robotter/robotter/docs/measurements/galipeur2k9/readme.txt

# Mesures de Galipeur 2k9 pour le simulateur

# Ligne droite
- goto_xya(500.0,0,0)
- xy_speed(2500,80)
- a_speed(70,10)
- 190 points, environ 2.5s de mesure

données brutes : line_xy.data
vitesse temps réel tracée : line_xy.gif
