robotter/robotter/docs/robotter2k9/garde.tex

\vfill

\hspace{-1.5em}\hrulefill
\begin{center}
	\Large{Rob'Otter 2k9}\\
	\vspace{1cm}
	\textbf{\huge{Galipeur}}\\
\end{center}
\hrulefill

\begin{center}
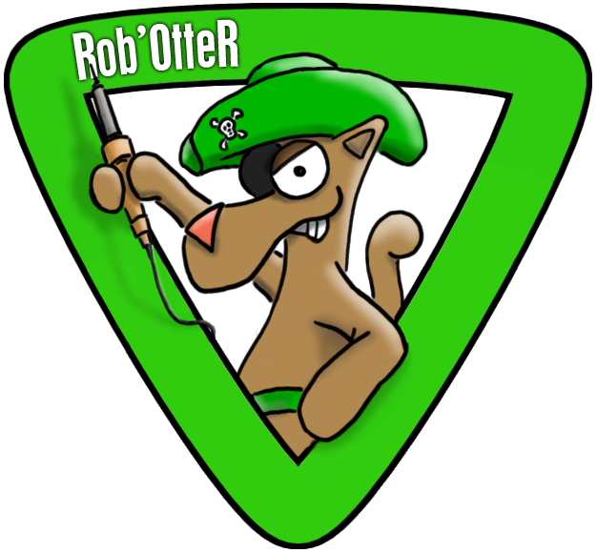
[picture p1: docs/robotter2k9/imgs/beta.png]

\end{center}

\vfill

\thispagestyle{empty}
