robotter/robotter/docs/dossier_projet/dp_2015/content.tex

\mychapter{Questionnaire}

\textbf{Nom équipe :} Rob'Otter \\

\textbf{1} : Autorisez-vous la diffusion de ce projet, avant la compétition, à des
partenaires du concours? \\
\begin{center} OUI \end{center}

\section{L'équipe}

\textbf{2} : Y'a-t-il eu des changements dans la constitution de l'équipe depuis votre
pré-inscription ? (départs, arrivées...)\\
\begin{center} NON \end{center}

\newpage
\section{Planning}

\subsection{Robot principal}

\begin{tabular}{|l|c|c|c|c|c|c|c|c|}

 \hline
 \multicolumn{9}{|c|}{Robot principal}\\
 \hline
 & 10\% & 25\% & 50\% & 75\% & 90\% &  100\% & Fin & Commentaires \\\hline
 \textbf{Méca} / Conception 			& & & & $\surd$ & & & Février & \\\hline
 \textbf{Méca} / Réalisation 		& & & $\surd$ & & & & Mars & \\\hline
 \textbf{Méca} / Test unitaires 	& & & $\surd$ & & & &Avril & \\\hline
 \textbf{Élec} / Conception 			& & & & & & $\surd$ & Février & \\\hline
 \textbf{Élec} / Réalisation 		& & & & &$\surd$ & & Mars & \\\hline
 \textbf{Élec} / Test unitaires 	& & & &$\surd$ & & & Mars & \\\hline
 \textbf{Info} / Conception 			& & & & & $\surd$ & & Mars & \\\hline
 \textbf{Info} / Réalisation 		& & & & & $\surd$& & Avril & \\\hline
 \textbf{Info} / Test unitaires 	& & & & $\surd$ & & & Mai & \\\hline
 Intégration 						& & $\surd$ & & & & & Avril & \\\hline
 Tests finaux						& $\surd$ & & & & & & Mai & \\\hline
 \hline
 \multicolumn{9}{|c|}{Robot secondaire}\\
 \hline
 & 10\% & 25\% & 50\% & 75\% & 90\% &  100\% & Fin & Commentaires \\\hline
 \textbf{Méca} / Conception 			& & & & $\surd$ & & & Février& \\\hline
 \textbf{Méca} / Réalisation 		& & & & $\surd$ & & & Mars& \\\hline
 \textbf{Méca} / Test unitaires 	& & & $\surd$ & & & & Avril & \\\hline
 \textbf{Élec} / Conception 			& & & & & & $\surd$ & Février & \\\hline
 \textbf{Élec} / Réalisation 		& & & & & & $\surd$ & Mars & \\\hline
 \textbf{Élec} / Test unitaires 	& & & & $\surd$ & & & Avril & \\\hline
 \textbf{Info} / Conception 			& & & & $\surd$& & & Mars & \\\hline
 \textbf{Info} / Réalisation 		& & & & & $\surd$ & & Mars & \\\hline
 \textbf{Info} / Test unitaires 	& & & & $\surd$ & & & Mai & \\\hline
 Intégration 						& & $\surd$ & & & & & Avril & \\\hline
 Tests finaux						& $\surd$ & & & & & & Mai & \\\hline

\end{tabular}

\vskip 1cm

\textbf{5} : Date à laquelle le robot se déplacera :\\
\begin{center}
Les deux robots se déplacent déjà de manière autonome.
Les 2 robots possèdent des propulsions holonomes, les asservissements des deux
robots ont été conservés par rapport à l'année dernière.

\end{center}

\textbf{6} : Date à laquelle votre robot sera homologable :\\
\begin{center} Le robot principal a déjà joué un match d'homologation avec
succès \end{center}

\textbf{7} : Matchs d'entraînements :\\
\begin{center} NON \end{center}

\textbf{8} : Suivi de l'équipe par un bénévole :\\
\begin{center} NON \end{center}

\section{Le budget}

\textbf{1} : Budget prévisionnel (hors déplacement)

\begin{center}
Robot principal :
\begin{tabular} {|l|r|}
\hline
mécanique & 200\euro \\\hline
électronique & 150\euro \\\hline
\hline
total & 350\euro \\\hline
\end{tabular}

Robot secondaire :
\begin{tabular} {|l|r|}
\hline
mécanique & 200\euro \\\hline
électronique & 150\euro \\\hline
\hline
total & 350\euro \\\hline
\end{tabular}
\end{center}

\vskip 1cm

\textbf{2} : Buget prévisionnel du voyage :\\
\begin{center} 1000\euro \end{center}

\textbf{3} : Partenaires :\\
\begin{itemize}
	\item Fly-n-Sense
  \item Eirbot
	\item L@Bx
\end{itemize}

\vskip 1cm

\textbf{4} : Matériel à disposition : \\
\begin{itemize}
  \item outillage mécanique basique (personnel + sponsors + partenariat
	Fly-n-Sense + partenariat équipe Eirbot);
  \item outillage électronique : moyen de réalisation PCB, oscilloscope,
  moyens soudage, etc (personnel + sponsors + partenariat Fly-n-Sense + partenariat équipe Eirbot);
  \item table de jeu (partenariat L@Bx et Eirbot).
\end{itemize}

\mychapter{Descriptif du projet}

\section{Description générale}

L'objectif est de réaliser 2 robots, un robot principal et un robot
secondaire.\\

\hspace{1cm}

L'objectif du robot principal est :
\begin{itemize}
	\item abaisser les claps;
	\item empiler les spots et les placer dans les cinémas;
	\item (optionnel) soulever le robot secondaire et le placer sur la zone bonus.
\end{itemize}

Le robot dispose d'un bras escamotable lui permettant d'abaisser facilement les
claps placés sur le bord de la table.

\begin{center}
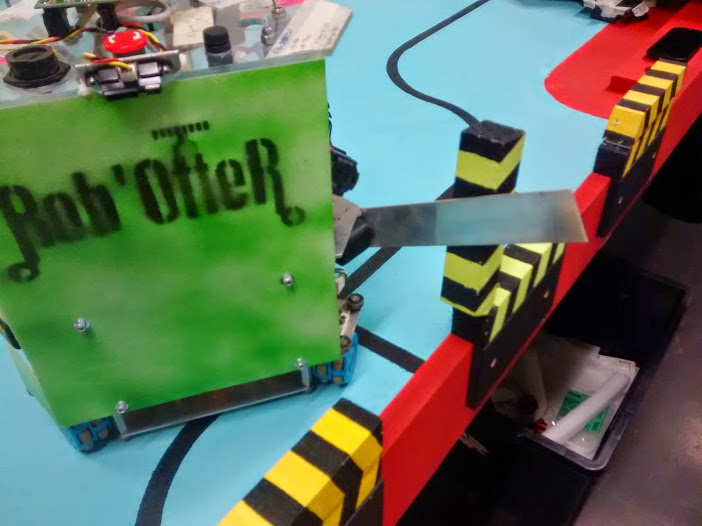
[picture p2: docs/dossier_projet/dp_2015/img/robot_clap.jpg]

\end{center}

Il dispose de pinces situés sur l'une des faces et capables de translater de
haut en bas afin d'empiler les spots.

\begin{center}
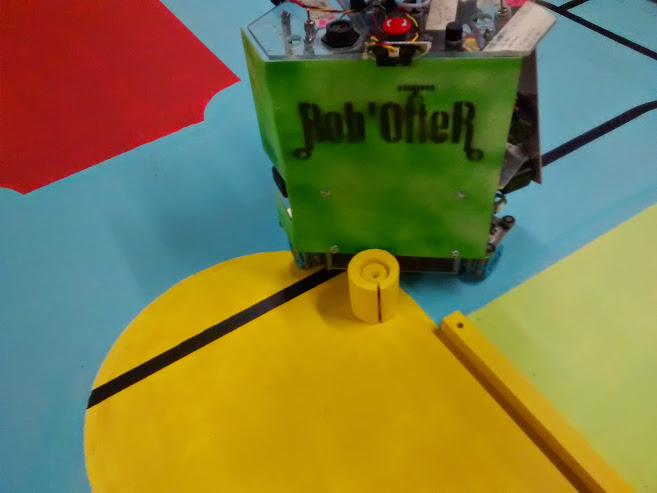
[picture p3: docs/dossier_projet/dp_2015/img/robot_spot.jpg]


(Le système de pinces n'est pas présent sur cette photo)
\end{center}

\begin{center}
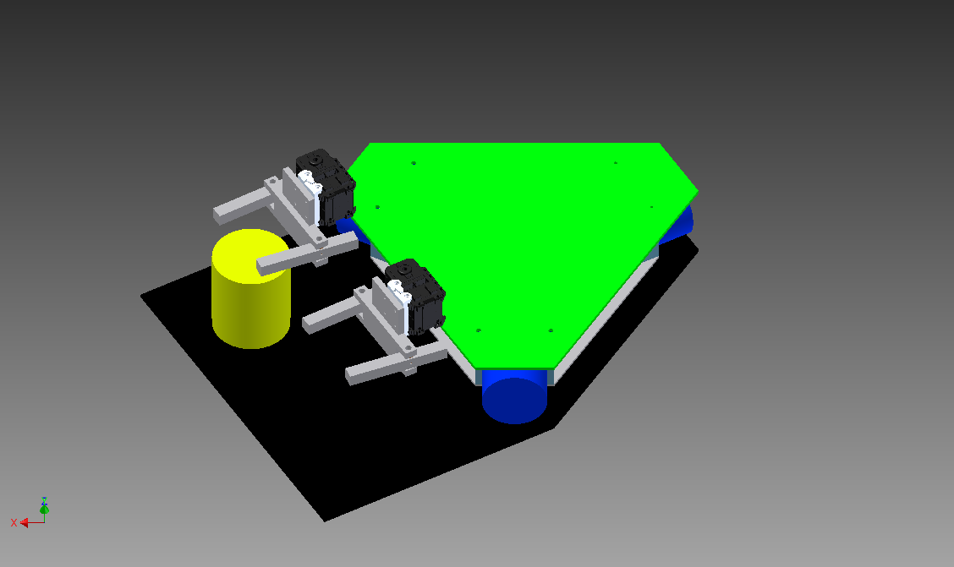
[picture p4: docs/dossier_projet/dp_2015/img/robot_2015_preview.png]


(CAO du système de pinces)
\end{center}

\hspace{1cm}

L'objectif du robot secondaire est :
\begin{itemize}
	\item placer les tapis rouges;
\end{itemize}	

Le robot sera principalement une base roulante portant le système de 
placement des tapis rouges.

\begin{center}
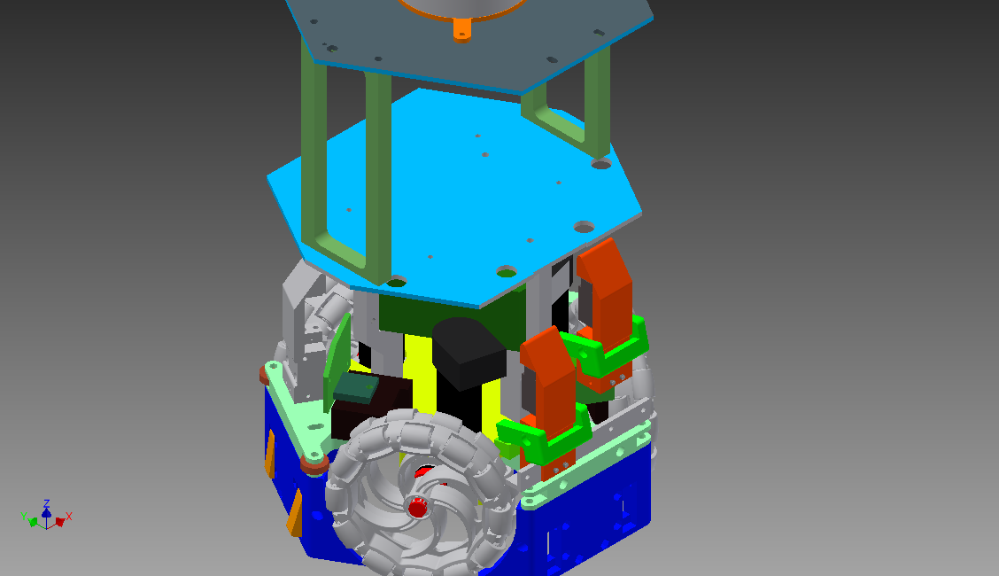
[picture p5: docs/dossier_projet/dp_2015/img/pmi_2015.png]


CAO du robot secondaire
\end{center}

\clearpage
\begin{itemize}
\item Hauteur du robot principal : \textbf{30cm}
\item Périmètre du robot principal en position de départ : \textbf{110cm}
\item Périmètre du robot principal déployé : \textbf{150cm}
\item Couleur du robot principal : structure aluminium (gris/blanc), roues en plastique
bleu clair, plaques de plexiglass transparent pour coque.
\end{itemize}
\vskip 1cm

\begin{itemize}
\item Hauteur du robot secondaire : \textbf{30cm}
\item Périmètre du robot secondaire en position de départ : \textbf{70cm}
\item Périmètre du robot secondaire déployé : \textbf{90cm}
\item Couleur du robot secondaire : structure aluminium (gris/blanc), roues en plastique
bleu clair.
\end{itemize}
\vskip 2cm

Le lien Youtube suivant présente la première homologation du robot lors d'une
phase de prototypage : \\
\url{http://youtu.be/oXdKylXpX2Y}

\section{Description technique}

\subsection{Motorisation}

Le robot principal sera propulsé de manière holonome par 3 motoréducteurs RE25/PLG32. Le
contact sera sol est effectué par 3 omniwheels FXA315 positionnées à 120°.\\

La motorisation fixe la vitesse maximale du robot à 1 m/s environ même si les
contraintes d'asservissement donnent une vitesse de 0.5 m/s plus probable.\\

Le robot principal sera propulsé par 2 motoréducteurs PD3237. Le contact au sol
sera effectué par 2 roues de conception interne à l'aide d'une bande roulement
souple.

\subsection{Positionnement}

Le positionnement est réalisé par les codeurs incrémentaux situés sur chaque
moteur du robot ainsi que d'un gyroscope placé sur l'axe Z (vertical) du robot.\\
Une chaîne de traitement constituée d'un microcontrôleur AVR Xmega 128A1 assure
le traitement des capteurs et le calcul de la position.

\subsection{Asservissement}

Les moteurs sont asservis en vitesse grâce aux codeurs incrémentaux présents sur
le motoréducteur. Le robot est asservi en position par le retour des capteurs
optiques mixé à la mesure du gyroscope.

Les asservissements sont réalisés par des filtres de type PIDf, implémentés dans
le microcontrôleur.

\subsection{Énergie}

Le robot principal est alimenté par une batteries Lithium Polymère 4 éléments 
alimentant sous 15V les moteurs, l'étage puissance du robot et l'étage logique du robot. 
Les 3 batteries assurent une autonomie de fonctionnement d'une bonne 1/2 heure
pour la puissance et presque 4 heures pour la logique (\emph{surdimensionné} est le mot que vous cherchez). \\

Le robot secondaire est alimenté par une batterie LiPo 3S de 1000mAh
l'alimentant sous 13V. La logique et la puissance sont toutes deux alimentées
par cette batterie. Aucune estimation n'a été réalisé de manière précise sur 
l'autonomie de ce robot.\\

Deux jeux complets de batteries sont disponibles pour chaque robot.\\

Un interrupteur arrêt d'urgence coupant le circuit de puissance du robot est
présent sur le haut de ce dernier.

\subsection{Éléments de jeu}

Le robot principal pourra stocker un spot dès le départ du match.

Le robot secondaire ne stockent pas d'éléments de jeux.\\

\subsection{Stratégie}

La stratégie en cours de match pour le robot principal consistera à empiler les
spots et abaisser les claps le plus rapidement possible tout en tenant compte de la
position de l'adversaire.

Le robot secondaire se dirigera vers les marches pour y placer les tapis.

La stratégie actuelle ne prévoit pas de jouer les pop-corns.

\subsection{Système d'évitement}

Chaque robot emporte une balise constituée d'un capteur SICK de type barrière
laser IR et d'un mirroir rotatif permettant de détecter le réflecteur placé sur
les robots adverses et ainsi connaître leur positions (calculés à partir de
l'angle "vu" du réflecteur).

\subsection{Capteurs}

Outre le positionnement, nous disposerons de télémètres IR SHARP GP2* et divers
capteurs de position.\\
Les servomoteurs AX12 utilisés sont "intelligents" et permettent de connaître
diverses informations telles que leurs positions, vitesses, couple instantannés,
etc.\\

\subsection{Arrêt d'urgence et limite de temps}

Un bouton d'arrêt d'urgence placé sur le dessus de la coque du robot permet de couper
l'alimentation puissance du robot, stoppant ses actionneurs.\\

Un système logiciel intégré à l'asservissement du robot le stoppe dès que la limite de jeu
de 90s est atteinte.\\

\subsection{Laser}

Les balises de détection emploient des lasers infrarouge autorisés par le
réglement.

\subsection{Intelligence}

L'intelligence du robot principal est réalisée par :
\begin{itemize}
\item une carte consituéee d'un AVR Xmega chargée de la stratégie et des
communications du robot.
\item une carte constituée d'un AVR Xmega chargée de l'asservissement en position du robot;
\item une carte constituée d'un AVR Xmega chargée du contrôle des servomoteurs AX-12 et autres capteurs du robot.
\end{itemize}

L'intelligence du robot secondaire est réalisée par :
\begin{itemize}
\item une carte consituéee d'un AVR Xmega chargée de la stratégie et des
communications du robot.
\item une carte constituée d'un AVR Xmega chargée de l'asservissement en
position du robot.
\end{itemize}
