robotter/robotter/docs/dossier_projet/dp_2015/garde.tex

\vfill

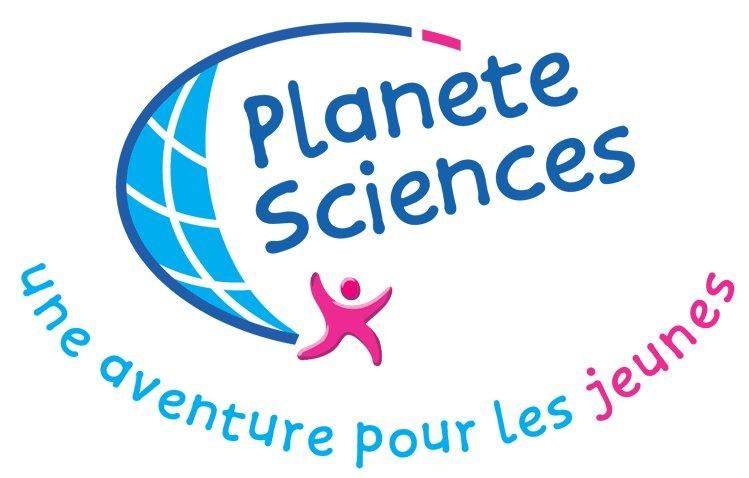
[picture p6: docs/dossier_projet/dp_2015/img/PS.jpg]
 \hfill
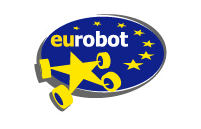
[picture p7: docs/dossier_projet/dp_2015/img/eurobot.png]
 \\

\vfill

\hspace{-1.2em}\hrulefill
\begin{center}
	\Large{Coupe de France de Robotique 2015}\\
	\vspace{1cm}
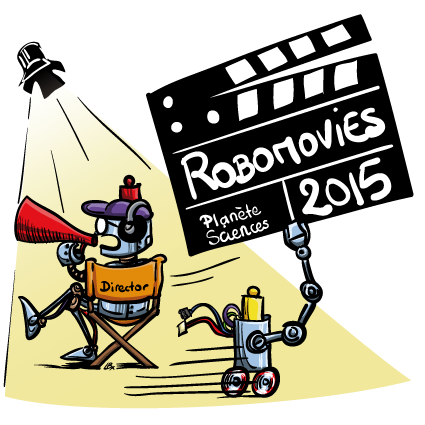
[picture p8: docs/dossier_projet/dp_2015/img/LogoEurobot.png]
	
\end{center}
\hrulefill

\hspace{1cm}
\begin{center}
\huge{Équipe Rob'Otter} \\
\vspace{.5cm}

\end{center}

\vfill

\thispagestyle{empty}
