robotter/robotter/docs/robotter2k9/robotter2k9.pdf

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

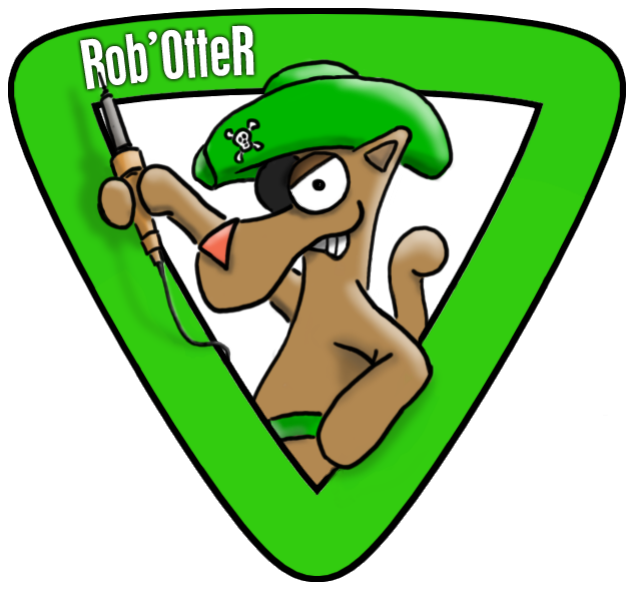
[picture p9: figure]

# Table des matières

1 Asservissement | 3
2 Identication du capteur ADNS | 15

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

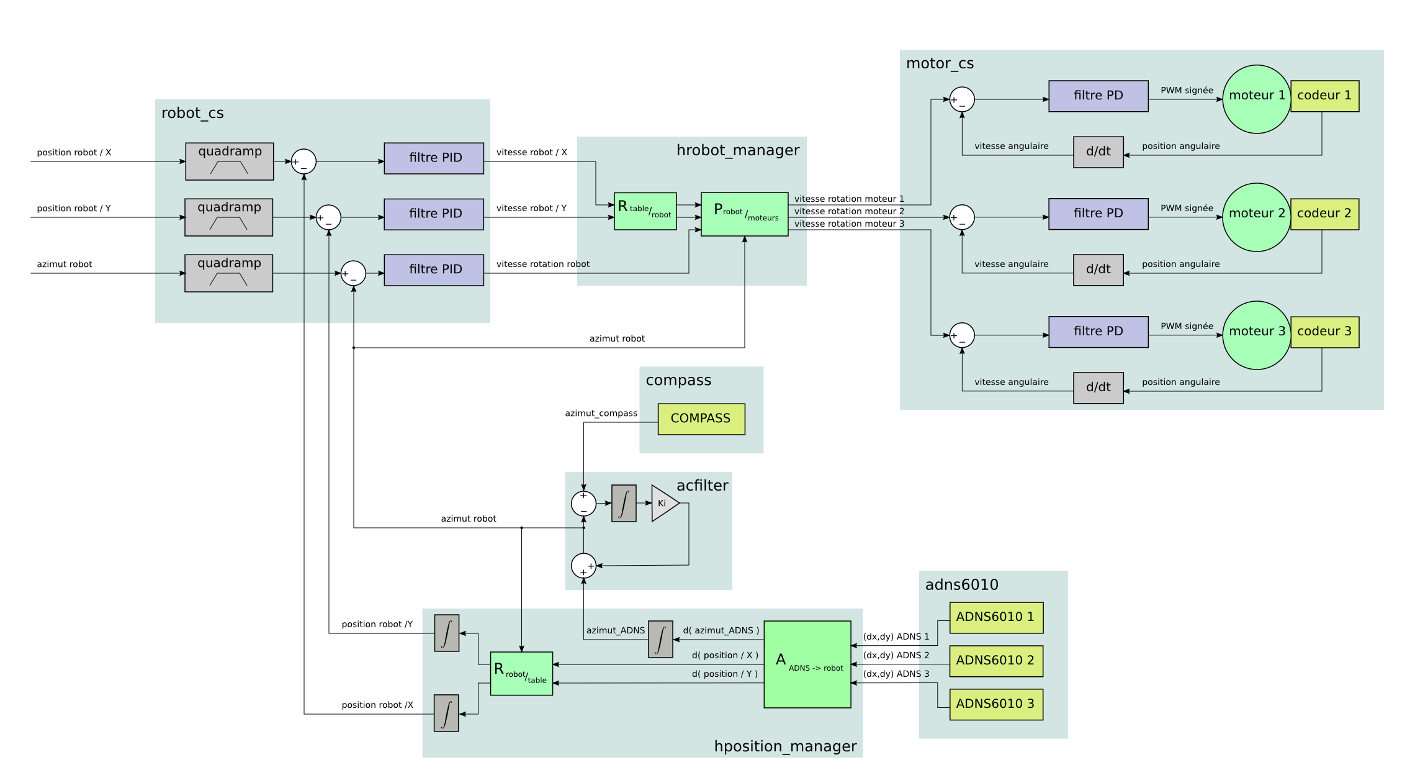
[picture p10: figure]

I Asservissement

1.1 Asservissement en vitesse des moteurs

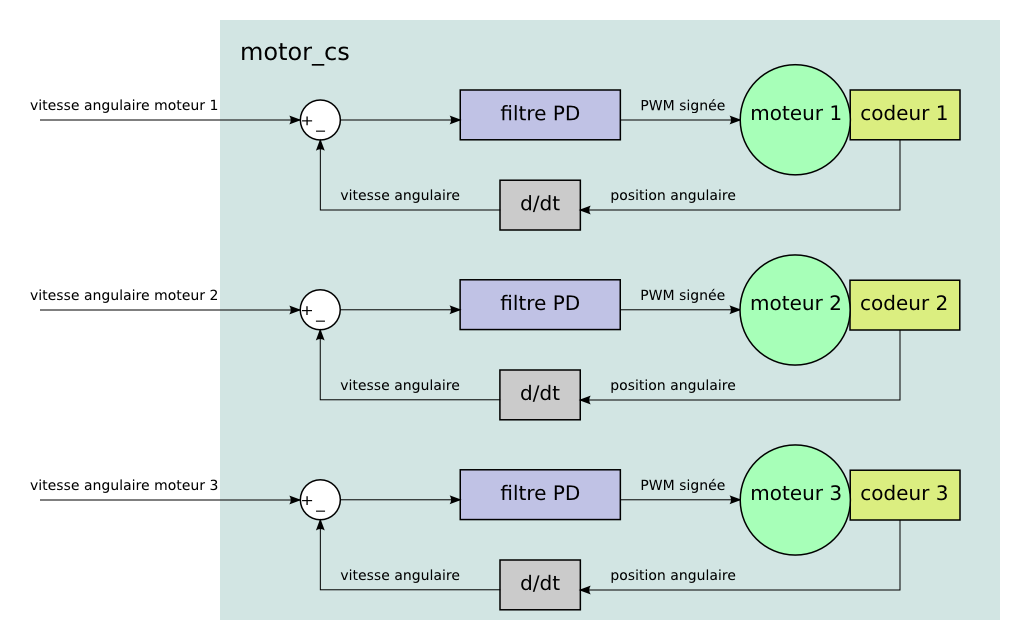
[picture p11: figure]

Chaque moteur est individuellement asservi en vitesse par un régulateur PD (Proportionnel,Dérivée) et un codeur incrémental HEDS5540 xé à l'axe moteur.

1.1.1 Consigne

La consigne est ici une vitesse moteur exprimée en pas codeur/tick asservissement.

1.1.2 Correction

La correction de l'asservissement est appliquée sous la forme d'une PWM + signe envoyée aux drivers moteurs, permettant de contrôler le moteur en tension.

1.1.3 Feedback

L'information de vitesse est récupérée depuis les codeurs incrémentaux HEDS5540, branchée sur le FPGA de l'UNIOC-NG, traités pour obtenir une position absolue de l'axe moteur puis transmis à l'ATmega128 de l'UNIOC-NG.

Un ltre dérivateur est appliquée sur la boucle de retour an d'obtenir la vitesse de rotation de l'axe moteur.

1.1.4 Code

L'asservissement en vitesse des moteurs est réalisé dans les chiers unioc_asserv/motor_cs.c, unioc_asserv/motor_cs.h et unioc_asserv/motor_cs_config.h.

Initialisation

unioc_asserv/cs.c ligne 80 :

// Initialize control systems for motors NOTICE(0,"Initializing motors control systems");
motor_cs_init();

La fonction motor_cs_init assure l'initialisation des control_system_managers, ltres PID et PWM moteurs.

Mise à jour

La mise à jour de l'asservissement est eectuée par la fonction motor_cs_update() appellée par la fonction hrobot_set_motors() du module hrobot_manager lors de l'envoi des consignes aux moteurs. unioc_asserv/hrobot_manager.c ligne 66 :

// set motors speeds
if(hrs->motors_accessor)
(hrs->motors_accessor)(hrs->motors_accessor_params, v0, v1, v2);

Le pointeur hrs->motors_accessor est assigné à motor_cs_update() dans unioc_asserv/cs.c ligne 73 :

hrobot_set_motors_accessor(&system, motor_cs_update, NULL);

1.2 | Propulsion vectorielle

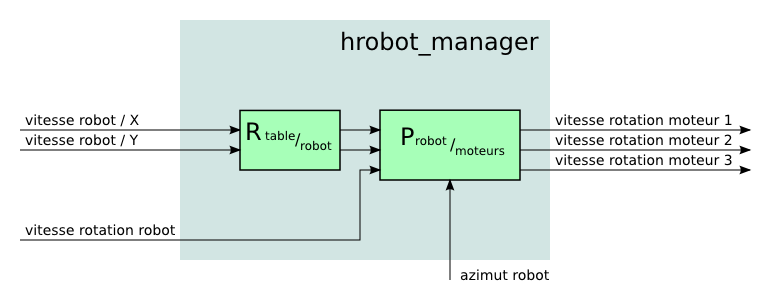
[picture p12: figure]

1.2.1 | Changement de repère

Théorie

La correction calculée par l'asservissement en position est exprimée dans le repère lié à la table de jeu Rtable. Avant de l'envoyer aux asservissements moteurs il faut eecteur un changement de repère de Rtable vers Rrobot.

On a :

vx
vy
ω

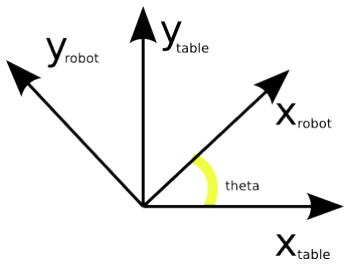
[picture p13: figure]

Rtable

=

cos(θ) − sin(θ) 0
sin(θ) | cos(θ) | 0
0 | 0 | 1

vx
vy
ω

Rrobot

(1.1)

vx
vy
ω

Rrobot

=

cos(θ) sin(θ) 0
− sin(θ) cos(θ) 0
0 | 0 | 1

vx
vy
ω

Rtable

(1.2)

Code

Le changement de repère est eectué dans la fonction robot_cs_update() :

vx_t | = cs_get_out(&csm_x);
vy_t | = cs_get_out(&csm_y);
omegaz_t = cs_get_out(&csm_angle);

hposition_get(rcs->hpm, &hvec);

alpha = -hvec.alpha;

vx_r = vx_t*cos(alpha) - vy_t*sin(alpha); vy_r = vx_t*sin(alpha) + vy_t*cos(alpha);

1.2.2 Théorie

La propulsion vectorielle permet de transformer une consigne en vitesse exprimée dans le repère lié au robot

Rrobot :

vx
vy
ω

Rrobot

(1.3)

En une consigne en vitesse sur chaque moteur :

vM1
vM2
vM3

Rmoteurs

(1.4)

Soit −−→uM1

, −−→uM2

, −−→uM3

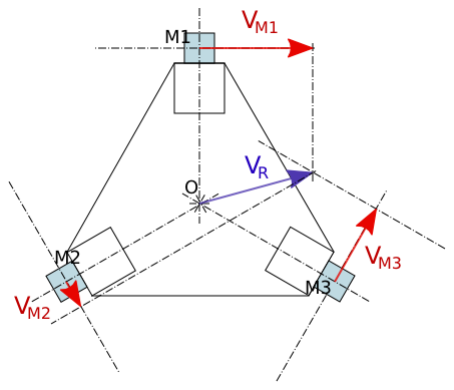
[picture p14: figure]

respectivement les vecteurs unitaires colinéaires au diamètre de chaque roue et appartenant au plan (~x, ~y), chaque vecteur positif dans le sens de poussée positive de chaque moteur. Soit R la distance entre le point d'appui d'une omniwheel et le centre du robot.

On pose −−−−−−−→ Vrobot/tableO
=

vx
vy
0

O

vecteur vitesse du robot en O dans le repère lié à la table.

On eectue le déplacement du torseur cinématique du robot en O aux points de contacts de chaque roue M1, M2 et M3.

Au point O le torseur cinématique du robot est :
n

νrobot/tableo
=

(

ω.−→z
−−−−−−−→ Vrobot/tableO

)

O

=

vx | 0
vy | 0
0 | ω
O

(1.5)

Déplacement du torseur en M1 :
n

νrobot/tableo
=

(

ω.−→z
−−−−−−−→ Vrobot/tableO

)

O

(1.6)

=

(

ω.−→z
−−−−−−−→ Vrobot/tableO
+

−−−→ OM1 ∧ ω.−→z

)

M1

(1.7)

=

(

ω.−→z
−−−−−−−→ Vrobot/tableO
+ R.ω.−−→uM1

)

M1

(1.8)

On obtient de même en M2 et M3 :
n

νrobot/tableo
=

(

ω.−→z
−−−−−−−→ Vrobot/tableO
+ R.ω.−−→uM2

)

M2

(1.9)

n

νrobot/tableo
=

(

ω.−→z
−−−−−−−→ Vrobot/tableO
+ R.ω.−−→uM3

)

M3

(1.10)

Chaque omniwheel n ne peut xer la vitesse que suivant l'axe −−→uMn , on obtient donc, en notant θMn

l'orientation
respective de chaque vecteur uMn :

vMn =

−−−−−−−→ Vrobot/tableMn
.−−→uMn
(1.11)

= (−−−−−−−→ Vrobot/tableO
+ R.ω.−−→uMn

).−−→uMn
(1.12)

=

vx
vy
0

cos θMn
sin θMn
0
+ R.ω | (1.13)
= vx. cos θMn + vy.sin θMn + R.ω | (1.14)

Ce qui donne le système d'équations suivant :

vM1 = vx. cos θM1 + vy.sin θM1 + R.ω | (1.15)
vM2 = vx. cos θM2 + vy.sin θM2 + R.ω | (1.16)
vM3 = vx. cos θM3 + vy.sin θM3 + R.ω | (1.17)

Soit, sous forme matricielle, la matrice P :

P =

cos θM1

sin θM1 R
cos θM2

sin θM2 R
cos θM3

sin θM3 R

| (1.18)
1.2.3 | Code

Initialisation

Le module hrobot_manager est initialisé dans le chier cs.c ligne 70 :

// Initialize robot manager
NOTICE(0,"Initializing robot manager"); hrobot_init(&system);
hrobot_set_motors_accessor(&system, motor_cs_update, NULL);

Mise à jour

Ces transformations sont implémentées dans la fonction hrobot_set_motors du module hrobot_manager aux lignes 62 à 70 :

// project speed vector on each motor
v0 = vx*HROBOT_MOTOR0_COS_COURSE + vy*HROBOT_MOTOR0_SIN_COURSE; v1 = vx*HROBOT_MOTOR1_COS_COURSE + vy*HROBOT_MOTOR1_SIN_COURSE; v2 = vx*HROBOT_MOTOR2_COS_COURSE + vy*HROBOT_MOTOR2_SIN_COURSE;

//
v0 += omega;
v1 += omega;
v2 += omega;

Notons que dans la version présentée du code aucun eort de mise en conformité des unités n'a été eectuée R étant ici unitaire.

1.3 Compass

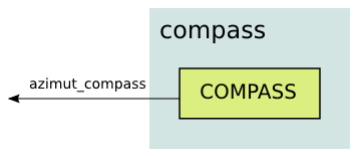
[picture p15: figure]

La boussole électronique a été ajoutée an de palier à la dérive du capteur ADNS en angle.

Un simple ltre a été ajouté an que l'angle renvoyé par le capteur, appartenant initialement à [0; 2π[, devienne continu.

1.4 | ACFilter
1.4.1 | Théorie

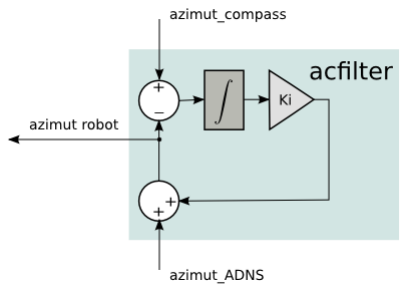
[picture p16: figure]

Ce ltre permet de gérer 2 capteurs diérents : boussole et capteur ADNS sur une seul et même grandeur : l'azimut du robot.

Or les mesures ont montrés que la mesure de cet azimut par intégration de la vitesse de rotation mesurée par le capteur ADNS montre un temps de réponse rapide mais une importante dérive.

À l'inverse, la boussole, ne présente aucune dérive mais un temps de réponse élevé et une résolution faible.

Le ltre est réglable par la valeur de Ki gain intégral du ltre où pour Ki = 0 seul le capteur ADNS est pris en compte et pour Ki → 1 l'inuence de la boussole est maximum.

Une valeur de gain de Ki = 0.02 est actuellement utilisé sur l'asservissement du robot.

1.4.2 Code

Le ltre est implémenté dans les chiers acfilter.c et acfilter.h.

Le ltre est initialisé à la ligne 66 du chier cs.c :

// Initializing ADNS/Compass filter NOTICE(0,"Initializing ADNS / Compass filter"); acfilter_init(&acfilter, 0.02);

1.5 | Positionnement

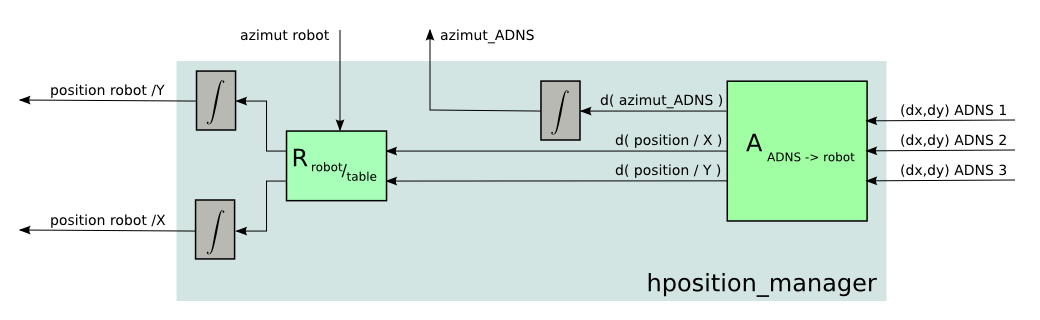
[picture p17: figure]

1.5.1 | Transformation vitesses ADNS vers vitesses robot

Théorie

La carte ADNS6010 donne les vitesses de déplacement de chaque capteur dans son repère.

Soit le vecteur

vx1

vy1

vx2

vy2

vx3

vy3

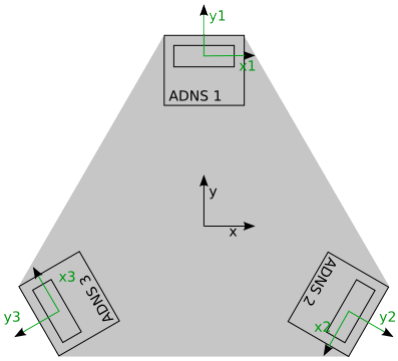
[picture p18: figure]

représentant les informations de vitesses renvoyées par le capteur ADNS.

Sachant que chaque repère ADNS est une transformation linéaire du repère du robot on peut dire, en notant

vx
vy
ω

Rrobot

la vitesse du robot, qu'il existe une matrice A telle que :

vx
vy
ω

Rrobot

= A

vx1

vy1

vx2

vy2

vx3

vy3

(1.19)

La matrice A est donc une matrice 3x6 obtenue par identication du capteur ADNS.

A =

a00 | a01 | a02 | a03 | a04 | a05
a10 | a11 | a12 | a13 | a14 | a15
a20 | a21 | a22 | a23 | a24 | a25
| (1.20)

Code

Initialisation

Le module hposition_manager est initialisé dans le chier main.c lignes 216 à 221 :

NOTICE(0,"Initializing position manager");
hposition_init( &position );
hposition_set( &position, 0.0, 0.0, 0.0 );

Mise à jour

La transformation, réduite à un produit matriciel, est implémenté dans la fonction hposition_update du module hposition_manager ligne 125.

//----------------------------------------------------------
// Transform speed in ADNS coordinates to robot coordinates

for(k=0;k<3;k++)
dp[k] = 0.0;

// for each ADNS coordinate (vx1,vy1,vx2,vy2,vx3,vy3) for(i=0;i<6;i++)
{
// compute speed in ADNS coordinates
v = hpos->pAdnsVectors[i] - adns6010.vectors[i]; // update previous ADNS vectors
hpos->pAdnsVectors[i] = adns6010.vectors[i];

// for each robot coordinate (x,y,a) compute a dx of mouvement for(k=0;k<3;k++)
dp[k] += hrobot_adnsMatrix[k][i]*v;
}

// convert d(movement) from (2^14mm) to (mm)
for(k=0;k<3;k++)
dp[k] = dp[k]/(double)(1<<HPOSITION_MANAGER_ADNSMATRIX_UNITPOW);

1.5.2 Intégration des vitesses ADNS

Théorie

L'élément

vx
vy
| ωADNS

Rrobot

est donc obtenu à partir du capteur ADNS.

L'idée générale est d'intégrer cet élement an d'obtenir le vecteur position du robot

x
y
θ

Rtable

dans le repère

lié à la table. La première étape est de calculer θ, or les tests ont montrés qu'eectuer une simple intégration de ωADNS pour obtenir θADNS ne donne pas une information able sur l'angle car soumise à une importante dérive. Pour palier à ce phénomène une boussole électronique et un ltre on été mis en place (voir sections dédiés).

Le vecteur

vx
vy

!

Rrobot

est alors transformé d'une rotation de −θ an de l'exprimer dans le repère Rtable lié à

la table.

Code

L'intégration de l'élément de position calculé est eectué à la suite dans la fonction hposition_update ligne 153.

_ca = cos(vec.alpha);

_sa = sin(vec.alpha);

[...]

vec.x = hpos->position.x + dp[HROBOT_DX]*_ca - dp[HROBOT_DY]*_sa; vec.y = hpos->position.y + dp[HROBOT_DX]*_sa + dp[HROBOT_DY]*_ca;

1.6 Asservisement en position

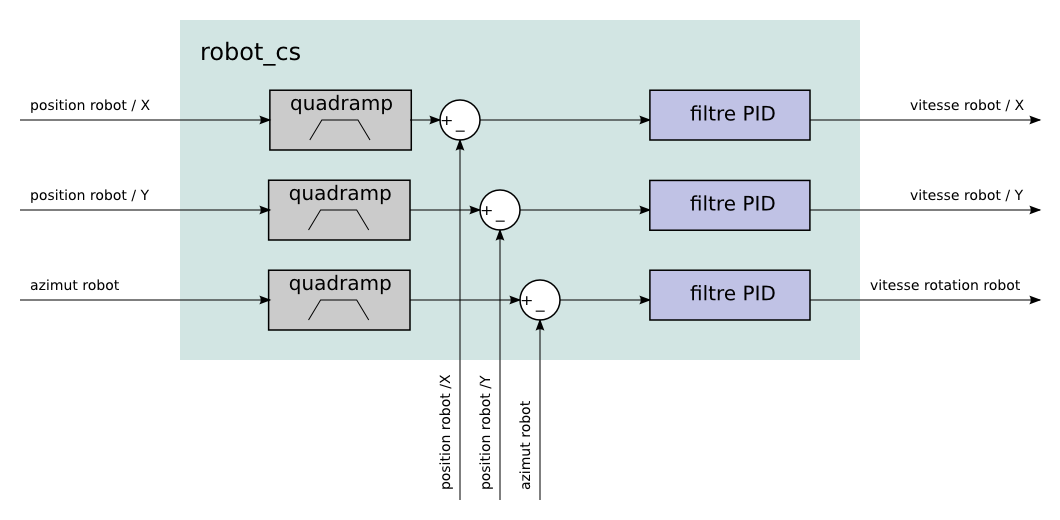
[picture p19: figure]

Le robot est asservi en position par un régulateur PID sur chaque dimension : translation suivant ~x, translation suivant ~y, rotation suivant ~z. La dernière étape consiste en une rotation du vecteur an de le passer du repère

Rtable au repère Rrobot.

1.6.1 Boucles d'asservissement

Consigne

La consigne est une position exprimée en mm et en radians.

Un ltre quadramp est appliqué à la consigne permettant de limiter ses dérivées premières et secondes, limitant ainsi l'accélération et la vitesse du robot.

Correction

La correction de l'asservissement est un vecteur vitesse passé en consigne à l'asservissement des moteurs.

Feedback

L'information de position est récupérée depuis le module hposition_manager, calculée depuis le retour de la carte ADNS6010.

Code

L'asservissement en position du robot est réalisé dans les chiers unioc_asserv/robot_cs.c et unioc_asserv/robot_cs.h.

Initialisation

unioc_asserv/cs.c ligne 85 :

// Initialize control systems for robot NOTICE(0,"Initializing robot control systems"); robot_cs_init(&robot_cs);
robot_cs_set_hrobot_manager(&robot_cs,&system); robot_cs_set_hposition_manager(&robot_cs,&position);

La fonction robot_cs_init assure l'initialisation des control_system_managers, ltres PID et quadramps.

Mise à jour

La mise à jour de l'asservissement est eectuée par la fonction robot_cs_update() appellée par cs_update(), fonction appellée sur interruption par le module scheduler :
unioc_asserv/main.c ligne 192 :

// Unleash control systems
event_cs =
scheduler_add_periodical_event_priority(&cs_update, NULL, 25,100);
1.7 | Fonctionnement nominal
1.7.1 | Initialisation

La fonction hposition_update assurant la mise à jour de la position du robot à partir des informations retournées par les ADNS est appellée sur interruption depuis la fonction cs_update().

1.7.2 Mise à jour de l'asservissement

La mise à jour de l'asservissement se déroule de la manière suivante :
mise à jour de la boussole par appel à compass_update().
mise à jour de la position par appel à hposition_update().
appel de robot_cs_update, mise à jour des asservissements en translation suivant ~x, translation suivant ~y et angle selon ~z ;
appel de hrobot_set_motors avec les valeurs calculées par les 3 asservissements en position, an de transformer une consigne en vitesse dans le repère du robot vers une consigne en vitesse sur chaque moteur ;
appel de motor_cs_update avec les consignes en vitesse de chaque moteur, mise à jour des asservissement en vitesses des 3 moteurs ;
mise à jour des PWMs avec les valeurs calculées par les asservissements en vitesse.

II | Identification du capteur ADNS
2.1 | Théorie

Le capteur de position constitué de 3 capteurs optiques ADNS6010 n'est pas parfaitement ajusté dans les axes de la base roulante et il est, par conséquent, dicile de calculer la matrice A vue précédement a partir des mesures du capteur.

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
(2.1)

La méthode est donc d'eectuer une série de mesure de couples (U, V ) où U =

vx
vy
ωz

et V =

vx1

vy1

vx2

vy2

vx3

vy3

Par exemple eectuer depuis le point

0
0
0

une translation de 400mm suivant l'axe ~x donne le couple (U0, V0)

suivant :

400
0
0

,

30110
−17327
−30676
−17198
972
35188

(2.2)

Il reste à eectuer un grand nombre de mesure sur des coordonnées variées et d'ensuite identier la matrice A au moyen d'un algorithme d'identication.

2.2 Code

L'identication est eectuée au moyen de la méthode ARMA sous SciLab grâce au script unioc_asserv/scilab/adns_calibration.sci.
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
