robotter/robotter/docs/dossier_projet/dp_2012/DossierTech2012Robotter.pdf

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


# I Questionnaire

Nom équipe : Rob'Otter

1 : Autorisez-vous la diusion de ce projet, avant la compétition, à des partenaires du concours ?

OUI

1.1 L'équipe

2 : Y'a-t-il eu des changements dans la constitution de l'équipe depuis votre pré-inscription ? (départs, arrivées...)

NON

1.2 Planning

I Questionnaire

1.2.1 Robot principal

Robot principal
| 10% | 25% | 50% | 75% | 90% | 100% | Fin | Commentaires
Méca / Conception | | | | | | √ | Décembre
Méca / Réalisation | | | | √ | | | Mars
Méca / Test unitaires | | | | √ | | | Avril
Élec / Conception Élec / Réalisation | | | | | √ | √ | Décembre
Élec / Test unitaires | | | | √ | | | Mars
Info / Conception | | | | √ | | | Avril
Info / Réalisation | | | | √ | | | Mars
Info / Test unitaires | | | √ | | | | Avril
Intégration | | √ | | | | | Mai
Tests naux | √ | | | | | | Avril
| | | | | | | Mai
Robot secondaire
Méca / Conception | 10% | 25% | 50% √ | 75% | 90% | 100% | Fin | Commentaires
Méca / Réalisation | | √ | | | | | Février
Méca / Test unitaires | √ | | | | | | Mars
Élec / Conception | | | | | | √ | Avril
Élec / Réalisation | | | | | √ | | Janvier
Élec / Test unitaires | | | | √ | | | Mars
Info / Conception | | | | √ | | | Avril
Info / Réalisation | | | | √ | | | Mars
Info / Test unitaires | | | √ | | | | Avril
Intégration | | √ | | | | | Mai
Tests naux | √ | | | | | | Avril
| | | | | | | Mai

5 : Date à laquelle le robot se déplacera :

En ce qui concerne le robot principal l'asservissement et le système de propulsion ont été conservés par rapport à l'année dernière. Une amélioration de ce dernier est prévue mais il est actuellement fonctionnel. L'asservissement et la propulsion du robot secondaire sera une version simpliée mais semblable au robot principal.

6 : Date à laquelle votre robot sera homologable :

Un prototype a déjà réalisé un match homologable.

7 : Matchs d'entraînements :

NON

8 : Suivi de l'équipe par un bénévole :

NON

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

II | Descriptif du projet
2.1 | Description générale

L'objectif est de réaliser 2 robots, un robot principal et un robot secondaire.

L'objectif du robot principal est de pousser les pièces et de porter les lingots jusqu'à la calle du navire.

Il pousse les pièces à l'aide d'une brosse montée sur l'une de ses faces. Cette brosse lui permet de pousser les pièces sans que ces dernières ne se coincent sous le robot.

Deux bras motorisés sont installés sur les deux dernieres faces du robot et permettent de prendre les lingots sur les totems.

L'objectif du robot secondaire est de suivre la ligne noire tracée au sol, activer de une à deux bouteilles et revenir devant la calle de sa couleur en protection.

Hauteur du robot principal : 30cm
Périmètre du robot principal en position de départ : 110cm
Périmètre du robot principal déployé : 130cm
Couleur du robot principal : structure aluminium (gris/blanc), roues en plastique bleu clair, plaques de plexiglass transparent pour coque.

Hauteur du robot secondaire : 30cm
Périmètre du robot secondaire en position de départ : 80cm
Périmètre du robot secondaire déployé : 100cm
Couleur du robot secondaire : structure aluminium (gris/blanc), roues en plastique bleu clair.

Design mécanique du robot principal : base roulante seule. Ce plan et le périmètre indiqués ne reétent pas les dimensions nales, les préhenseurs n'étant pas représentés.

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

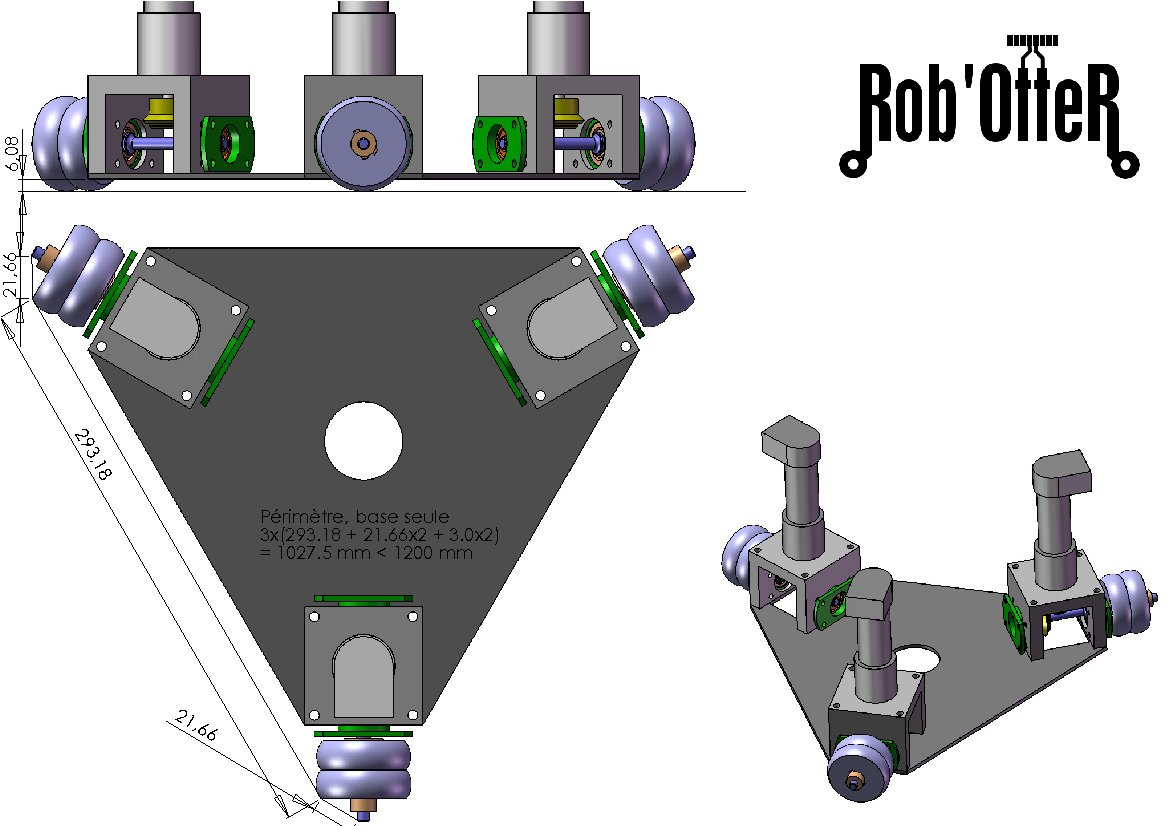
[picture p27: figure]

II Descriptif du projet

2.2 | Description technique
2.2.1 | Motorisation

Le robot sera propulsé de manière holonome par 3 motoréducteurs RE25/PLG32. Le contact au sol est eectué par 3 omniwheels FXA315 positionnées à 120°.

La motorisation xe la vitesse maximale du robot à 1 m/s environ même si les contraintes d'asservissement donnent une vitesse de 0.5 m/s plus probable.

2.2.2 Positionnement

Le positionnement est réalisé par les codeurs incrémentaux situés sur chaque moteur du robot.
Une chaîne de traitement constituée d'un FPGA Altera Cyclone 2 et d'un microcontrôleur AVR ATmega 128 assure le traitement des capteurs et le calcul de la position.

2.2.3 Asservissement

Les moteurs sont asservis en vitesse grâce aux codeurs incrémentaux présents sur le motoréducteur. Le robot est asservi en position par le retour des capteurs optiques.
Les asservissements sont réalisés par des ltres de type PIDf, implémentés dans le microcontrôleur.

2.2.4 Énergie

Deux batteries au plomb alimenteront sous 24V les moteurs et l'étage puissance du robot. Une batterie au plomb supplémentaire est dédiée à l'étage logique du robot.
Les 3 batteries assurent une autonomie de fonctionnement d'une bonne 1/2 heure pour la puissance et presque 4 heures pour la logique (surdimensionné est le mot que vous cherchez).

Deux jeux complets de batteries sont disponibles.

Un interrupteur arrêt d'urgence coupant le circuit de puissance du robot est présent sur le haut de ce dernier.

2.2.5 Éléments de jeu

Les deux bras du robot principal pourront stocker jusqu'à deux lingots simultanément. Aucune pièce ne sera stockée.

2.2.6 Stratégie

La stratégie en cours de match pour le robot principal consistera à ramasser en priorité les lingots du totem le plus proche tout en poussant les pièces éventuellement placées sur le chemin.

Le robot secondaire sera chargé de pousser les actionneur des bouteilles et garder l'entrée de la calle.

La stratégie actuelle ne prévoit pas de jouer la carte au trésor.

2.2.7 Système d'évitement

Le système d'évitement est constitué de deux balises, l'une placée sur le robot adverse constituée d'un réecteur et l'autre placée sur le robot en dessous de l'espace réservé à la balise adverse. Cette dernière est constituée d'un capteur SICK de type barrière laser et d'un miroir rotatif permettant de détecter le réecteur placé sur le robot

II Descriptif du projet

adverse et ainsi connaître la position du robot (l'angle est connu par la position du miroir de la balise, la distance par un calcul basé sur le temps durant lequel le réecteur est détecté).

2.2.8 Capteurs

Outre le positionnement, nous disposerons de télémètres IR SHARP GP2* et divers capteurs de position. Les servomoteurs AX12 utilisés sont "intelligents" et permettent de connaître diverses informations telles que leurs positions, vitesses, couple instantannés, etc.

De plus, une caméra nous permettra d'eectuer des détections de zones de couleurs.

2.2.9 Arrêt d'urgence et limite de temps

Un bouton d'arrêt d'urgence placé sur le dessus de la coque du robot permet de couper l'alimentation puissance du robot, stoppant ses actionneurs.

Un système logiciel intégré à l'asservissement du robot le stoppe dès que la limite de jeu de 90s est atteinte.

2.2.10 Laser

Le capteur SICK utilisé par la balise de détection dispose d'un laser visible de classe 1.

2.2.11 Intelligence

L'intelligence du robot est réalisée par :
Une carte "OS embarquée" constituée d'un ARM et tournant sous linux assurant la stratégie ;
un carte constituée d'un AVR ATmega 128 et d'un FPGA Altera Cyclone 2, assurant l'asservissement en position du robot ;
une carte constituée d'un microcontrôleur AVR ATmega assurant le contrôle des servomoteurs AX-12 et autres capteurs du robot.
En parallèle du développement embarqué sur le robot, un simulateur est développé par l'équipe.
http ://code.google.com/p/simulotter/

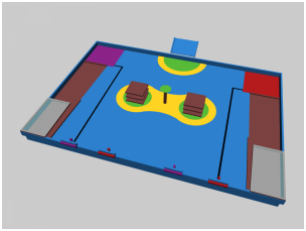
[picture p28: figure]

Ce dernier permet de tester des stratégies de manière simple (utilisation du langage Python pour l'intelligence).

II Descriptif du projet

Un des objectifs de l'équipe est d'utiliser la même architecture logicielle pour le simulateur et l'intelligence du robot permettant ainsi de passer de manière transparente un code de stratégie testé sur le simulateur vers le robot.

Les langages utilisés seront C, VHDL et quelques langages haut-niveau (Python).
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
