robotter/robotter/docs/robotter2k9/asserv.tex

\mychapter{Asservissement}

\begin{center}

\end{center}

%%-------------------------------------------------------------------------------
\clearpage
\section{Asservissement en vitesse des moteurs}

\begin{center}

\end{center}

Chaque moteur est individuellement asservi en vitesse par un régulateur PD
(Proportionnel,Dérivée) et un codeur incrémental HEDS5540 fixé à l'axe moteur.

\subsection{Consigne}
La consigne est ici une vitesse moteur exprimée en \emph{pas
codeur}/\emph{tick asservissement}.

\subsection{Correction}
La correction de l'asservissement est appliquée sous la forme d'une PWM + signe
envoyée aux drivers moteurs, permettant de contrôler le moteur en tension.

\subsection{Feedback}
L'information de vitesse est récupérée depuis les codeurs incrémentaux HEDS5540,
branchée sur le FPGA de l'UNIOC-NG, traités pour obtenir une position
absolue de l'axe moteur puis transmis à l'ATmega128 de l'UNIOC-NG.\\

Un filtre dérivateur est appliquée sur la boucle de retour afin d'obtenir la
vitesse de rotation de l'axe moteur.

\clearpage
\subsection{Code}

L'asservissement en vitesse des moteurs est réalisé  dans les fichiers
\verb$unioc_asserv/motor_cs.c$, \verb$unioc_asserv/motor_cs.h$ et 
\verb$unioc_asserv/motor_cs_config.h$.

\subsubsection{Initialisation}

\verb$unioc_asserv/cs.c$ ligne 80 :\\
\begin{verbatim}
  // Initialize control systems for motors
  NOTICE(0,"Initializing motors control systems");
  motor_cs_init();
\end{verbatim}

La fonction \verb$motor_cs_init$ assure l'initialisation des
\verb$control_system_managers$, filtres PID et PWM moteurs.

\subsubsection{Mise à jour}

La mise à jour de l'asservissement est effectuée par la fonction
\verb$motor_cs_update()$ appellée par la fonction \verb$hrobot_set_motors()$ 
du module \verb$hrobot_manager$ lors de l'envoi des consignes aux moteurs.

\verb$unioc_asserv/hrobot_manager.c$ ligne 66 :\\
\begin{verbatim}
  // set motors speeds
	if(hrs->motors_accessor)
		(hrs->motors_accessor)(hrs->motors_accessor_params, v0, v1, v2);
\end{verbatim}

Le pointeur \verb$hrs->motors_accessor$ est assigné à \verb$motor_cs_update()$ 
dans \verb$unioc_asserv/cs.c$ ligne 73 :\\

\begin{verbatim}
  hrobot_set_motors_accessor(&system, motor_cs_update, NULL);
\end{verbatim}

%%-------------------------------------------------------------------------------

\clearpage

\section{Propulsion vectorielle}

\begin{center}

\end{center}

\subsection{Changement de repère}

\subsubsection{Théorie}

La correction calculée par l'asservissement en position est exprimée dans le
repère lié à la table de jeu $R_{table}$.\\
Avant de l'envoyer aux asservissements moteurs il faut effecteur un changement
de repère de $R_{table}$ vers $R_{robot}$.\\

\begin{center}
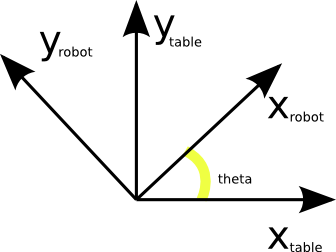
[picture p35: docs/robotter2k9/imgs/rep.png]

\end{center}

On a :

\begin{equation}
\left(\begin{array}{c}
v_x\\v_y\\\omega
\end{array}
\right)_{R_{table}}
=
\left(\begin{array}{ccc}
\cos(\theta)&-\sin(\theta)&0\\
\sin(\theta)&\cos(\theta)&0\\
0&0&1\\
\end{array}
\right)
\left(\begin{array}{c}
v_x\\v_y\\\omega
\end{array}
\right)_{R_{robot}}
\end{equation}

\begin{equation}
\left(\begin{array}{c}
v_x\\v_y\\\omega
\end{array}
\right)_{R_{robot}}
=
\left(\begin{array}{ccc}
\cos(\theta)&\sin(\theta)&0\\
-\sin(\theta)&\cos(\theta)&0\\
0&0&1\\
\end{array}
\right)
\left(\begin{array}{c}
v_x\\v_y\\\omega
\end{array}
\right)_{R_{table}}
\end{equation}

\subsubsection{Code}

Le changement de repère est effectué dans la fonction \verb$robot_cs_update()$
:\\
\begin{verbatim}
  vx_t     = cs_get_out(&csm_x);
  vy_t     = cs_get_out(&csm_y);
  omegaz_t = cs_get_out(&csm_angle);

  hposition_get(rcs->hpm, &hvec);

  alpha = -hvec.alpha;
 
  vx_r = vx_t*cos(alpha) - vy_t*sin(alpha);
  vy_r = vx_t*sin(alpha) + vy_t*cos(alpha);
\end{verbatim}

\subsection{Théorie}

La propulsion vectorielle permet de transformer une consigne en vitesse exprimée
dans le repère lié au robot $R_{robot}$ :
\begin{equation}
\left(\begin{array}{c} v_x\\v_y\\\omega\end{array}\right)_{R_{robot}}
\end{equation}

En une consigne en vitesse sur chaque moteur :
\begin{equation}
\left(\begin{array}{c}v_{M_1}\\v_{M_2}\\v_{M_3}\end{array}\right)_{R_{moteurs}}
\end{equation}

\begin{center}
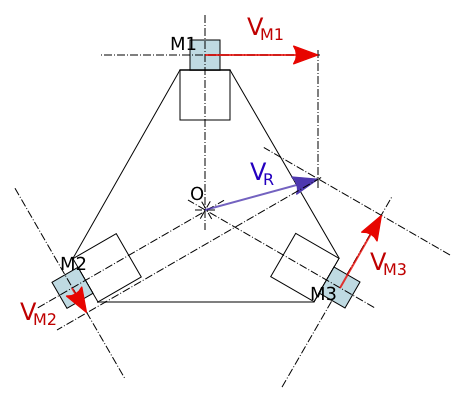
[picture p36: docs/robotter2k9/imgs/prop_vect.png]

\end{center}

Soit $\overrightarrow{u_{M_1}}$, $\overrightarrow{u_{M_2}}$,
$\overrightarrow{u_{M_3}}$ respectivement les vecteurs unitaires
colinéaires au diamètre de chaque roue et appartenant au plan
$(\vec{x},\vec{y})$, chaque vecteur positif dans le sens de poussée positive
de chaque moteur.\\
Soit $R$ la distance entre le point d'appui d'une omniwheel et le centre du
robot.\\
On  pose $\overrightarrow{V_{robot/table}}_O =
\left(\begin{array}{c}v_x\\v_y\\0\end{array}\right)_O$
vecteur vitesse du robot en $O$ dans le repère lié à la table.\\

\vskip 1cm

On effectue le déplacement du torseur cinématique du robot en $O$
aux points de contacts de chaque roue $M_1$, $M_2$ et $M_3$.\\

Au point $O$ le torseur cinématique du robot est :
\begin{equation}
\left\{ \nu_{robot/table} \right\}
%%
= \left\{ \begin{array}{c}
\omega.\overrightarrow{z} % w.z
\\
\overrightarrow{V_{robot/table}}_O
\end{array} \right\}_{O}
%%
= \left\{ \begin{array}{cc}
v_x & 0\\
v_y & 0\\
0 & \omega\\
\end{array} \right\}_{O}
%%
\end{equation}

Déplacement du torseur en $M_1$ :
\begin{eqnarray}
\left\{ \nu_{robot/table} \right\} &
%%
= & \left\{ \begin{array}{c}
\omega.\overrightarrow{z} % w.z
\\
\overrightarrow{V_{robot/table}}_O
\end{array} \right\}_{O} \\
%%
& = & \left\{ \begin{array}{c}
\omega.\overrightarrow{z} % w.z
\\
\overrightarrow{V_{robot/table}}_O + \overrightarrow{OM_1} \wedge
\omega.\overrightarrow{z}
\end{array} \right\}_{M_1}\\
%%
& = & \left\{ \begin{array}{c}
\omega.\overrightarrow{z} % w.z
\\
\overrightarrow{V_{robot/table}}_O + R.\omega.\overrightarrow{u_{M_1}}
\end{array}\right\}_{M_1}
\end{eqnarray}

On obtient de même en $M_2$ et $M_3$ :
\begin{equation}
\left\{ \nu_{robot/table} \right\} 
=
\left\{ \begin{array}{c}
\omega.\overrightarrow{z} % w.z
\\
\overrightarrow{V_{robot/table}}_O + R.\omega.\overrightarrow{u_{M_2}}
\end{array}\right\}_{M_2}
\end{equation}

\begin{equation}
\left\{ \nu_{robot/table} \right\} 
=
\left\{ \begin{array}{c}
\omega.\overrightarrow{z} % w.z
\\
\overrightarrow{V_{robot/table}}_O + R.\omega.\overrightarrow{u_{M_3}}
\end{array}\right\}_{M_3}
\end{equation}

Chaque omniwheel $n$ ne peut fixer la vitesse que suivant l'axe
$\overrightarrow{u_{M_n}}$, on obtient donc, en notant $\theta_{M_n}$ 
l'orientation respective de chaque vecteur $u_{Mn}$ :
\begin{eqnarray}
v_{M_n} & = & \overrightarrow{V_{robot/table}}_{M_n} .
\overrightarrow{u_{M_n}}\\
%%
        & = & ( \overrightarrow{V_{robot/table}}_O +
R.\omega.\overrightarrow{u_{M_n}} ).\overrightarrow{u_{M_n}}\\
%%
        & = & \left(\begin{array}{c}v_x\\v_y\\0\end{array}\right).
\left(\begin{array}{c}\cos \theta_{M_n}\\\sin \theta_{M_n}\\0\end{array}\right)
+ R.\omega\\
%%
        & = & v_x.\cos \theta_{M_n} + v_y.\sin \theta_{M_n} + R.\omega
\end{eqnarray}

Ce qui donne le système d'équations suivant :
\begin{eqnarray}
v_{M_1} = v_x.\cos \theta_{M_1} + v_y.\sin \theta_{M_1} + R.\omega\\
v_{M_2} = v_x.\cos \theta_{M_2} + v_y.\sin \theta_{M_2} + R.\omega\\
v_{M_3} = v_x.\cos \theta_{M_3} + v_y.\sin \theta_{M_3} + R.\omega
\end{eqnarray}

Soit, sous forme matricielle, la matrice $P$ :
\begin{equation}
P = \left(\begin{array}{ccc}
\cos \theta_{M_1}&\sin \theta_{M_1}&R\\
\cos \theta_{M_2}&\sin \theta_{M_2}&R\\
\cos \theta_{M_3}&\sin \theta_{M_3}&R
\end{array}\right)
\end{equation}

\subsection{Code}

\subsubsection{Initialisation}

Le module \verb$hrobot_manager$ est initialisé dans le fichier \verb$cs.c$
ligne 70 :
\begin{verbatim}
  // Initialize robot manager
  NOTICE(0,"Initializing robot manager");
  hrobot_init(&system);
  hrobot_set_motors_accessor(&system, motor_cs_update, NULL);
\end{verbatim}

\subsubsection{Mise à jour}

Ces transformations sont implémentées dans la fonction \verb$hrobot_set_motors$ 
du module \verb$hrobot_manager$ aux lignes 62 à 70 :
\begin{verbatim}
  // project speed vector on each motor
  v0 = vx*HROBOT_MOTOR0_COS_COURSE + vy*HROBOT_MOTOR0_SIN_COURSE;
  v1 = vx*HROBOT_MOTOR1_COS_COURSE + vy*HROBOT_MOTOR1_SIN_COURSE;
  v2 = vx*HROBOT_MOTOR2_COS_COURSE + vy*HROBOT_MOTOR2_SIN_COURSE;
  
  // 
  v0 += omega;
  v1 += omega;
  v2 += omega;
\end{verbatim}

Notons que dans la version présentée du code aucun effort de mise en conformité
des unités n'a été effectuée $R$ étant ici unitaire.

%%-------------------------------------------------------------------------------

\section{Compass}

\begin{center}

\end{center}

La boussole électronique a été ajoutée afin de palier à la dérive du capteur
ADNS en angle.\\

Un simple filtre a été ajouté afin que l'angle renvoyé par le capteur,
appartenant initialement à $[0;2\pi[$, devienne continu.

\section{ACFilter}

\begin{center}

\end{center}

\subsection{Théorie}

Ce filtre permet de gérer 2 capteurs différents : boussole et capteur ADNS
sur une seul et même grandeur :
l'azimut du robot.\\

Or les mesures ont montrés que la mesure de cet azimut par intégration de la
vitesse de rotation mesurée par le capteur ADNS montre un temps de réponse 
rapide mais une importante dérive.\\

À l'inverse, la boussole, ne présente aucune dérive mais un temps de réponse
élevé et une résolution faible.\\

Le filtre est réglable par la valeur de $K_i$ gain intégral du filtre où pour
$K_i=0$ seul le capteur ADNS est pris en compte et pour $K_i\rightarrow1$ l'influence
de la boussole est maximum.\\

Une valeur de gain de $K_i=0.02$ est actuellement utilisé sur l'asservissement
du robot.

\subsection{Code}

Le filtre est implémenté dans les fichiers \verb$acfilter.c$ et
\verb$acfilter.h$.\\

Le filtre est initialisé à la ligne 66 du fichier \verb$cs.c$ :
\begin{verbatim}
   // Initializing ADNS/Compass filter
  NOTICE(0,"Initializing ADNS / Compass filter");
  acfilter_init(&acfilter, 0.02);
\end{verbatim}

\section{Positionnement}

\begin{center}

\end{center}

\subsection{Transformation vitesses ADNS vers vitesses robot}

\subsubsection{Théorie}

La carte ADNS6010 donne les vitesses de déplacement de chaque capteur dans son
repère.

\begin{center}
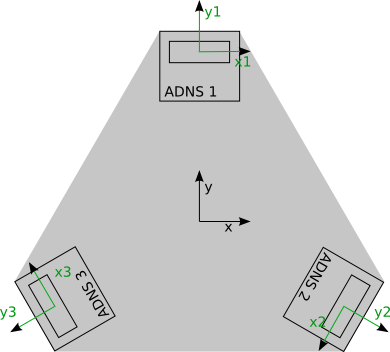
[picture p37: docs/robotter2k9/imgs/adns6010.png]

\end{center}

Soit le vecteur $\left(\begin{array}{c}
v_{x1}\\v_{y1}\\v_{x2}\\v_{y2}\\v_{x3}\\v_{y3}\end{array}\right)$
représentant les informations de vitesses renvoyées par le capteur ADNS.\\

Sachant que chaque repère ADNS est une transformation linéaire du repère du robot on
peut dire, en notant $\left(\begin{array}{c} 
v_x\\v_y\\\omega\end{array}\right)_{R_{robot}}$ la vitesse du robot, qu'il existe une matrice $A$
telle que :\\

\begin{equation}
\left(\begin{array}{c} 
v_x\\v_y\\\omega\end{array}\right)_{R_{robot}}
=A
\left(\begin{array}{c}
v_{x1}\\v_{y1}\\v_{x2}\\v_{y2}\\v_{x3}\\v_{y3}\end{array}\right)
\end{equation}

La matrice $A$ est donc une matrice 3x6 obtenue par identification du capteur
ADNS.
\begin{equation}
A = \left(\begin{array}{cccccc}
a_{00}& a_{01}& a_{02}& a_{03}& a_{04}& a_{05}\\
a_{10}& a_{11}& a_{12}& a_{13}& a_{14}& a_{15}\\
a_{20}& a_{21}& a_{22}& a_{23}& a_{24}& a_{25}\\
\end{array}
\right)
\end{equation}

\subsubsection{Code}

\paragraph{Initialisation}

Le module \verb$hposition_manager$ est initialisé dans le fichier \verb$main.c$
lignes 216 à 221 :
\begin{verbatim}
  NOTICE(0,"Initializing position manager");
  hposition_init( &position );
  hposition_set( &position, 0.0, 0.0, 0.0 );
\end{verbatim}

\paragraph{Mise à jour}

La transformation, réduite à un produit matriciel, est implémenté dans la 
fonction \verb$hposition_update$ du module \verb$hposition_manager$ ligne 125.

\begin{verbatim}
  //----------------------------------------------------------
  // Transform speed in ADNS coordinates to robot coordinates

  for(k=0;k<3;k++)
    dp[k] = 0.0;

  // for each ADNS coordinate (vx1,vy1,vx2,vy2,vx3,vy3) 
  for(i=0;i<6;i++)
  {
    // compute speed in ADNS coordinates
    v = hpos->pAdnsVectors[i] - adns6010.vectors[i];
    // update previous ADNS vectors
    hpos->pAdnsVectors[i] = adns6010.vectors[i];

    // for each robot coordinate (x,y,a) compute a dx of mouvement
    for(k=0;k<3;k++)
      dp[k] += hrobot_adnsMatrix[k][i]*v;
  }

  // convert d(movement) from (2^14mm) to (mm)
  for(k=0;k<3;k++)
    dp[k] = dp[k]/(double)(1<<HPOSITION_MANAGER_ADNSMATRIX_UNITPOW);
\end{verbatim}

\subsection{Intégration des vitesses ADNS}

\subsubsection{Théorie}

L'élément
$\left(\begin{array}{c}v_x\\v_y\\\omega_{ADNS}\end{array}\right)_{R_{robot}}$ est
donc obtenu à partir du capteur ADNS.\\

L'idée générale est d'intégrer cet élement afin d'obtenir le vecteur position
du robot $\left(\begin{array}{c}x\\y\\\theta\end{array}\right)_{R_{table}}$ dans
le repère lié à la table.
La première étape est de calculer $\theta$, or les tests ont montrés
qu'effectuer une simple intégration de $\omega_{ADNS}$ pour obtenir
$\theta_{ADNS}$ ne donne pas une
information fiable sur l'angle car soumise à une importante dérive.
Pour palier à ce phénomène une boussole électronique et un filtre on été mis en
place (voir sections dédiés).\\

Le vecteur $\left(\begin{array}{c}v_x\\v_y\end{array}\right)_{R_{robot}}$ est
alors transformé d'une rotation de $-\theta$ afin de l'exprimer dans le repère 
$R_{table}$ lié à la table.

\subsubsection{Code}

L'intégration de l'élément de position calculé est effectué à la suite dans la
fonction \verb$hposition_update$ ligne 153.

\begin{verbatim}
  _ca = cos(vec.alpha);
  _sa = sin(vec.alpha);
 
  [...]

  vec.x = hpos->position.x + dp[HROBOT_DX]*_ca - dp[HROBOT_DY]*_sa;
  vec.y = hpos->position.y + dp[HROBOT_DX]*_sa + dp[HROBOT_DY]*_ca;
\end{verbatim}

\section{Asservisement en position}

\begin{center}

\end{center}

Le robot est asservi en position par un régulateur PID sur chaque dimension : 
translation suivant $\vec{x}$, translation suivant $\vec{y}$, rotation suivant
$\vec{z}$.
La dernière étape consiste en une rotation du vecteur afin de le passer du
repère $R_{table}$ au repère $R_{robot}$.

\subsection{Boucles d'asservissement}

\subsubsection{Consigne}
La consigne est une position exprimée en mm et en radians.\\

Un filtre \emph{quadramp} est appliqué à la consigne permettant de limiter ses
dérivées premières et secondes, limitant ainsi l'accélération et la vitesse du
robot.

\subsubsection{Correction}
La correction de l'asservissement est un vecteur vitesse passé en consigne
à l'asservissement des moteurs.

\subsubsection{Feedback}
L'information de position est récupérée depuis le module
\verb$hposition_manager$, calculée depuis le retour de la carte ADNS6010.

\subsubsection{Code}

L'asservissement en position du robot est réalisé dans les fichiers
\verb$unioc_asserv/robot_cs.c$ et \verb$unioc_asserv/robot_cs.h$.

\subsubsection{Initialisation}

\verb$unioc_asserv/cs.c$ ligne 85 :\\
\begin{verbatim}
  // Initialize control systems for robot
  NOTICE(0,"Initializing robot control systems");
  robot_cs_init(&robot_cs);
  robot_cs_set_hrobot_manager(&robot_cs,&system);
  robot_cs_set_hposition_manager(&robot_cs,&position);
\end{verbatim}

La fonction \verb$robot_cs_init$ assure l'initialisation des
\verb$control_system_managers$, filtres PID et quadramps.

\subsubsection{Mise à jour}

La mise à jour de l'asservissement est effectuée par la fonction
\verb$robot_cs_update()$ appellée par \verb$cs_update()$, fonction appellée 
sur interruption par le module \verb$scheduler$ :

\verb$unioc_asserv/main.c$ ligne 192 :\\
\begin{verbatim}
  // Unleash control systems
  event_cs = 
    scheduler_add_periodical_event_priority(&cs_update, NULL, 25,100);
\end{verbatim}

\section{Fonctionnement nominal}

\subsection{Initialisation}

La fonction \verb$hposition_update$ assurant la mise à jour de la position du
robot à partir des informations retournées par les ADNS est appellée sur
interruption depuis la fonction \verb$cs_update()$.

\subsection{Mise à jour de l'asservissement}

La mise à jour de l'asservissement se déroule de la manière suivante :
\begin{itemize}

\item mise à jour de la boussole par appel à \verb$compass_update()$.
\item mise à jour de la position par appel à \verb$hposition_update()$.
\item appel de \verb$robot_cs_update$, mise à jour des asservissements en
translation suivant $\vec{x}$, translation suivant $\vec{y}$ et angle selon
$\vec{z}$;
\item appel de \verb$hrobot_set_motors$ avec les valeurs calculées par les 3
asservissements en position, afin de transformer une consigne en vitesse dans le
repère du robot vers une consigne en vitesse sur chaque moteur;
\item appel de \verb$motor_cs_update$  avec les consignes en vitesse de chaque
moteur, mise à jour des asservissement en vitesses des 3 moteurs;
\item mise à jour des PWMs avec les valeurs calculées par les asservissements en
vitesse.
\end{itemize}
