robotter/robotter/docs/robotter2k9/elec.tex

%%-----------------------------------------------------------------------------

\mychapter{Architecture électronique}

\begin{center}
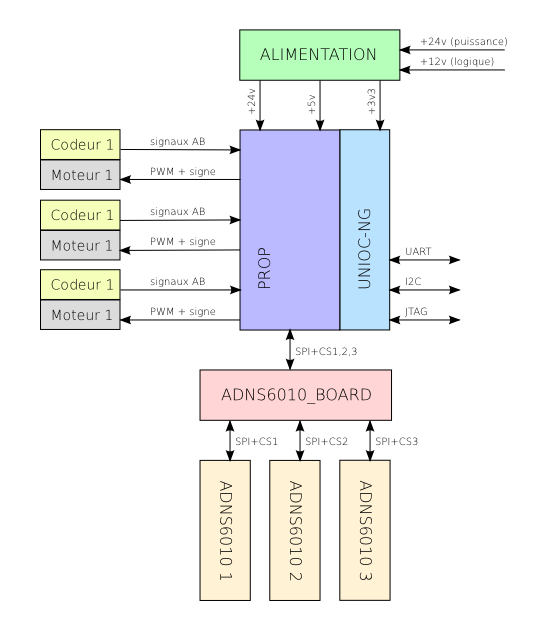
[picture p38: docs/robotter2k9/imgs/archielec.png]

\end{center}
