robotter/robotter/docs/dossier_projet/dp_2010/img/farnell.png

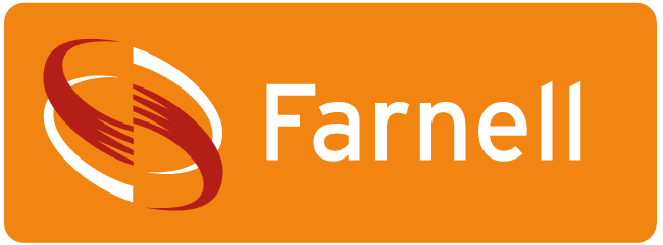
docs/dossier_projet/dp_2010/img/farnell.png
