robotter/robotter/docs/dossier_projet/dp_2011/img/altran.png

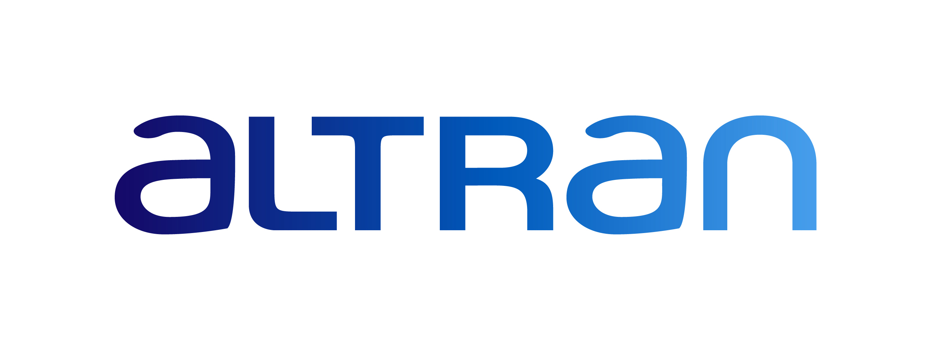
docs/dossier_projet/dp_2011/img/altran.png
