robotter/robotter/docs/dossier_projet/dp_2011/img/cdfr.png

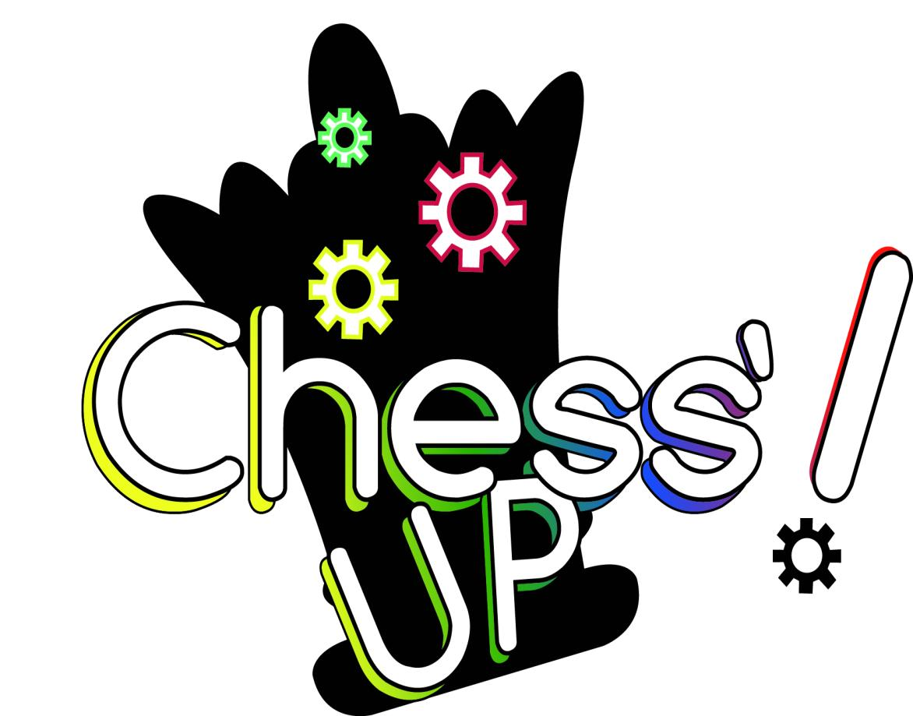
docs/dossier_projet/dp_2011/img/cdfr.png
