robotter/robotter/docs/dossier_projet/dp_2011/img/robot2.png

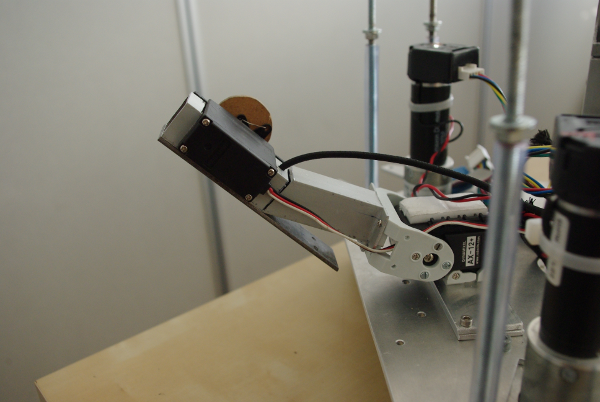
docs/dossier_projet/dp_2011/img/robot2.png
