robotter/robotter/docs/dossier_projet/dp_2011/img/robot3.png

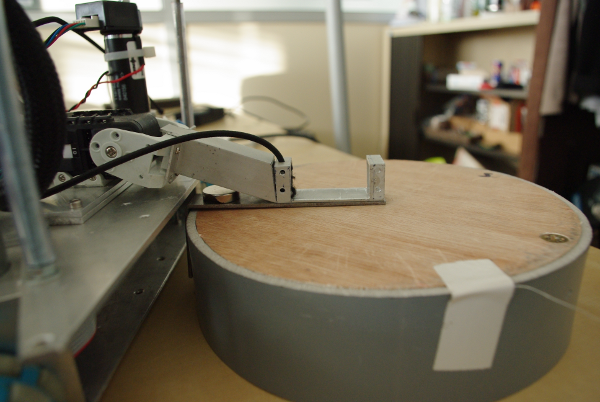
docs/dossier_projet/dp_2011/img/robot3.png
