robotter/robotter/docs/dossier_projet/dp_2011/img/robot4.png

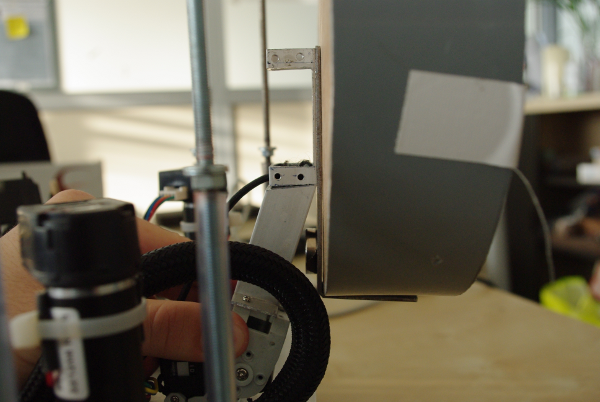
docs/dossier_projet/dp_2011/img/robot4.png
