robotter/robotter/docs/dossier_projet/dp_2011/img/rs.png

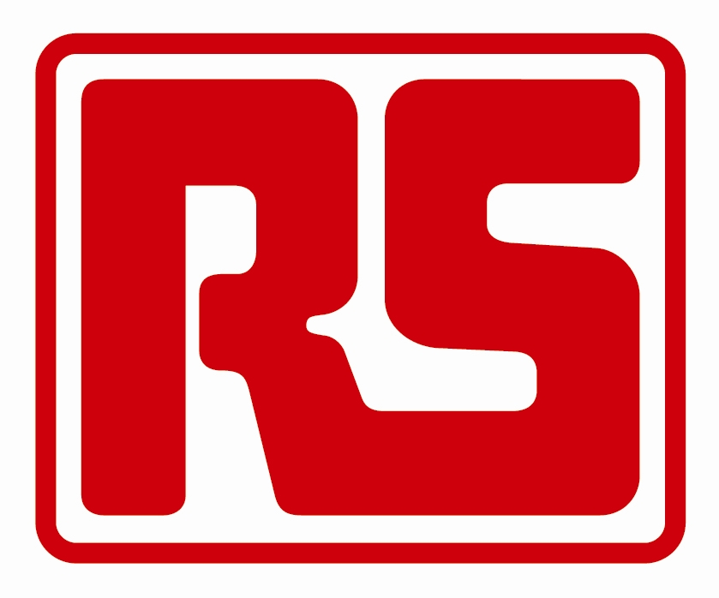
docs/dossier_projet/dp_2011/img/rs.png
