robotter/robotter/docs/dossier_projet/dp_2014/img/pmi.jpg

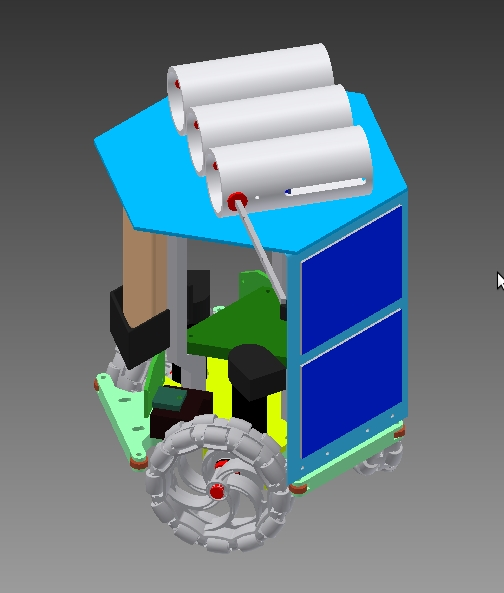
docs/dossier_projet/dp_2014/img/pmi.jpg
