robotter/robotter/docs/dossier_projet/dp_2014/img/pmi_support_fresques.jpg

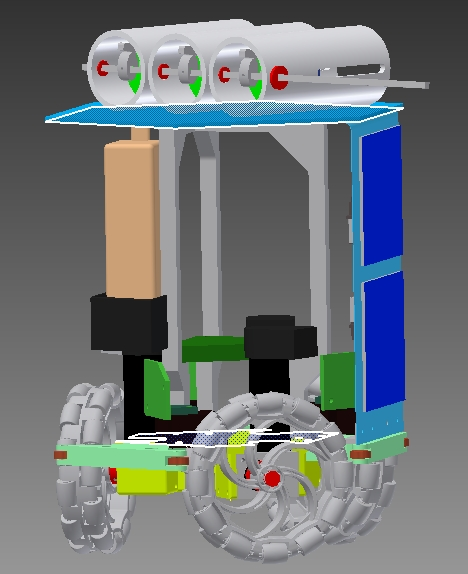
docs/dossier_projet/dp_2014/img/pmi_support_fresques.jpg
