robotter/robotter/docs/dossier_projet/dp_2014/img/prehistobot_table.jpg

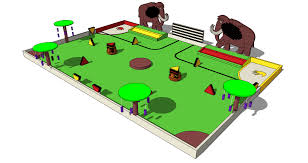
docs/dossier_projet/dp_2014/img/prehistobot_table.jpg
