robotter/robotter/docs/dossier_projet/dp_2015/img/eolite.png

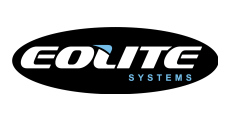
docs/dossier_projet/dp_2015/img/eolite.png
