robotter/robotter/docs/robotter2k9/imgs/adns.png

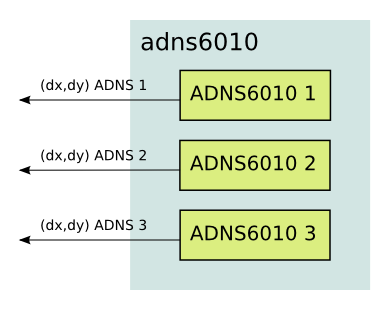
docs/robotter2k9/imgs/adns.png
