robotter/robotter/hardware/apf_girl_balise/cam_embarque.jpeg

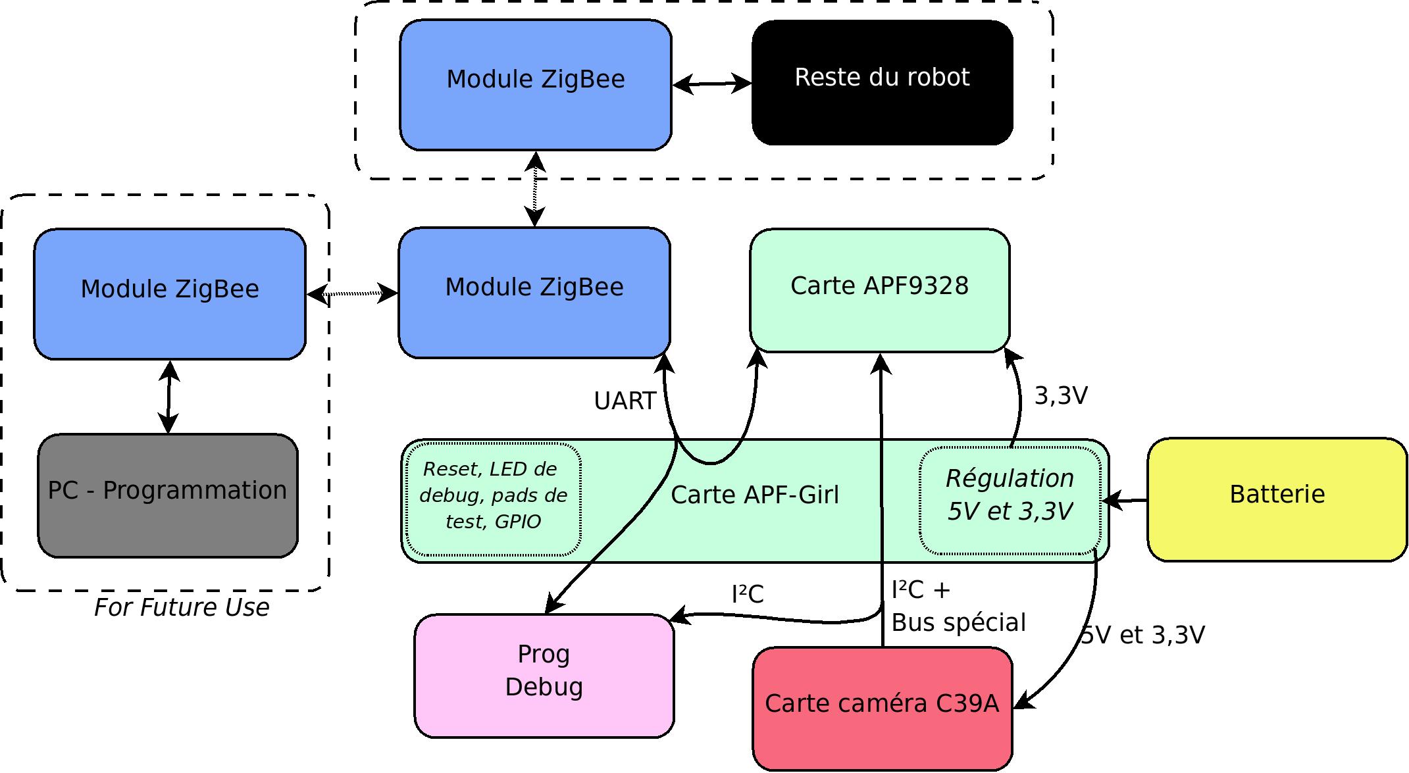
hardware/apf_girl_balise/cam_embarque.jpeg
