robotter/robotter/hardware/sabotter/SABOtter_schema_fonctionnel.png

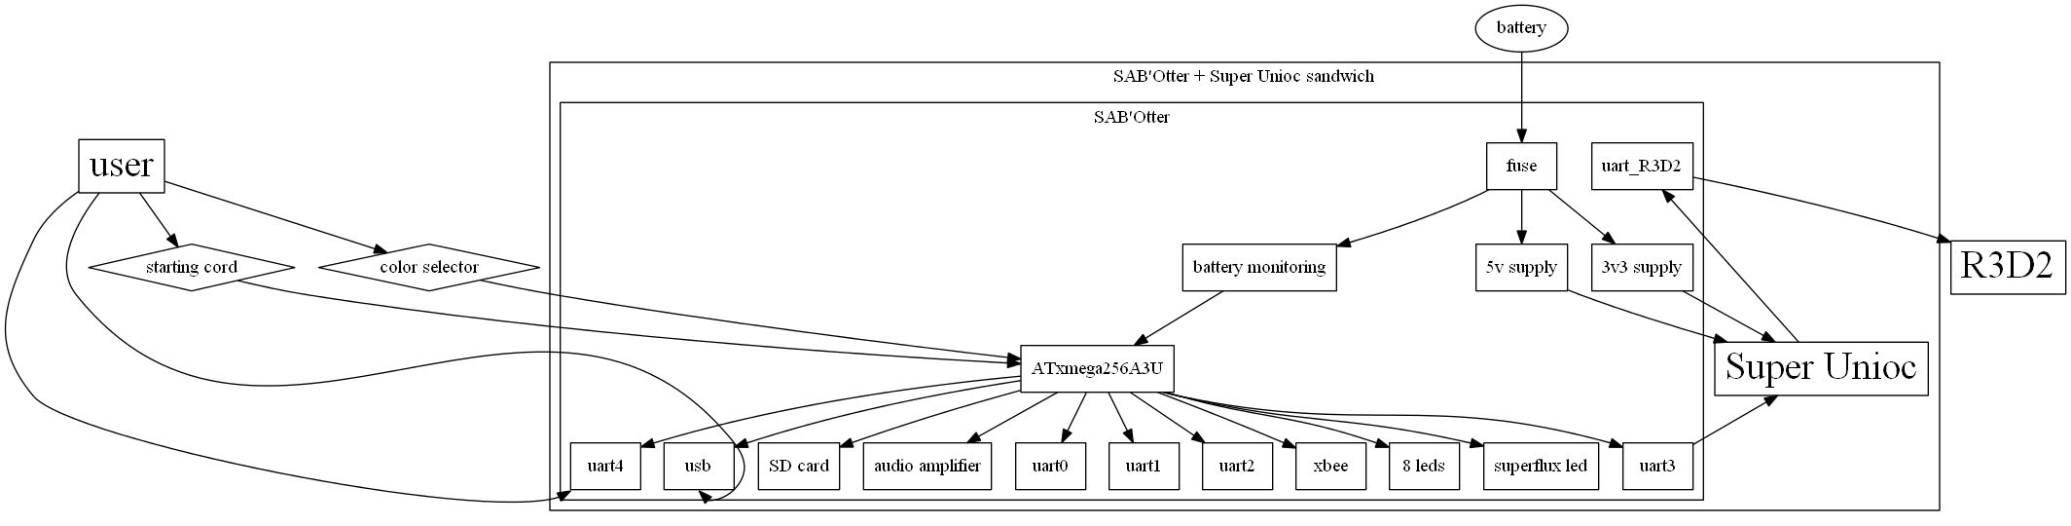
hardware/sabotter/SABOtter_schema_fonctionnel.png
