robotter/robotter/hardware/alim/alim_2009_bom.ods

 |  | ter/eurobot/hardwar | e/alim/alim_2009.sch at 14/02/2010 23:16:23
Qty | Value | Device | Parts | Reference RS | udv | prix/udv | qté en UDV | sous total RS | Reference Farnell | udv | prix/udv | qté en udv | sous total Farnell | fournisseur le moins cher | sous total mini
1 |  | 520250-3 | I2C
1 | 1N5822 | DIODE-DO201-15 | D4 | 687-0877 | 25 | 3,05 | 1 | 3,05 | 9801243 | 5 | 1,3 | 1 | 1,3 | farnell | 1,3
1 | 1k | R-EU_M0805 | R4 |  |  |  | 0 | 0 | 9333711 | 50 | 0,9 | 1 | 0,9 | farnell | 0,9 |  | vérifier dispo au club
3 | 1k4 | R-EU_R0805 | R5, R11, R17 |  |  |  | 0 | 0 | 1170801 | 50 | 1,05 | 1 | 1,05 | farnell | 1,05
2 | 1k8 | R-EU_0204/7 | R7, R13 |  |  |  | 0 | 0 | 1170812 | 50 | 0,5 | 1 | 0,5 | farnell | 0,5
5 | 2k | R-EU_R0805 | R8, R9, R14, R15, R18 |  |  |  | 0 | 0 | 9330763 | 50 | 1,6 | 1 | 1,6 | farnell | 1,6 |  | vérifier dispo au club
1 | RGEF600 | R-EU_0207/7 | POLYSWITCH | 517-6944 | 5 | 2,2 | 1 | 2,2 | 1345950 | 5 | 3,35 | 1 | 3,35 | radiospares | 2,2
1 | 10k | R-EU_R0805 | R16 |  |  |  | 0 | 0 | 1171016 | 50 | 0,5 | 1 | 0,5 | farnell | 0,5 |  | vérifier dispo au club
1 | 22µH EPCOS B82477P4223M000 | WE-PD_L/XL/XXL | L1 | 496-1943 | 1 | 4,21 | 1 | 4,21 | 1644649 | 1 | 1,82 | 1 | 1,82 | farnell | 1,82
1 | 22-05-7088-08 | 22-05-7088-08 molex mini kk 8 voies coudé | J5 | 173-2988 | 5 | 7,22 | 1 | 7,45 | 9731652 | 5 | 7,45 | 1 | 7,45 | farnell | 7,45 |  | vérifier dispo au club
3 | 30k | R-EU_R0805 | R3, R10,R19 |  |  |  | 0 | 0 | 771510 | 50 | 0,15 | 1 | 0,15 | farnell | 0,15
1 | 33µH EPCOS B82477P4333M000 | WE-PD_L/XL/XXL | L2 | 496-1959 | 1 | 4,24 | 1 | 4,24 | 1644652 | 1 | 1,82 | 1 | 1,82 | farnell | 1,82 | delai appro fn incertain
1 | 100nF | C-EUC0805 | C1 |  | 1 |  | 1 | 0 |  |  |  | 0 | 0 | farnell | 0
1 | 220k | R-EU_R0805 | R6 |  |  |  | 0 | 0 | 1469783 | 50 | 1,5 | 1 | 1,5 | farnell | 1,5
1 | 270 | R-EU_M0805 | R1 |  | 1 |  | 1 | 0 |  |  |  | 0 | 0 | farnell | 0
1 | 470 | R-EU_M0805 | R2 |  | 1 |  | 1 | 0 |  |  |  | 0 | 0 | farnell | 0
1 | 470k | R-EU_R0805 | R12 |  |  |  | 0 | 0 | 1099821 | 50 | 1,75 | 1 | 1,75 | farnell | 1,75
2 | 560µF | CPOL-EUE5-10.5 | C5, C11 |  |  |  | 0 | 0 |  |  |  | 0 | 0 | farnell | 0 |  | vérifier dispo au club
2 | 680uF | CPOL-EUE5-10.5 | C4, C10 | 571-111 | 5 | 3,63 | 1 | 3,63 | 9692304 | 5 | 5,05 | 1 | 5,05 | radiospares | 3,63 |  | vérifier dispo au club
3 | 1445055-2 | 1445055-2 | BLOG, BPROP0, BPROP1 |  | 1 |  | 3 | 0 |  |  |  | 0 | 0 | farnell | 0
1 | 1445055-3 | 1445055-3 | PROP |  | 1 |  | 1 | 0 |  |  |  | 0 | 0 | farnell | 0
2 | ICL7665CSA | ICL7665CSA | IC1, IC2 | 540-4514 | 1 | 5,08 | 2 | 10,16 | 9663738 | 1 | 3,49 | 2 |  | farnell | 0 | dispo en sample
1 | LM2596-TV-3.3 | LM2596TV | LM2596-TV-3.3 | 533-3737 | 1 | 4,49 | 1 | 4,49 | 1215205 | 1 | 6,57 | 1 | 6,57 | radiospares | 4,49
1 | LM2596-TV-5 | LM2596TV | LM2596-TV-5 | 533-3743 | 1 | 4,38 | 1 | 4,38 | 1206529 | 1 | 4,91 | 1 | 4,91 | radiospares | 4,38
1 | MAX11607 | MAX11606EUA+ | IC3 |  |  |  | 0 |  |  |  |  | 0 |  | farnell | 0 | dispo en sample
1 | MBR1060 | DIODE-TO220H | D3 | 545-2844 | 5 | 3,1 | 1 | 3,1 | 1625119 | 5 | 3 | 1 | 3 | farnell | 3
4 | MOUNT-PAD-ROUND3.6 | MOUNT-PAD-ROUND3.6 | H5, H6, H7, H8 |  |  |  | 0 |  |  |  |  | 0 |  | farnell | 0
2 | MUR420 | DIODE-DO201-15 | D1, D2 | 654-7151 | 5 | 1,2 | 1 | 1,2 | 1625175 | 5 | 2,4 | 1 | 2,4 | radiospares | 1,2
4 | Tantale 10uF | C-EU050-035X075 | C3, C6, C8, C9 |  |  |  | 0 | 0 | 9708448 | 5 | 2,7 | 1 | 2,7 | farnell | 2,7
2 | jaune | LEDCHIPLED_1206 | LOG_MED, P_MED |  |  |  | 0 | 0 | 8554781 | 5 | 0,46 | 1 | 0,46 | farnell | 0,46 |  | vérifier dispo au club
3 | rouge | LEDCHIPLED_1206 | KO, LOG_LOW, P_LOW |  |  |  | 0 | 0 | 8554641 | 5 | 0,47 | 1 | 0,47 | farnell | 0,47 |  | vérifier dispo au club
4 | vert | LEDCHIPLED_1206 | 3V3, 5V, LOG_HI, P_HI |  |  |  | 0 | 0 | 8554609 | 5 | 0,47 | 1 | 0,47 | farnell | 0,47 |  | vérifier dispo au club
 |  |  |  |  |  |  |  |  |  |  |  |  |  | total | 43,34
