robotter/robotter/hardware/commandes/RS_Dec2015.ods

Part | Value | Device | Package | Description | AEAT-601X | FARNELL | MANUFACTURER | MOUSER | RS | VALUE | Nombre | total
MOT | 1445055-2 | 1445055-2 | 1445055-2 | Micro MATE-N-LOK Connectors grid 1.5 mm |  |  |  | 571-2-1445055-2 | 495-9580 | 1445055-2 | 2 | 6
IC1 | LM18200T | LM18200T | TO-220-11 | 3A, 55V H-Bridge Motor Control |  | 1468979 |  | 926-LMD18200T/NOPB | 534-4276 |  | 1 | 3
R1 | 8K2-E | 8K2-E | R0805 |  |  |  |  | 71-CRCW08058K20FKEB | 679-1727 |  | 3 | 9
PW | LED_G | LED_G | CHIP-LED0805 |  |  |  |  | 859-LTST-C171GKT | 692-0935 | GREEN | 1 | 3
C3 | 100NF-F | 100NF-F | C0603 |  |  |  |  | 81-GRM188F51H104ZA01 | 723-5534 | 100nF 50V | 7 | 21
AEAT |  | AEAT-601X | 53047-05 |  |  |  |  |  | 447-6596 |  | 1 | 3
R7 | 8K2-F | 8K2-F | R0603 |  |  |  |  | 71-CRCW0603-8.2K-E3 | 679-0759 |  | 1 | 3
ENCODER | HEDS554X | HEDS554X | 22-05-1052 |  |  | 9732594 |  | 538-22-05-1052 | 687-7275 | 22-05-1052 | 1 | 3
THRM | LED_Y | LED_Y | CHIP-LED0805 |  |  |  |  | 859-LTST-C170YKT | 692-0925 | YELLOW | 1 | 3
C4 | 330UF | 330UF | PANASONIC_G |  |  |  | EEEFK1V331P | 667-EEE-FK1V331P | 708-3475 | 330µF 35V | 1 | 3
C1 | 10NF-F | 10NF-F | C0603 |  |  |  |  | 81-GCM188R71H103KA7D | 723-4982 | 10nF 50V | 2 | 6
MOT1 | MICROMATCH-16_SMD | MICROMATCH-16_SMD | MICROMATCH-16_SMD | MicroMaTch 16 FN : 1565592 / 8-215464-6 / 1-215464-6 |  |  |  | 571-8-188275-6 | 739-1237 |  | 1 | 3
R4 | 10K-F | 10K-F | R0603 |  |  |  |  | 652-CR0603-JW-103ELF | 740-8892 |  | 3 | 9
R8 | 15k 1% | 15K-F | R0603 |  |  |  |  | 652-CR0603-JW-153GLF | 740-8912 | 15k 1% | 1 | 3 | ?
C7 | 1NF-F | 1NF-F | C0603 |  |  |  |  |  | 264-4551 |  | 1 | 3 | ?
IC2 | 74LVC2T45DCT | 74LVC2T45DCT | SSOP8 |  |  |  |  |  | 825-3467 |  | 2 | 6 | ?
Part | Value | Device | Package | Description |  | FARNELL | FN | MOUSER | RS | VALUE
C9 | 15pF_0603_100V | 15PF-F | C0603 |  |  |  |  | 581-06031A150K4T2A | 147-421 | 15pF_0603_100V | 2 | 4
UART | COM_2013_SLAVE | COM_2013_SLAVE | MICROMATCH-4_SMD |  |  |  |  | 571-7-188275-4 | 366-1721 |  | 1 | 2
D1 | CGRM4004-G | CGRM4004-G | SOD-123_MINI-SMA | Molded plasitc,JEDEC SOD-123/Mini SMA |  |  |  | 863-MRA4004T3G | 545-2456 | MRA4004T3G | 1 | 2 | ?
COM | LED_G | LED_G | CHIP-LED0805 |  |  |  |  | 859-LTST-C171GKT | 692-0935 | GREEN | 3 | 6
C1 | 100nF 50V | 100NF-F | C0603 |  |  |  |  | 81-GRM188F51H104ZA01 | 723-5534 | 100nF 50V | 13 | 26
R3 | 1k | 1K-F | R0603 |  |  |  |  | 71-CRCW0603-1.0K-E3 | 213-2266 | 1k | 1 | 2
R26 | 150K-F | 150K-F | R0603 |  |  | 1527709 |  |  | 213-2553 |  | 1 | 2 | ?
C11 | 100nF 50V | 100NF-E | C0805 |  |  |  |  | 81-GRM40Y104Z50D | 220-7966 | 100nF 50V | 2 | 4
R1 | 100-E | 100-E | R0805 |  |  |  |  | 603-AF0805FR-07100RL | 223-0297 | 100-E | 1 | 2
IC3 | MAX3232CSE | MAX3232CSE | SO16 | True RS-232 Transceivers 3.0V to 5.5V, Low-Power |  |  |  | 511-ST3232CDR | 415-2105 |  | 1 | 2
BAT | 22-27-2021-02 | 22-27-2021-02 | 6410-02 | CONNECTOR |  |  |  | 538-22-27-2021 | 483-8461 |  | 2 | 4
T1 | MMBT2222LT1G | MMBT2222ALT1-NPN-SOT23-BEC | SOT23-BEC | NPN Transistror |  |  |  | 863-MMBT2222ALT1G | 781-5222 | mmbt2222 | 1 | 2
D4 | MBRA340T3 | MBRA340T3 | SMA | Surface Mount Schottky Power Rectifier |  |  |  | 863-MBRA340T3G | 688-0502 | MBRA340T3 | 1 | 2
PDI_ATMEL |  | PDI_ATMELL | ML6L | Ref Harting : 09 18 506 7323 |  |  |  | 617-09-18-506-7323 | 693-5242 |  | 1 | 2
R19 | 3K09-F | 3K09-F | R0603 |  |  |  |  | 667-ERA-3AEB3091V | 708-7574 |  | 2 | 4
L1 | 220 ohms | FERRITE_220OHMS | R0603 |  |  |  |  | 81-BLM18BB221SN1D | 724-1302 | 220 ohms | 1 | 2
R2 | 10k | 10K-F | R0603 |  |  |  |  | 652-CR0603-JW-103ELF | 740-8805 |  | 8 | 16 | ?
R13 | 15k 1% | 15K-F | R0603 |  |  |  |  | 652-CR0603-JW-153GLF | 678-9793 | 15k 1% | 2 | 4 | ?
R6 | 270-E | 270-E | R0805 |  |  |  |  | 660-RK73H2ATTD2700F | 740-9019 |  | 8 | 16
D2 | bzv55-c3v3 | BZV55-C3V3SOD80C | SOD80C | Z-Diode |  |  |  | 771-BZV55-C3V3T/R | 748-5029 | bzv55-c3v3 | 2 | 4
C12 | 10µF 25V | 10UF-C_25V | C1210 |  |  |  |  | 963-TMK316BJ106KL-T | 766-1185 | 10µF 25V | 1 | 2
IC1 | ATXMEGA64D4-AU | ATXMEGA64D4-AU | TQFP44 |  |  |  |  | 556-ATXMEGA64D4-AU | 761-7765 | ATXMEGA64DA-AU | 1 | 2
IC2 | NCV8774DT33RKG | NCV8774DT33RKG | DPACK_3 |  |  |  |  |  | 796-1303 |  | 1 | 2
IR-SENSOR | 87831-0641 | 87831-0641 | 87831-0641 |  |  | 1393817 |  |  | 670-0933 |  | 1 | 2
PH1 | EESX1106 | EESX1106 | EESX1106 |  |  | 1348951 |  |  |  |  | 1 | 2
Q1 |  | CRYSTAL_16MHZ_5032 | CRYSTAL_5032 | CRYSTAL |  | 2467791 |  |  | 813-6116 |  | 1 | 2
R8 | 0-E | 0-E | R0805 |  |  |  |  |  | NC |  | 0 | 0
T2 | ZXMP6A17E6TA | ZXMP6A17E6TA | SOT26 |  |  |  | 1843775 |  | 669-7489 |  | 1 | 2
T3 | DMN6068SE | DMN6068SE | SOT223 |  |  | 2061415 |  |  | 751-4219 |  | 1 | 2
http://www.robotshop.com/eu/fr/capteur-distance-laser-lidar-lite-2-pulsedlight.html
http://fr.rs-online.com/web/p/translateurs-de-tension/8253467/
