robotter/robotter/hardware/prism/consommation.ods

Sheet: consommation carte
consommation carte esclave balises
composant | référence | conso sur 3v3 (mA) | conso sur 5v (mA) | conso sur tension batterie (vbat) (mA) | qté | total conso sur 3v3 (mA) | total conso sur 5v (mA) | total conso sur batterie (mA)
µc | ATxmega128A1 | 80 |  |  | 1 | 80 | 0 | 0
capteur reflectif | S15-PA-2-A00-PK |  |  | 30 | 2 | 0 | 0 | 60
ventilateur | OD4010-12HSS |  |  | 100 | 2 | 0 | 0 | 200
glue logic |  | 20 | 20 |  | 1 | 20 | 20 | 0
 |  |  |  |  | total | 100 | 20 | 260
 |  |  |  |  | total sur batterie | 83,3333333333
 |  |  |  |  | coefficient sécurité | 1,5
consommation carte maitre balises |  |  |  |  | régulateur doit fournir (mA) : | 125 | 30 | 390
composant | référence | conso sur 3v3 (mA) | conso sur 5v (mA) | conso sur tension batterie (vbat) (mA) | qté | total conso sur 3v3 (mA) | total conso sur 5v (mA) | total conso sur batterie (mA)
xbee | Xbee-pro | 250 |  |  | 1 | 250 | 0 | 0
µc | ATxmega128A1 | 80 | 0 | 0 | 1 | 80 | 0 | 0
capteur reflectif | S15-PA-2-A00-PK | 0 | 0 | 30 | 2 | 0 | 0 | 60
ventilateur | OD4010-12HSS | 0 | 0 | 100 | 2 | 0 | 0 | 200
glue logic | 0 | 20 | 20 | 0 | 1 | 20 | 20 | 0
 |  |  |  |  | total | 350 | 20 | 260
 |  |  |  |  | total sur batterie | 291,6666666667
 |  |  |  |  | coefficient sécurité | 1,5
 |  |  |  |  | régulateur doit fournir (mA) : | 437,5 | 30 | 390
 |  |  |  |  | autonomie (h) | 1 | heures
 |  |  |  |  | capacité batterie (mAh) : | 1947,5 | mAh
 |  |  |  |  | batterie possible | http://hobbyking.com/hobbyking/store/__11914__Turnigy_nano_tech_2650mah_2S_25_50C_Lipo_Pack.html

Sheet: alimentation 3v3
Vin (V) | 40
Vout (V) | 24
iout (A) | 0,4
Vref | 1,23
scitwhing frequency (kHz) | 52
R1 (k ohms) | 1
R2 (k ohms) | 18,512195122
ET | 184,6153846154
L1 (µH) | 1000
Cout min ripple current | 0,288
cout min value (µF) | 22,1666666667 | Cout superieur a 100 µF
D1
