robotter/robotter/hardware/color_sensor/ground_detector_BOM.ods

Composant | Value | Part | Référence FN | Qté brute | UDV | prix/UDV | Qté en UDV | Sous total FN
L-EUL1812 |  | L1, L2 |  |  |  |  | 2 | 0
ML6 |  | SV1 | 1096984 | 1 | 1 | 0,850 € | 1 | 0,850 €
1N4148DO35-7 | 1N4148DO35-7 | D1, D2 | 1612346 | 2 | 1 | 0,071 € | 2 | 0,142 €
 |  |  |  |  |  |  |  | 0
R-EU_R0805 | 270 | R1, R4 | 9334254 | 2 | 1 | 0,018 € | 50 | 0,900 €
R-EU_R0805 | 1k | R7 | 9333711 | 1 | 1 | 0,018 € | 50 | 0,900 €
R-EU_R0805 | 10k | R3, R6 | 9333720 | 2 | 1 | 0,038 € | 50 | 1,900 €
R-EU_R0805 | 100k | R2, R5 | 9333738 | 2 | 1 | 0,038 € | 50 | 1,900 €
 |  |  |  |  |  |  |  | 0
CPOL-EUD/7343-31W | 33µF 6V3 | C3, C6, C7 | 1163356 | 3 | 1 | 0,500 € | 3 | 1,500 €
C-EUC0805 | 3.3nF | C1, C4 | 1759239 | 2 | 1 | 0,011 € | 100 | 1,100 €
C-EUC0805 | 100nF | C2, C5 | 9406387 | 2 | 1 | 0,070 € | 10 | 0,700 €
 |  |  |  |  |  |  |  | 0
APDS-9700 | APDS-9700 | IC1, IC3 | 1634725 | 2 | 1 | 1,630 € | 2 | 3,260 €
HSDL-9100 | HSDL-9100 | IC2, IC4 | 9613846 | 2 | 1 | 1,470 € | 2 | 2,940 €
 |  |  |  |  |  |  | Total FN | 16,09 €
