robotter/robotter/docs/measurements/galipeur2k9/line_a.png

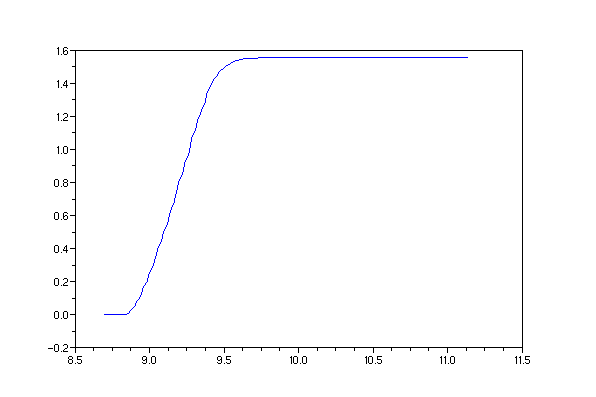
docs/measurements/galipeur2k9/line_a.png
