robotter/robotter/docs/measurements/galipeur2k9/line_a_speed.png

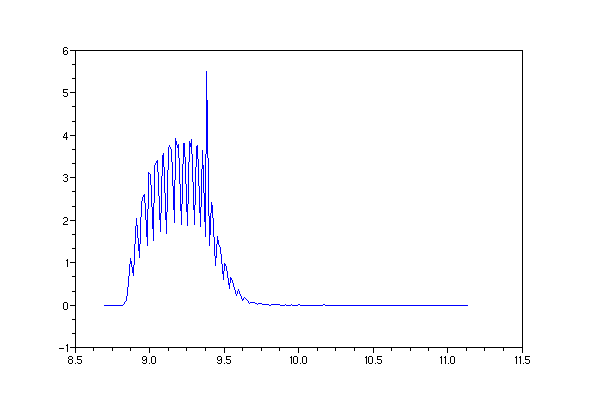
docs/measurements/galipeur2k9/line_a_speed.png
