robotter/robotter/docs/measurements/galipeur2k9/line_xy.png

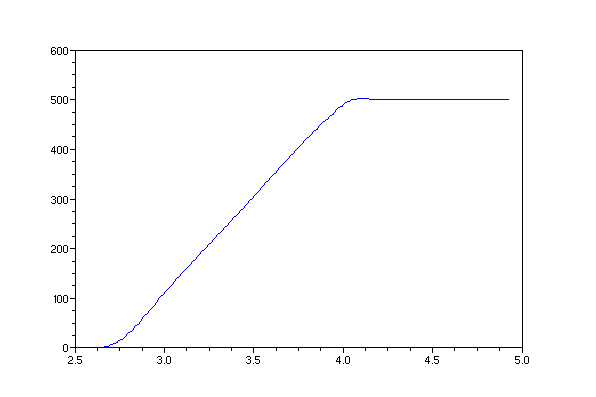
docs/measurements/galipeur2k9/line_xy.png
