robotter/robotter/docs/measurements/galipeur2k9/line_xy_speed.png

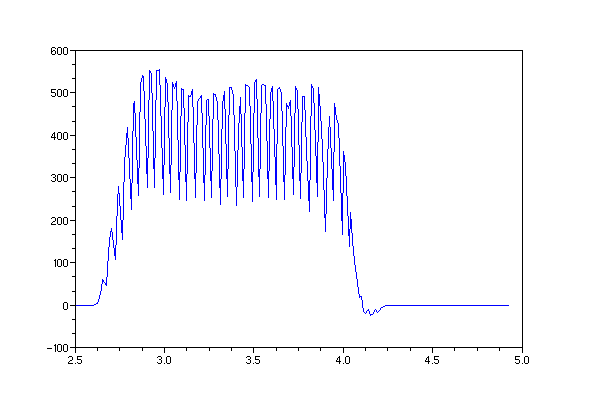
docs/measurements/galipeur2k9/line_xy_speed.png
