robotter/robotter/hardware/alim/alim_2009_sch.pdf

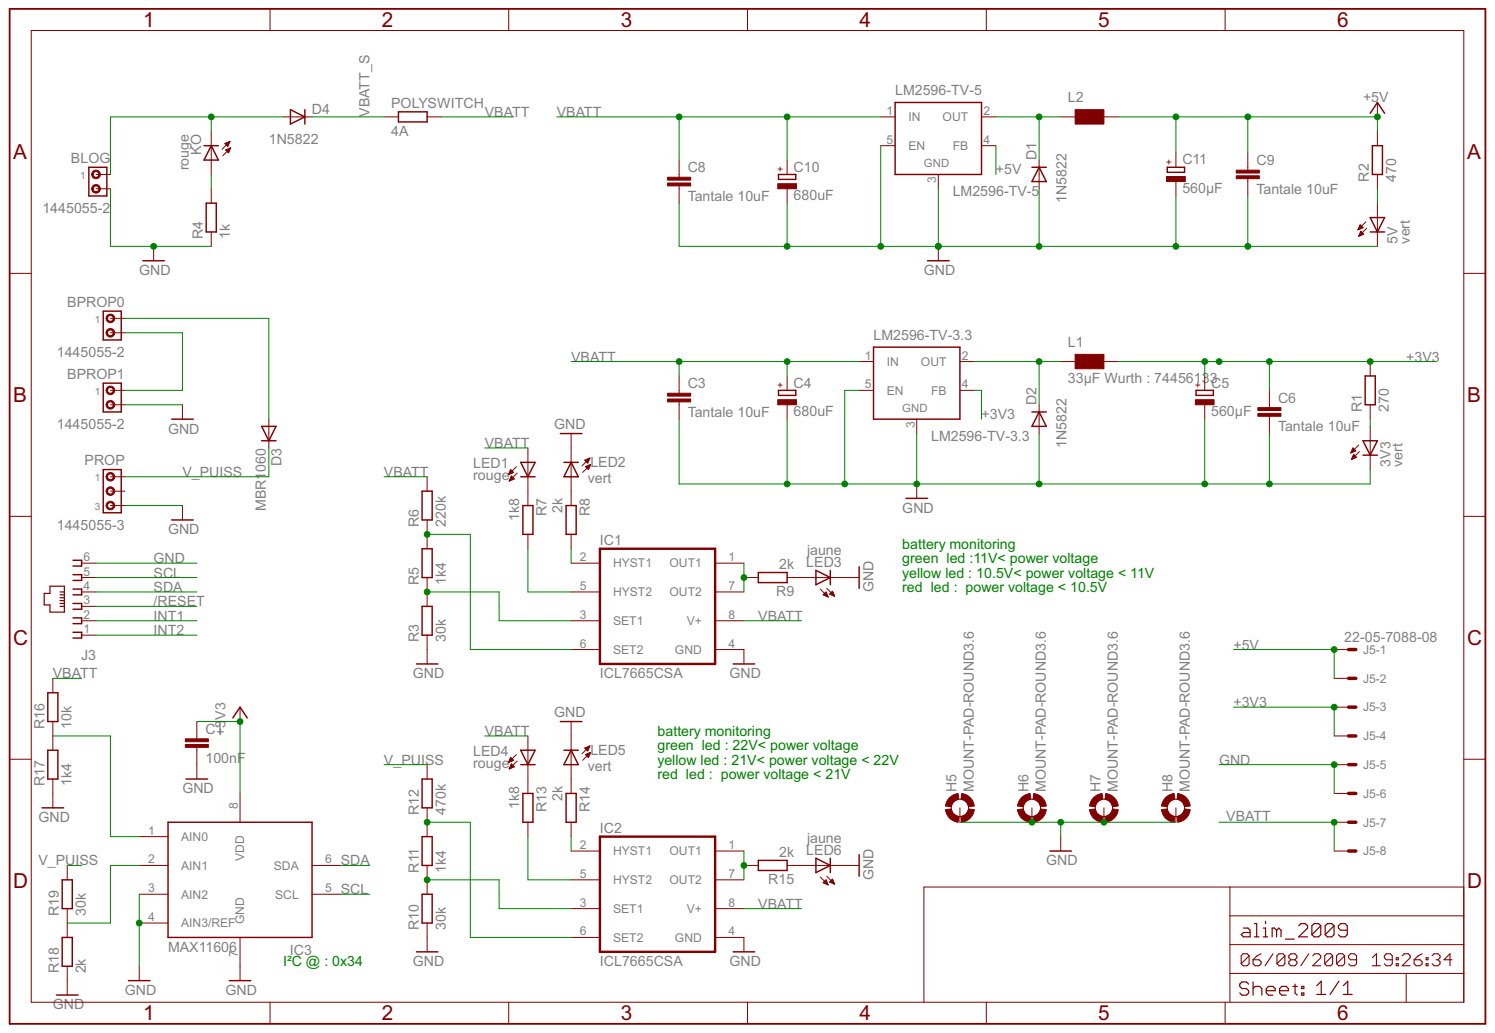
[picture p58: page 1]

battery monitoring
green led :11V< power voltage
yellow led : 10.5V< power voltage < 11V
red led : power voltage < 10.5V

green led : 22V< power voltage
yellow led : 21V< power voltage < 22V
red led : power voltage < 21V
