robotter/robotter/hardware/ax12_board/ax12board_sch.pdf

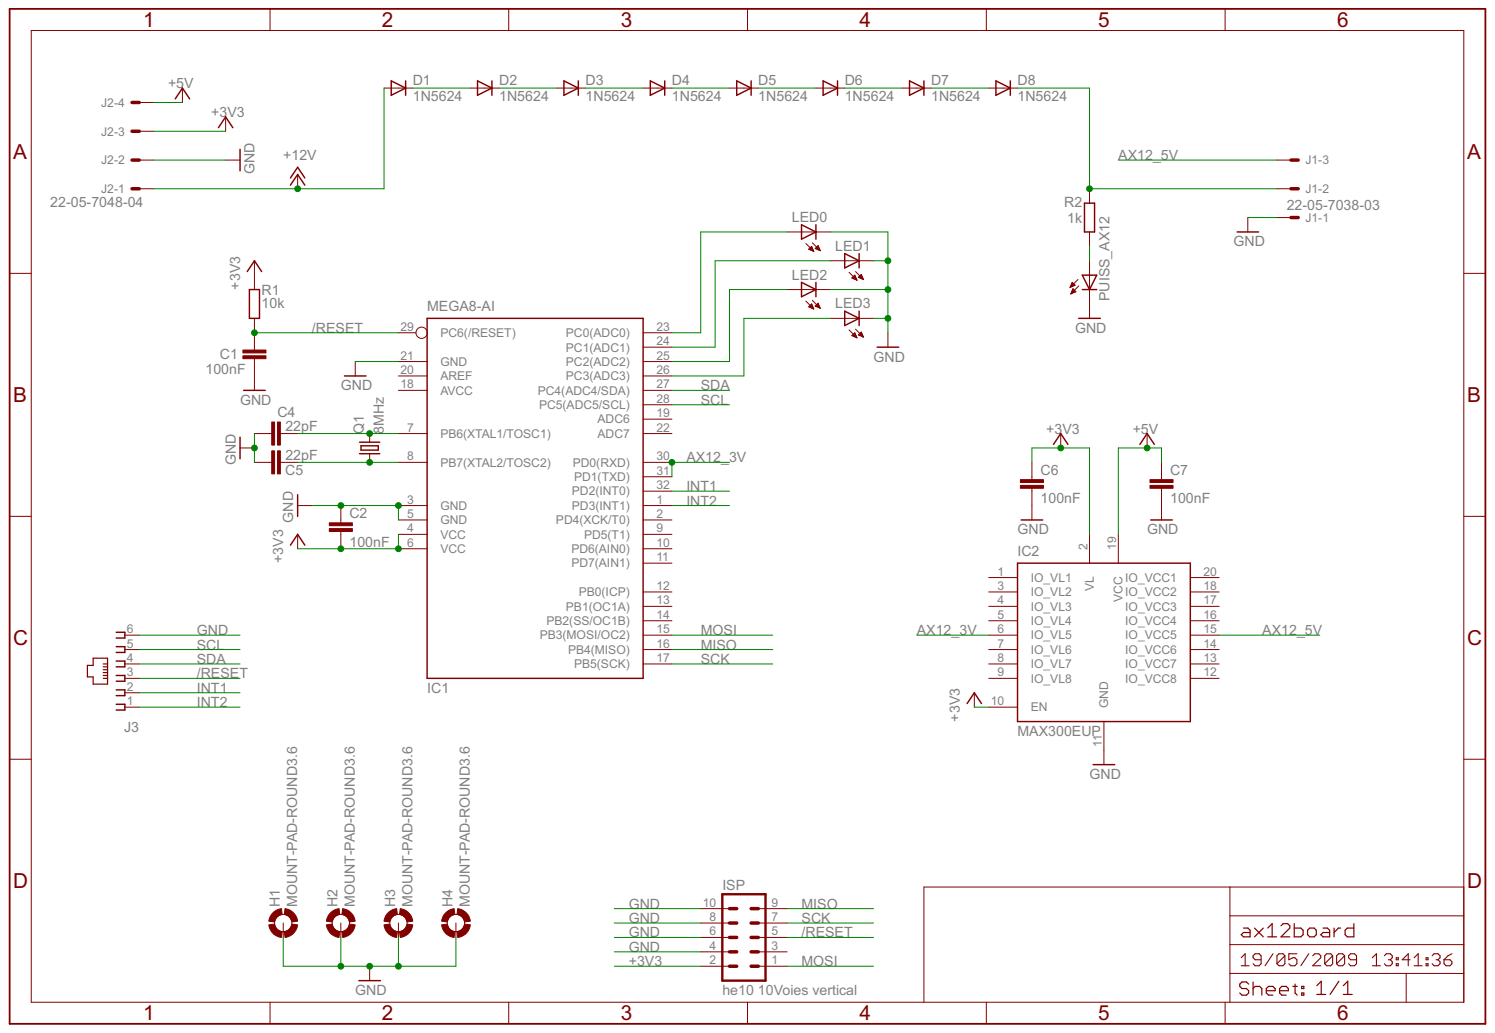
[picture p59: page 1]
