robotter/robotter/hardware/adapt_uart_serie/adapt_uart_serie_sch.pdf

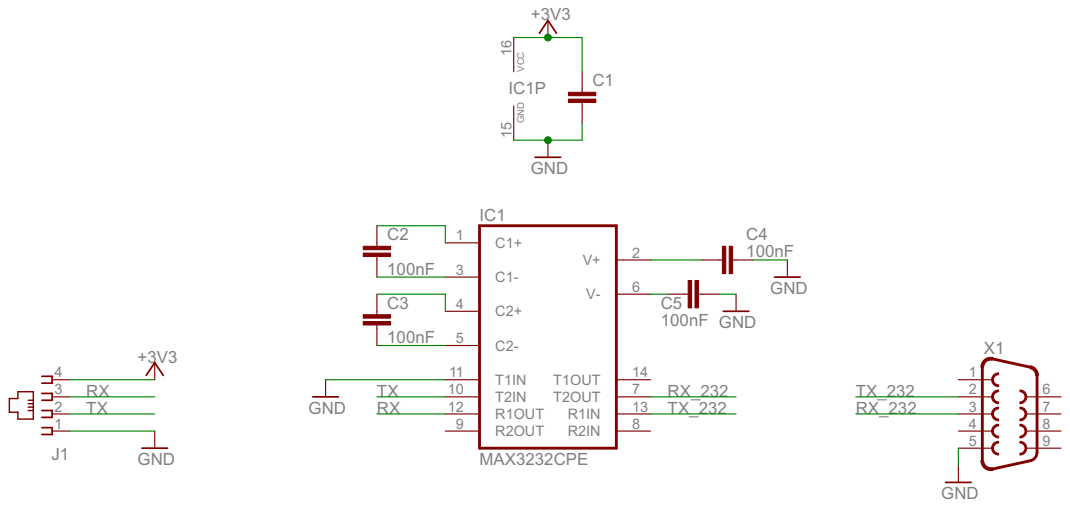
[picture p60: page 1]
