robotter/robotter/(list of files, drawings)

Other design files:
hardware/pmi_2k13/pmi_2k13.pcb
