robotter/robotter/hardware/meca_2018/meca_2018.brd

## EAGLE design hardware/meca_2018/meca_2018.brd (2019-01-26)

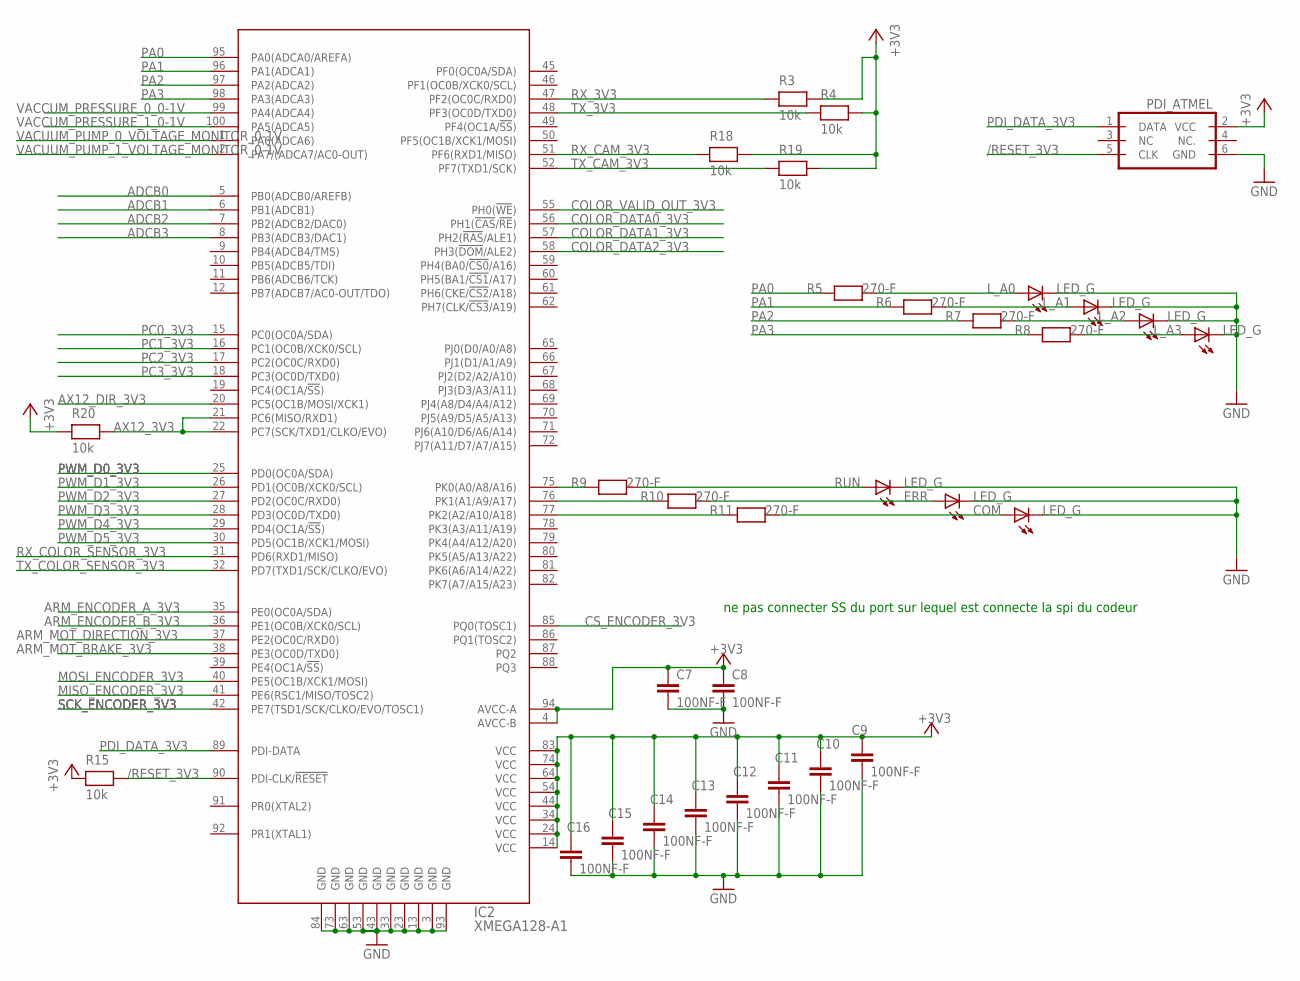
[picture p61: schematic meca_2018.sch, sheet 1]

Parts:
C7, C8, C9, C10, C11, C12, C13, C14, C15, C16: 100NF-F; C0603
COM: LED_G; CHIP-LED0805
ERR: LED_G; CHIP-LED0805
IC2: XMEGA128-A1; TQFP100
L_A0, L_A1, L_A2, L_A3: LED_G; CHIP-LED0805
PDI_ATMEL: PDI_ATMEL; ML6
R3, R4, R15, R18, R19, R20: 10k; R0603
R5, R6, R7, R8, R9, R10, R11: 270-F; R0603
RUN: LED_G; CHIP-LED0805

Connections:
+3V3: C7.1, C8.1, C9.1, C10.1, C11.1, C12.1, C13.1, C14.1, C15.1, C16.1, IC2.4 (AVCC-B), IC2.14 (VCC), IC2.24 (VCC), IC2.34 (VCC), IC2.44 (VCC), IC2.54 (VCC), IC2.64 (VCC), IC2.74 (VCC), IC2.83 (VCC), IC2.94 (AVCC-A), PDI_ATMEL.2 (VCC), R3.2, R4.2, R15.1, R18.2, R19.2, R20.1; also elsewhere on the board
/RESET_3V3: IC2.90 (PDI-CLK/!RESET), PDI_ATMEL.5 (CLK), R15.2
ADCB0: IC2.5 (PB0(ADCB0/AREFB))
ADCB1: IC2.6 (PB1(ADCB1))
ADCB2: IC2.7 (PB2(ADCB2/DAC0))
ADCB3: IC2.8 (PB3(ADCB3/DAC1))
ARM_ENCODER_A_3V3: IC2.35 (PE0(OC0A/SDA))
ARM_ENCODER_B_3V3: IC2.36 (PE1(OC0B/XCK0/SCL))
ARM_MOT_BRAKE_3V3: IC2.38 (PE3(OC0D/TXD0))
ARM_MOT_DIRECTION_3V3: IC2.37 (PE2(OC0C/RXD0))
AX12_3V3: IC2.21 (PC6(MISO/RXD1)), IC2.22 (PC7(SCK/TXD1/CLKO/EVO)), R20.2; also elsewhere on the board
AX12_DIR_3V3: IC2.20 (PC5(OC1B/MOSI/XCK1)); also elsewhere on the board
COLOR_DATA0_3V3: IC2.56 (PH1(!CAS!/!RE!))
COLOR_DATA1_3V3: IC2.57 (PH2(!RAS!/ALE1))
COLOR_DATA2_3V3: IC2.58 (PH3(!DOM!/ALE2))
COLOR_VALID_OUT_3V3: IC2.55 (PH0(!WE!))
CS_ENCODER_3V3: IC2.85 (PQ0(TOSC1))
GND: C7.2, C8.2, C9.2, C10.2, C11.2, C12.2, C13.2, C14.2, C15.2, C16.2, COM.C, ERR.C, IC2.3 (GND), IC2.13 (GND), IC2.23 (GND), IC2.33 (GND), IC2.43 (GND), IC2.53 (GND), IC2.63 (GND), IC2.73 (GND), IC2.84 (GND), IC2.93 (GND), L_A0.C, L_A1.C, L_A2.C, L_A3.C, PDI_ATMEL.6 (GND), RUN.C; also elsewhere on the board
MISO_ENCODER_3V3: IC2.41 (PE6(RSC1/MISO/TOSC2)); also elsewhere on the board
MOSI_ENCODER_3V3: IC2.40 (PE5(OC1B/XCK1/MOSI))
unnamed: R9.2, RUN.A
unnamed: ERR.A, R10.2
unnamed: COM.A, R11.2
unnamed: IC2.75 (PK0(A0/A8/A16)), R9.1
unnamed: IC2.76 (PK1(A1/A9/A17)), R10.1
unnamed: IC2.77 (PK2(A2/A10/A18)), R11.1
unnamed: L_A0.A, R5.2
unnamed: L_A1.A, R6.2
unnamed: L_A2.A, R7.2
unnamed: L_A3.A, R8.2
PA0: IC2.95 (PA0(ADCA0/AREFA)), R5.1
PA1: IC2.96 (PA1(ADCA1)), R6.1
PA2: IC2.97 (PA2(ADCA2)), R7.1
PA3: IC2.98 (PA3(ADCA3)), R8.1
PC0_3V3: IC2.15 (PC0(OC0A/SDA))
PC1_3V3: IC2.16 (PC1(OC0B/XCK0/SCL))
PC2_3V3: IC2.17 (PC2(OC0C/RXD0))
PC3_3V3: IC2.18 (PC3(OC0D/TXD0))
PDI_DATA_3V3: IC2.89 (PDI-DATA), PDI_ATMEL.1 (DATA)
PWM_D0_3V3: IC2.25 (PD0(OC0A/SDA)); also elsewhere on the board
PWM_D1_3V3: IC2.26 (PD1(OC0B/XCK0/SCL)); also elsewhere on the board
PWM_D2_3V3: IC2.27 (PD2(OC0C/RXD0)); also elsewhere on the board
PWM_D3_3V3: IC2.28 (PD3(OC0D/TXD0)); also elsewhere on the board
PWM_D4_3V3: IC2.29 (PD4(OC1A/!SS!)); also elsewhere on the board
PWM_D5_3V3: IC2.30 (PD5(OC1B/XCK1/MOSI)); also elsewhere on the board
RX_3V3: IC2.47 (PF2(OC0C/RXD0)), R3.1; also elsewhere on the board
RX_CAM_3V3: IC2.51 (PF6(RXD1/MISO)), R18.1; also elsewhere on the board
RX_COLOR_SENSOR_3V3: IC2.31 (PD6(RXD1/MISO))
SCK_ENCODER_3V3: IC2.42 (PE7(TSD1/SCK/CLKO/EVO/TOSC1))
TX_3V3: IC2.48 (PF3(OC0D/TXD0)), R4.1; also elsewhere on the board
TX_CAM_3V3: IC2.52 (PF7(TXD1/SCK)), R19.1; also elsewhere on the board
TX_COLOR_SENSOR_3V3: IC2.32 (PD7(TXD1/SCK/CLKO/EVO))
VACCUM_PRESSURE_0_0-1V: IC2.99 (PA4(ADCA4))
VACCUM_PRESSURE_1_0-1V: IC2.100 (PA5(ADCA5))
VACUUM_PUMP_0_VOLTAGE_MONITOR_0-1V: IC2.1 (PA6(ADCA6))
VACUUM_PUMP_1_VOLTAGE_MONITOR_0-1V: IC2.2 (PA7/(ADCA7/AC0-OUT))

Notes on the sheet:
ne pas connecter SS du port sur lequel est connecte la spi du codeur

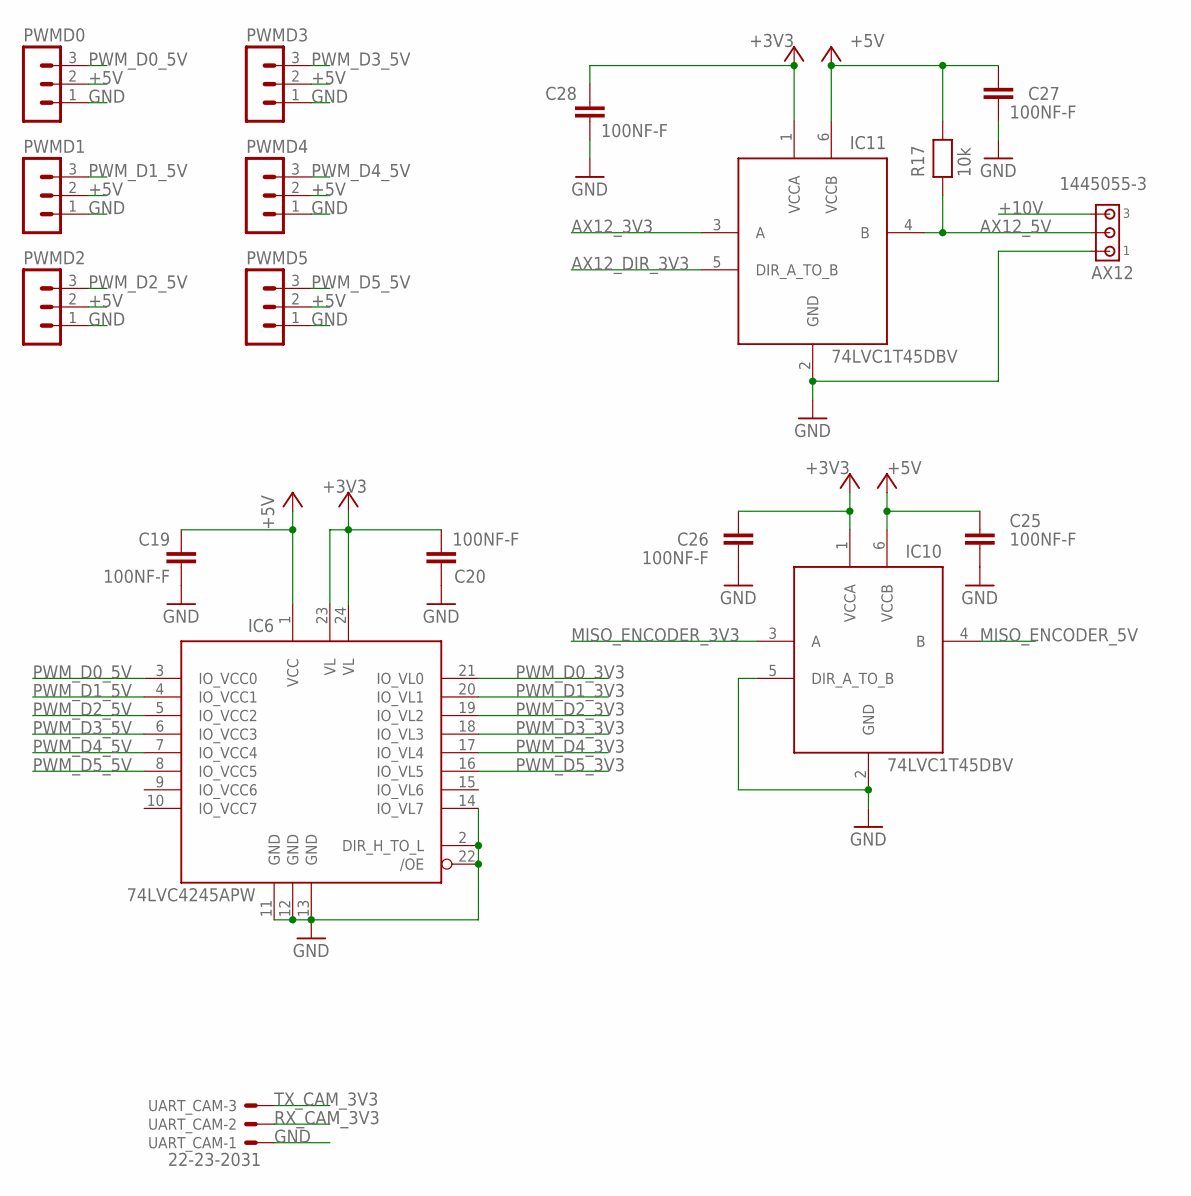
[picture p62: schematic meca_2018.sch, sheet 2]

Parts:
AX12: 1445055-3
C19, C20, C25, C26, C27, C28: 100NF-F; C0603
IC6: 74LVC4245APW; TSSOP24
IC10, IC11: 74LVC1T45DBV; SOT23-6
PWMD0, PWMD1, PWMD2, PWMD3, PWMD4, PWMD5: MA03-1
R17: 10k; R0603
UART_CAM: 22-23-2031

Connections:
+3V3: C20.1, C26.1, C28.1, IC6.23 (VL), IC6.24 (VL), IC10.1 (VCCA), IC11.1 (VCCA); also elsewhere on the board
+5V: C19.1, C25.1, C27.1, IC6.1 (VCC), IC10.6 (VCCB), IC11.6 (VCCB), PWMD0.2, PWMD1.2, PWMD2.2, PWMD3.2, PWMD4.2, PWMD5.2, R17.2; also elsewhere on the board
+10V: AX12.3; also elsewhere on the board
AX12_3V3: IC11.3 (A); also elsewhere on the board
AX12_5V: AX12.2, IC11.4 (B), R17.1
AX12_DIR_3V3: IC11.5 (DIR_A_TO_B); also elsewhere on the board
GND: AX12.1, C19.2, C20.2, C25.2, C26.2, C27.2, C28.2, IC6.2 (DIR_H_TO_L), IC6.11 (GND), IC6.12 (GND), IC6.13 (GND), IC6.14 (IO_VL7), IC6.22 (/OE), IC10.2 (GND), IC10.5 (DIR_A_TO_B), IC11.2 (GND), PWMD0.1, PWMD1.1, PWMD2.1, PWMD3.1, PWMD4.1, PWMD5.1, UART_CAM.1; also elsewhere on the board
MISO_ENCODER_3V3: IC10.3 (A); also elsewhere on the board
MISO_ENCODER_5V: IC10.4 (B)
PWM_D0_3V3: IC6.21 (IO_VL0); also elsewhere on the board
PWM_D0_5V: IC6.3 (IO_VCC0), PWMD0.3
PWM_D1_3V3: IC6.20 (IO_VL1); also elsewhere on the board
PWM_D1_5V: IC6.4 (IO_VCC1), PWMD1.3
PWM_D2_3V3: IC6.19 (IO_VL2); also elsewhere on the board
PWM_D2_5V: IC6.5 (IO_VCC2), PWMD2.3
PWM_D3_3V3: IC6.18 (IO_VL3); also elsewhere on the board
PWM_D3_5V: IC6.6 (IO_VCC3), PWMD3.3
PWM_D4_3V3: IC6.17 (IO_VL4); also elsewhere on the board
PWM_D4_5V: IC6.7 (IO_VCC4), PWMD4.3
PWM_D5_3V3: IC6.16 (IO_VL5); also elsewhere on the board
PWM_D5_5V: IC6.8 (IO_VCC5), PWMD5.3
RX_CAM_3V3: UART_CAM.2; also elsewhere on the board
TX_CAM_3V3: UART_CAM.3; also elsewhere on the board

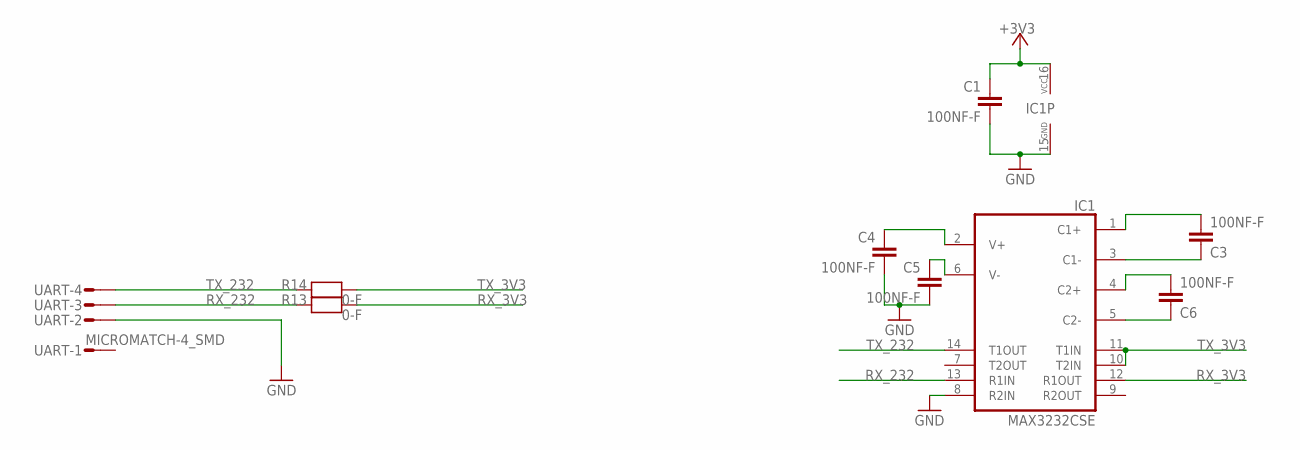
[picture p63: schematic meca_2018.sch, sheet 3]

Parts:
C1, C3, C4, C5, C6: 100NF-F; C0603
IC1: MAX3232CSE; SO16
R13, R14: 0-F; R0603
UART: MICROMATCH-4_SMD

Connections:
+3V3: C1.1, IC1.16 (VCC); also elsewhere on the board
GND: C1.2, C4.2, C5.2, IC1.8 (R2IN), IC1.15 (GND), UART.2; also elsewhere on the board
unnamed: C3.1, IC1.1 (C1+)
unnamed: C3.2, IC1.3 (C1-)
unnamed: C6.1, IC1.4 (C2+)
unnamed: C4.1, IC1.2 (V+)
unnamed: C5.1, IC1.6 (V-)
unnamed: C6.2, IC1.5 (C2-)
RX_3V3: IC1.12 (R1OUT), R13.2; also elsewhere on the board
RX_232: IC1.13 (R1IN), R13.1, UART.3
TX_3V3: IC1.10 (T2IN), IC1.11 (T1IN), R14.2; also elsewhere on the board
TX_232: IC1.14 (T1OUT), R14.1, UART.4

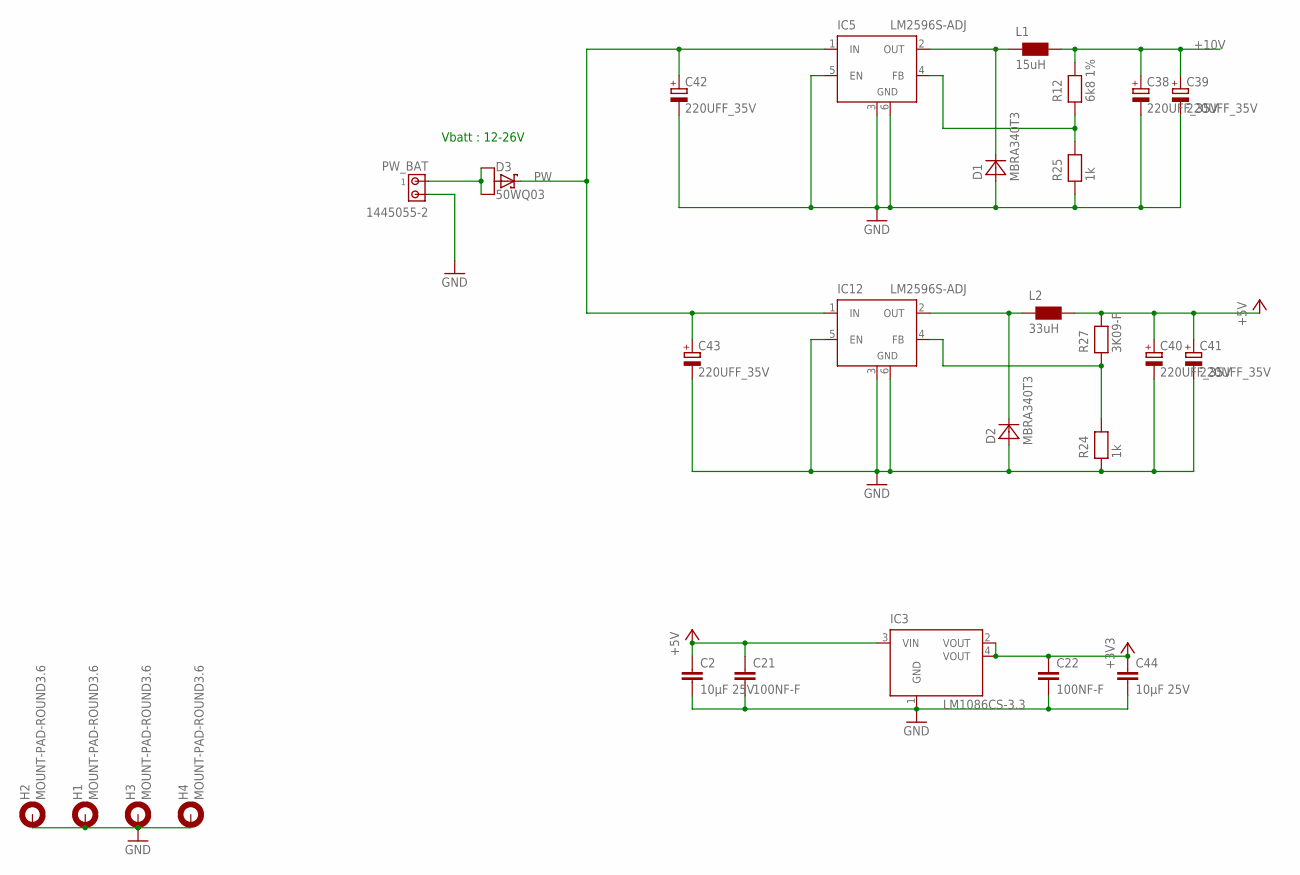
[picture p64: schematic meca_2018.sch, sheet 4]

Parts:
C2, C44: 10µF 25V; C1210
C21, C22: 100NF-F; C0603
C38, C39, C40, C41, C42, C43: 220UFF_35V; PANASONIC_F
D1, D2: MBRA340T3; SMA
D3: 50WQ03; TO252
H1, H2, H3, H4: MOUNT-PAD-ROUND3.6; 3,6-PAD
IC3: LM1086CS-3.3; TO263
IC5, IC12: LM2596S-ADJ; TO263-5
L1: 15uH; SRR1280
L2: 33uH; SRR1280
PW_BAT: 1445055-2
R12: 6k8 1%; R0603
R24, R25: 1k; R0603
R27: 3K09-F; R0603

Connections:
+3V3: C22.1, C44.1, IC3.2 (VOUT), IC3.4 (VOUT); also elsewhere on the board
+5V: C2.1, C21.1, C40.+, C41.+, IC3.3 (VIN), L2.2, R27.2; also elsewhere on the board
+10V: C38.+, C39.+, L1.2, R12.2; also elsewhere on the board
GND: C2.2, C21.2, C22.2, C38.-, C39.-, C40.-, C41.-, C42.-, C43.-, C44.2, D1.A, D2.A, H1.B3,6, H2.B3,6, H3.B3,6, H4.B3,6, IC3.1 (GND), IC5.3 (GND), IC5.5 (EN), IC5.6 (GND), IC12.3 (GND), IC12.5 (EN), IC12.6 (GND), PW_BAT.2, R24.1, R25.1; also elsewhere on the board
unnamed: IC12.4 (FB), R24.2, R27.1
unnamed: IC5.4 (FB), R12.1, R25.2
unnamed: D3.1 (A1), D3.3 (A2), PW_BAT.1
unnamed: D1.C, IC5.2 (OUT), L1.1
unnamed: D2.C, IC12.2 (OUT), L2.1
PW: C42.+, C43.+, D3.4 (C), IC5.1 (IN), IC12.1 (IN)

Notes on the sheet:
Vbatt : 12-26V

Board: 2 copper layers, 86 parts (12 on the bottom side), 54 nets, no tracks yet.
