robotter/robotter/hardware/BoomOtter/BoomOtter.brd

## EAGLE design hardware/BoomOtter/BoomOtter.brd (2018-05-06)

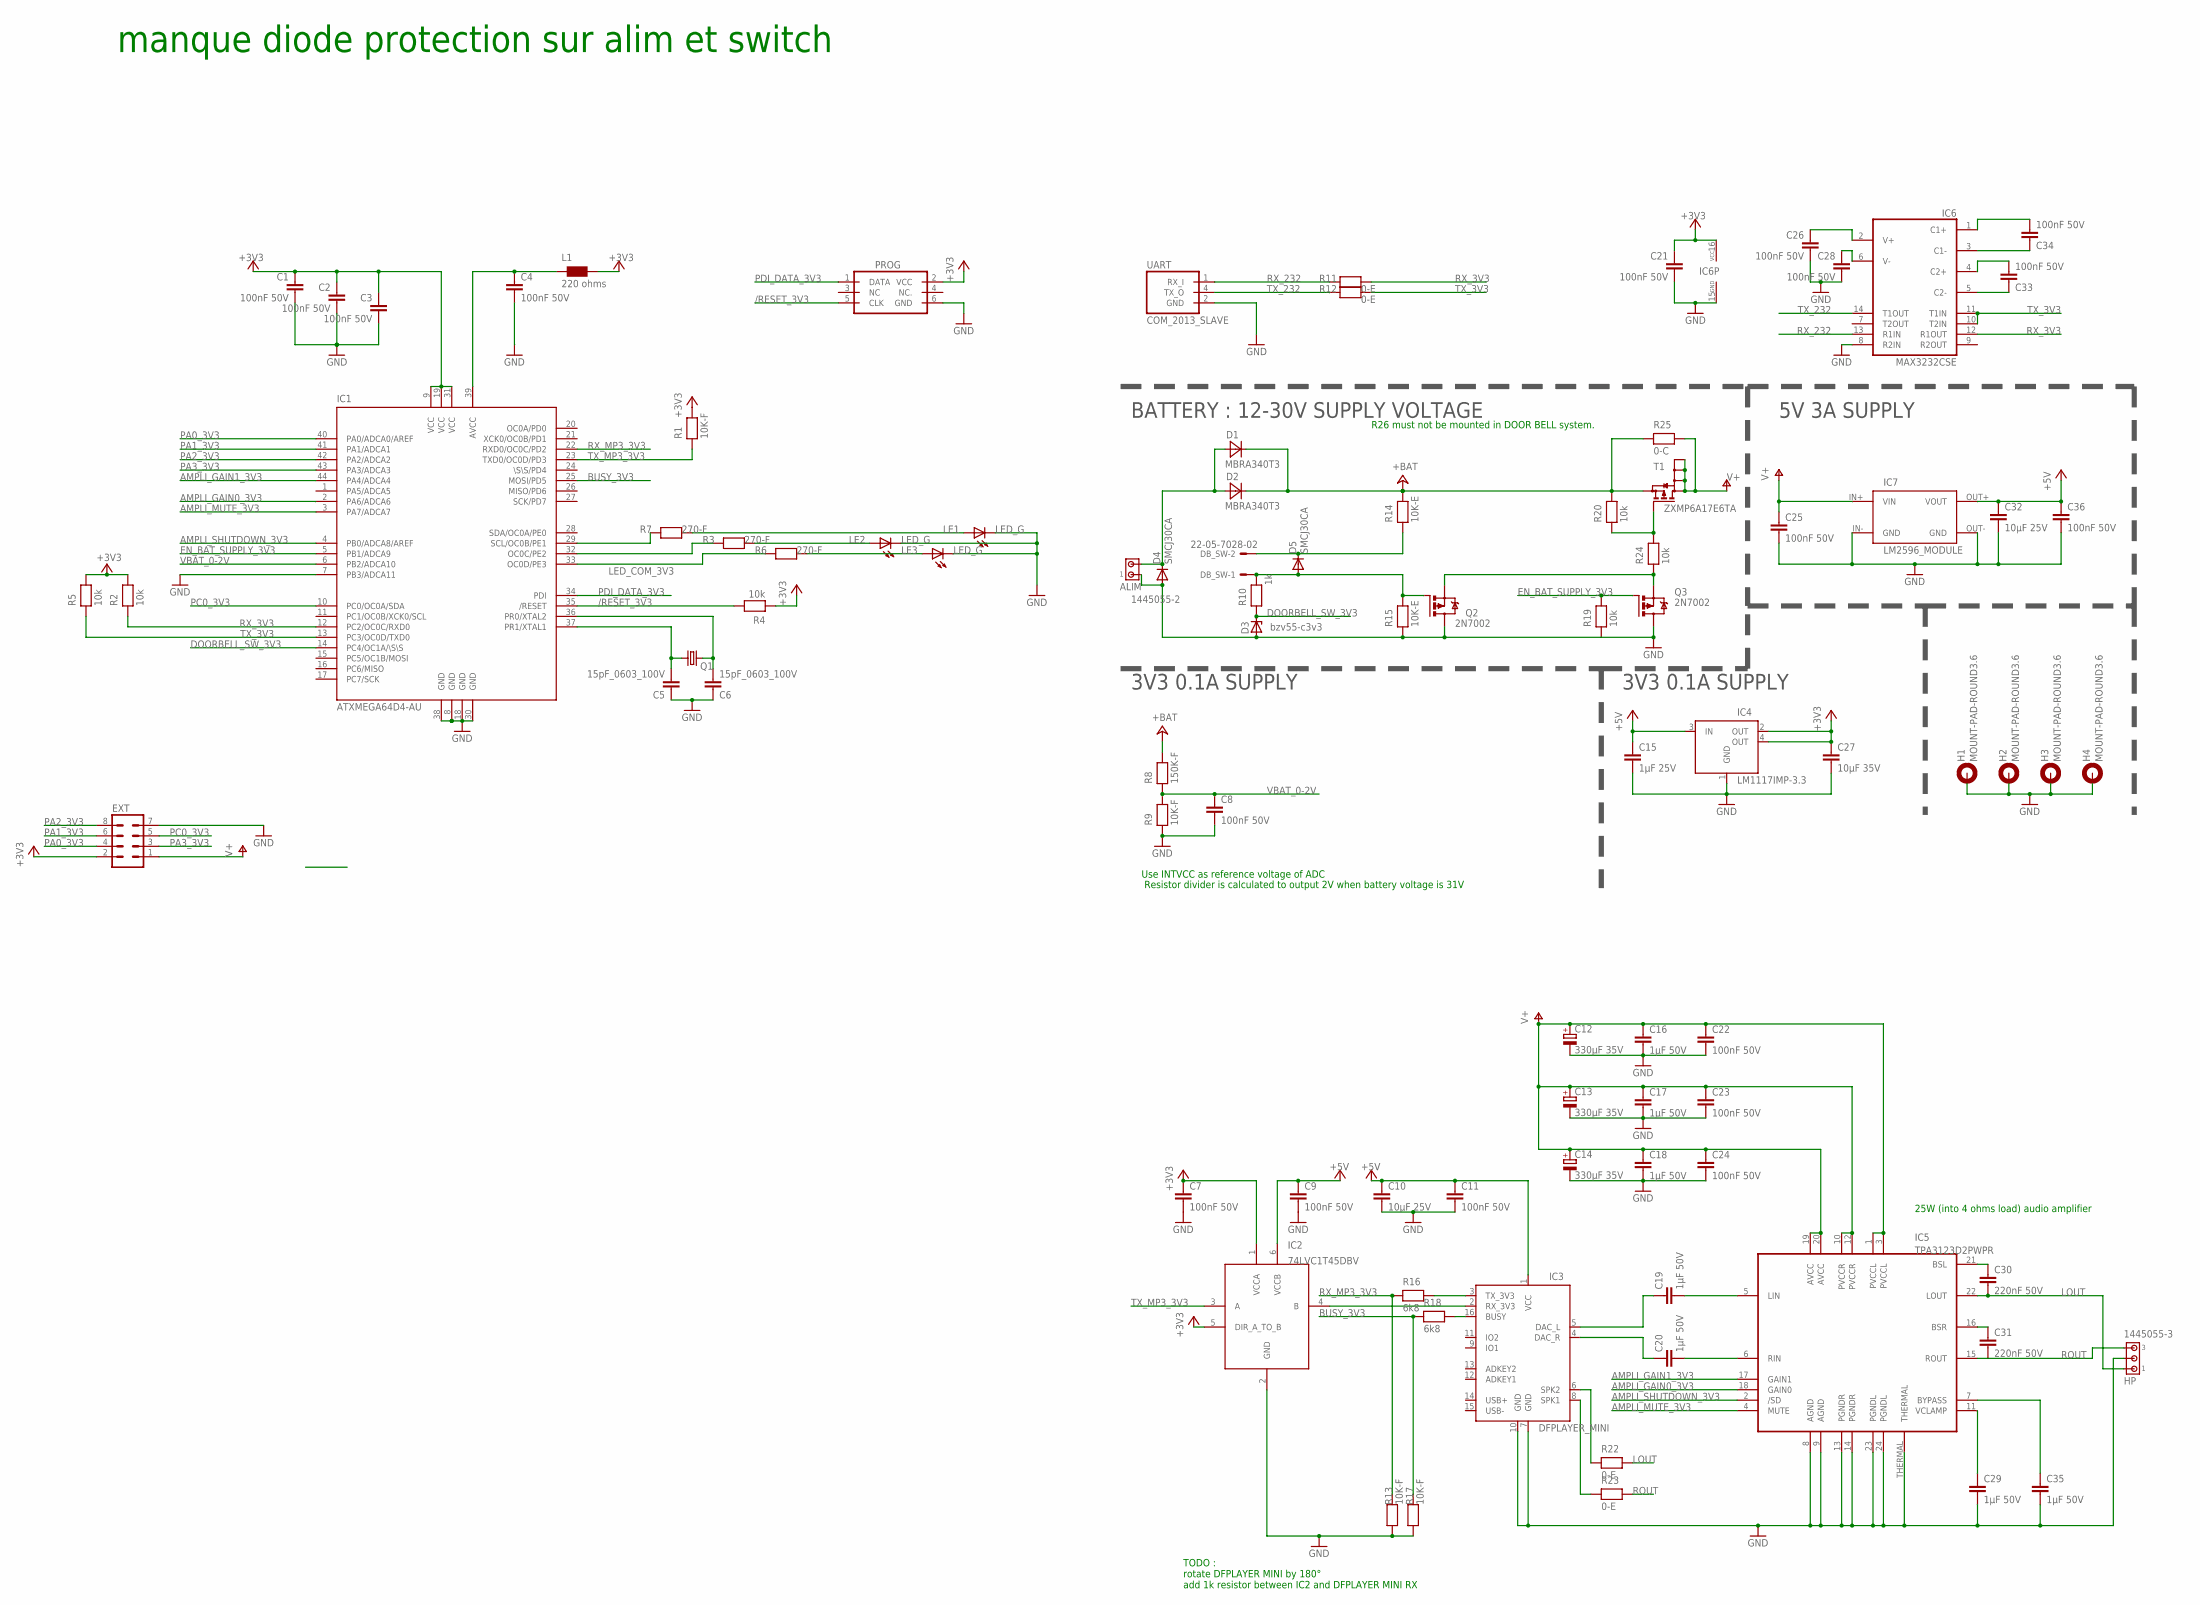
[picture p65: schematic BoomOtter.sch]

Parts:
ALIM: 1445055-2
C1, C2, C3, C4, C7, C9, C11, C21, C22, C23, C24, C26, C28, C33, C34, C36: 100nF 50V; C0603
C5, C6: 15pF_0603_100V; C0603
C8, C25: 100nF 50V; C0805
C10, C32: 10µF 25V; C1210
C12, C13, C14: 330µF 35V; PANASONIC_G
C15: 1µF 25V; C1206
C16, C17, C18, C19, C20, C29, C35: 1µF 50V; C1206
C27: 10µF 35V; C1210
C30, C31: 220nF 50V; C0805
D1, D2: MBRA340T3; SMA
D3: bzv55-c3v3; SOD80C
D4, D5: SMCJ30CA; SMC
DB_SW: 22-05-7028-02; 7395-02
EXT: MA04-2
H1, H2, H3, H4: MOUNT-PAD-ROUND3.6; 3,6-PAD
HP: 1445055-3
IC1: ATXMEGA64D4-AU; TQFP44
IC2: 74LVC1T45DBV; SOT23-6
IC3: DFPLAYER_MINI
IC4: LM1117IMP-3.3; SOT223
IC5: TPA3123D2PWPR; HTSSOP24
IC6: MAX3232CSE; SO16
IC7: LM2596_MODULE; LM2596
L1: 220 ohms; R0603
LE1, LE2, LE3: LED_G; CHIP-LED0805
PROG: PDI_ATMELL; ML6L
Q1: CRYSTAL_16MHZ_5032; CRYSTAL_5032
Q2, Q3: 2N7002; SOT23
R1, R9, R13, R17: 10K-F; R0603
R2, R4, R5, R19, R20, R24: 10k; R0603
R3, R6, R7: 270-F; R0603
R8: 150K-F; R0603
R10: 1k; R0603
R11, R12, R22, R23: 0-E; R0805
R14, R15: 10K-E; R0805
R16, R18: 6k8; R0603
R25: 0-C; R1210
T1: ZXMP6A17E6TA; SOT26
UART: COM_2013_SLAVE; MICROMATCH-4_SMD

Connections:
+3V3: C1.1, C2.1, C3.1, C7.1, C21.1, C27.1, EXT.2, IC1.9 (VCC), IC1.19 (VCC), IC1.31 (VCC), IC2.1 (VCCA), IC2.5 (DIR_A_TO_B), IC4.2 (OUT), IC4.4 (OUT), IC6.16 (VCC), L1.2, PROG.2 (VCC), R1.2, R2.2, R4.1, R5.2
+5V: C9.1, C10.1, C11.1, C15.1, C32.1, C36.1, IC2.6 (VCCB), IC3.1 (VCC), IC4.3 (IN), IC7.OUT+ (VOUT)
+BAT: D1.C, D2.C, R8.2, R14.2, R20.2, R25.1, T1.4 (S)
/RESET_3V3: IC1.35 (/RESET), PROG.5 (CLK), R4.2
AMPLI_GAIN0_3V3: IC1.2 (PA6/ADCA6), IC5.18 (GAIN0)
AMPLI_GAIN1_3V3: IC1.44 (PA4/ADCA4), IC5.17 (GAIN1)
AMPLI_MUTE_3V3: IC1.3 (PA7/ADCA7), IC5.4 (MUTE)
AMPLI_SHUTDOWN_3V3: IC1.4 (PB0/ADCA8/AREF), IC5.2 (/SD)
BUSY_3V3: IC1.25 (MOSI/PD5), R17.2, R18.1
DOORBELL_SW_3V3: D3.C, IC1.14 (PC4/OC1A/\S\S), R10.1
EN_BAT_SUPPLY_3V3: IC1.5 (PB1/ADCA9), Q3.1 (G), R19.2
GND: ALIM.1, C1.2, C2.2, C3.2, C4.2, C5.1, C6.1, C7.2, C8.2, C9.2, C10.2, C11.2, C12.-, C13.-, C14.-, C15.2, C16.2, C17.2, C18.2, C21.2, C22.2, C23.2, C24.2, C25.2, C26.2, C27.2, C28.2, C29.2, C32.2, C35.2, C36.2, D3.A, D4.A, EXT.7, H1.B3,6, H2.B3,6, H3.B3,6, H4.B3,6, HP.2, IC1.7 (PB3/ADCA11), IC1.8 (GND), IC1.18 (GND), IC1.30 (GND), IC1.38 (GND), IC2.2 (GND), IC3.7 (GND), IC3.10 (GND), IC4.1 (GND), IC5.8 (AGND), IC5.9 (AGND), IC5.13 (PGNDR), IC5.14 (PGNDR), IC5.23 (PGNDL), IC5.24 (PGNDL), IC5.THERMAL, IC6.8 (R2IN), IC6.15 (GND), IC7.IN- (GND), IC7.OUT- (GND), LE1.C, LE2.C, LE3.C, PROG.6 (GND), Q2.2 (D), Q3.2 (D), R9.1, R13.1, R15.1, R17.1, R19.1, UART.2 (GND)
LED_COM_3V3: IC1.29 (SCL/OC0B/PE1), R7.1
LOUT: C30.2, HP.1, IC5.22 (LOUT), R22.2
unnamed: C34.1, IC6.1 (C1+)
unnamed: LE2.A, R3.2
unnamed: ALIM.2, D1.A, D2.A, D4.C
unnamed: LE3.A, R6.2
unnamed: C34.2, IC6.3 (C1-)
unnamed: C33.1, IC6.4 (C2+)
unnamed: LE1.A, R7.2
unnamed: Q2.3 (S), Q3.3 (S), R24.1
unnamed: IC1.32 (OC0C/PE2), R3.1
unnamed: IC1.33 (OC0D/PE3), R6.1
unnamed: C26.1, IC6.2 (V+)
unnamed: C19.1, IC3.5 (DAC_L)
unnamed: C28.1, IC6.6 (V-)
unnamed: C6.2, IC1.36 (PR0/XTAL2), Q1.2
unnamed: D5.C, DB_SW.2, R14.1
unnamed: C4.1, IC1.39 (AVCC), L1.1
unnamed: D5.A, DB_SW.1, Q2.1 (G), R10.2, R15.2
unnamed: C20.1, IC3.4 (DAC_R)
unnamed: C20.2, IC5.6 (RIN)
unnamed: C19.2, IC5.5 (LIN)
unnamed: C30.1, IC5.21 (BSL)
unnamed: IC3.3 (TX_3V3), R16.2
unnamed: C33.2, IC6.5 (C2-)
unnamed: C31.1, IC5.16 (BSR)
unnamed: C35.1, IC5.7 (BYPASS)
unnamed: IC3.6 (SPK2), R22.1
unnamed: IC3.8 (SPK1), R23.1
unnamed: IC3.16 (BUSY), R18.2
unnamed: IC2.4 (B), IC3.2 (RX_3V3)
unnamed: C5.2, IC1.37 (PR1/XTAL1), Q1.1
unnamed: R20.1, R24.2, T1.3 (G)
PA0_3V3: EXT.4, IC1.40 (PA0/ADCA0/AREF)
PA1_3V3: EXT.6, IC1.41 (PA1/ADCA1)
PA2_3V3: EXT.8, IC1.42 (PA2/ADCA2)
PA3_3V3: EXT.3, IC1.43 (PA3/ADCA3)
PC0_3V3: EXT.5, IC1.10 (PC0/OC0A/SDA)
PDI_DATA_3V3: IC1.34 (PDI), PROG.1 (DATA)
ROUT: C31.2, HP.3, IC5.15 (ROUT), R23.2
RX_3V3: IC1.12 (PC2/OC0C/RXD0), IC6.12 (R1OUT), R2.1, R11.2
RX_232: IC6.13 (R1IN), R11.1, UART.1 (RX_I)
RX_MP3_3V3: IC1.22 (RXD0/OC0C/PD2), R13.2, R16.1
TX_3V3: IC1.13 (PC3/OC0D/TXD0), IC6.10 (T2IN), IC6.11 (T1IN), R5.1, R12.2
TX_232: IC6.14 (T1OUT), R12.1, UART.4 (TX_O)
TX_MP3_3V3: IC1.23 (TXD0/OC0D/PD3), IC2.3 (A), R1.1
V+: C12.+, C13.+, C14.+, C16.1, C17.1, C18.1, C22.1, C23.1, C24.1, C25.1, EXT.1, IC5.1 (PVCCL), IC5.3 (PVCCL), IC5.10 (PVCCR), IC5.12 (PVCCR), IC5.19 (AVCC), IC5.20 (AVCC), IC7.IN+ (VIN), R25.2, T1.1 (D), T1.2 (D), T1.5 (D), T1.6 (D)
VBAT_0-2V: C8.1, IC1.6 (PB2/ADCA10), R8.1, R9.2
VCLAMP: C29.1, IC5.11 (VCLAMP)

Notes on the sheet:
BATTERY : 12-30V SUPPLY VOLTAGE
Use INTVCC as reference voltage of ADC
Resistor divider is calculated to output 2V when battery voltage is 31V
5V 3A SUPPLY
R26 must not be mounted in DOOR BELL system.
manque diode protection sur alim et switch
3V3 0.1A SUPPLY
25W (into 4 ohms load) audio amplifier
TODO : rotate DFPLAYER MINI by 180° add 1k resistor between IC2 and DFPLAYER MINI RX

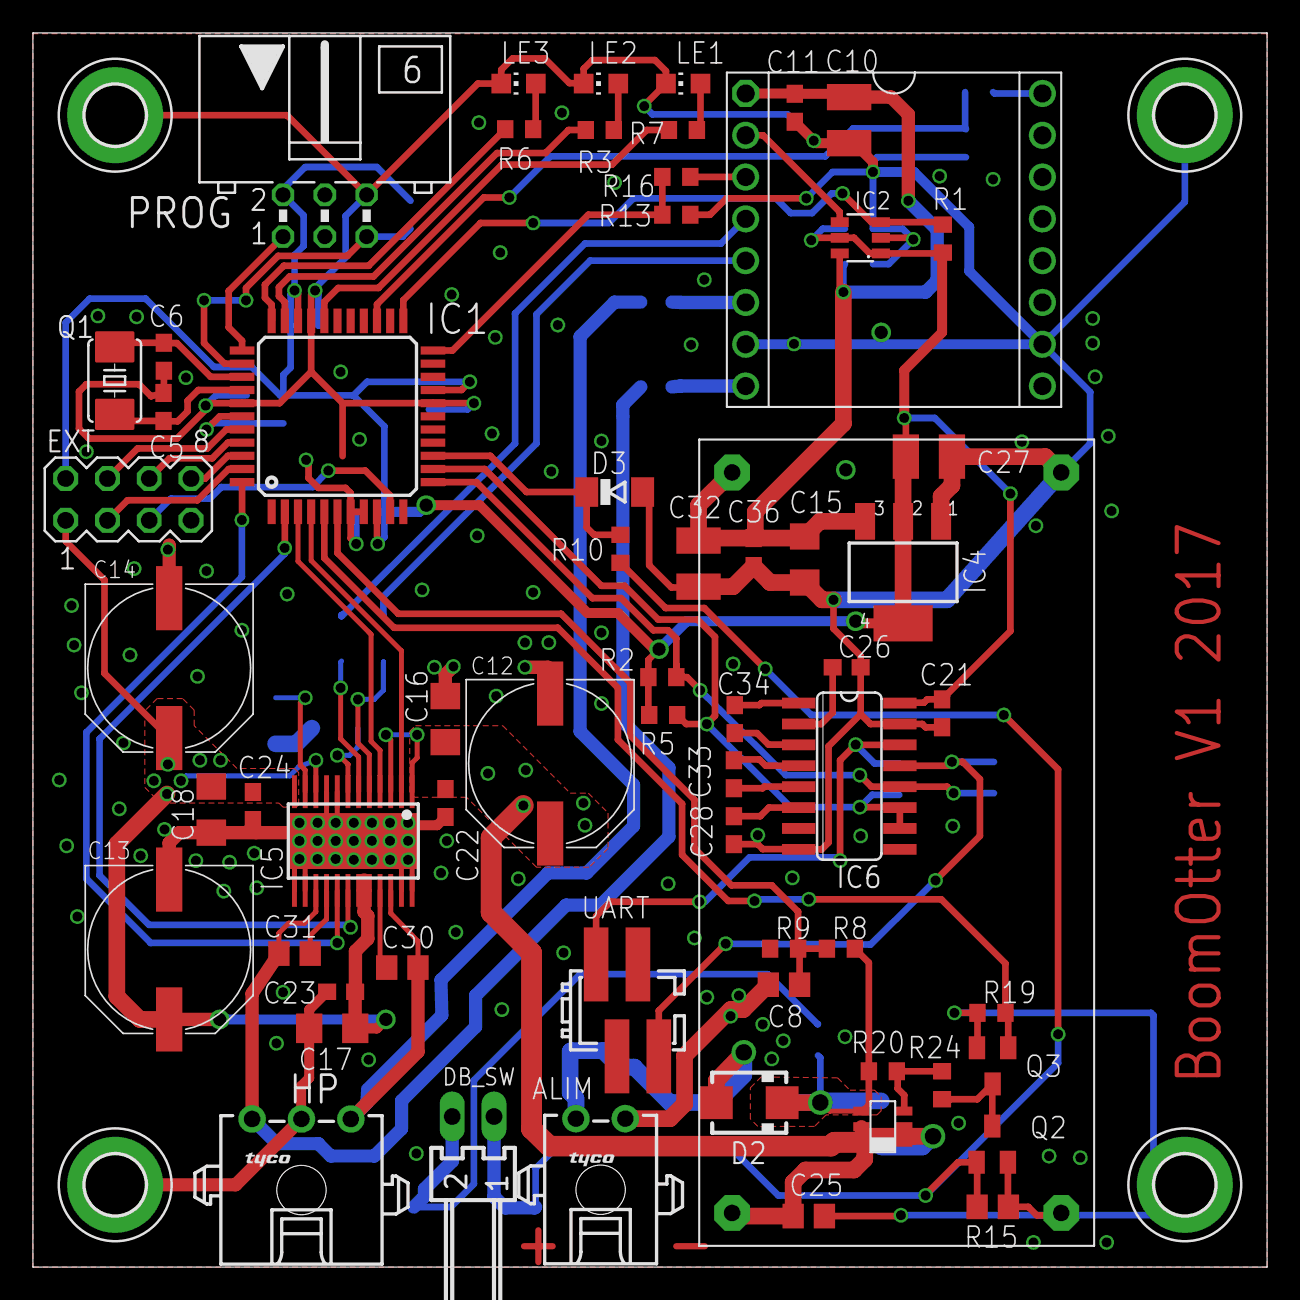
[picture p66: board BoomOtter.brd from above]

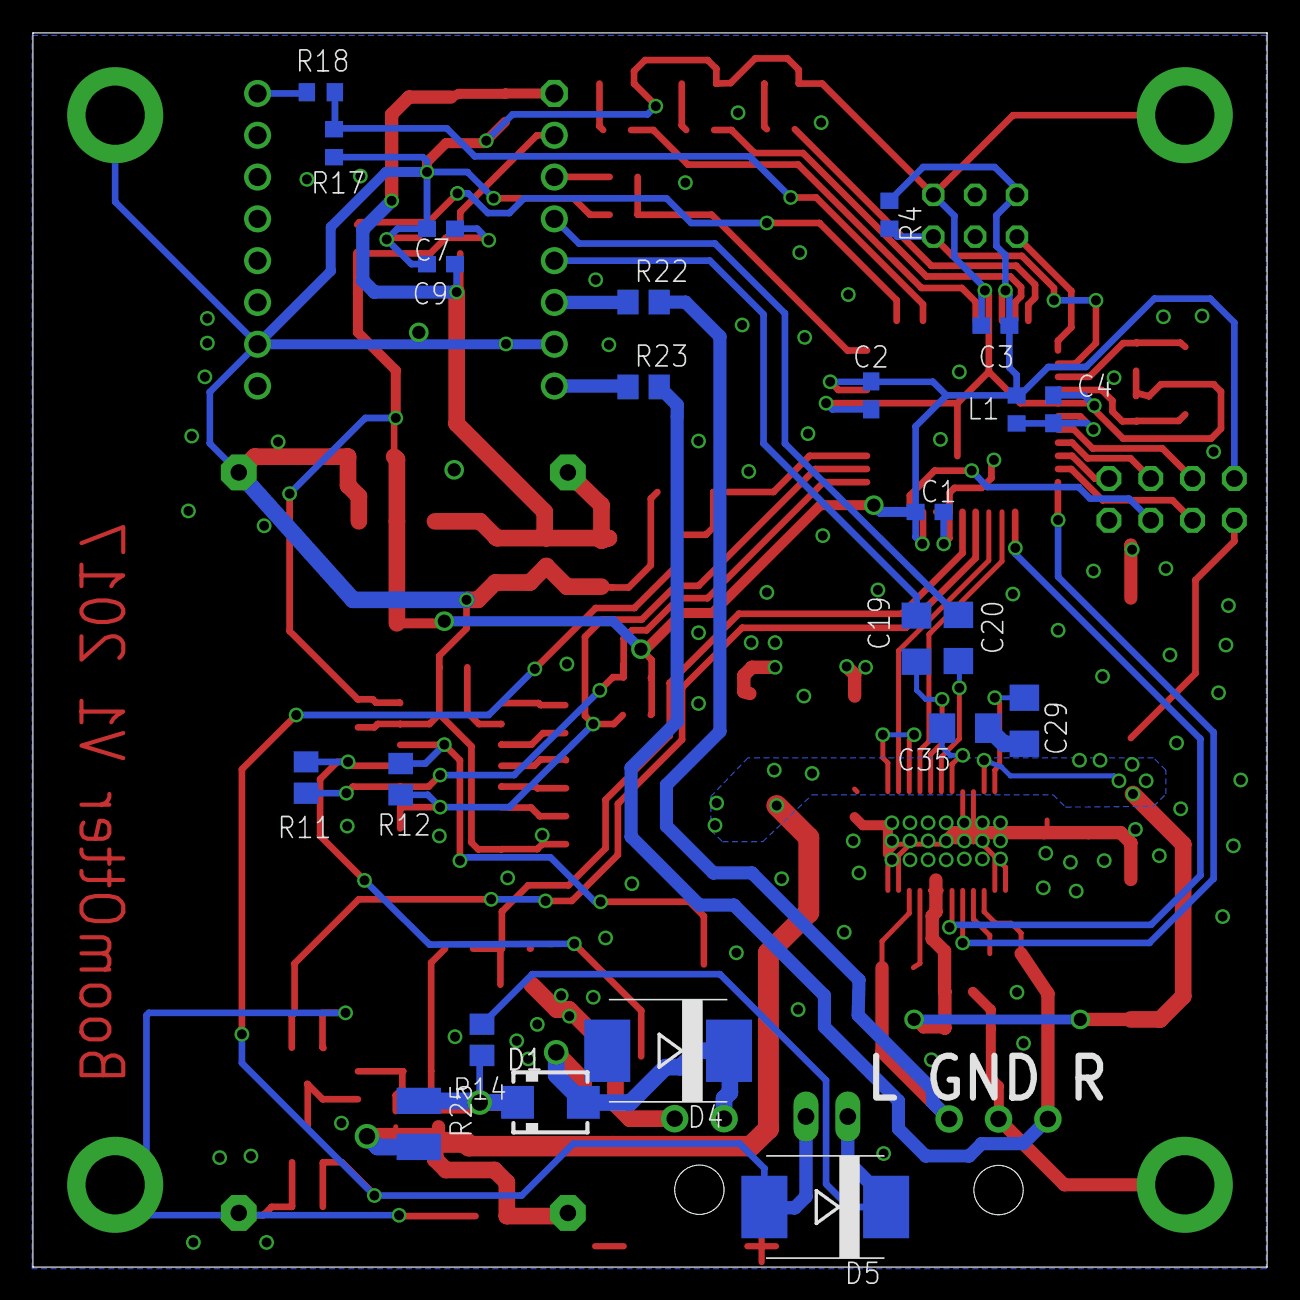
[picture p67: board BoomOtter.brd from below]

Board: 2 copper layers, 75.0 x 75.0 mm, 90 parts (23 on the bottom side), 61 nets.
