robotter/robotter/hardware/R3D2_long_range/R3D2_long_range.brd

## EAGLE design hardware/R3D2_long_range/R3D2_long_range.brd (2018-04-28)

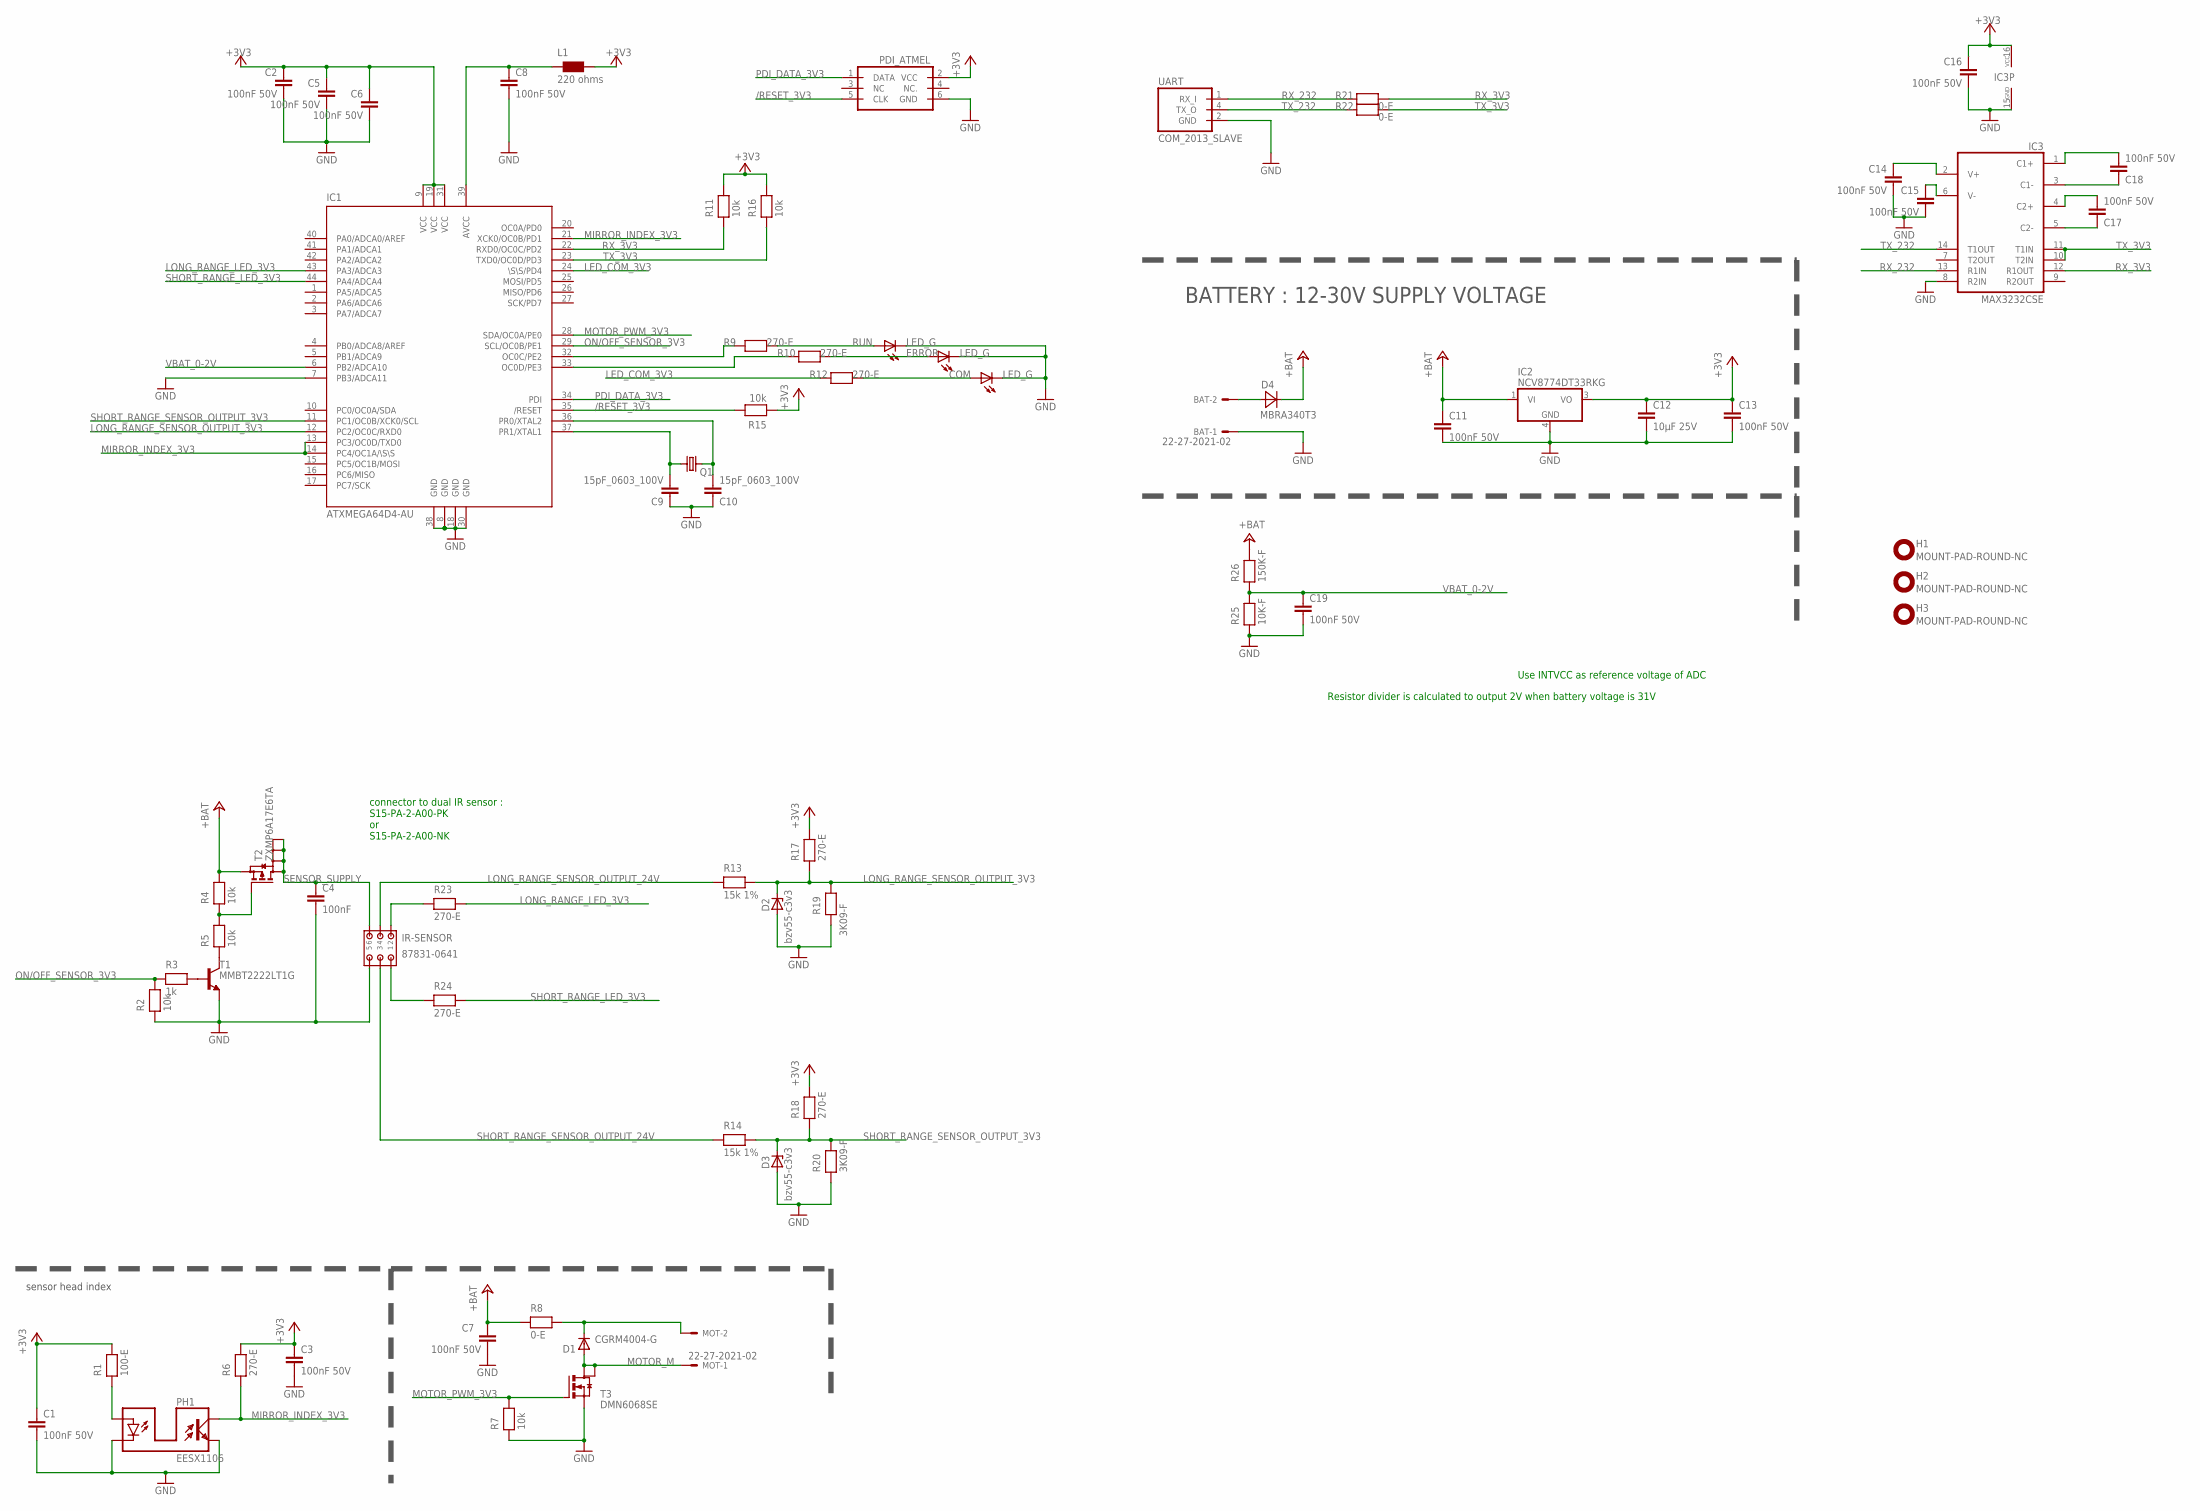
[picture p68: schematic R3D2_long_range.sch]

Parts:
BAT: 22-27-2021-02; 6410-02
C1, C2, C3, C5, C6, C7, C8, C13, C14, C15, C16, C17, C18: 100nF 50V; C0603
C4: 100nF; C0603
C9, C10: 15pF_0603_100V; C0603
C11, C19: 100nF 50V; C0805
C12: 10µF 25V; C1210
COM: LED_G; CHIP-LED0805
D1: CGRM4004-G; SOD-123_MINI-SMA
D2, D3: bzv55-c3v3; SOD80C
D4: MBRA340T3; SMA
ERROR: LED_G; CHIP-LED0805
H1, H2, H3: MOUNT-PAD-ROUND-NC; 3,0-PAD_NC
IC1: ATXMEGA64D4-AU; TQFP44
IC2: NCV8774DT33RKG; DPACK_3
IC3: MAX3232CSE; SO16
IR-SENSOR: 87831-0641
L1: 220 ohms; R0603
MOT: 22-27-2021-02; 6410-02
PDI_ATMEL: PDI_ATMELL; ML6L
PH1: EESX1106
Q1: CRYSTAL_16MHZ_5032; CRYSTAL_5032
R1: 100-E; R0805
R2, R4, R5, R7, R11, R15, R16: 10k; R0603
R3: 1k; R0603
R6, R9, R10, R12, R17, R18, R23, R24: 270-E; R0805
R8, R21, R22: 0-E; R0805
R13, R14: 15k 1%; R0603
R19, R20: 3K09-F; R0603
R25: 10K-F; R0603
R26: 150K-F; R0603
RUN: LED_G; CHIP-LED0805
T1: MMBT2222LT1G; SOT23-BEC
T2: ZXMP6A17E6TA; SOT26
T3: DMN6068SE; SOT223
UART: COM_2013_SLAVE; MICROMATCH-4_SMD

Connections:
+3V3: C1.1, C2.1, C3.1, C5.1, C6.1, C12.1, C13.1, C16.1, IC1.9 (VCC), IC1.19 (VCC), IC1.31 (VCC), IC2.3 (VO), IC3.16 (VCC), L1.2, PDI_ATMEL.2 (VCC), R1.2, R6.2, R11.2, R15.1, R16.2, R17.2, R18.2
+24V: C7.1, C11.1, D4.C, IC2.1 (VI), R4.2, R8.1, R26.2, T2.4 (S)
/RESET_3V3: IC1.35 (/RESET), PDI_ATMEL.5 (CLK), R15.2
GND: BAT.1, C1.2, C2.2, C3.2, C4.2, C5.2, C6.2, C7.2, C8.2, C9.1, C10.1, C11.2, C12.2, C13.2, C14.2, C15.2, C16.2, C19.2, COM.C, D2.A, D3.A, ERROR.C, IC1.7 (PB3/ADCA11), IC1.8 (GND), IC1.18 (GND), IC1.30 (GND), IC1.38 (GND), IC2.4 (GND), IC3.8 (R2IN), IC3.15 (GND), IR-SENSOR.5, PDI_ATMEL.6 (GND), PH1.E (TRANSISTOR_E), PH1.K (LED_C), R2.1, R7.1, R19.1, R20.1, R25.1, RUN.C, T1.E, T3.3 (S), UART.2 (GND)
LED_COM_3V3: IC1.24 (\S\S/PD4), R12.1
LONG_RANGE_LED_3V3: IC1.43 (PA3/ADCA3), R23.2
LONG_RANGE_SENSOR_OUTPUT_3V3: D2.C, IC1.12 (PC2/OC0C/RXD0), R13.2, R17.1, R19.2
LONG_RANGE_SENSOR_OUTPUT_24V: IR-SENSOR.4, R13.1
MIRROR_INDEX_3V3: IC1.13 (PC3/OC0D/TXD0), IC1.14 (PC4/OC1A/\S\S), IC1.21 (XCK0/OC0B/PD1), PH1.C (TRANSISTOR_C), R6.1
MOTOR_M: D1.A, MOT.1, T3.2 (D), T3.4 (D)
MOTOR_PWM_3V3: IC1.28 (SDA/OC0A/PE0), R7.2, T3.1 (G)
unnamed: C18.1, IC3.1 (C1+)
unnamed: R9.2, RUN.A
unnamed: D1.C, MOT.2, R8.2
unnamed: ERROR.A, R10.2
unnamed: C18.2, IC3.3 (C1-)
unnamed: C17.1, IC3.4 (C2+)
unnamed: COM.A, R12.2
unnamed: BAT.2, D4.A
unnamed: IC1.32 (OC0C/PE2), R9.1
unnamed: IC1.33 (OC0D/PE3), R10.1
unnamed: C14.1, IC3.2 (V+)
unnamed: C15.1, IC3.6 (V-)
unnamed: C10.2, IC1.36 (PR0/XTAL2), Q1.2
unnamed: PH1.A (LED_A), R1.1
unnamed: C8.1, IC1.39 (AVCC), L1.1
unnamed: IR-SENSOR.2, R23.1
unnamed: IR-SENSOR.1, R24.1
unnamed: C17.2, IC3.5 (C2-)
unnamed: C9.2, IC1.37 (PR1/XTAL1), Q1.1
unnamed: R3.2, T1.B
unnamed: R5.1, T1.C
unnamed: R4.1, R5.2, T2.3 (G)
ON/OFF_SENSOR_3V3: IC1.29 (SCL/OC0B/PE1), R2.2, R3.1
PDI_DATA_3V3: IC1.34 (PDI), PDI_ATMEL.1 (DATA)
RX_3V3: IC1.22 (RXD0/OC0C/PD2), IC3.12 (R1OUT), R11.1, R21.2
RX_232: IC3.13 (R1IN), R21.1, UART.1 (RX_I)
SENSOR_SUPPLY: C4.1, IR-SENSOR.6, T2.1 (D), T2.2 (D), T2.5 (D), T2.6 (D)
SHORT_RANGE_LED_3V3: IC1.44 (PA4/ADCA4), R24.2
SHORT_RANGE_SENSOR_OUTPUT_3V3: D3.C, IC1.11 (PC1/OC0B/XCK0/SCL), R14.2, R18.1, R20.2
SHORT_RANGE_SENSOR_OUTPUT_24V: IR-SENSOR.3, R14.1
TX_3V3: IC1.23 (TXD0/OC0D/PD3), IC3.10 (T2IN), IC3.11 (T1IN), R16.1, R22.2
TX_232: IC3.14 (T1OUT), R22.1, UART.4 (TX_O)
VBAT_0-2V: C19.1, IC1.6 (PB2/ADCA10), R25.2, R26.1

Notes on the sheet:
sensor head index
connector to dual IR sensor : S15-PA-2-A00-PK or S15-PA-2-A00-NK
BATTERY : 12-30V SUPPLY VOLTAGE
Use INTVCC as reference voltage of ADC
Resistor divider is calculated to output 2V when battery voltage is 31V

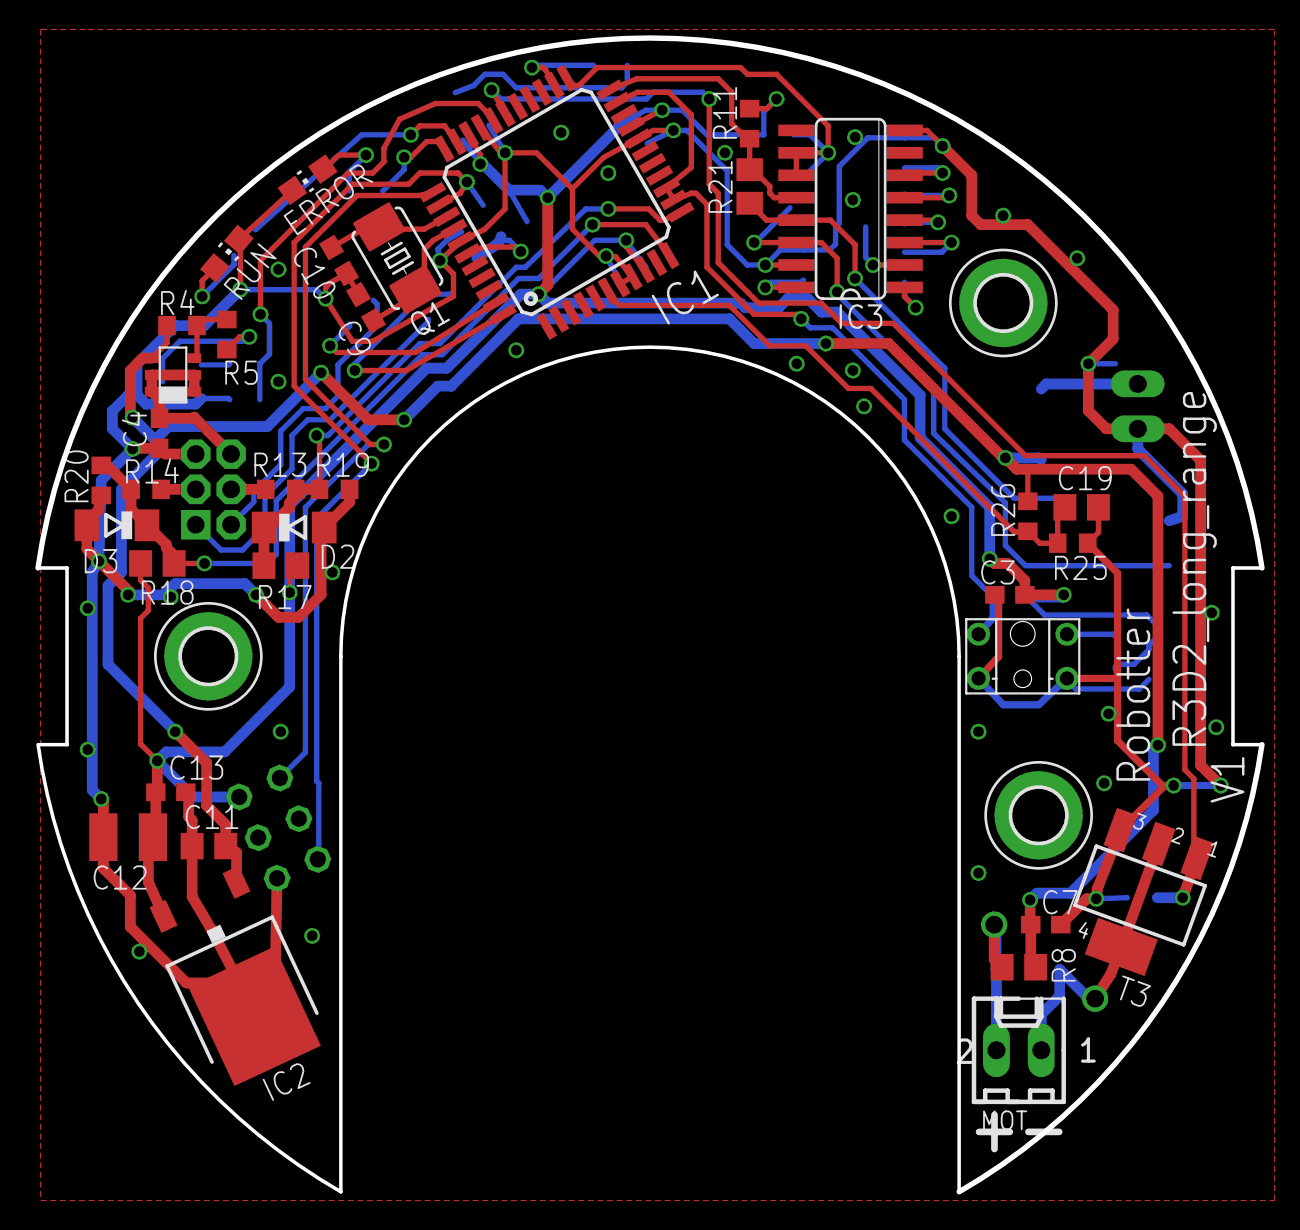
[picture p69: board R3D2_long_range.brd from above]

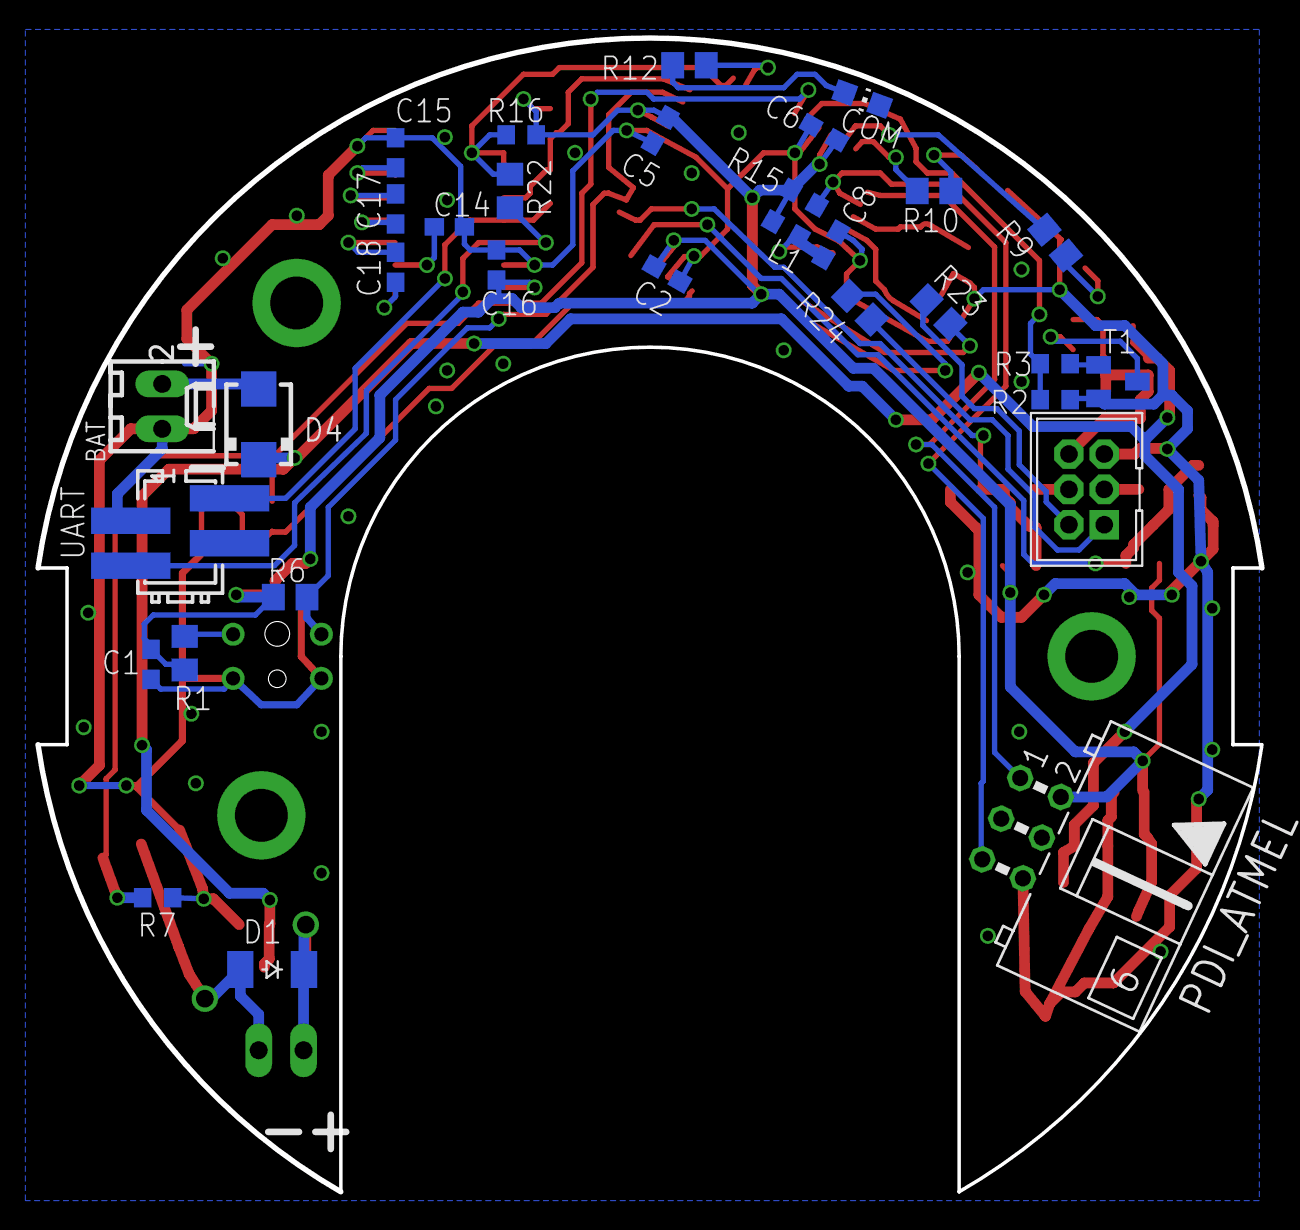
[picture p70: board R3D2_long_range.brd from below]

Board: 2 copper layers, 69.3 x 65.3 mm, 69 parts (32 on the bottom side), 44 nets.
