robotter/robotter/hardware/color_proximity_sensor/color_proximity_sensor.brd

## EAGLE design hardware/color_proximity_sensor/color_proximity_sensor.brd (2018-04-28)

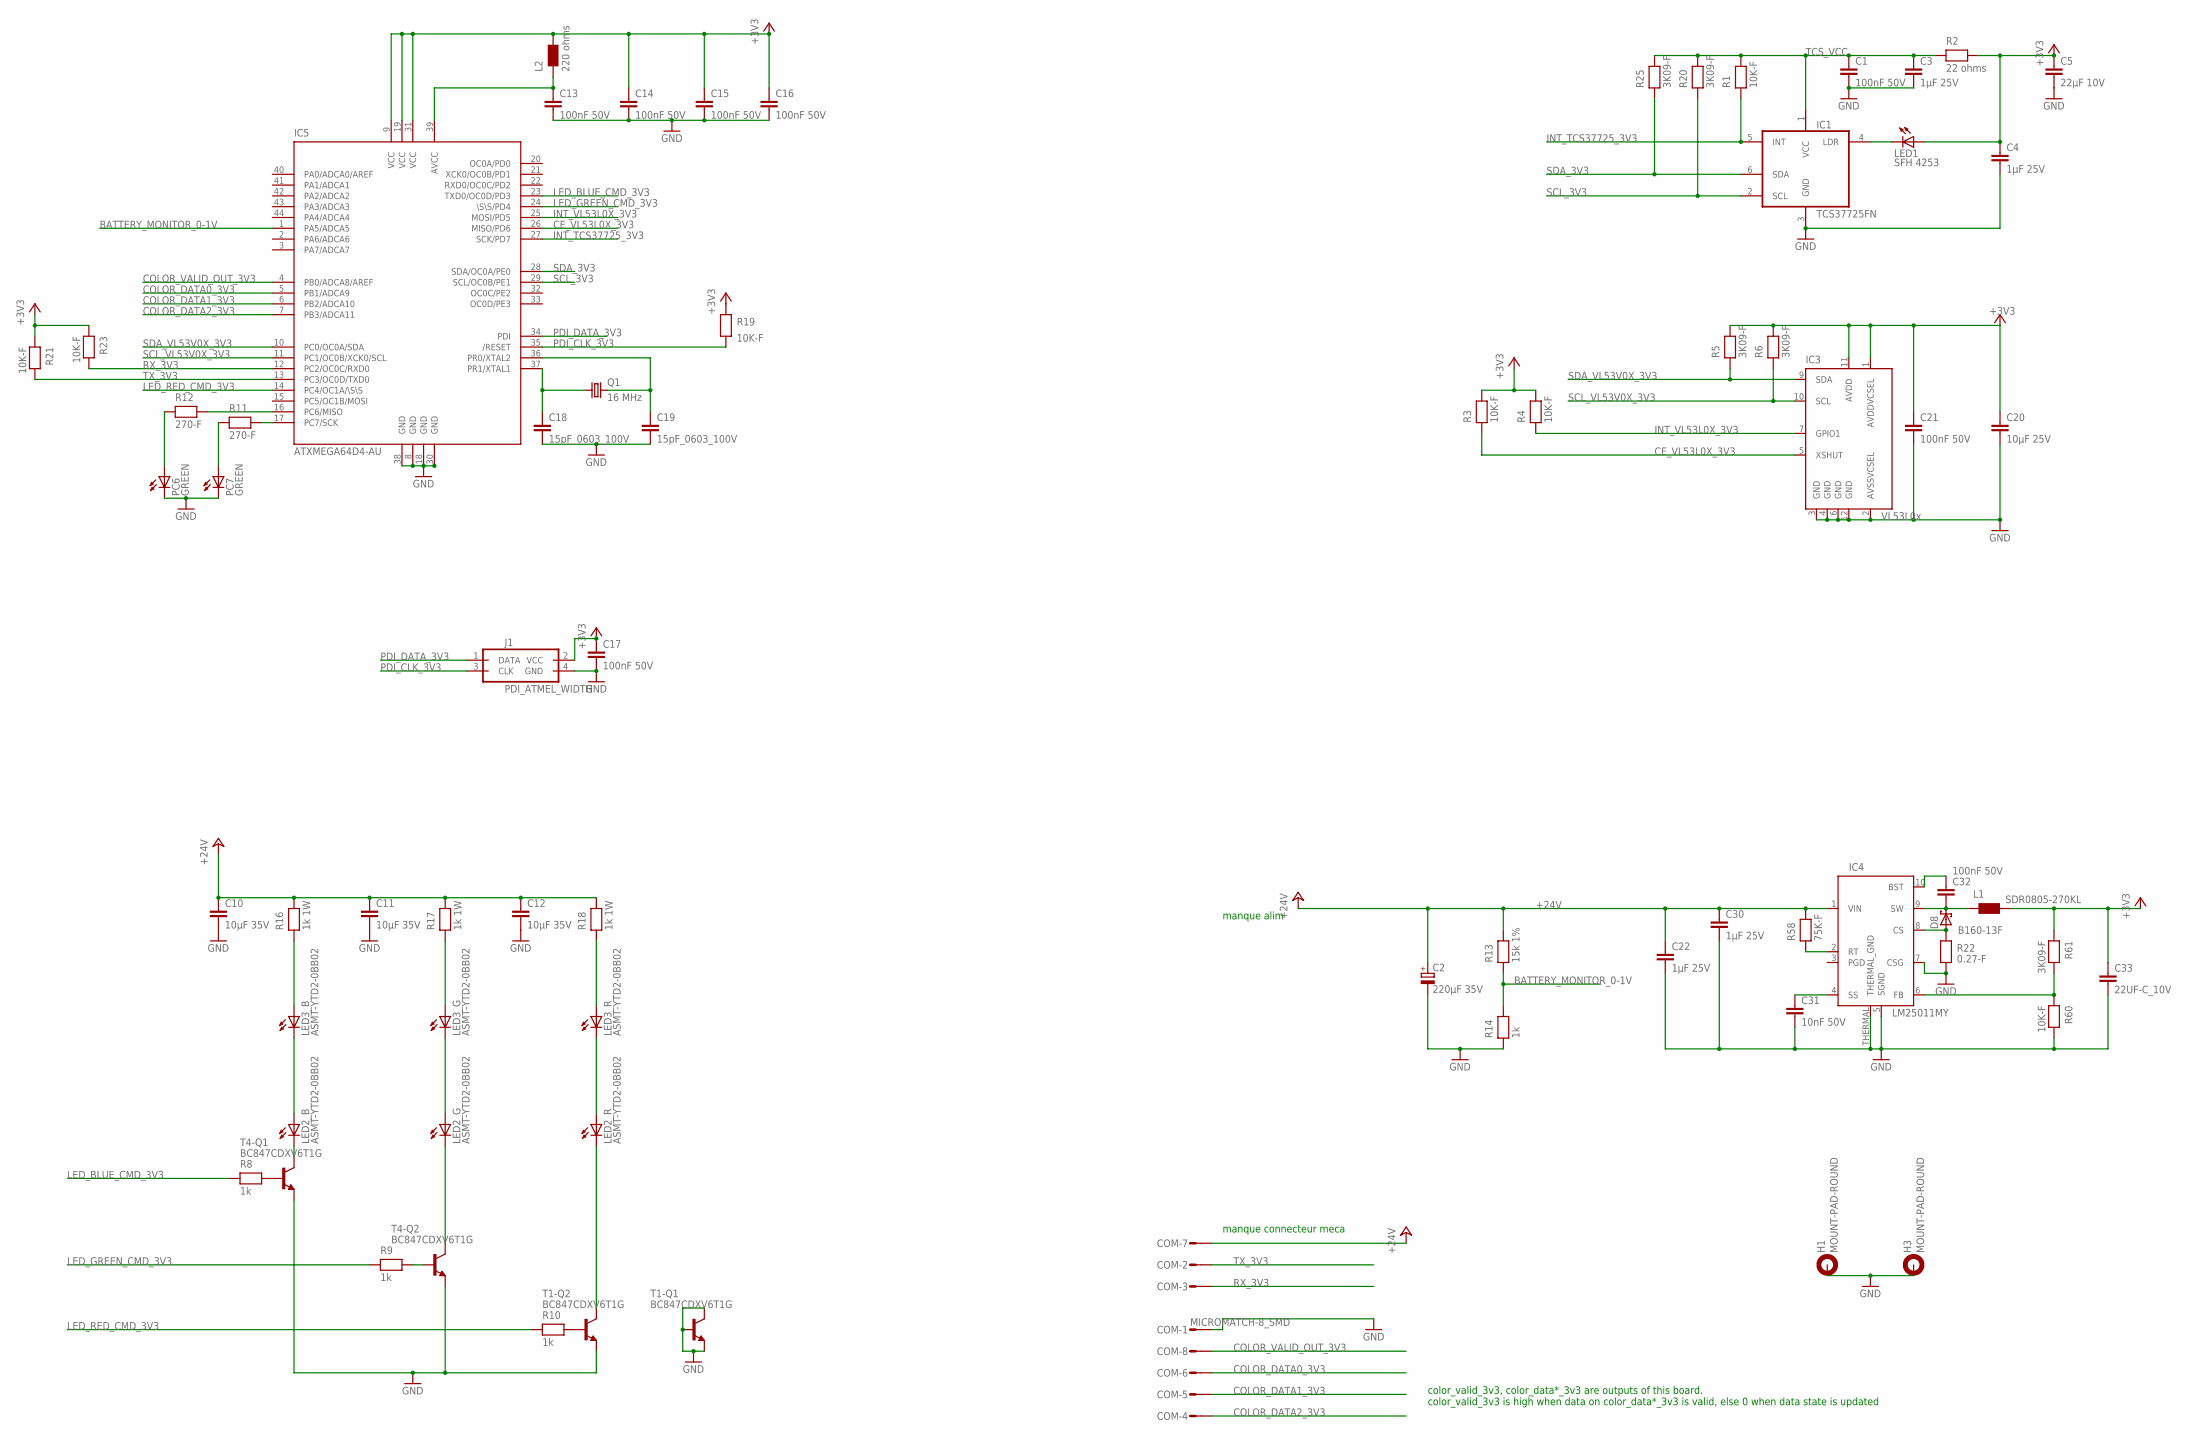
[picture p71: schematic color_proximity_sensor.sch]

Parts:
C1, C13, C14, C15, C16, C17, C21, C32: 100nF 50V; C0603
C2: 220µF 35V; PANASONIC_F
C3, C4, C22, C30: 1µF 25V; C1206
C5: 22µF 10V; C1210
C10, C11, C12: 10µF 35V; C1210
C18, C19: 15pF_0603_100V; C0603
C20: 10µF 25V; C1210
C31: 10nF 50V; C0603
C33: 22UF-C_10V; C1210
COM: MICROMATCH-8_SMD
D8: B160-13F; SMA
H1, H3: MOUNT-PAD-ROUND; 2,1-PAD
IC1: TCS37725FN; FN6
IC3: VL53L0x; LGA12
IC4: LM25011MY; MSOP10_THERMAL
IC5: ATXMEGA64D4-AU; TQFP44
J1: PDI_ATMEL_WIDTH; HEADER_2.54MM_2X2W_
L1: SDR0805-270KL; SDR0805
L2: 220 ohms; R0603
LED1: SFH 4253; SFH4253
LED2, LED3: ASMT-YTD2-0BB02; PLCC6
PC6, PC7: GREEN; CHIP-LED0805
Q1: 16 MHz; HC49UP
R1, R3, R4, R19, R21, R23, R60: 10K-F; R0603
R2: 22 ohms; R0603
R5, R6, R20, R25, R61: 3K09-F; R0603
R8, R9, R10: 1k; R0603
R11, R12: 270-F; R0603
R13: 15k 1%; R0805
R14: 1k; R0805
R16, R17, R18: 1k 1W; R2512
R22: 0.27-F; R0603
R58: 75K-F; R0603
T1, T4: BC847CDXV6T1G; SOT563-6

Connections:
+3V3: C4.1, C5.1, C14.1, C15.1, C16.1, C17.1, C20.1, C21.1, C33.1, IC3.1 (AVDDVCSEL), IC3.11 (AVDD), IC5.9 (VCC), IC5.19 (VCC), IC5.31 (VCC), J1.2 (VCC), L1.2, L2.2, LED1.A, R2.2, R3.2, R4.2, R5.2, R6.2, R19.2, R21.1, R23.1, R61.1
+24V: C2.+, C10.1, C11.1, C12.1, C22.1, C30.1, COM.7, IC4.1 (VIN), R13.2, R16.2, R17.2, R18.2, R58.2
BATTERY_MONITOR_0-1V: IC5.1 (PA5/ADCA5), R13.1, R14.2
CE_VL53L0X_3V3: IC3.5 (XSHUT), IC5.26 (MISO/PD6), R3.1
COLOR_DATA0_3V3: COM.6, IC5.5 (PB1/ADCA9)
COLOR_DATA1_3V3: COM.5, IC5.6 (PB2/ADCA10)
COLOR_DATA2_3V3: COM.4, IC5.7 (PB3/ADCA11)
COLOR_VALID_OUT_3V3: COM.8, IC5.4 (PB0/ADCA8/AREF)
GND: C1.2, C2.-, C3.2, C4.2, C5.2, C10.2, C11.2, C12.2, C13.2, C14.2, C15.2, C16.2, C17.2, C18.2, C19.2, C20.2, C21.2, C22.2, C30.2, C31.2, C33.2, COM.1, H1.B2,8, H3.B2,8, IC1.3 (GND), IC3.2 (AVSSVCSEL), IC3.3 (GND), IC3.4 (GND), IC3.6 (GND), IC3.12 (GND), IC4.5 (SGND), IC4.7 (CSG), IC4.THERMAL (THERMAL_GND), IC5.8 (GND), IC5.18 (GND), IC5.30 (GND), IC5.38 (GND), J1.4 (GND), PC6.C, PC7.C, R14.1, R22.1, R60.2, T1.1 (E), T1.3 (C), T1.4 (E), T1.5 (B), T4.1 (E), T4.4 (E)
INT_TCS37725_3V3: IC1.5 (INT), IC5.27 (SCK/PD7), R1.1
INT_VL53L0X_3V3: IC3.7 (GPIO1), IC5.25 (MOSI/PD5), R4.1
LED_BLUE_CMD_3V3: IC5.23 (TXD0/OC0D/PD3), R8.1
LED_GREEN_CMD_3V3: IC5.24 (\S\S/PD4), R9.1
LED_RED_CMD_3V3: IC5.14 (PC4/OC1A/\S\S), R10.1
unnamed: R8.2, T4.5 (B)
unnamed: R9.2, T4.2 (B)
unnamed: IC1.4 (LDR), LED1.C
unnamed: R10.2, T1.2 (B)
unnamed: LED3.4 (A), R18.1
unnamed: LED2.2 (C), T4.6 (C)
unnamed: LED2.3 (C), T1.6 (C)
unnamed: LED2.1 (C), T4.3 (C)
unnamed: LED2.6 (A), LED3.1 (C)
unnamed: LED3.5 (A), R17.1
unnamed: LED3.6 (A), R16.1
unnamed: IC5.17 (PC7/SCK), R11.2
unnamed: LED2.5 (A), LED3.2 (C)
unnamed: LED2.4 (A), LED3.3 (C)
unnamed: IC5.16 (PC6/MISO), R12.2
unnamed: C13.1, IC5.39 (AVCC), L2.1
unnamed: C18.1, IC5.37 (PR1/XTAL1), Q1.1
unnamed: C19.1, IC5.36 (PR0/XTAL2), Q1.2
unnamed: PC7.A, R11.1
unnamed: PC6.A, R12.1
unnamed: C32.2, D8.C, IC4.9 (SW), L1.1
unnamed: D8.A, IC4.8 (CS), R22.2
unnamed: IC4.2 (RT), R58.1
unnamed: C31.1, IC4.4 (SS)
unnamed: IC4.6 (FB), R60.1, R61.2
unnamed: C32.1, IC4.10 (BST)
PDI_CLK_3V3: IC5.35 (/RESET), J1.3 (CLK), R19.1
PDI_DATA_3V3: IC5.34 (PDI), J1.1 (DATA)
RX_3V3: COM.3, IC5.12 (PC2/OC0C/RXD0), R23.2
SCL_3V3: IC1.2 (SCL), IC5.29 (SCL/OC0B/PE1), R20.1
SCL_VL53V0X_3V3: IC3.10 (SCL), IC5.11 (PC1/OC0B/XCK0/SCL), R6.1
SDA_3V3: IC1.6 (SDA), IC5.28 (SDA/OC0A/PE0), R25.1
SDA_VL53V0X_3V3: IC3.9 (SDA), IC5.10 (PC0/OC0A/SDA), R5.1
TCS_VCC: C1.1, C3.1, IC1.1 (VCC), R1.2, R2.1, R20.2, R25.2
TX_3V3: COM.2, IC5.13 (PC3/OC0D/TXD0), R21.2

Notes on the sheet:
manque alim
manque connecteur meca
color_valid_3v3, color_data*_3v3 are outputs of this board. color_valid_3v3 is high when data on color_data*_3v3 is valid, else 0 when data state is updated

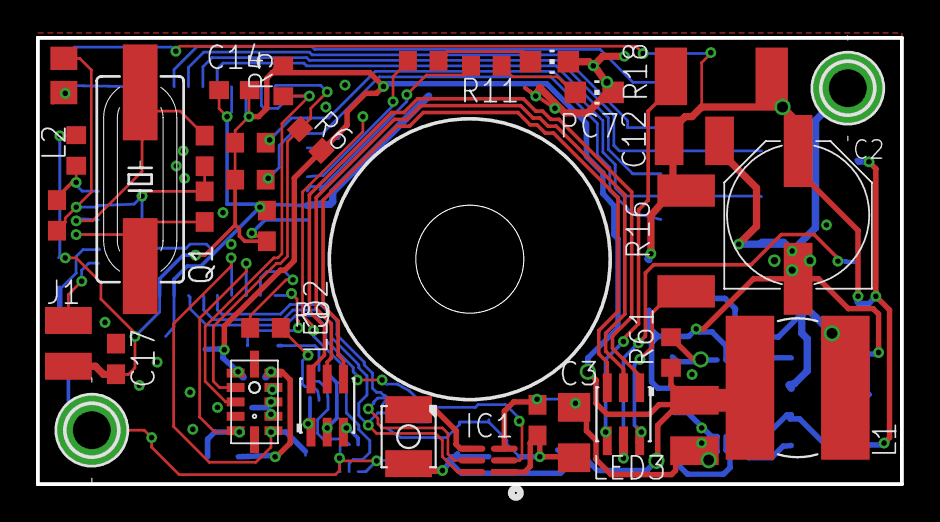
[picture p72: board color_proximity_sensor.brd from above]

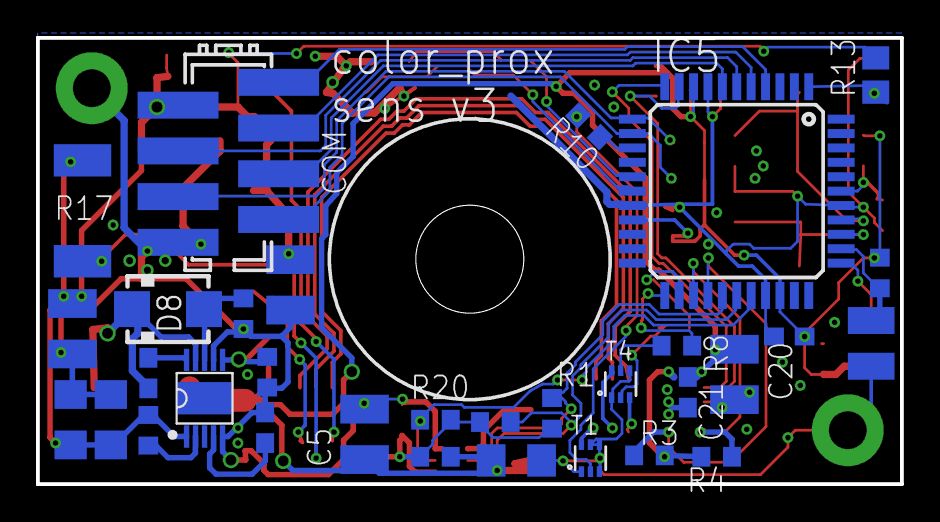
[picture p73: board color_proximity_sensor.brd from below]

Board: 2 copper layers, 48.0 x 24.8 mm, 66 parts (31 on the bottom side), 49 nets.
