robotter/robotter/hardware/sabotter/sabotter.brd

## EAGLE design hardware/sabotter/sabotter.brd (2018-04-28)

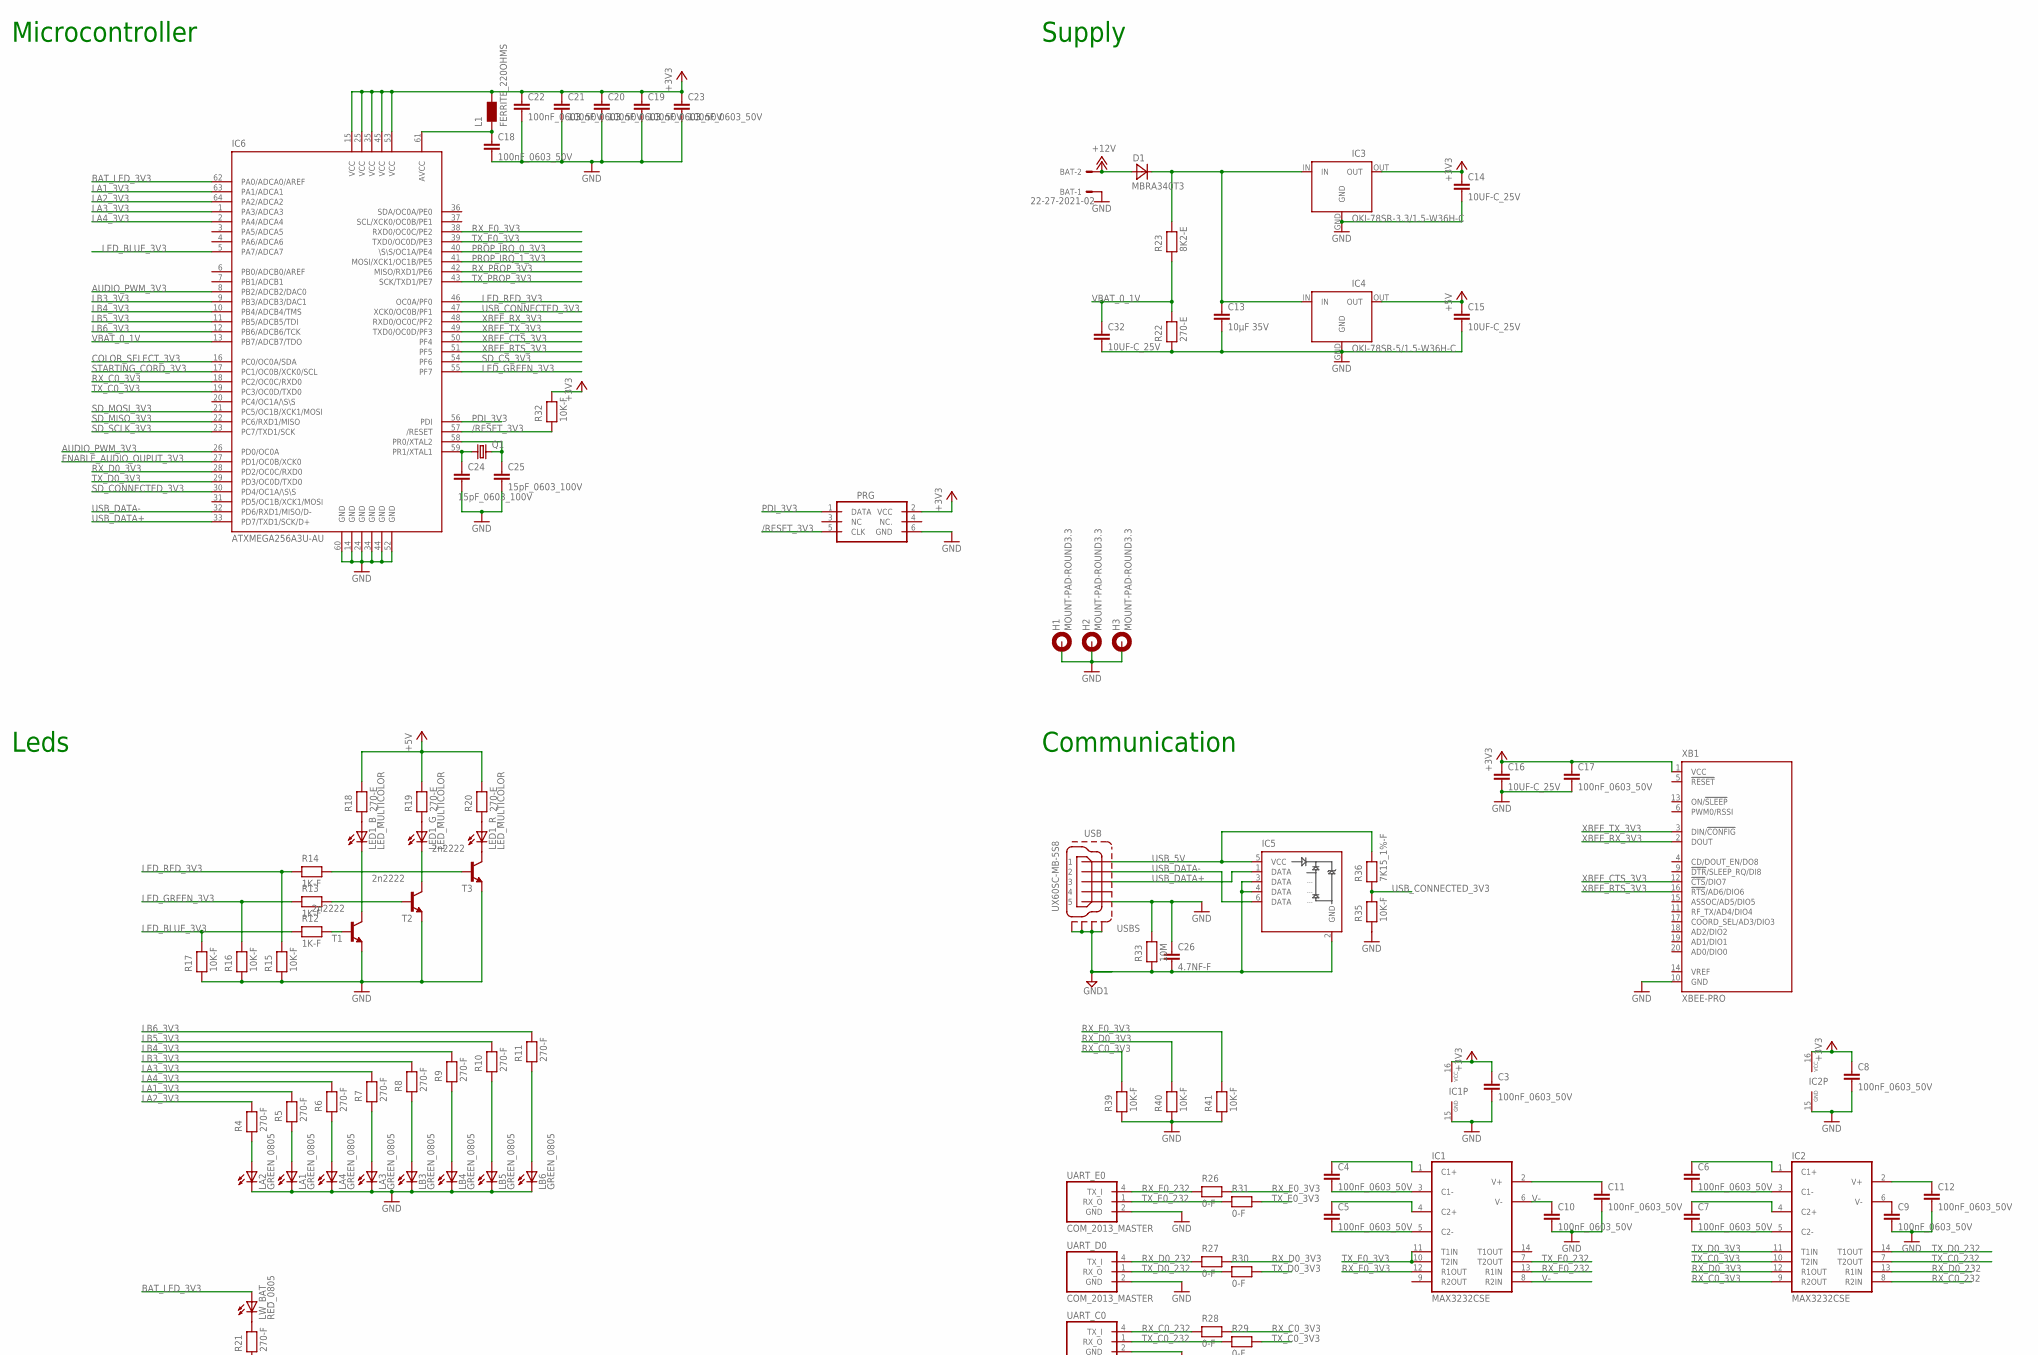
[picture p74: schematic sabotter.sch, part in row 1, column 1]

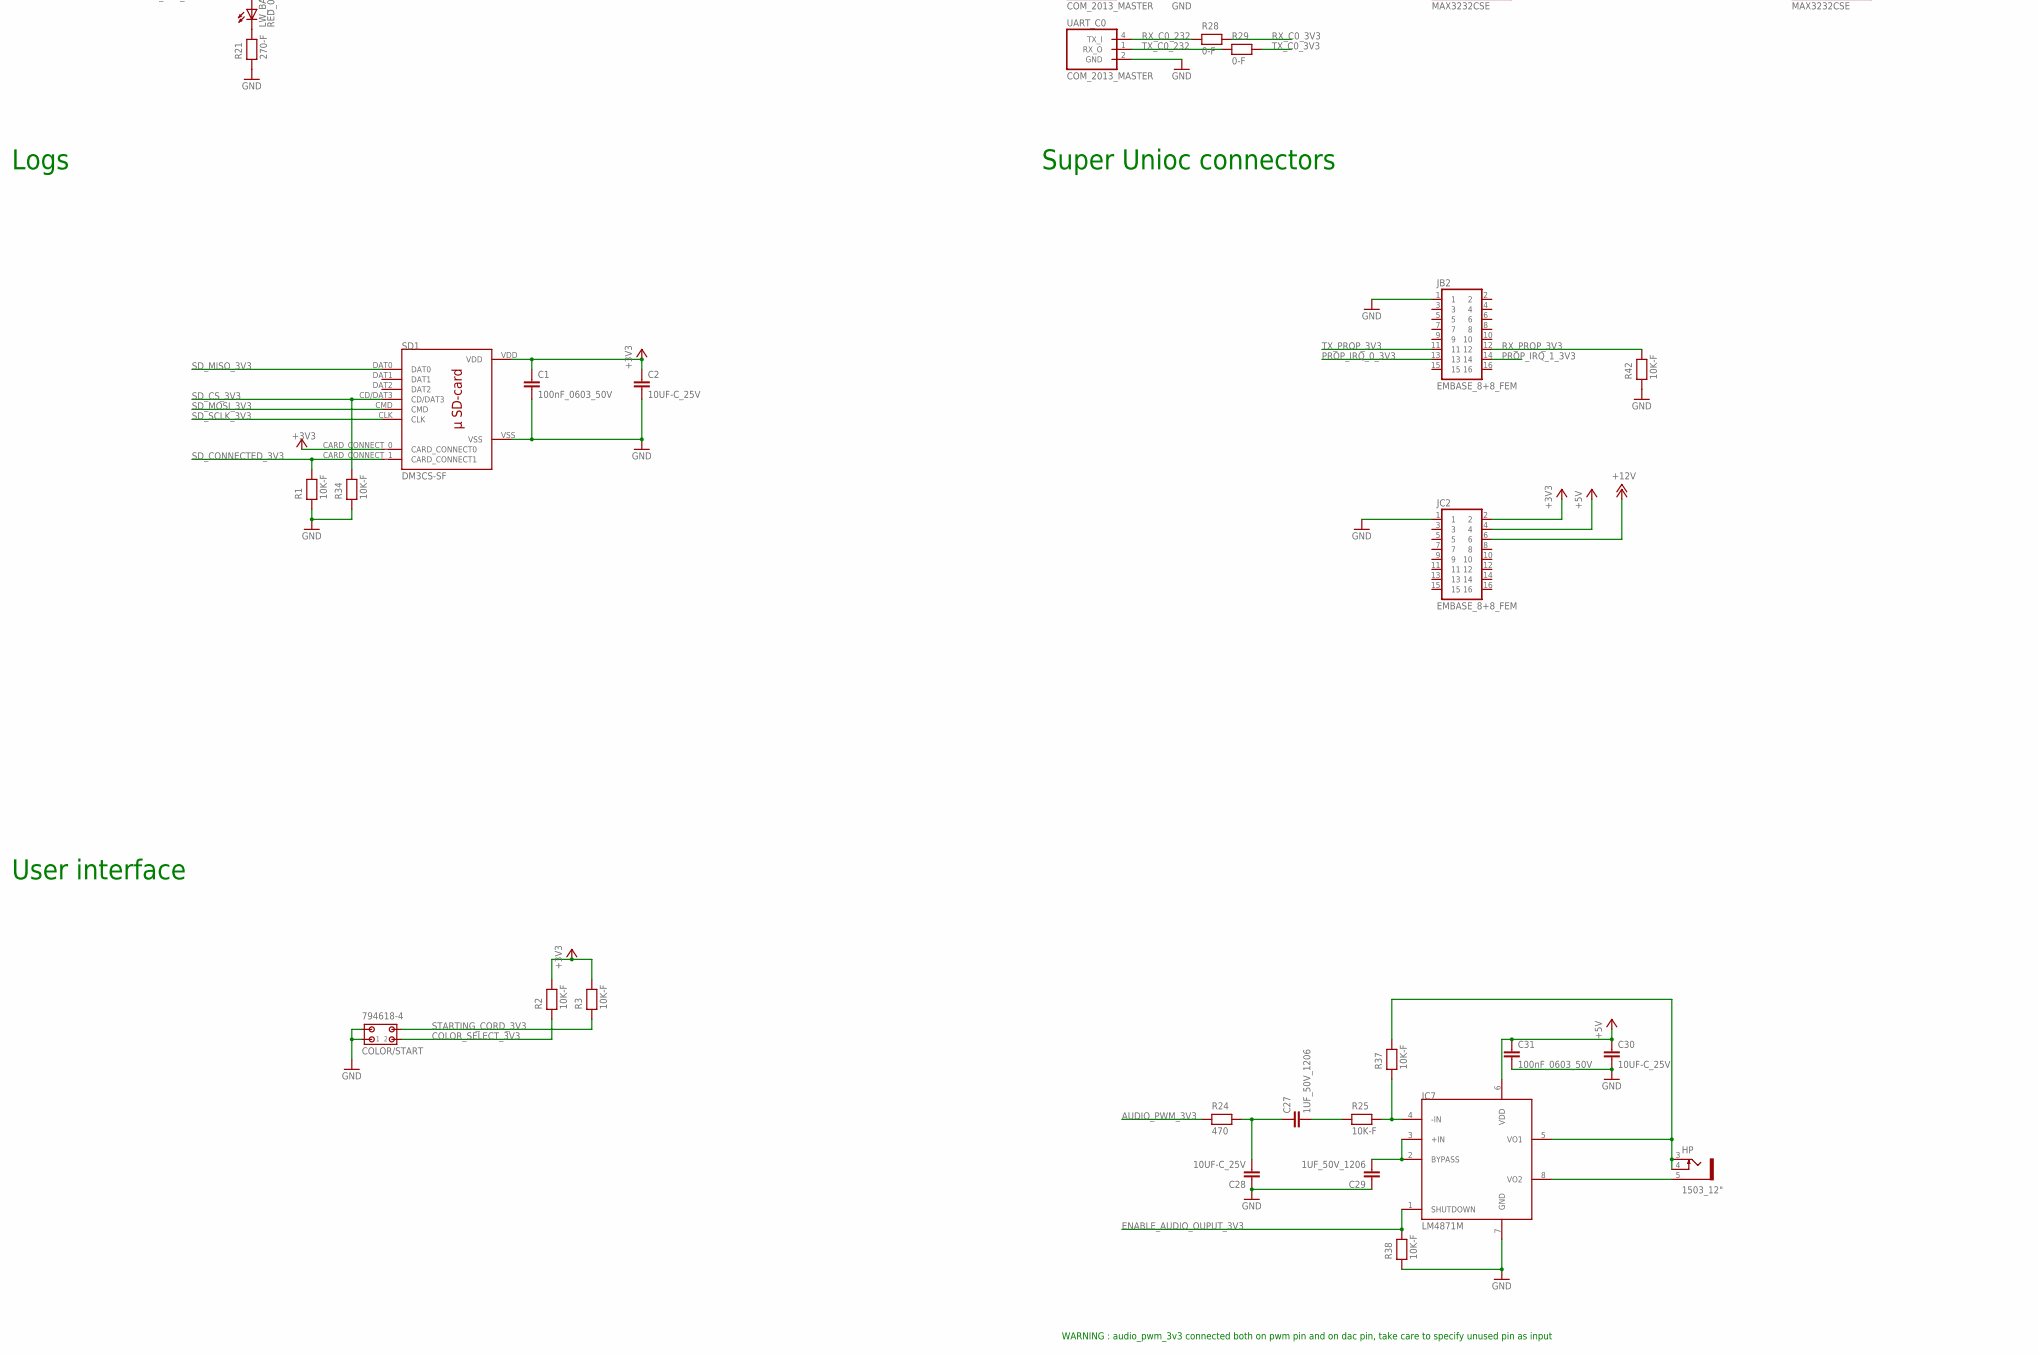
[picture p75: schematic sabotter.sch, part in row 2, column 1]

Parts:
BAT: 22-27-2021-02; 6410-02
C1, C3, C4, C5, C6, C7, C8, C9, C10, C11, C12, C17, C18, C19, C20, C21, C22, C23, C31: 100nF_0603_50V; C0603
C2, C14, C15, C16, C28, C30, C32: 10UF-C_25V; C1210
C13: 10µF 35V; C1210
C24, C25: 15pF_0603_100V; C0603
C26: 4.7NF-F; C0603
C27, C29: 1UF_50V_1206; C1206
COLOR/START: 794618-4
D1: MBRA340T3; SMA
H1, H2, H3: MOUNT-PAD-ROUND3.3; 3,3-PAD
HP: 1503_12"; 1503_12
IC1, IC2: MAX3232CSE; SO16
IC3: OKI-78SR-3.3/1.5-W36H-C; OKI78SR-HORIZONTAL
IC4: OKI-78SR-5/1.5-W36H-C; OKI78SR-HORIZONTAL
IC5: LXES2SBAA4-016; LXES2BAA4
IC6: ATXMEGA256A3U-AU; TQFP64
IC7: LM4871M; SO8
JB2: EMBASE_8+8_FEM
JC2: EMBASE_8+8_FEM
L1: FERRITE_220OHMS; R0603
LA1, LA2, LA3, LA4: GREEN_0805; CHIP-LED0805
LB3, LB4, LB5, LB6: GREEN_0805; CHIP-LED0805
LED1: LED_MULTICOLOR; PLCC6
LW_BAT: RED_0805; CHIP-LED0805
PRG: PDI_ATMELL; ML6L
Q1: CRYSTAL_16MHZ_HC49UP; HC49UP
R1, R2, R3, R15, R16, R17, R25, R32, R34, R35, R37, R38, R39, R40, R41, R42: 10K-F; R0603
R4, R5, R6, R7, R8, R9, R10, R11, R21: 270-F; R0603
R12, R13, R14: 1K-F; R0603
R18, R19, R20, R22: 270-E; R0805
R23: 8K2-E; R0805
R24: 470; R0603
R26, R27, R28, R29, R30, R31: 0-F; R0603
R33: 10M; R0603
R36: 7K15_1%-F; R0603
SD1: DM3CS-SF
T1, T2, T3: 2n2222; SOT23-BEC
UART_C0: COM_2013_MASTER; MICROMATCH-4_SMD
UART_D0: COM_2013_MASTER; MICROMATCH-4_SMD
UART_E0: COM_2013_MASTER; MICROMATCH-4_SMD
USB: UX60SC-MB-5S8; UX60-MB-5S8
XB1: XBEE-PRO

Connections:
+3V3: C1.1, C2.1, C3.1, C8.1, C14.1, C16.1, C17.1, C19.1, C20.1, C21.1, C22.1, C23.1, IC1.16 (VCC), IC2.16 (VCC), IC3.OUT, IC6.15 (VCC), IC6.25 (VCC), IC6.35 (VCC), IC6.45 (VCC), IC6.53 (VCC), JC2.2, L1.2, PRG.2 (VCC), R2.2, R3.2, R32.2, SD1.CARD_CONNECT_0 (CARD_CONNECT0), SD1.VDD, XB1.1 (VCC)
+5V: C15.1, C30.1, C31.1, IC4.OUT, IC7.6 (VDD), JC2.4, R18.2, R19.2, R20.2
+12V: BAT.2, D1.A, JC2.6
/RESET_3V3: IC6.57 (/RESET), PRG.5 (CLK), R32.1
AUDIO_PWM_3V3: IC6.8 (PB2/ADCB2/DAC0), IC6.26 (PD0/OC0A), R24.1
BAT_LED_3V3: IC6.62 (PA0/ADCA0/AREF), LW_BAT.A
COLOR_SELECT_3V3: COLOR/START.2, IC6.16 (PC0/OC0A/SDA), R2.1
ENABLE_AUDIO_OUPUT_3V3: IC6.27 (PD1/OC0B/XCK0), IC7.1 (SHUTDOWN), R38.2
GND: BAT.1, C1.2, C2.2, C3.2, C8.2, C9.2, C10.2, C11.2, C12.2, C13.2, C14.2, C15.2, C16.2, C17.2, C18.2, C19.2, C20.2, C21.2, C22.2, C23.2, C24.2, C25.2, C26.1, C28.1, C29.1, C30.2, C31.2, C32.2, COLOR/START.1, COLOR/START.3, H1.B3,3, H2.B3,3, H3.B3,3, IC1.15 (GND), IC2.15 (GND), IC3.GND, IC4.GND, IC6.14 (GND), IC6.24 (GND), IC6.34 (GND), IC6.44 (GND), IC6.52 (GND), IC6.60 (GND), IC7.7 (GND), JB2.1, JC2.1, LA1.C, LA2.C, LA3.C, LA4.C, LB3.C, LB4.C, LB5.C, LB6.C, PRG.6 (GND), R1.1, R15.1, R16.1, R17.1, R21.1, R22.1, R33.2, R34.1, R35.1, R38.1, R39.1, R40.1, R41.1, R42.1, SD1.VSS, T1.E, T2.E, T3.E, UART_C0.2 (GND), UART_D0.2 (GND), UART_E0.2 (GND), USB.5, XB1.10 (GND)
GND1: C26.2, IC5.2 (GND), IC5.3 (DATA), IC5.4 (DATA), R33.1, USB.M1 (S1), USB.M2 (S2), USB.M3 (S3), USB.M4 (S4)
LA1_3V3: IC6.63 (PA1/ADCA1), R5.2
LA2_3V3: IC6.64 (PA2/ADCA2), R4.2
LA3_3V3: IC6.1 (PA3/ADCA3), R7.2
LA4_3V3: IC6.2 (PA4/ADCA4), R6.2
LB3_3V3: IC6.9 (PB3/ADCB3/DAC1), R8.2
LB4_3V3: IC6.10 (PB4/ADCB4/TMS), R9.2
LB5_3V3: IC6.11 (PB5/ADCB5/TDI), R10.2
LB6_3V3: IC6.12 (PB6/ADCB6/TCK), R11.2
LED_BLUE_3V3: IC6.5 (PA7/ADCA7), R12.1, R17.2
LED_GREEN_3V3: IC6.55 (PF7), R13.1, R16.2
LED_RED_3V3: IC6.46 (OC0A/PF0), R14.1, R15.2
unnamed: LA2.A, R4.1
unnamed: LA1.A, R5.1
unnamed: LB3.A, R8.1
unnamed: LA3.A, R7.1
unnamed: LB4.A, R9.1
unnamed: LB5.A, R10.1
unnamed: LB6.A, R11.1
unnamed: LA4.A, R6.1
unnamed: HP.5, IC7.8 (VO2)
unnamed: C29.2, IC7.2 (BYPASS), IC7.3 (+IN)
unnamed: C9.1, IC2.6 (V-)
unnamed: C27.1, C28.2, R24.2
unnamed: LED1.3 (C), T3.C
unnamed: LED1.2 (C), T2.C
unnamed: LED1.1 (C), T1.C
unnamed: C12.1, IC2.2 (V+)
unnamed: C11.1, IC1.2 (V+)
unnamed: R14.2, T3.B
unnamed: C4.1, IC1.1 (C1+)
unnamed: C6.1, IC2.1 (C1+)
unnamed: C5.1, IC1.4 (C2+)
unnamed: C5.2, IC1.5 (C2-)
unnamed: C4.2, IC1.3 (C1-)
unnamed: C6.2, IC2.3 (C1-)
unnamed: C7.1, IC2.4 (C2+)
unnamed: C7.2, IC2.5 (C2-)
unnamed: C27.2, R25.1
unnamed: IC7.4 (-IN), R25.2, R37.1
unnamed: HP.3, HP.4, IC7.5 (VO1), R37.2
unnamed: R13.2, T2.B
unnamed: R12.2, T1.B
unnamed: LED1.6 (A), R18.1
unnamed: LED1.5 (A), R19.1
unnamed: LED1.4 (A), R20.1
unnamed: LW_BAT.C, R21.2
unnamed: C13.1, D1.C, IC3.IN, IC4.IN, R23.2
unnamed: C18.1, IC6.61 (AVCC), L1.1
unnamed: C24.1, IC6.59 (PR1/XTAL1), Q1.1
unnamed: C25.1, IC6.58 (PR0/XTAL2), Q1.2
PDI_3V3: IC6.56 (PDI), PRG.1 (DATA)
PROP_IRQ_0_3V3: IC6.40 (\S\S/OC1A/PE4), JB2.13
PROP_IRQ_1_3V3: IC6.41 (MOSI/XCK1/OC1B/PE5), JB2.14
RX_C0_3V3: IC2.9 (R2OUT), IC6.18 (PC2/OC0C/RXD0), R28.2, R39.2
RX_C0_232: IC2.8 (R2IN), R28.1, UART_C0.4 (TX_I)
RX_D0_3V3: IC2.12 (R1OUT), IC6.28 (PD2/OC0C/RXD0), R27.2, R40.2
RX_D0_232: IC2.13 (R1IN), R27.1, UART_D0.4 (TX_I)
RX_E0_3V3: IC1.12 (R1OUT), IC6.38 (RXD0/OC0C/PE2), R26.2, R41.2
RX_E0_232: IC1.13 (R1IN), R26.1, UART_E0.4 (TX_I)
RX_PROP_3V3: IC6.42 (MISO/RXD1/PE6), JB2.12, R42.2
SD_CONNECTED_3V3: IC6.30 (PD4/OC1A/\S\S), R1.2, SD1.CARD_CONNECT_1 (CARD_CONNECT1)
SD_CS_3V3: IC6.54 (PF6), R34.2, SD1.CD/DAT3
SD_MISO_3V3: IC6.22 (PC6/RXD1/MISO), SD1.DAT0
SD_MOSI_3V3: IC6.21 (PC5/OC1B/XCK1/MOSI), SD1.CMD
SD_SCLK_3V3: IC6.23 (PC7/TXD1/SCK), SD1.CLK
STARTING_CORD_3V3: COLOR/START.4, IC6.17 (PC1/OC0B/XCK0/SCL), R3.1
TX_C0_3V3: IC2.10 (T2IN), IC6.19 (PC3/OC0D/TXD0), R29.2
TX_C0_232: IC2.7 (T2OUT), R29.1, UART_C0.1 (RX_O)
TX_D0_3V3: IC2.11 (T1IN), IC6.29 (PD3/OC0D/TXD0), R30.2
TX_D0_232: IC2.14 (T1OUT), R30.1, UART_D0.1 (RX_O)
TX_E0_3V3: IC1.10 (T2IN), IC1.11 (T1IN), IC6.39 (TXD0/OC0D/PE3), R31.2
TX_E0_232: IC1.7 (T2OUT), R31.1, UART_E0.1 (RX_O)
TX_PROP_3V3: IC6.43 (SCK/TXD1/PE7), JB2.11
USB_5V: IC5.5 (VCC), R36.2, USB.1
USB_CONNECTED_3V3: IC6.47 (XCK0/OC0B/PF1), R35.2, R36.1
USB_DATA+: IC5.1 (DATA), IC6.33 (PD7/TXD1/SCK/D+), USB.3
USB_DATA-: IC5.6 (DATA), IC6.32 (PD6/RXD1/MISO/D-), USB.2
V-: C10.1, IC1.6 (V-), IC1.8 (R2IN)
VBAT_0_1V: C32.1, IC6.13 (PB7/ADCB7/TDO), R22.2, R23.1
XBEE_CTS_3V3: IC6.50 (PF4), XB1.12 (!CTS!/DIO7)
XBEE_RTS_3V3: IC6.51 (PF5), XB1.16 (!RTS!/AD6/DIO6)
XBEE_RX_3V3: IC6.48 (RXD0/OC0C/PF2), XB1.2 (DOUT)
XBEE_TX_3V3: IC6.49 (TXD0/OC0D/PF3), XB1.3 (DIN/!CONFIG)

Notes on the sheet:
Microcontroller
Supply
Leds
Communication
Logs
Super Unioc connectors
User interface
WARNING : audio_pwm_3v3 connected both on pwm pin and on dac pin, take care to specify unused pin as input

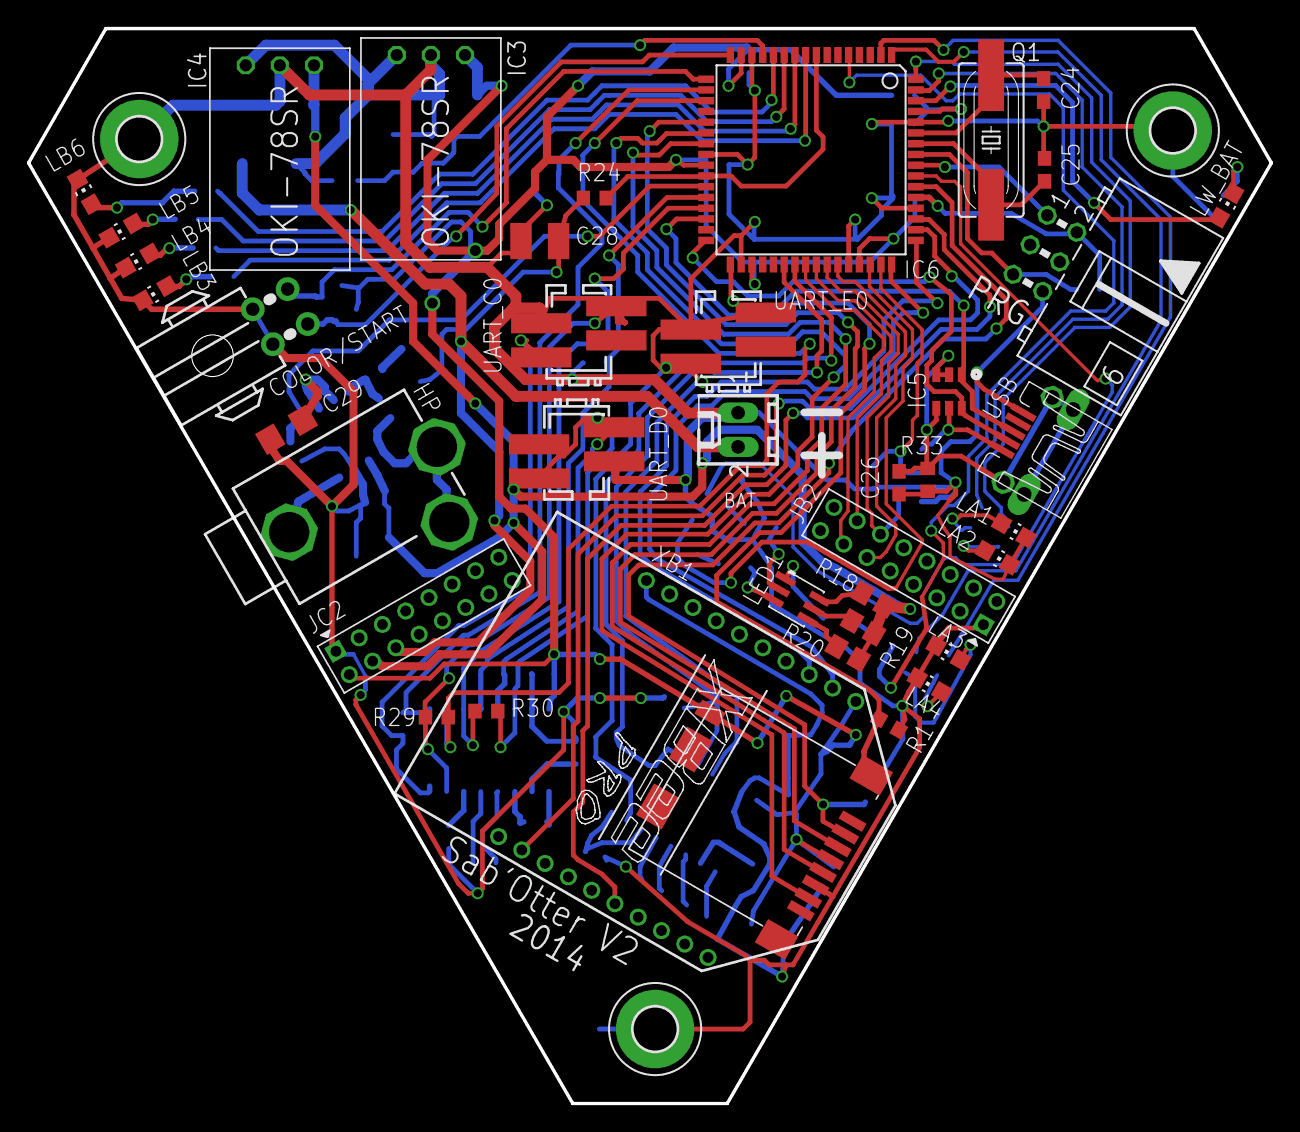
[picture p76: board sabotter.brd from above]

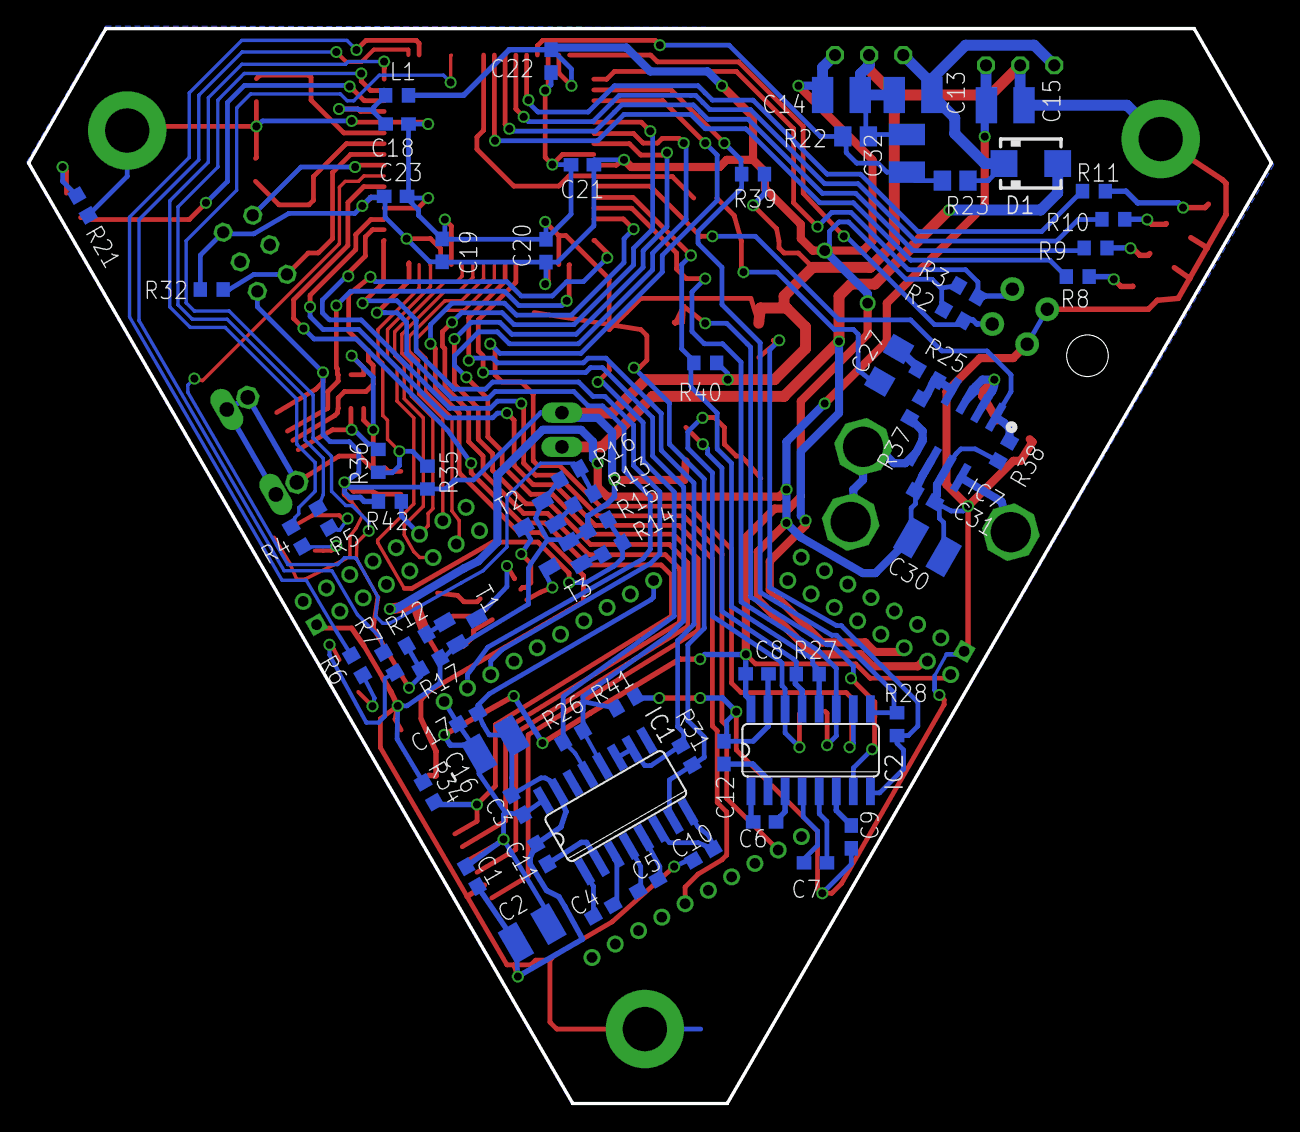
[picture p77: board sabotter.brd from below]

Board: 2 copper layers, 92.5 x 80.0 mm, 112 parts (69 on the bottom side), 93 nets.
