robotter/robotter/hardware/motor_ctrl_pw_v3/motor_ctrl_pw_v3.brd

## EAGLE design hardware/motor_ctrl_pw_v3/motor_ctrl_pw_v3.brd (2015-10-04)

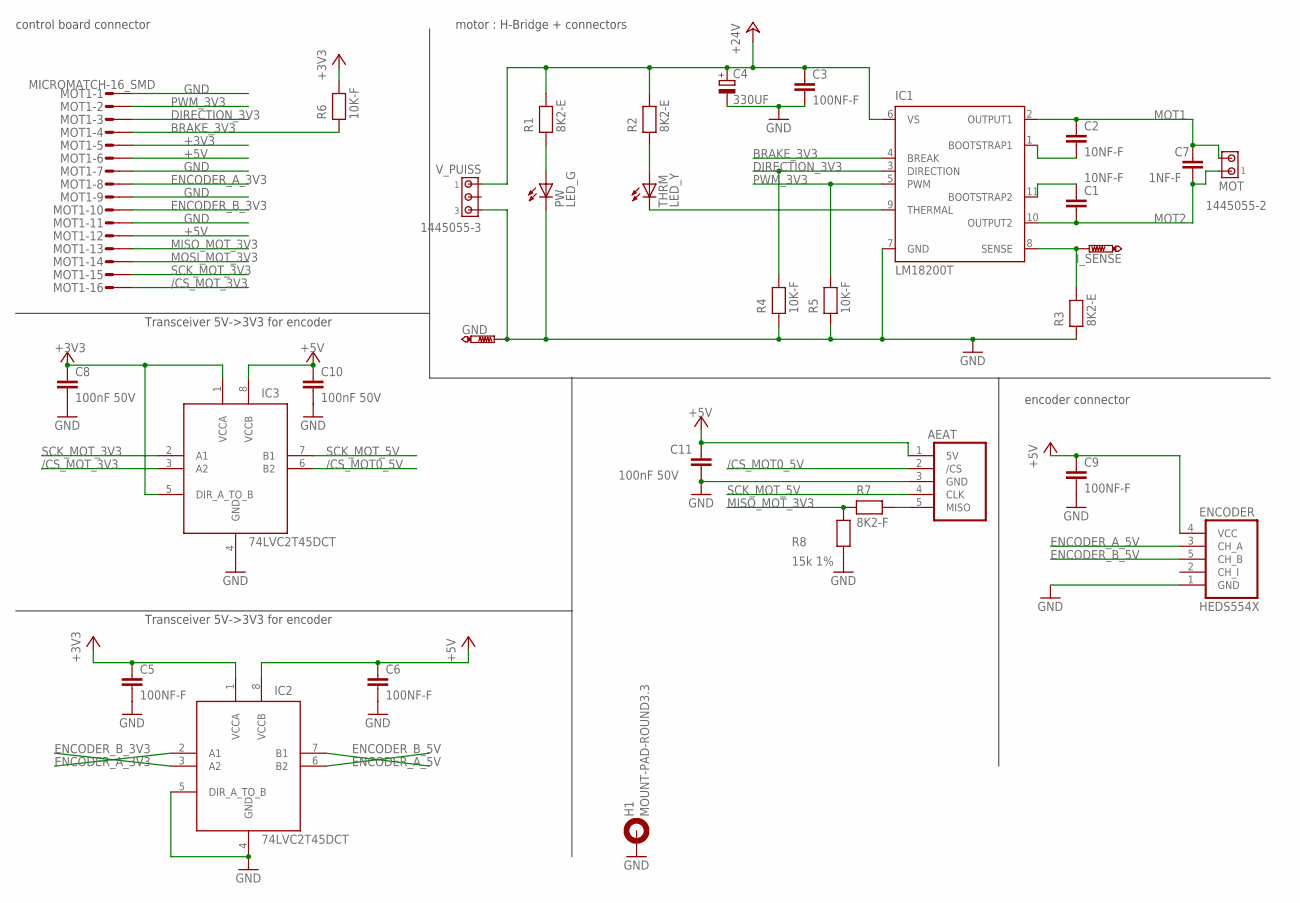
[picture p78: schematic motor_ctrl_pw_v3.sch]

Parts:
AEAT: AEAT-601X; 53047-05
C1, C2: 10NF-F; C0603
C3, C5, C6, C9: 100NF-F; C0603
C4: 330UF; PANASONIC_G
C7: 1NF-F; C0603
C8, C10, C11: 100nF 50V; C0603
ENCODER: HEDS554X; 22-05-1052
GND: PTR1PAD1-13; P1-13
H1: MOUNT-PAD-ROUND3.3; 3,3-PAD
IC1: LM18200T; TO-220-11
IC2, IC3: 74LVC2T45DCT; SSOP8
I_SENSE: PTR1PAD1-13; P1-13
MOT: 1445055-2
MOT1: MICROMATCH-16_SMD
PW: LED_G; CHIP-LED0805
R1, R2, R3: 8K2-E; R0805
R4, R5, R6: 10K-F; R0603
R7: 8K2-F; R0603
R8: 15k 1%; R0603
THRM: LED_Y; CHIP-LED0805
V_PUISS: 1445055-3

Connections:
+3V3: C5.1, C8.1, IC2.1 (VCCA), IC3.1 (VCCA), IC3.5 (DIR_A_TO_B), MOT1.5, R6.2
+5V: AEAT.1 (5V), C6.1, C9.1, C10.1, C11.1, ENCODER.4 (VCC), IC2.8 (VCCB), IC3.8 (VCCB), MOT1.6, MOT1.12
+24V: C3.1, C4.+, IC1.6 (VS), R1.2, R2.2, V_PUISS.1
/CS_MOT0_5V: AEAT.2 (/CS), IC3.6 (B2)
/CS_MOT_3V3: IC3.3 (A2), MOT1.16
BRAKE_3V3: IC1.4 (BREAK), MOT1.4, R6.1
DIRECTION_3V3: IC1.3 (DIRECTION), MOT1.3, R4.2
ENCODER_A_3V3: IC2.2 (A1), MOT1.8
ENCODER_A_5V: ENCODER.3 (CH_A), IC2.7 (B1)
ENCODER_B_3V3: IC2.3 (A2), MOT1.10
ENCODER_B_5V: ENCODER.5 (CH_B), IC2.6 (B2)
GND: AEAT.3 (GND), C3.2, C4.-, C5.2, C6.2, C8.2, C9.2, C10.2, C11.2, ENCODER.1 (GND), GND.TP, H1.B3,3, IC1.7 (GND), IC2.4 (GND), IC2.5 (DIR_A_TO_B), IC3.4 (GND), MOT1.1, MOT1.7, MOT1.9, MOT1.11, PW.C, R3.1, R4.1, R5.1, R8.1, V_PUISS.3
MISO_MOT_3V3: MOT1.13, R7.1, R8.2
MOSI_MOT_3V3: MOT1.14
MOT1: C2.1, C7.1, IC1.2 (OUTPUT1), MOT.2
MOT2: C1.2, C7.2, IC1.10 (OUTPUT2), MOT.1
unnamed: R2.1, THRM.A
unnamed: IC1.8 (SENSE), I_SENSE.TP, R3.2
unnamed: PW.A, R1.1
unnamed: IC1.9 (THERMAL), THRM.C
unnamed: C2.2, IC1.1 (BOOTSTRAP1)
unnamed: C1.1, IC1.11 (BOOTSTRAP2)
unnamed: AEAT.5 (MISO), R7.2
PWM_3V3: IC1.5 (PWM), MOT1.2, R5.2
SCK_MOT_3V3: IC3.2 (A1), MOT1.15
SCK_MOT_5V: AEAT.4 (CLK), IC3.7 (B1)

Notes on the sheet:
control board connector
motor : H-Bridge + connectors
Transceiver 5V->3V3 for encoder
encoder connector

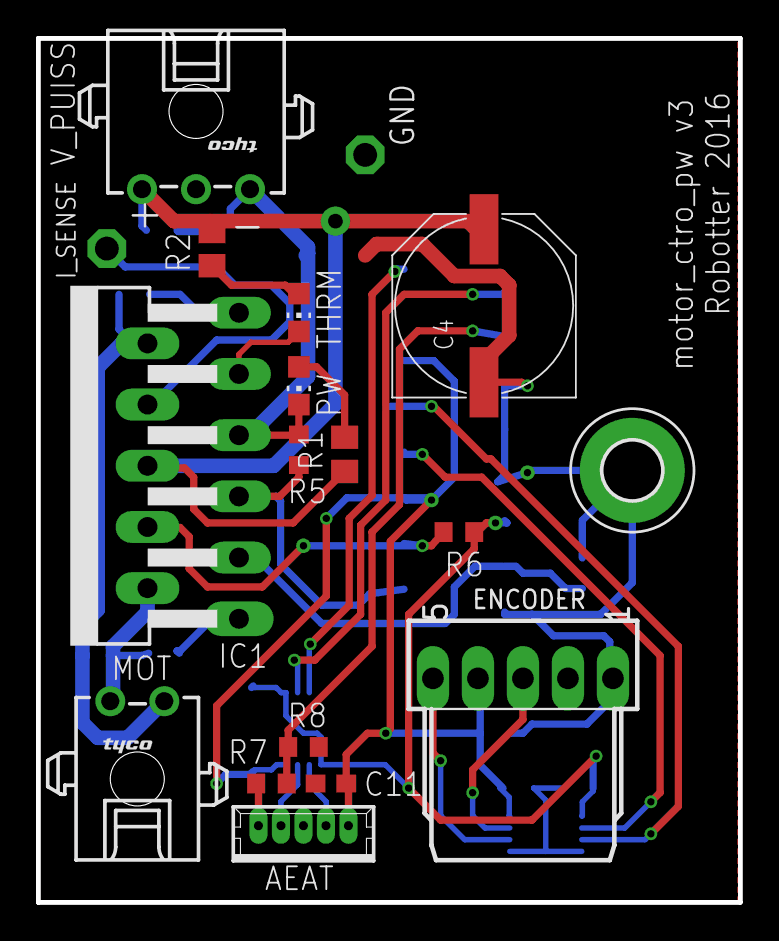
[picture p79: board motor_ctrl_pw_v3.brd from above]

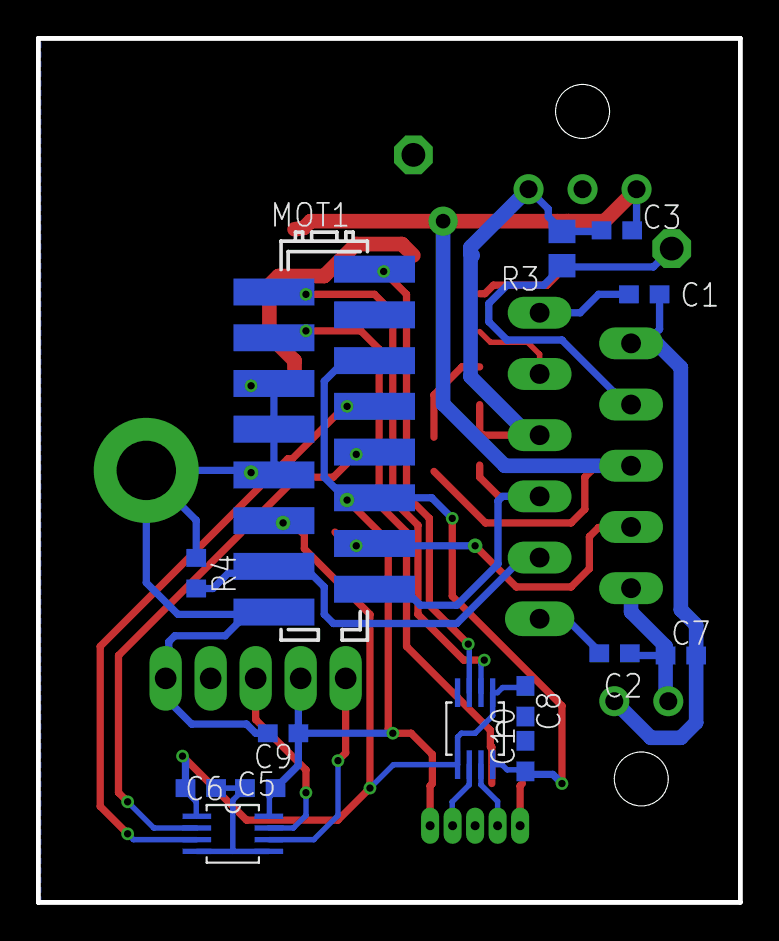
[picture p80: board motor_ctrl_pw_v3.brd from below]

Board: 2 copper layers, 39.0 x 48.0 mm, 32 parts (14 on the bottom side), 25 nets.
