robotter/robotter/hardware/R3D2/R3D2.brd

## EAGLE design hardware/R3D2/R3D2.brd (2015-01-25)

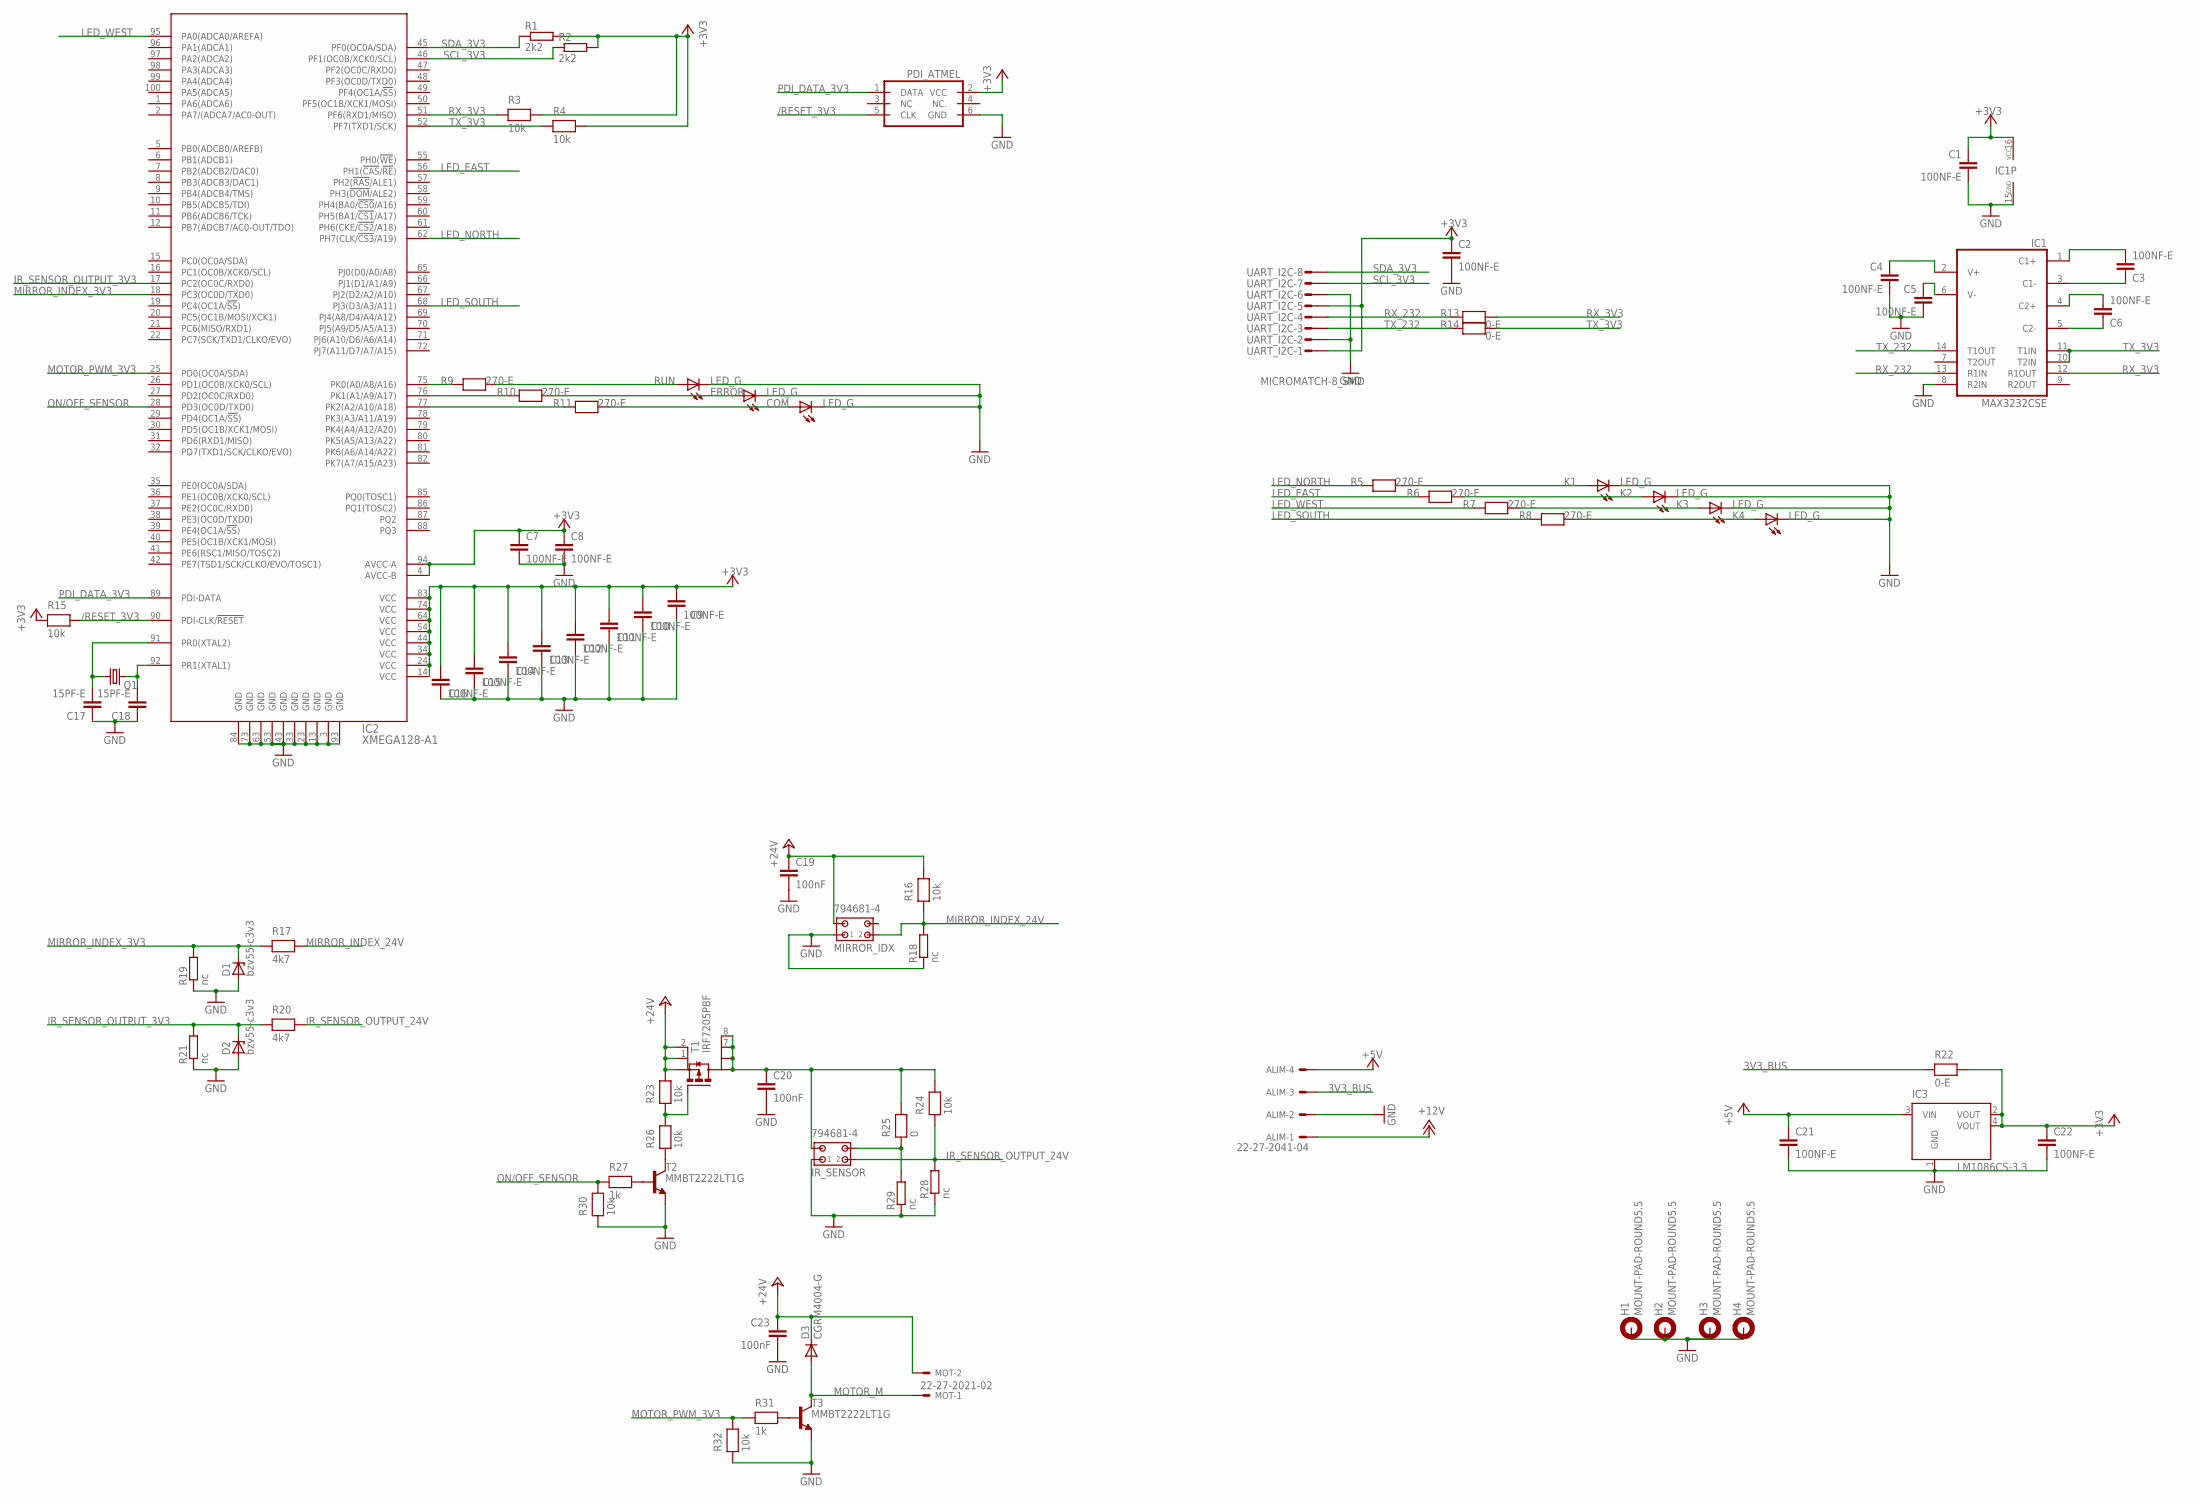
[picture p81: schematic R3D2.sch]

Parts:
ALIM: 22-27-2041-04; 6410-04
C1, C2, C3, C4, C5, C6, C7, C8, C9, C10, C11, C12, C13, C14, C15, C16, C21, C22: 100NF-E; C0805
C17, C18: 15PF-E; C0805
C19, C23: 100nF; C0805
C20: 100nF; C0603
COM: LED_G; CHIP-LED0805
D1, D2: bzv55-c3v3; SOD80C
D3: CGRM4004-G; SOD-123_MINI-SMA
ERROR: LED_G; CHIP-LED0805
H1, H2, H3, H4: MOUNT-PAD-ROUND5.5; 5,5-PAD
IC1: MAX3232CSE; SO16
IC2: XMEGA128-A1; TQFP100
IC3: LM1086CS-3.3; TO263
IR_SENSOR: 794681-4
K1, K2, K3, K4: LED_G; CHIP-LED0805
MIRROR_IDX: 794681-4
MOT: 22-27-2021-02; 6410-02
PDI_ATMEL: PDI_ATMEL; ML6
Q1: CRYSTAL_16MHZ_HC49UP; HC49UP
R1, R2: 2k2; R0603
R3, R4, R15, R16, R23, R24, R26, R30, R32: 10k; R0603
R5, R6, R7, R8, R9, R10, R11: 270-E; R0805
R13, R14, R22: 0-E; R0805
R17, R20: 4k7; R0805
R18: nc; R0805
R19, R21, R28, R29: nc; R0603
R25: 0; R0603
R27, R31: 1k; R0603
RUN: LED_G; CHIP-LED0805
T1: IRF7205PBF; SO8
T2, T3: MMBT2222LT1G; SOT23-BEC
UART_I2C: MICROMATCH-8_SMD

Connections:
3V3_BUS: ALIM.3, R22.1
+3V3: C1.1, C2.1, C7.1, C8.1, C9.1, C10.1, C11.1, C12.1, C13.1, C14.1, C15.1, C16.1, C22.1, IC1.16 (VCC), IC2.4 (AVCC-B), IC2.14 (VCC), IC2.24 (VCC), IC2.34 (VCC), IC2.44 (VCC), IC2.54 (VCC), IC2.64 (VCC), IC2.74 (VCC), IC2.83 (VCC), IC2.94 (AVCC-A), IC3.2 (VOUT), IC3.4 (VOUT), PDI_ATMEL.2 (VCC), R1.2, R2.2, R3.2, R4.2, R15.1, R22.2, UART_I2C.1, UART_I2C.5
+5V: ALIM.4, C21.1, IC3.3 (VIN)
+12V: ALIM.1
+24V: C19.1, C23.1, D3.C, MIRROR_IDX.3, MOT.2, R16.2, R23.2, T1.1 (S), T1.2 (S), T1.3 (S)
/RESET_3V3: IC2.90 (PDI-CLK/!RESET), PDI_ATMEL.5 (CLK), R15.2
GND: ALIM.2, C1.2, C2.2, C4.2, C5.2, C7.2, C8.2, C9.2, C10.2, C11.2, C12.2, C13.2, C14.2, C15.2, C16.2, C17.1, C18.1, C19.2, C20.2, C21.2, C22.2, C23.2, COM.C, D1.A, D2.A, ERROR.C, H1.B5,5, H2.B5,5, H3.B5,5, H4.B5,5, IC1.8 (R2IN), IC1.15 (GND), IC2.3 (GND), IC2.13 (GND), IC2.23 (GND), IC2.33 (GND), IC2.43 (GND), IC2.53 (GND), IC2.63 (GND), IC2.73 (GND), IC2.84 (GND), IC2.93 (GND), IC3.1 (GND), IR_SENSOR.1, K1.C, K2.C, K3.C, K4.C, MIRROR_IDX.1, PDI_ATMEL.6 (GND), R18.1, R19.1, R21.1, R28.1, R29.1, R30.1, R32.1, RUN.C, T2.E, T3.E, UART_I2C.2, UART_I2C.6
IR_SENSOR_OUTPUT_3V3: D2.C, IC2.17 (PC2(OC0C/RXD0)), R20.1, R21.2
IR_SENSOR_OUTPUT_24V: IR_SENSOR.2, R20.2, R24.1, R28.2
LED_EAST: IC2.56 (PH1(!CAS!/!RE!)), R6.1
LED_NORTH: IC2.62 (PH7(CLK/!CS3!/A19)), R5.1
LED_SOUTH: IC2.68 (PJ3(D3/A3/A11)), R8.1
LED_WEST: IC2.95 (PA0(ADCA0/AREFA)), R7.1
MIRROR_INDEX_3V3: D1.C, IC2.18 (PC3(OC0D/TXD0)), R17.1, R19.2
MIRROR_INDEX_24V: MIRROR_IDX.2, R16.1, R17.2, R18.2
MOTOR_M: D3.A, MOT.1, T3.C
MOTOR_PWM_3V3: IC2.25 (PD0(OC0A/SDA)), R31.1, R32.2
unnamed: C3.1, IC1.1 (C1+)
unnamed: R9.2, RUN.A
unnamed: R31.2, T3.B
unnamed: ERROR.A, R10.2
unnamed: C3.2, IC1.3 (C1-)
unnamed: C6.1, IC1.4 (C2+)
unnamed: COM.A, R11.2
unnamed: IC2.75 (PK0(A0/A8/A16)), R9.1
unnamed: IC2.76 (PK1(A1/A9/A17)), R10.1
unnamed: C4.1, IC1.2 (V+)
unnamed: IC2.77 (PK2(A2/A10/A18)), R11.1
unnamed: C5.1, IC1.6 (V-)
unnamed: C6.2, IC1.5 (C2-)
unnamed: C17.2, IC2.91 (PR0(XTAL2)), Q1.1
unnamed: C18.2, IC2.92 (PR1(XTAL1)), Q1.2
unnamed: K1.A, R5.2
unnamed: K2.A, R6.2
unnamed: K3.A, R7.2
unnamed: K4.A, R8.2
unnamed: R27.2, T2.B
unnamed: C20.1, IR_SENSOR.3, R24.2, R25.2, T1.5 (D), T1.6 (D), T1.7 (D), T1.8 (D)
unnamed: R26.1, T2.C
unnamed: R23.1, R26.2, T1.4 (G)
unnamed: IR_SENSOR.4, R25.1, R29.2
ON/OFF_SENSOR: IC2.28 (PD3(OC0D/TXD0)), R27.1, R30.2
PDI_DATA_3V3: IC2.89 (PDI-DATA), PDI_ATMEL.1 (DATA)
RX_3V3: IC1.12 (R1OUT), IC2.51 (PF6(RXD1/MISO)), R3.1, R13.2
RX_232: IC1.13 (R1IN), R13.1, UART_I2C.4
SCL_3V3: IC2.46 (PF1(OC0B/XCK0/SCL)), R2.1, UART_I2C.7
SDA_3V3: IC2.45 (PF0(OC0A/SDA)), R1.1, UART_I2C.8
TX_3V3: IC1.10 (T2IN), IC1.11 (T1IN), IC2.52 (PF7(TXD1/SCK)), R4.1, R14.2
TX_232: IC1.14 (T1OUT), R14.1, UART_I2C.3
