robotter/robotter/hardware/R3D2/R3D2.brd

## EAGLE design hardware/R3D2/R3D2.brd (continued)

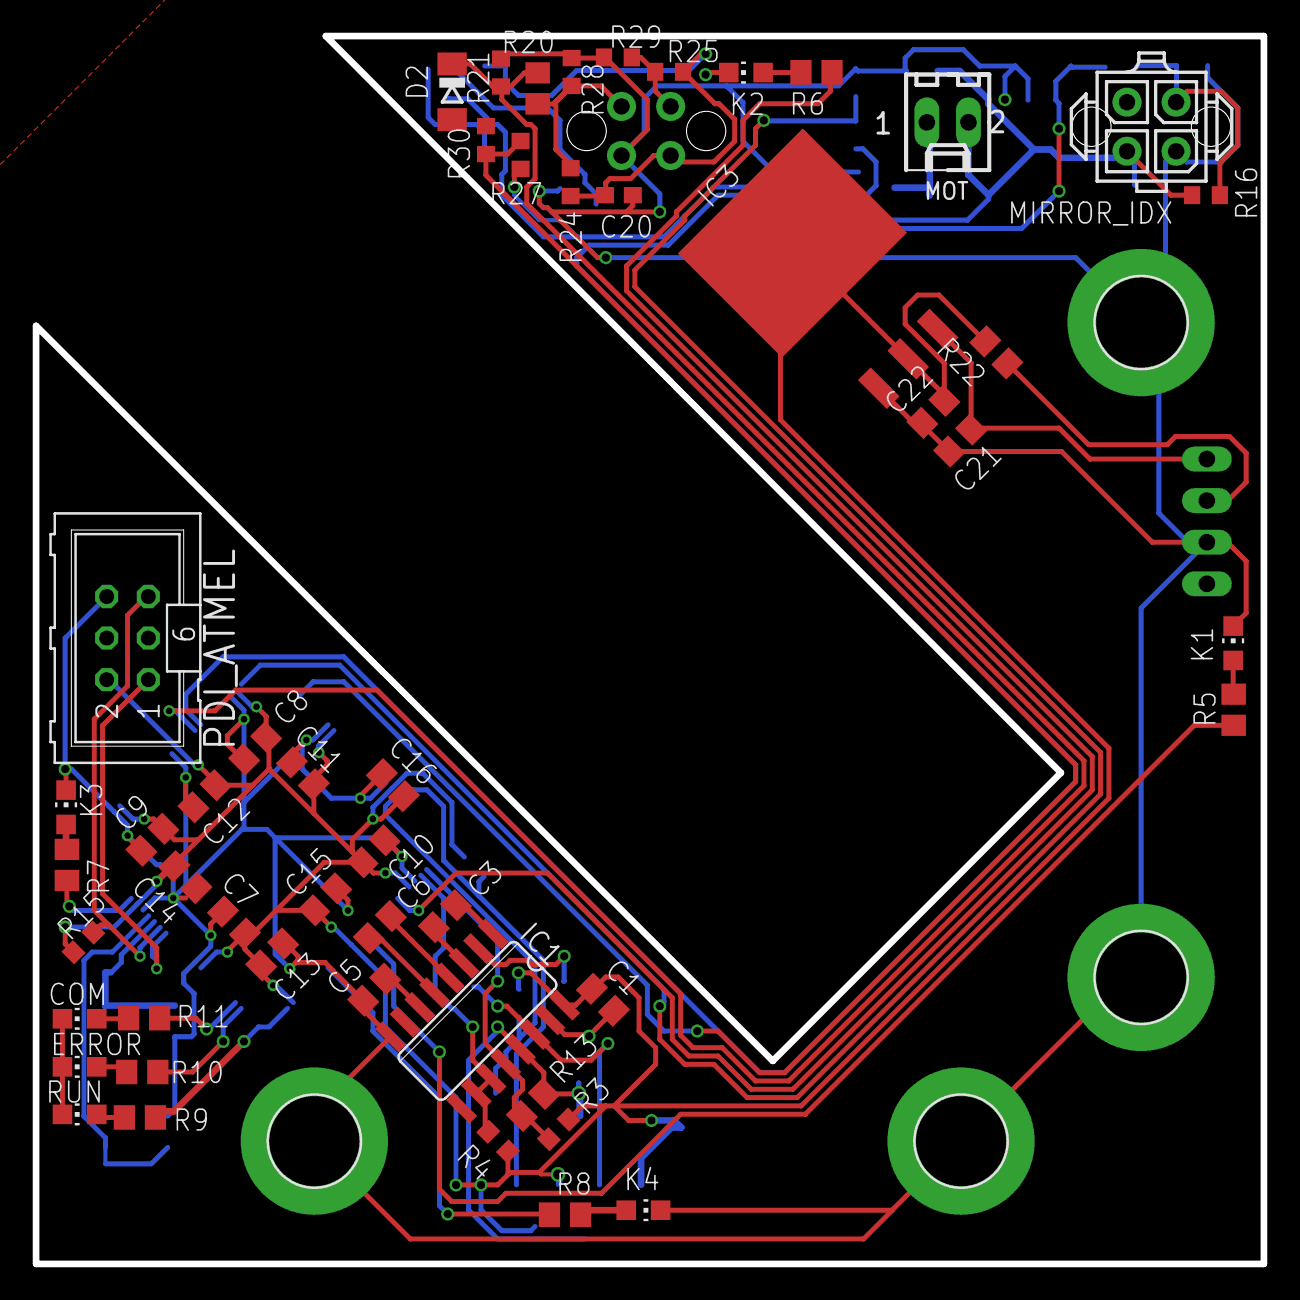
[picture p82: board R3D2.brd from above]

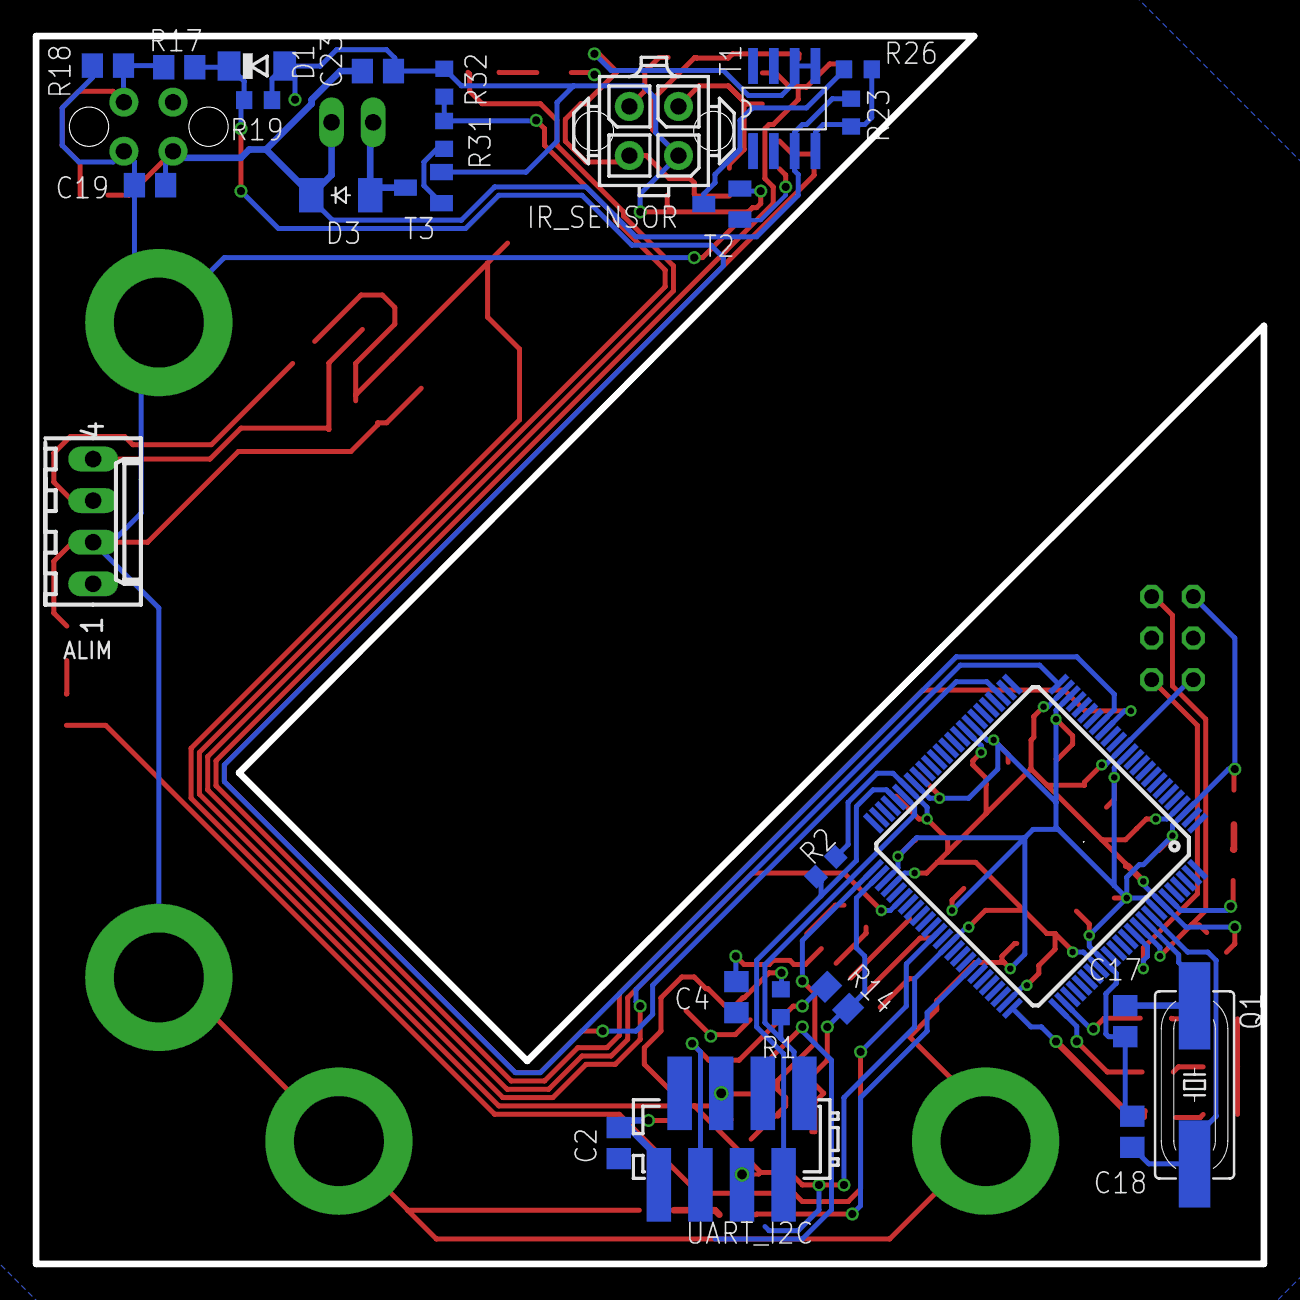
[picture p83: board R3D2.brd from below]

Board: 2 copper layers, 75.0 x 75.0 mm, 81 parts (26 on the bottom side), 48 nets.
