robotter/robotter/hardware/SuperUnioc/SuperUnioc_v1.brd

## EAGLE design hardware/SuperUnioc/SuperUnioc_v1.brd (2014-06-11)

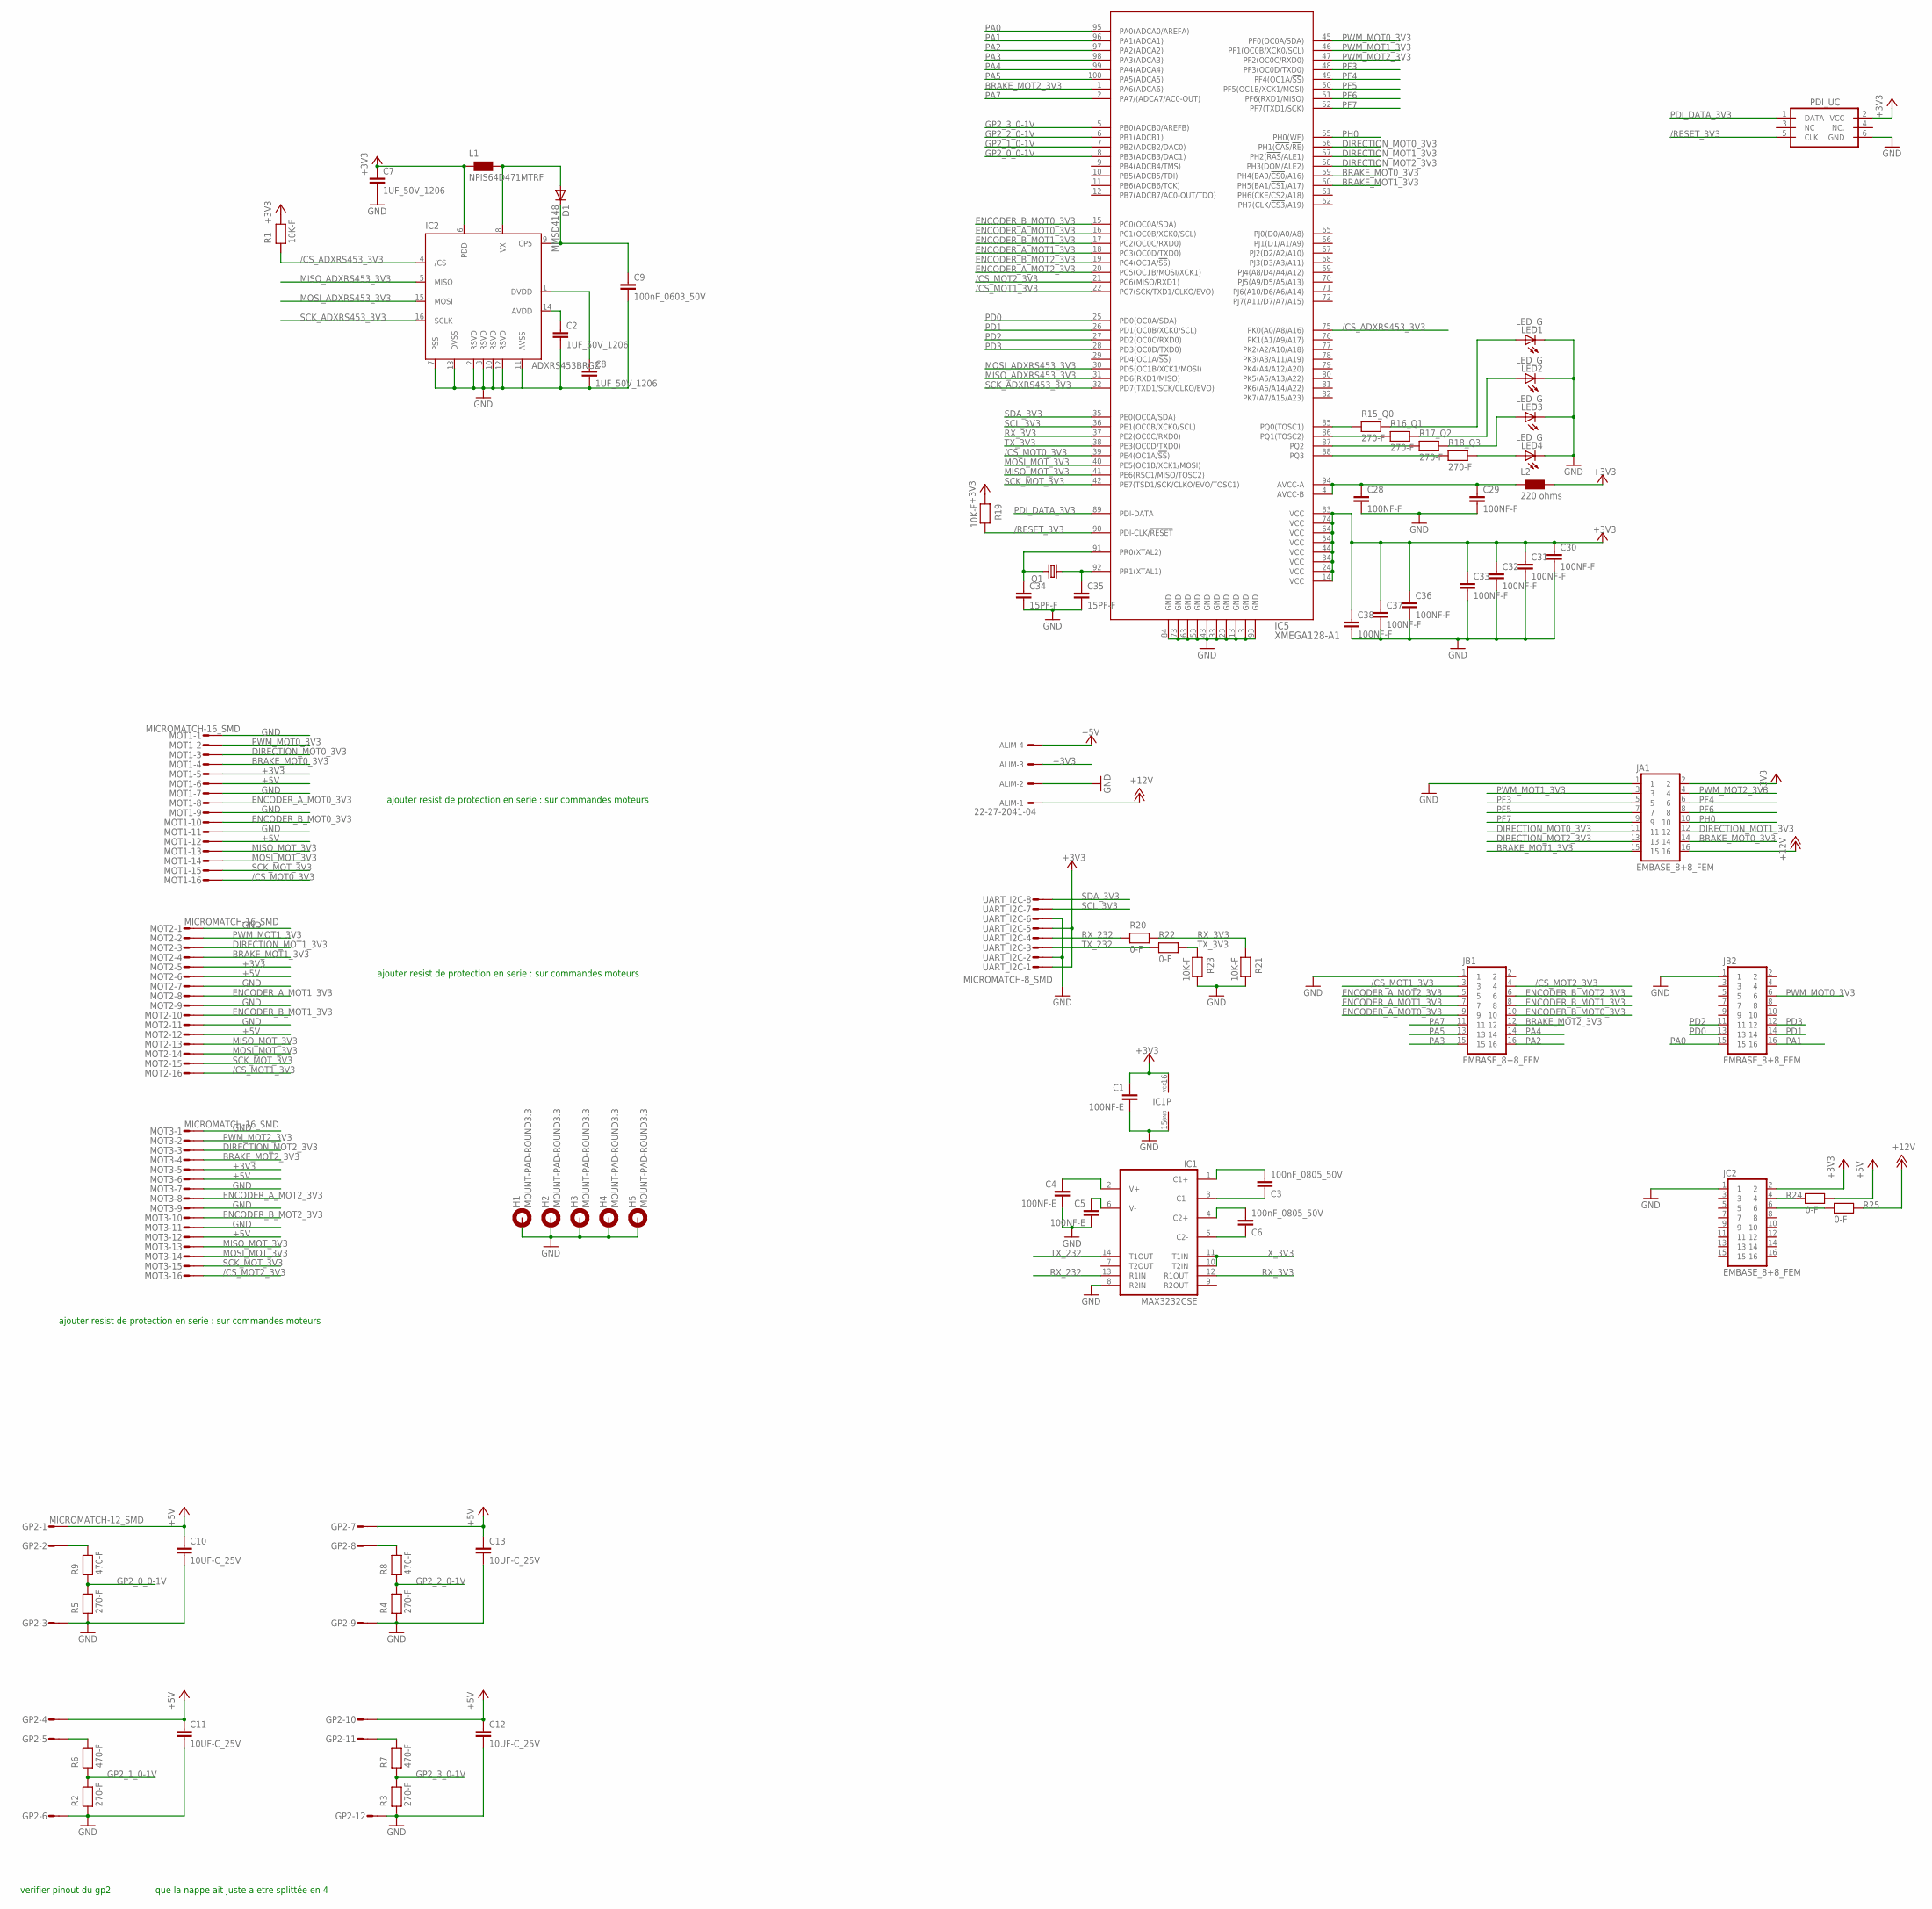
[picture p84: schematic SuperUnioc_v1.sch]

Parts:
ALIM: 22-27-2041-04; 6410-04
C1, C4, C5: 100NF-E; C0805
C2, C7, C8: 1UF_50V_1206; C1206
C3, C6: 100nF_0805_50V; C0805
C9: 100nF_0603_50V; C0603
C10, C11, C12, C13: 10UF-C_25V; C1210
C28, C29, C30, C31, C32, C33, C36, C37, C38: 100NF-F; C0603
C34, C35: 15PF-F; C0603
D1: MMSD4148; SOD123
GP2: MICROMATCH-12_SMD
H1, H2, H3, H4, H5: MOUNT-PAD-ROUND3.3; 3,3-PAD
IC1: MAX3232CSE; SO16
IC2: ADXRS453BRGZ; SO16_CAV
IC5: XMEGA128-A1; TQFP100
JA1: EMBASE_8+8_FEM
JB1, JB2: EMBASE_8+8_FEM
JC2: EMBASE_8+8_FEM
L1: NPIS64D471MTRF; NPSIS_D64
L2: 220 ohms; R0603
LED1, LED2, LED3, LED4: LED_G; CHIP-LED0805
MOT1, MOT2, MOT3: MICROMATCH-16_SMD
PDI_UC: PDI_ATMELL; ML6L
Q1: CRYSTAL_16MHZ_HC49UP; HC49UP
R1, R19, R21, R23: 10K-F; R0603
R2, R3, R4, R5, R15_Q0, R16_Q1, R17_Q2, R18_Q3: 270-F; R0603
R6, R7, R8, R9: 470-F; R0603
R20, R22, R24, R25: 0-F; R0603
UART_I2C: MICROMATCH-8_SMD

Connections:
+3V3: ALIM.3, C1.1, C7.1, C30.1, C31.1, C32.1, C33.1, C36.1, C37.1, C38.1, IC1.16 (VCC), IC2.6 (PDD), IC5.14 (VCC), IC5.24 (VCC), IC5.34 (VCC), IC5.44 (VCC), IC5.54 (VCC), IC5.64 (VCC), IC5.74 (VCC), IC5.83 (VCC), JA1.2, JC2.2, L1.1, L2.2, MOT1.5, MOT2.5, MOT3.5, PDI_UC.2 (VCC), R1.2, R19.1, UART_I2C.1, UART_I2C.5
+5V: ALIM.4, C10.1, C11.1, C12.1, C13.1, GP2.1, GP2.4, GP2.7, GP2.10, MOT1.6, MOT1.12, MOT2.6, MOT2.12, MOT3.6, MOT3.12, R24.2
+12V: ALIM.1, JA1.16, R25.2
/CS_ADXRS453_3V3: IC2.4 (/CS), IC5.75 (PK0(A0/A8/A16)), R1.1
/CS_MOT0_3V3: IC5.39 (PE4(OC1A/!SS!)), MOT1.16
/CS_MOT1_3V3: IC5.22 (PC7(SCK/TXD1/CLKO/EVO)), JB1.3, MOT2.16
/CS_MOT2_3V3: IC5.21 (PC6(MISO/RXD1)), JB1.4, MOT3.16
/RESET_3V3: IC5.90 (PDI-CLK/!RESET), PDI_UC.5 (CLK), R19.2
BRAKE_MOT0_3V3: IC5.59 (PH4(BA0/!CS0!/A16)), JA1.14, MOT1.4
BRAKE_MOT1_3V3: IC5.60 (PH5(BA1/!CS1!/A17)), JA1.15, MOT2.4
BRAKE_MOT2_3V3: IC5.1 (PA6(ADCA6)), JB1.12, MOT3.4
DIRECTION_MOT0_3V3: IC5.56 (PH1(!CAS!/!RE!)), JA1.11, MOT1.3
DIRECTION_MOT1_3V3: IC5.57 (PH2(!RAS!/ALE1)), JA1.12, MOT2.3
DIRECTION_MOT2_3V3: IC5.58 (PH3(!DOM!/ALE2)), JA1.13, MOT3.3
ENCODER_A_MOT0_3V3: IC5.16 (PC1(OC0B/XCK0/SCL)), JB1.9, MOT1.8
ENCODER_A_MOT1_3V3: IC5.18 (PC3(OC0D/TXD0)), JB1.7, MOT2.8
ENCODER_A_MOT2_3V3: IC5.20 (PC5(OC1B/MOSI/XCK1)), JB1.5, MOT3.8
ENCODER_B_MOT0_3V3: IC5.15 (PC0(OC0A/SDA)), JB1.10, MOT1.10
ENCODER_B_MOT1_3V3: IC5.17 (PC2(OC0C/RXD0)), JB1.8, MOT2.10
ENCODER_B_MOT2_3V3: IC5.19 (PC4(OC1A/!SS!)), JB1.6, MOT3.10
GND: ALIM.2, C1.2, C2.2, C4.2, C5.2, C7.2, C8.2, C9.2, C10.2, C11.2, C12.2, C13.2, C28.2, C29.2, C30.2, C31.2, C32.2, C33.2, C34.2, C35.2, C36.2, C37.2, C38.2, GP2.3, GP2.6, GP2.9, GP2.12, H1.B3,3, H2.B3,3, H3.B3,3, H4.B3,3, H5.B3,3, IC1.8 (R2IN), IC1.15 (GND), IC2.2 (RSVD), IC2.3 (RSVD), IC2.7 (PSS), IC2.10 (RSVD), IC2.11 (AVSS), IC2.12 (RSVD), IC2.13 (DVSS), IC5.3 (GND), IC5.13 (GND), IC5.23 (GND), IC5.33 (GND), IC5.43 (GND), IC5.53 (GND), IC5.63 (GND), IC5.73 (GND), IC5.84 (GND), IC5.93 (GND), JA1.1, JB1.1, JB2.1, JC2.1, LED1.C, LED2.C, LED3.C, LED4.C, MOT1.1, MOT1.7, MOT1.9, MOT1.11, MOT2.1, MOT2.7, MOT2.9, MOT2.11, MOT3.1, MOT3.7, MOT3.9, MOT3.11, PDI_UC.6 (GND), R2.1, R3.1, R4.1, R5.1, R21.2, R23.2, UART_I2C.2, UART_I2C.6
GP2_0_0-1V: IC5.8 (PB3(ADCB3/DAC1)), R5.2, R9.1
GP2_1_0-1V: IC5.7 (PB2(ADCB2/DAC0)), R2.2, R6.1
GP2_2_0-1V: IC5.6 (PB1(ADCB1)), R4.2, R8.1
GP2_3_0-1V: IC5.5 (PB0(ADCB0/AREFB)), R3.2, R7.1
MISO_ADXRS453_3V3: IC2.5 (MISO), IC5.31 (PD6(RXD1/MISO))
MISO_MOT_3V3: IC5.41 (PE6(RSC1/MISO/TOSC2)), MOT1.13, MOT2.13, MOT3.13
MOSI_ADXRS453_3V3: IC2.15 (MOSI), IC5.30 (PD5(OC1B/XCK1/MOSI))
MOSI_MOT_3V3: IC5.40 (PE5(OC1B/XCK1/MOSI)), MOT1.14, MOT2.14, MOT3.14
unnamed: JC2.4, R24.1
unnamed: C3.1, IC1.1 (C1+)
unnamed: C6.1, IC1.4 (C2+)
unnamed: LED4.A, R18_Q3.2
unnamed: C3.2, IC1.3 (C1-)
unnamed: IC5.88 (PQ3), R18_Q3.1
unnamed: C34.1, IC5.91 (PR0(XTAL2)), Q1.2
unnamed: C35.1, IC5.92 (PR1(XTAL1)), Q1.1
unnamed: IC5.87 (PQ2), R17_Q2.1
unnamed: IC5.86 (PQ1(TOSC2)), R16_Q1.1
unnamed: IC5.85 (PQ0(TOSC1)), R15_Q0.1
unnamed: LED1.A, R15_Q0.2
unnamed: LED2.A, R16_Q1.2
unnamed: LED3.A, R17_Q2.2
unnamed: JC2.6, R25.1
unnamed: C6.2, IC1.5 (C2-)
unnamed: C4.1, IC1.2 (V+)
unnamed: D1.A, IC2.8 (VX), L1.2
unnamed: C2.1, IC2.14 (AVDD)
unnamed: C5.1, IC1.6 (V-)
unnamed: C8.1, IC2.1 (DVDD)
unnamed: GP2.8, R8.2
unnamed: C9.1, D1.C, IC2.9 (CP5)
unnamed: GP2.2, R9.2
unnamed: C28.1, C29.1, IC5.4 (AVCC-B), IC5.94 (AVCC-A), L2.1
unnamed: GP2.11, R7.2
unnamed: GP2.5, R6.2
PA0: IC5.95 (PA0(ADCA0/AREFA)), JB2.15
PA1: IC5.96 (PA1(ADCA1)), JB2.16
PA2: IC5.97 (PA2(ADCA2)), JB1.16
PA3: IC5.98 (PA3(ADCA3)), JB1.15
PA4: IC5.99 (PA4(ADCA4)), JB1.14
PA5: IC5.100 (PA5(ADCA5)), JB1.13
PA7: IC5.2 (PA7/(ADCA7/AC0-OUT)), JB1.11
PD0: IC5.25 (PD0(OC0A/SDA)), JB2.13
PD1: IC5.26 (PD1(OC0B/XCK0/SCL)), JB2.14
PD2: IC5.27 (PD2(OC0C/RXD0)), JB2.11
PD3: IC5.28 (PD3(OC0D/TXD0)), JB2.12
PDI_DATA_3V3: IC5.89 (PDI-DATA), PDI_UC.1 (DATA)
PF3: IC5.48 (PF3(OC0D/TXD0)), JA1.5
PF4: IC5.49 (PF4(OC1A/!SS!)), JA1.6
PF5: IC5.50 (PF5(OC1B/XCK1/MOSI)), JA1.7
PF6: IC5.51 (PF6(RXD1/MISO)), JA1.8
PF7: IC5.52 (PF7(TXD1/SCK)), JA1.9
PH0: IC5.55 (PH0(!WE!)), JA1.10
PWM_MOT0_3V3: IC5.45 (PF0(OC0A/SDA)), JB2.6, MOT1.2
PWM_MOT1_3V3: IC5.46 (PF1(OC0B/XCK0/SCL)), JA1.3, MOT2.2
PWM_MOT2_3V3: IC5.47 (PF2(OC0C/RXD0)), JA1.4, MOT3.2
RX_3V3: IC1.12 (R1OUT), IC5.37 (PE2(OC0C/RXD0)), R20.2, R21.1
RX_232: IC1.13 (R1IN), R20.1, UART_I2C.4
SCK_ADXRS453_3V3: IC2.16 (SCLK), IC5.32 (PD7(TXD1/SCK/CLKO/EVO))
SCK_MOT_3V3: IC5.42 (PE7(TSD1/SCK/CLKO/EVO/TOSC1)), MOT1.15, MOT2.15, MOT3.15
SCL_3V3: IC5.36 (PE1(OC0B/XCK0/SCL)), UART_I2C.7
SDA_3V3: IC5.35 (PE0(OC0A/SDA)), UART_I2C.8
TX_3V3: IC1.10 (T2IN), IC1.11 (T1IN), IC5.38 (PE3(OC0D/TXD0)), R22.2, R23.1
TX_232: IC1.14 (T1OUT), R22.1, UART_I2C.3

Notes on the sheet:
verifier pinout du gp2
que la nappe ait juste a etre splittée en 4
ajouter resist de protection en serie : sur commandes moteurs

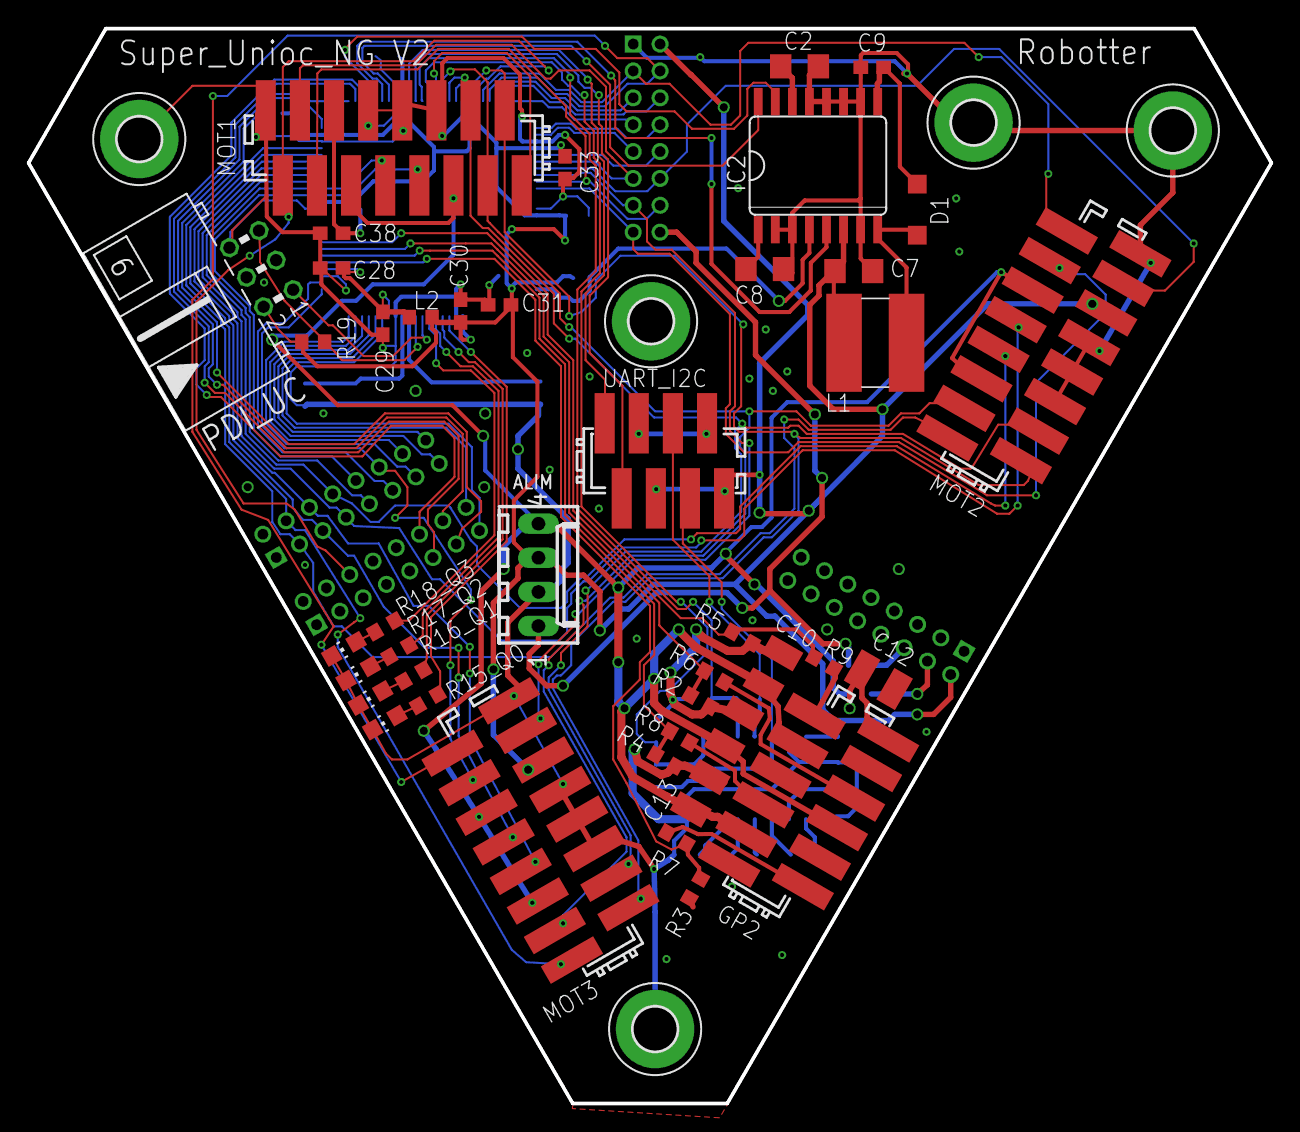
[picture p85: board SuperUnioc_v1.brd from above]

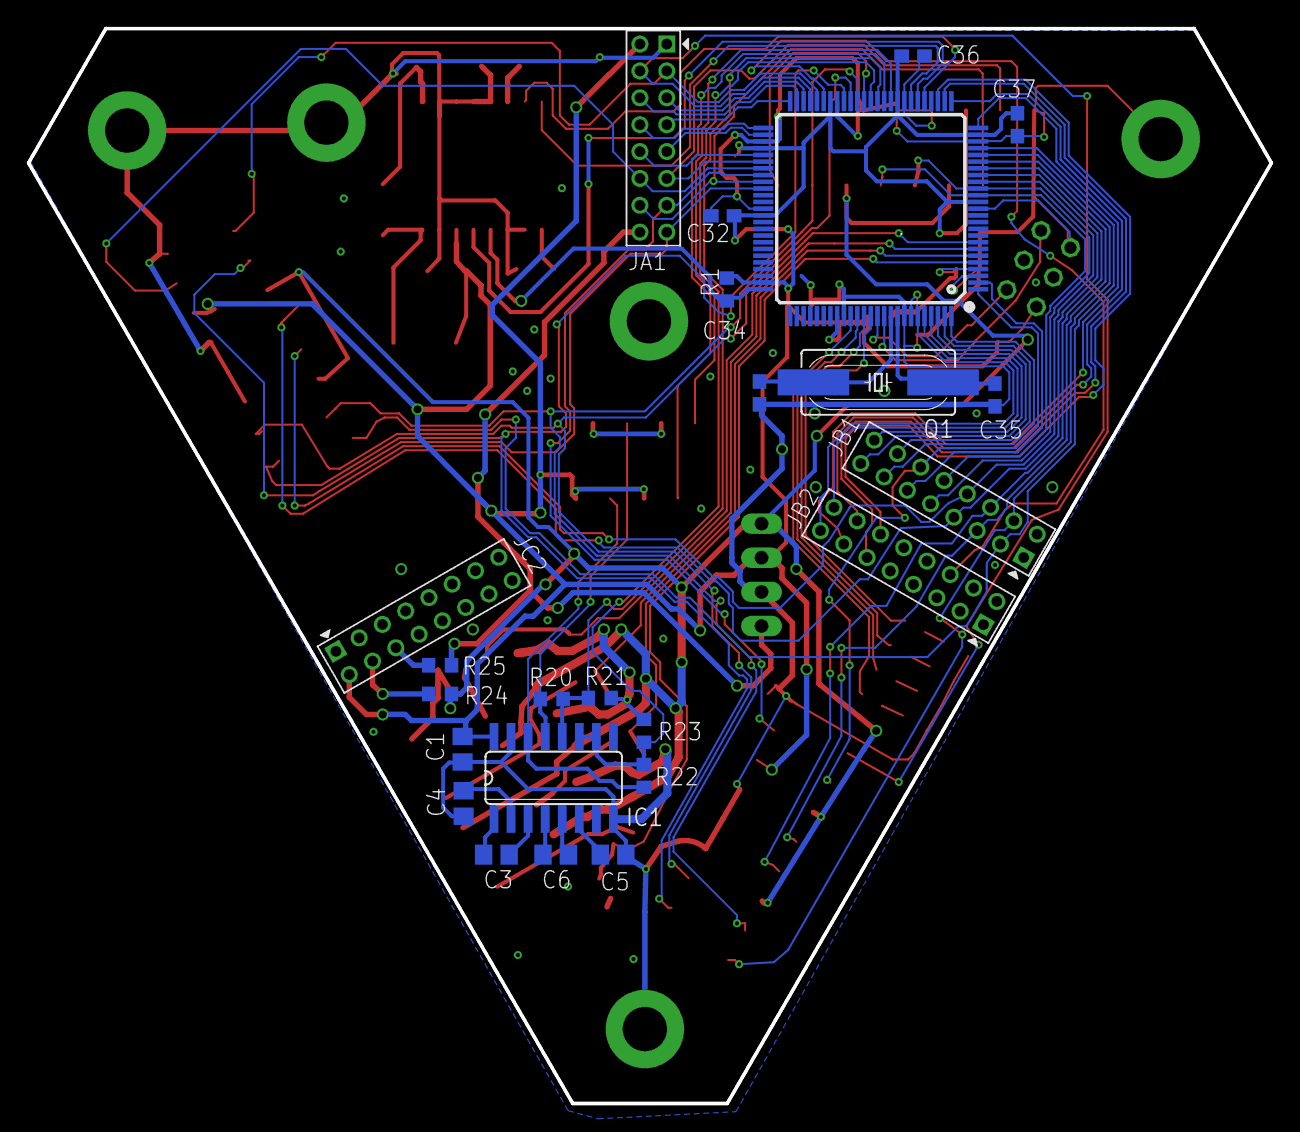
[picture p86: board SuperUnioc_v1.brd from below]

Board: 2 copper layers, 92.5 x 80.0 mm, 71 parts (24 on the bottom side), 85 nets.
