robotter/robotter/hardware/pmi_encoder_rs422_decoder/pmi_encoder_rs422_decoder.brd

## EAGLE design hardware/pmi_encoder_rs422_decoder/pmi_encoder_rs422_decoder.brd (2014-05-28)

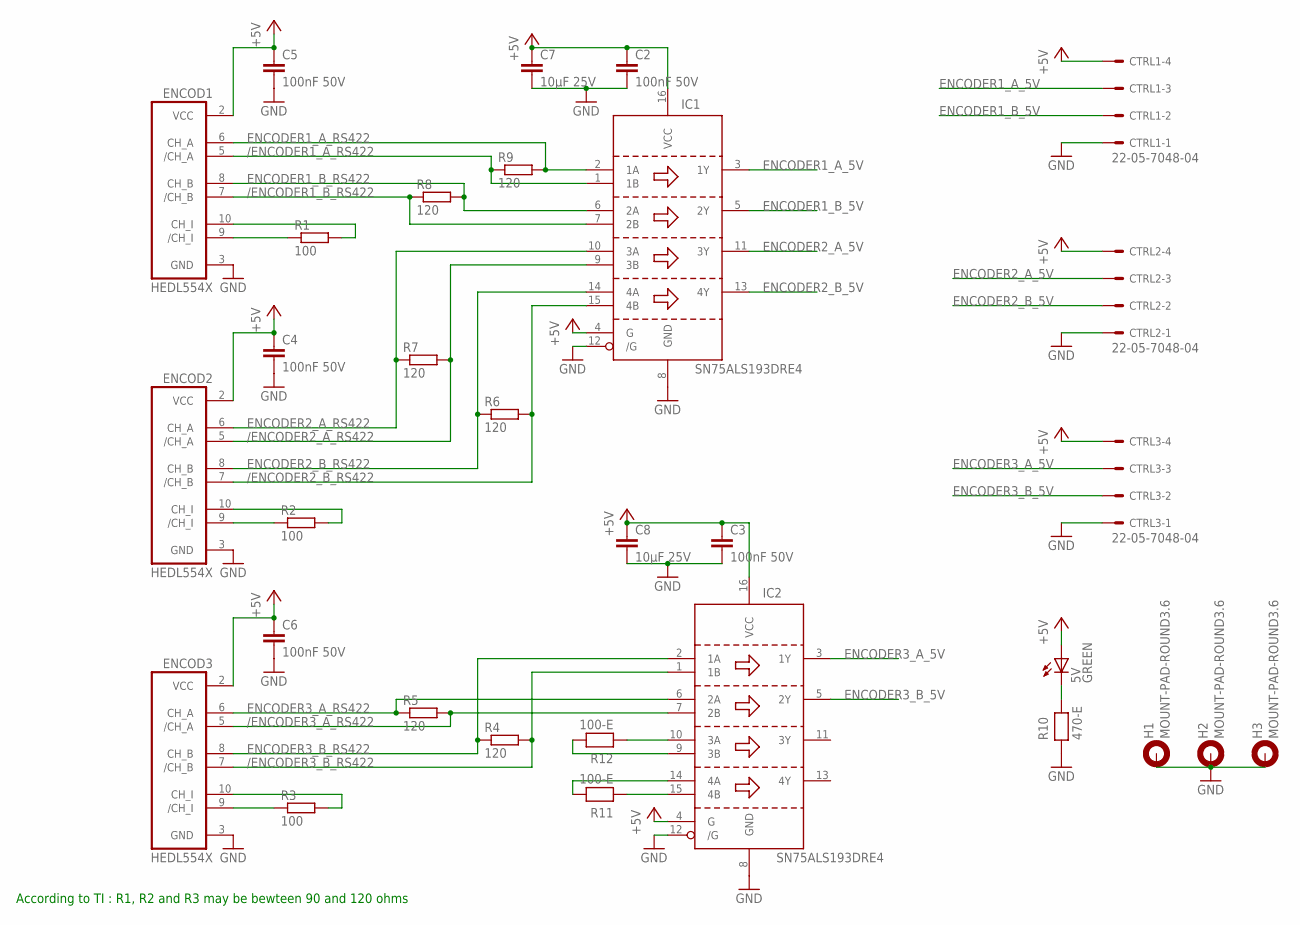
[picture p87: schematic pmi_encoder_rs422_decoder.sch]

Parts:
5V: GREEN; CHIP-LED0805
C2, C3, C4, C5, C6: 100nF 50V; C0805
C7, C8: 10µF 25V; C1210
CTRL1, CTRL2, CTRL3: 22-05-7048-04; 7395-04
ENCOD1, ENCOD2, ENCOD3: HEDL554X; ML10
H1, H2, H3: MOUNT-PAD-ROUND3.6; 3,6-PAD
IC1, IC2: SN75ALS193DRE4; SO16
R1, R2, R3: 100; 0207/7
R4, R5, R6, R7, R8, R9: 120; 0207/7
R10: 470-E; R0805
R11, R12: 100-E; R0805

Connections:
+5V: 5V.A, C2.1, C3.1, C4.1, C5.1, C6.1, C7.1, C8.1, CTRL1.4, CTRL2.4, CTRL3.4, ENCOD1.2 (VCC), ENCOD2.2 (VCC), ENCOD3.2 (VCC), IC1.4 (G), IC1.16 (VCC), IC2.4 (G), IC2.16 (VCC)
/ENCODER1_A_RS422: ENCOD1.5 (/CH_A), IC1.1 (1B), R9.1
/ENCODER1_B_RS422: ENCOD1.7 (/CH_B), IC1.7 (2B), R8.1
/ENCODER2_A_RS422: ENCOD2.5 (/CH_A), IC1.9 (3B), R7.2
/ENCODER2_B_RS422: ENCOD2.7 (/CH_B), IC1.15 (4B), R6.2
/ENCODER3_A_RS422: ENCOD3.5 (/CH_A), IC2.7 (2B), R5.2
/ENCODER3_B_RS422: ENCOD3.7 (/CH_B), IC2.1 (1B), R4.2
ENCODER1_A_5V: CTRL1.3, IC1.3 (1Y)
ENCODER1_A_RS422: ENCOD1.6 (CH_A), IC1.2 (1A), R9.2
ENCODER1_B_5V: CTRL1.2, IC1.5 (2Y)
ENCODER1_B_RS422: ENCOD1.8 (CH_B), IC1.6 (2A), R8.2
ENCODER2_A_5V: CTRL2.3, IC1.11 (3Y)
ENCODER2_A_RS422: ENCOD2.6 (CH_A), IC1.10 (3A), R7.1
ENCODER2_B_5V: CTRL2.2, IC1.13 (4Y)
ENCODER2_B_RS422: ENCOD2.8 (CH_B), IC1.14 (4A), R6.1
ENCODER3_A_5V: CTRL3.3, IC2.3 (1Y)
ENCODER3_A_RS422: ENCOD3.6 (CH_A), IC2.6 (2A), R5.1
ENCODER3_B_5V: CTRL3.2, IC2.5 (2Y)
ENCODER3_B_RS422: ENCOD3.8 (CH_B), IC2.2 (1A), R4.1
GND: C2.2, C3.2, C4.2, C5.2, C6.2, C7.2, C8.2, CTRL1.1, CTRL2.1, CTRL3.1, ENCOD1.3 (GND), ENCOD2.3 (GND), ENCOD3.3 (GND), H1.B3,6, H2.B3,6, H3.B3,6, IC1.8 (GND), IC1.12 (/G), IC2.8 (GND), IC2.12 (/G), R10.1
unnamed: ENCOD3.10 (CH_I), R3.2
unnamed: ENCOD3.9 (/CH_I), R3.1
unnamed: ENCOD2.9 (/CH_I), R2.1
unnamed: ENCOD2.10 (CH_I), R2.2
unnamed: ENCOD1.10 (CH_I), R1.2
unnamed: 5V.C, R10.2
unnamed: IC2.14 (4A), R11.2
unnamed: IC2.9 (3B), R12.2
unnamed: IC2.10 (3A), R12.1
unnamed: ENCOD1.9 (/CH_I), R1.1
unnamed: IC2.15 (4B), R11.1

Notes on the sheet:
According to TI : R1, R2 and R3 may be bewteen 90 and 120 ohms

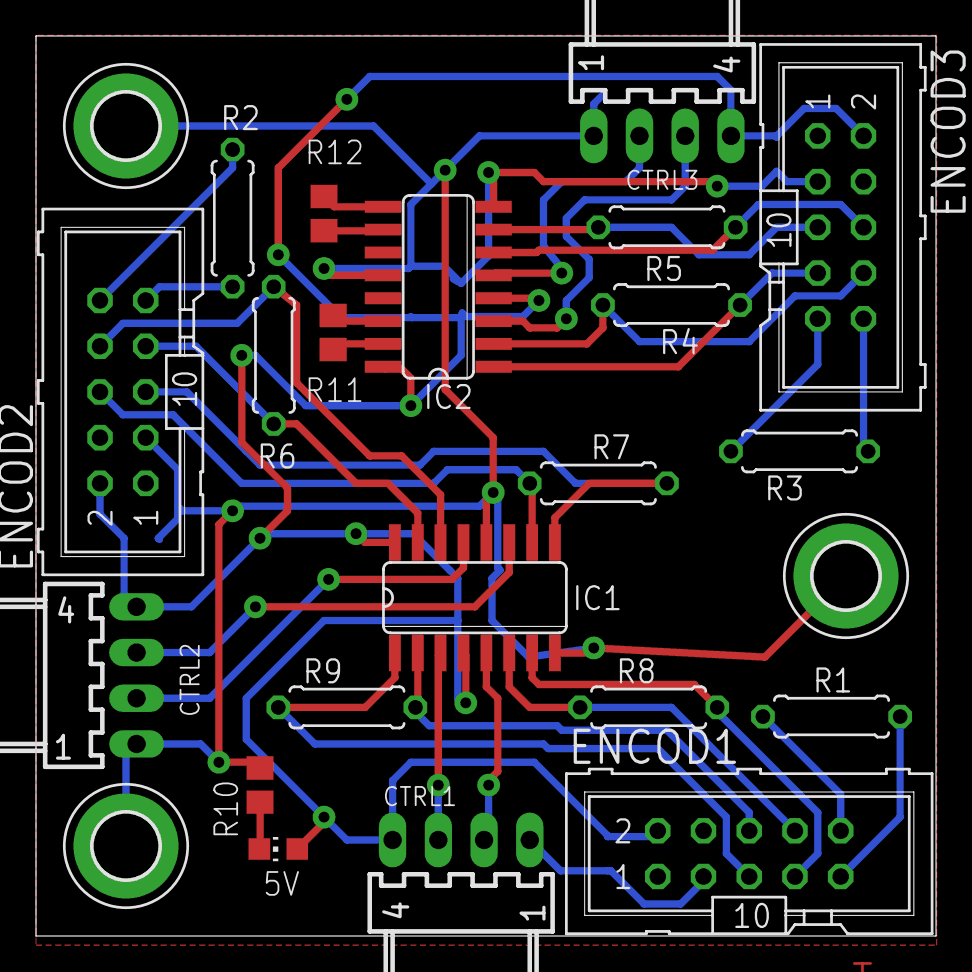
[picture p88: board pmi_encoder_rs422_decoder.brd from above]

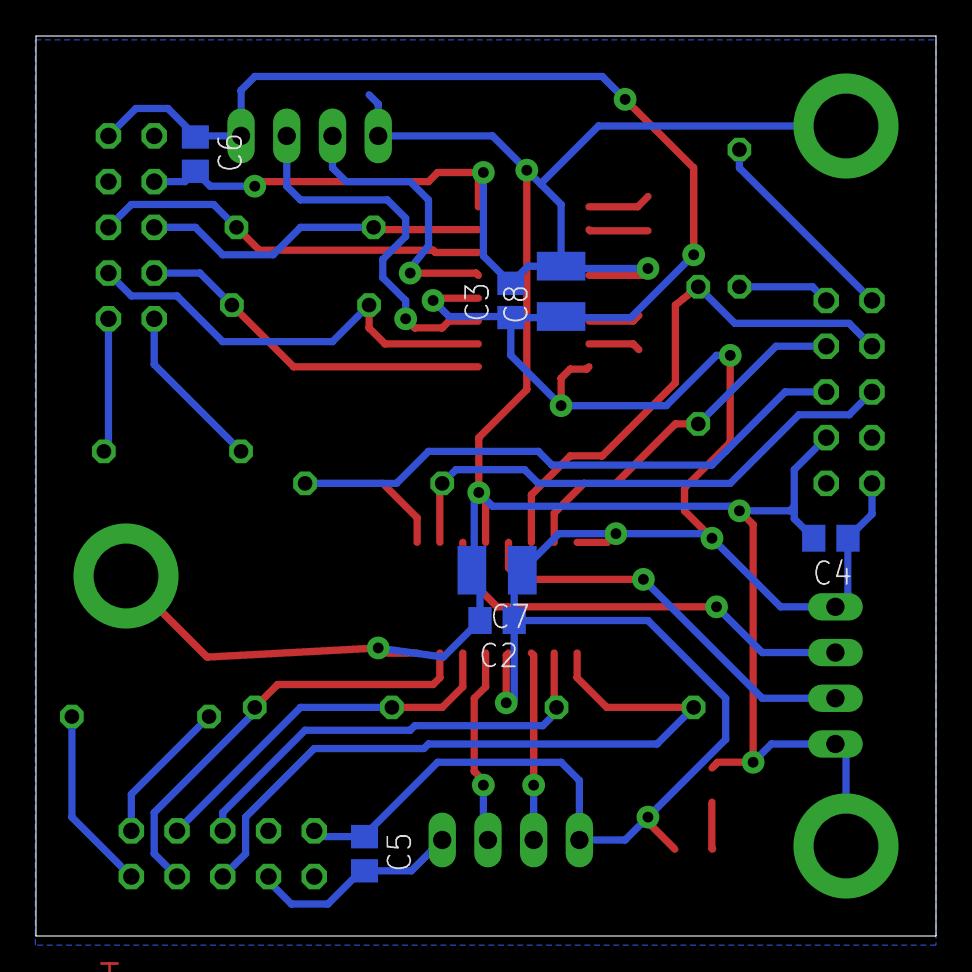
[picture p89: board pmi_encoder_rs422_decoder.brd from below]

Board: 2 copper layers, 50.0 x 50.0 mm, 31 parts (7 on the bottom side), 31 nets.
