robotter/robotter/hardware/prism/prism.brd

## EAGLE design hardware/prism/prism.brd (2014-05-28)

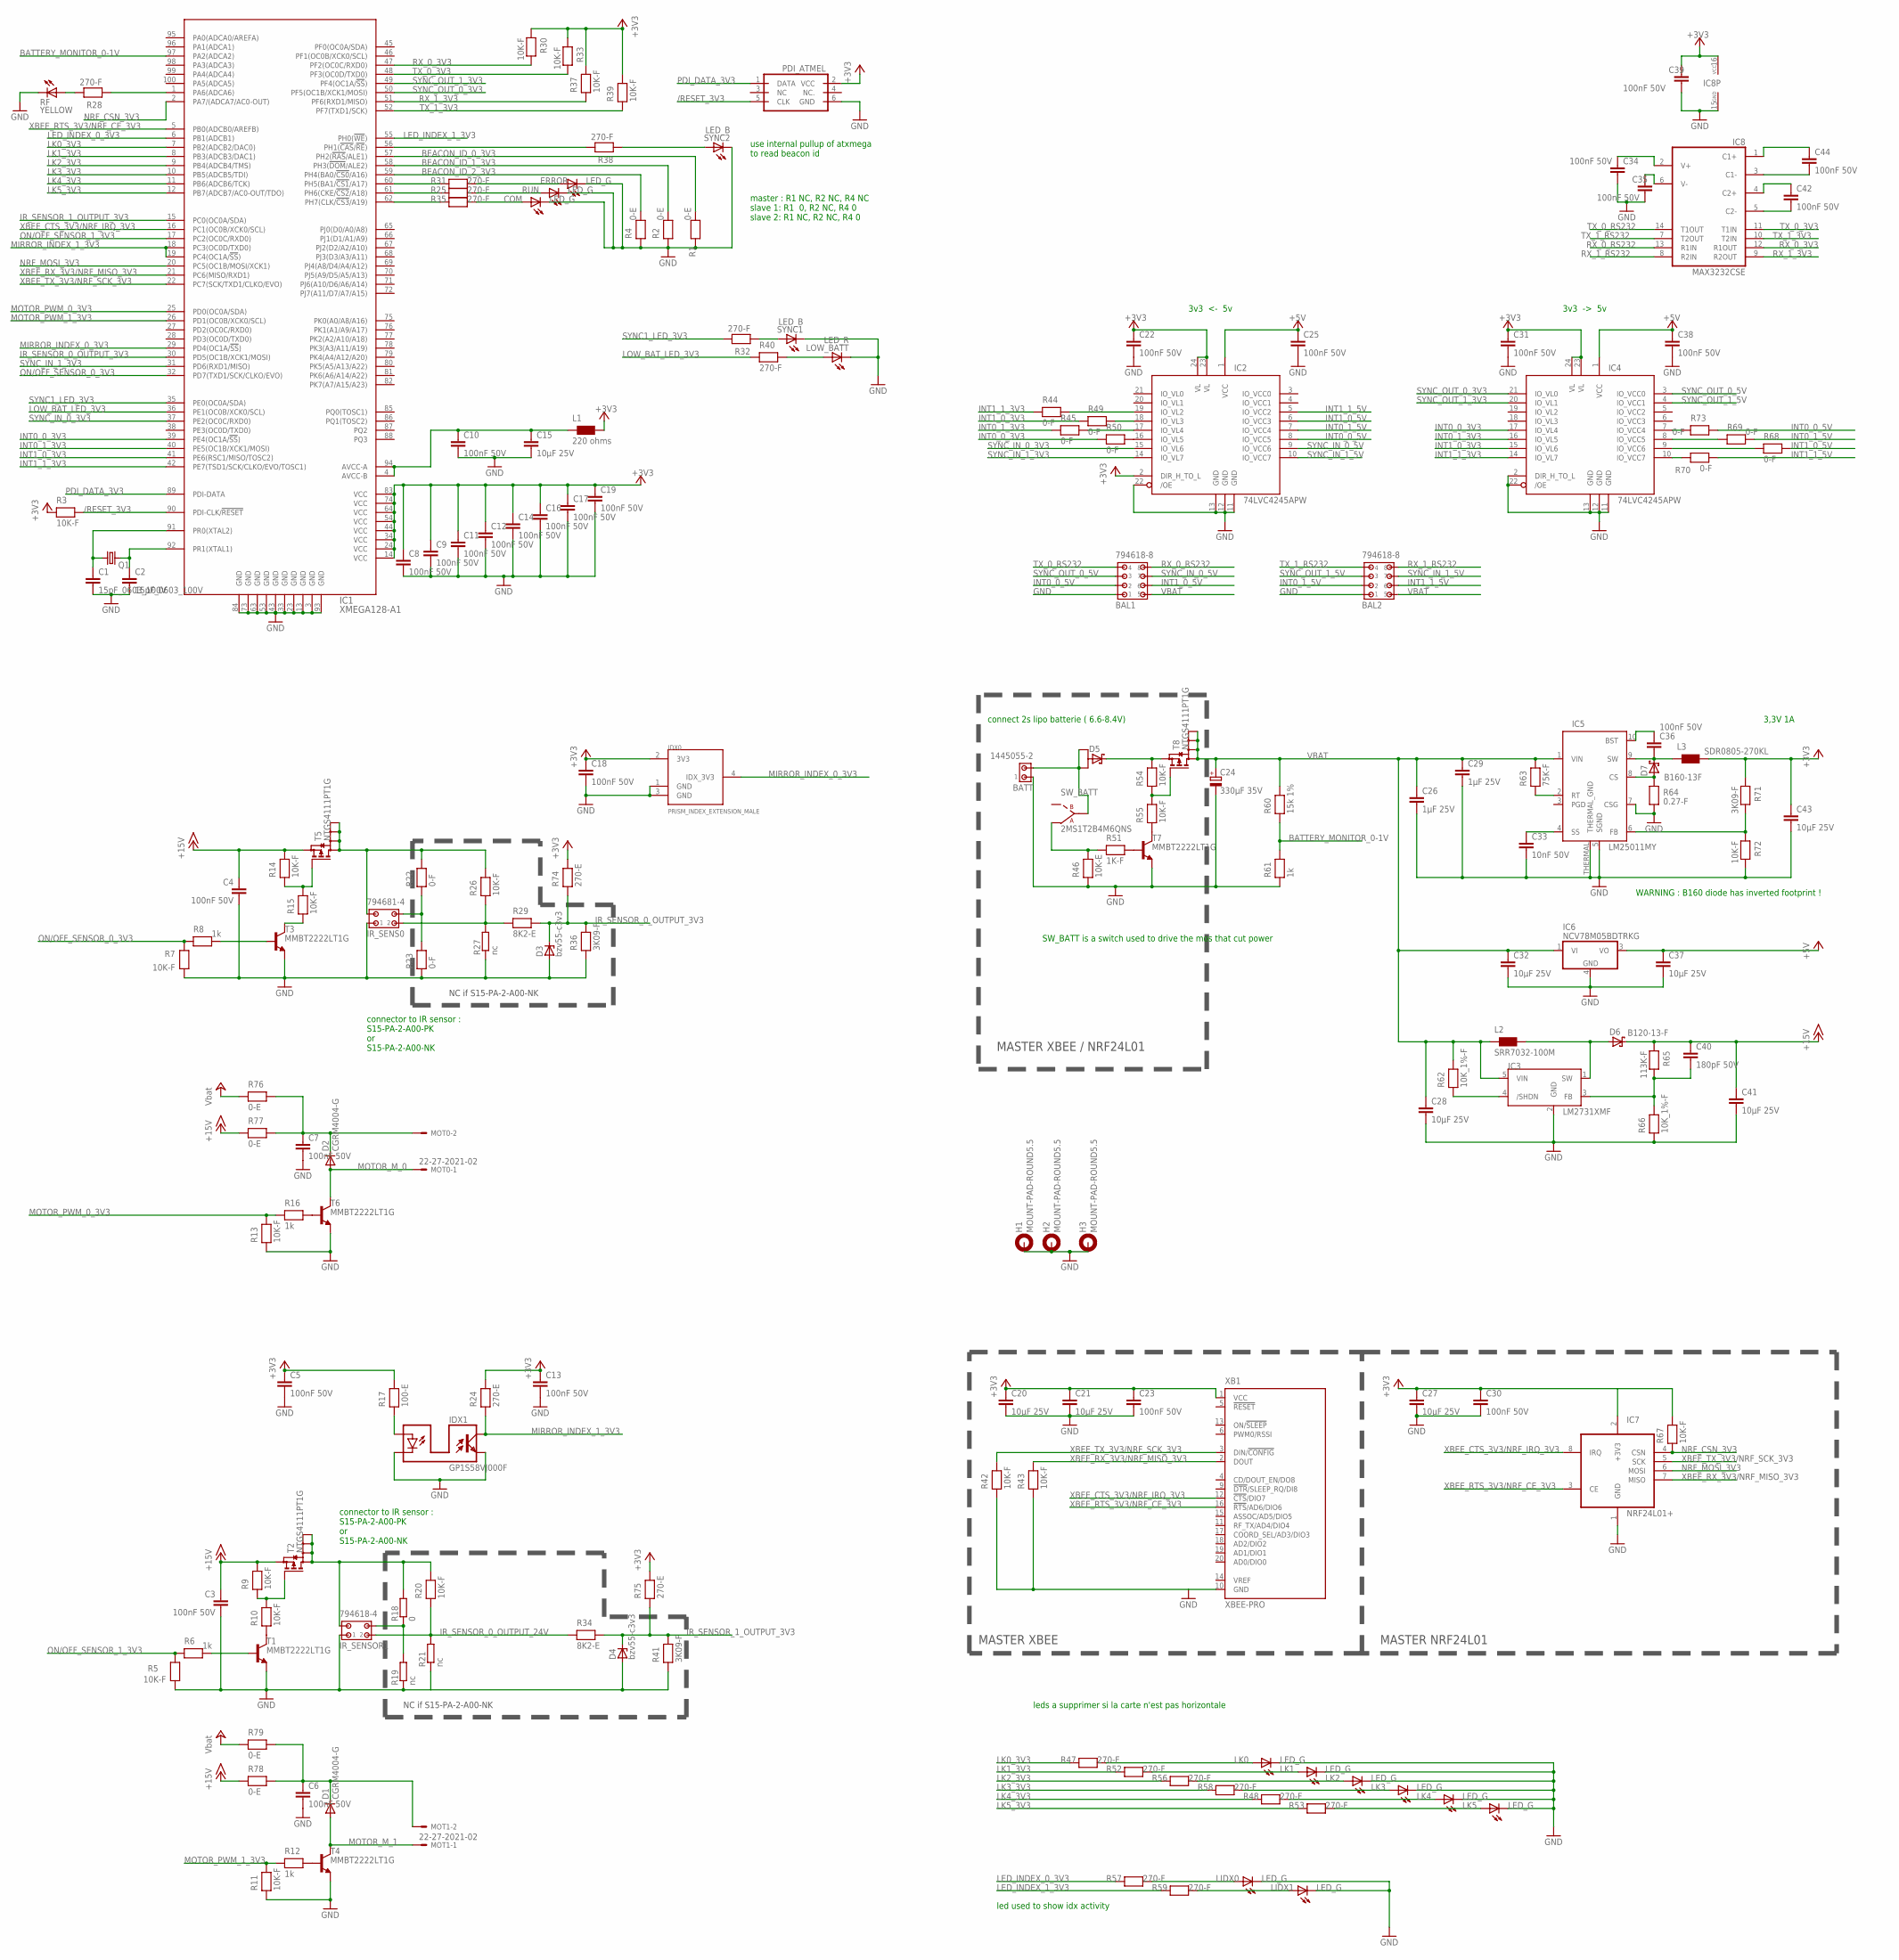
[picture p90: schematic prism.sch]

Parts:
BAL1, BAL2: 794618-8
BATT: 1445055-2
C1, C2: 15pF_0603_100V; C0603
C3, C4, C5, C6, C7, C8, C9, C10, C11, C12, C13, C14, C16, C17, C18, C19, C22, C23, C25, C30, C31, C34, C35, C36, C38, C39, C42, C44: 100nF 50V; C0603
C15, C20, C21, C27, C28, C32, C37, C41, C43: 10µF 25V; C1210
C24: 330µF 35V; PANASONIC_G
C26, C29: 1µF 25V; C1206
C33: 10nF 50V; C0603
C40: 180pF 50V; C0603
COM: LED_G; CHIP-LED0805
D1, D2: CGRM4004-G; SOD-123_MINI-SMA
D3, D4: bzv55-c3v3; SOD80C
D5: 50WQ03; TO252
D6: B120-13-F; SMB
D7: B160-13F; SMA
ERROR: LED_G; CHIP-LED0805
H1, H2, H3: MOUNT-PAD-ROUND5.5; 5,5-PAD
IC1: XMEGA128-A1; TQFP100
IC2, IC4: 74LVC4245APW; TSSOP24
IC3: LM2731XMF; SOT23-5
IC5: LM25011MY; MSOP10_THERMAL
IC6: NCV78M05BDTRKG; DPACK_3
IC7: NRF24L01+
IC8: MAX3232CSE; SO16
IDX0: PRISM_INDEX_EXTENSION_MALE
IDX1: GP1S58VJ000F
IR_SENS0: 794681-4
IR_SENSOR1: 794618-4
L1: 220 ohms; R0603
L2: SRR7032-100M; SRR7032
L3: SDR0805-270KL; SDR0805
LIDX0, LIDX1: LED_G; CHIP-LED0805
LK0, LK1, LK2, LK3, LK4, LK5: LED_G; CHIP-LED0805
LOW_BATT: LED_R; CHIP-LED0805
MOT0, MOT1: 22-27-2021-02; 6410-02
PDI_ATMEL: PDI_ATMELL; ML6L
Q1: CRYSTAL_16MHZ_HC49UP; HC49UP
R1, R2, R4, R76, R77, R78, R79: 0-E; R0805
R3, R5, R7, R9, R10, R11, R13, R14, R15, R20, R26, R30, R33, R37, R39, R42, R43, R54, R55, R67, R72: 10K-F; R0603
R6, R8, R12, R16: 1k; R0603
R17: 100-E; R0805
R18: 0; R0603
R19, R21, R27: nc; R0603
R22, R23, R44, R45, R49, R50, R68, R69, R70, R73: 0-F; R0603
R24, R74, R75: 270-E; R0805
R25, R28, R31, R32, R35, R38, R40, R47, R48, R52, R53, R56, R57, R58, R59: 270-F; R0603
R29, R34: 8K2-E; R0805
R36, R41, R71: 3K09-F; R0603
R46: 10K-E; R0805
R51: 1K-F; R0603
R60: 15k 1%; R0805
R61: 1k; R0805
R62, R66: 10K_1%-F; R0603
R63: 75K-F; R0603
R64: 0.27-F; R0603
R65: 113K-F; R0603
RF: YELLOW; CHIP-LED0805
RUN: LED_G; CHIP-LED0805
SW_BATT: 2MS1T2B4M6QNS
SYNC1, SYNC2: LED_B; CHIP-LED0805
T1, T3, T4, T6, T7: MMBT2222LT1G; SOT23-BEC
T2, T5, T8: NTGS4111PT1G; TSOP-6
XB1: XBEE-PRO

Connections:
+3V3: C5.1, C8.1, C9.1, C11.1, C12.1, C13.1, C14.1, C16.1, C17.1, C18.1, C19.1, C20.1, C21.1, C22.1, C23.1, C27.1, C30.1, C31.1, C39.1, C43.1, IC1.14 (VCC), IC1.24 (VCC), IC1.34 (VCC), IC1.44 (VCC), IC1.54 (VCC), IC1.64 (VCC), IC1.74 (VCC), IC1.83 (VCC), IC2.2 (DIR_H_TO_L), IC2.23 (VL), IC2.24 (VL), IC4.23 (VL), IC4.24 (VL), IC7.2 (+3V3), IC8.16 (VCC), IDX0.2 (3V3), L1.2, L3.2, PDI_ATMEL.2 (VCC), R3.1, R17.2, R24.2, R30.1, R33.1, R37.2, R39.2, R67.2, R71.1, R74.2, R75.2, XB1.1 (VCC)
+5V: C25.1, C37.1, C38.1, IC2.1 (VCC), IC4.1 (VCC), IC6.3 (VO)
+15V: C3.1, C4.1, C40.1, C41.1, D6.C, R9.2, R14.2, R65.1, R77.1, R78.1, T2.4 (S), T5.4 (S)
/RESET_3V3: IC1.90 (PDI-CLK/!RESET), PDI_ATMEL.5 (CLK), R3.2
BATTERY_MONITOR_0-1V: IC1.97 (PA2(ADCA2)), R60.1, R61.2
BEACON_ID_0_3V3: IC1.57 (PH2(!RAS!/ALE1)), R1.2
BEACON_ID_1_3V3: IC1.58 (PH3(!DOM!/ALE2)), R2.2
BEACON_ID_2_3V3: IC1.59 (PH4(BA0/!CS0!/A16)), R4.2
GND: BAL1.1, BAL2.1, BATT.1, C1.2, C2.2, C3.2, C4.2, C5.2, C6.2, C7.2, C8.2, C9.2, C10.2, C11.2, C12.2, C13.2, C14.2, C15.2, C16.2, C17.2, C18.2, C19.2, C20.2, C21.2, C22.2, C23.2, C24.-, C25.2, C26.2, C27.2, C28.2, C29.2, C30.2, C31.2, C32.2, C33.2, C34.2, C35.2, C37.2, C38.2, C39.2, C41.2, C43.2, COM.C, D3.A, D4.A, ERROR.C, H1.B5,5, H2.B5,5, H3.B5,5, IC1.3 (GND), IC1.13 (GND), IC1.23 (GND), IC1.33 (GND), IC1.43 (GND), IC1.53 (GND), IC1.63 (GND), IC1.73 (GND), IC1.84 (GND), IC1.93 (GND), IC2.11 (GND), IC2.12 (GND), IC2.13 (GND), IC2.22 (/OE), IC3.2 (GND), IC4.2 (DIR_H_TO_L), IC4.11 (GND), IC4.12 (GND), IC4.13 (GND), IC4.22 (/OE), IC5.5 (SGND), IC5.7 (CSG), IC5.THERMAL (THERMAL_GND), IC6.4 (GND), IC7.1 (GND), IC8.15 (GND), IDX0.1 (GND), IDX0.3 (GND), IDX1.LED_C, IDX1.TRANSISTOR_E, IR_SENS0.1, IR_SENSOR1.1, LIDX0.C, LIDX1.C, LK0.C, LK1.C, LK2.C, LK3.C, LK4.C, LK5.C, LOW_BATT.C, PDI_ATMEL.6 (GND), R1.1, R2.1, R4.1, R5.1, R7.1, R11.1, R13.1, R19.1, R21.1, R23.1, R27.1, R36.1, R41.1, R42.1, R43.1, R46.1, R61.1, R64.1, R66.1, R72.2, RF.C, RUN.C, SYNC1.C, SYNC2.C, T1.E, T3.E, T4.E, T6.E, T7.E, XB1.10 (GND)
INT0_0_3V3: IC1.39 (PE4(OC1A/!SS!)), IC4.17 (IO_VL4), R50.1
INT0_0_5V: BAL1.2, IC2.8 (IO_VCC5), R73.2
INT0_1_3V3: IC1.40 (PE5(OC1B/XCK1/MOSI)), IC4.16 (IO_VL5), R45.1
INT0_1_5V: BAL2.2, IC2.7 (IO_VCC4), R69.2
INT1_0_3V3: IC1.41 (PE6(RSC1/MISO/TOSC2)), IC4.15 (IO_VL6), R49.1
INT1_0_5V: BAL1.6, IC2.6 (IO_VCC3), R68.2
INT1_1_3V3: IC1.42 (PE7(TSD1/SCK/CLKO/EVO/TOSC1)), IC4.14 (IO_VL7), R44.1
INT1_1_5V: BAL2.6, IC2.5 (IO_VCC2), R70.2
IR_SENSOR_0_OUTPUT_3V3: D3.C, IC1.30 (PD5(OC1B/XCK1/MOSI)), R29.2, R36.2, R74.1
IR_SENSOR_0_OUTPUT_24V: IR_SENSOR1.2, R20.1, R21.2, R34.1
IR_SENSOR_1_OUTPUT_3V3: D4.C, IC1.15 (PC0(OC0A/SDA)), R34.2, R41.2, R75.1
IR_SENSOR_1_OUTPUT_24V: IR_SENS0.2, R26.1, R27.2, R29.1
LED_INDEX_0_3V3: IC1.6 (PB1(ADCB1)), R57.1
LED_INDEX_1_3V3: IC1.55 (PH0(!WE!)), R59.1
LK0_3V3: IC1.7 (PB2(ADCB2/DAC0)), R47.1
LK1: LK2.A, R56.2
LK1_3V3: IC1.8 (PB3(ADCB3/DAC1)), R52.1
LK2_3V3: IC1.9 (PB4(ADCB4/TMS)), R56.1
LK3_3V3: IC1.10 (PB5(ADCB5/TDI)), R58.1
LK4_3V3: IC1.11 (PB6(ADCB6/TCK)), R48.1
LK5: LIDX0.A, R57.2
LK5_3V3: IC1.12 (PB7(ADCB7/AC0-OUT/TDO)), R53.1
LOW_BAT_LED_3V3: IC1.36 (PE1(OC0B/XCK0/SCL)), R40.1
MIRROR_INDEX_0_3V3: IC1.29 (PD4(OC1A/!SS!)), IDX0.4 (IDX_3V3)
MIRROR_INDEX_1_3V3: IC1.18 (PC3(OC0D/TXD0)), IC1.19 (PC4(OC1A/!SS!)), IDX1.TRANSISTOR_C, R24.1
MOTOR_M_0: D2.A, MOT0.1, T6.C
MOTOR_M_1: D1.A, MOT1.1, T4.C
MOTOR_PWM_0_3V3: IC1.25 (PD0(OC0A/SDA)), R13.2, R16.1
MOTOR_PWM_1_3V3: IC1.26 (PD1(OC0B/XCK0/SCL)), R11.2, R12.1
unnamed: C44.1, IC8.1 (C1+)
unnamed: R25.2, RUN.A
unnamed: R12.2, T4.B
unnamed: ERROR.A, R31.2
unnamed: C44.2, IC8.3 (C1-)
unnamed: C42.1, IC8.4 (C2+)
unnamed: COM.A, R35.2
unnamed: C10.1, C15.1, IC1.4 (AVCC-B), IC1.94 (AVCC-A), L1.1
unnamed: IC1.61 (PH6(CKE/!CS2!/A18)), R25.1
unnamed: IC1.60 (PH5(BA1/!CS1!/A17)), R31.1
unnamed: C34.1, IC8.2 (V+)
unnamed: IC1.62 (PH7(CLK/!CS3!/A19)), R35.1
unnamed: C35.1, IC8.6 (V-)
unnamed: R14.1, R15.2, T5.3 (G)
unnamed: R8.2, T3.B
unnamed: R15.1, T3.C
unnamed: R16.2, T6.B
unnamed: LK0.A, R47.2
unnamed: LK1.A, R52.2
unnamed: LK3.A, R58.2
unnamed: BATT.2, D5.1 (A1), D5.3 (A2), SW_BATT.2 (1)
unnamed: C42.2, IC8.5 (C2-)
unnamed: R51.2, T7.B
unnamed: R54.1, R55.2, T8.3 (G)
unnamed: R28.2, RF.A
unnamed: IC1.1 (PA6(ADCA6)), R28.1
unnamed: R55.1, T7.C
unnamed: D5.4 (C), R54.2, T8.4 (S)
unnamed: IC1.56 (PH1(!CAS!/!RE!)), R38.2
unnamed: R38.1, SYNC2.A
unnamed: LOW_BATT.A, R40.2
unnamed: R32.1, SYNC1.A
unnamed: R6.2, T1.B
unnamed: C36.2, D7.C, IC5.9 (SW), L3.1
unnamed: D7.A, IC5.8 (CS), R64.2
unnamed: IC5.2 (RT), R63.1
unnamed: IR_SENS0.4, R22.1, R23.2
unnamed: R10.1, T1.C
unnamed: C33.1, IC5.4 (SS)
unnamed: IC5.6 (FB), R71.2, R72.1
unnamed: C1.1, IC1.91 (PR0(XTAL2)), Q1.1
unnamed: C2.1, IC1.92 (PR1(XTAL1)), Q1.2
unnamed: IC4.10 (IO_VCC7), R70.1
unnamed: C36.1, IC5.10 (BST)
unnamed: IC2.19 (IO_VL2), R44.2
unnamed: IC2.17 (IO_VL4), R45.2
unnamed: IC2.18 (IO_VL3), R49.2
unnamed: IC2.16 (IO_VL5), R50.2
unnamed: IC4.9 (IO_VCC6), R68.1
unnamed: IC4.7 (IO_VCC4), R73.1
unnamed: IC4.8 (IO_VCC5), R69.1
unnamed: IR_SENSOR1.3, R18.2, R20.2, T2.1 (D), T2.2 (D), T2.5 (D), T2.6 (D)
unnamed: IDX1.LED_A, R17.1
unnamed: IR_SENS0.3, R22.2, R26.2, T5.1 (D), T5.2 (D), T5.5 (D), T5.6 (D)
unnamed: D6.A, IC3.1 (SW), L2.2
unnamed: C40.2, IC3.3 (FB), R65.2, R66.2
unnamed: IC3.4 (/SHDN), R62.1
unnamed: LK4.A, R48.2
unnamed: LK5.A, R53.2
unnamed: LIDX1.A, R59.2
unnamed: R9.1, R10.2, T2.3 (G)
unnamed: IR_SENSOR1.4, R18.1, R19.2
NRF_CSN_3V3: IC1.2 (PA7/(ADCA7/AC0-OUT)), IC7.4 (CSN), R67.1
NRF_MOSI_3V3: IC1.20 (PC5(OC1B/MOSI/XCK1)), IC7.6 (MOSI)
ON/OFF_SENSOR_0_3V3: IC1.32 (PD7(TXD1/SCK/CLKO/EVO)), R7.2, R8.1
ON/OFF_SENSOR_1_3V1: R46.2, R51.1, SW_BATT.3
ON/OFF_SENSOR_1_3V3: IC1.17 (PC2(OC0C/RXD0)), R5.2, R6.1
PDI_DATA_3V3: IC1.89 (PDI-DATA), PDI_ATMEL.1 (DATA)
RX_0_3V3: IC1.47 (PF2(OC0C/RXD0)), IC8.12 (R1OUT), R30.2
RX_0_RS232: BAL1.8, IC8.13 (R1IN)
RX_1_3V3: IC1.51 (PF6(RXD1/MISO)), IC8.9 (R2OUT), R37.1
RX_1_RS232: BAL2.8, IC8.8 (R2IN)
SYNC1_LED_3V3: IC1.35 (PE0(OC0A/SDA)), R32.2
SYNC_IN_0_3V3: IC1.37 (PE2(OC0C/RXD0)), IC2.15 (IO_VL6)
SYNC_IN_0_5V: BAL1.7, IC2.9 (IO_VCC6)
SYNC_IN_1_3V3: IC1.31 (PD6(RXD1/MISO)), IC2.14 (IO_VL7)
SYNC_IN_1_5V: BAL2.7, IC2.10 (IO_VCC7)
SYNC_OUT_0_3V3: IC1.50 (PF5(OC1B/XCK1/MOSI)), IC4.21 (IO_VL0)
SYNC_OUT_0_5V: BAL1.3, IC4.3 (IO_VCC0)
SYNC_OUT_1_3V3: IC1.49 (PF4(OC1A/!SS!)), IC4.20 (IO_VL1)
SYNC_OUT_1_5V: BAL2.3, IC4.4 (IO_VCC1)
TX_0_3V3: IC1.48 (PF3(OC0D/TXD0)), IC8.11 (T1IN), R33.2
TX_0_RS232: BAL1.4, IC8.14 (T1OUT)
TX_1_3V3: IC1.52 (PF7(TXD1/SCK)), IC8.10 (T2IN), R39.1
TX_1_RS232: BAL2.4, IC8.7 (T2OUT)
VBAT: BAL1.5, BAL2.5, C24.+, C26.1, C28.1, C29.1, C32.1, IC3.5 (VIN), IC5.1 (VIN), IC6.1 (VI), L2.1, R60.2, R62.2, R63.2, R76.1, R79.1, T8.1 (D), T8.2 (D), T8.5 (D), T8.6 (D)
VCC_MOT0: C7.1, D2.C, MOT0.2, R76.2, R77.2
VCC_MOT1: C6.1, D1.C, MOT1.2, R78.2, R79.2
XBEE_CTS_3V3/NRF_IRQ_3V3: IC1.16 (PC1(OC0B/XCK0/SCL)), IC7.8 (IRQ), XB1.12 (!CTS!/DIO7)
XBEE_RTS_3V3/NRF_CE_3V3: IC1.5 (PB0(ADCB0/AREFB)), IC7.3 (CE), XB1.16 (!RTS!/AD6/DIO6)
XBEE_RX_3V3/NRF_MISO_3V3: IC1.21 (PC6(MISO/RXD1)), IC7.7 (MISO), R43.2, XB1.2 (DOUT)
XBEE_TX_3V3/NRF_SCK_3V3: IC1.22 (PC7(SCK/TXD1/CLKO/EVO)), IC7.5 (SCK), R42.2, XB1.3 (DIN/!CONFIG)

Notes on the sheet:
leds a supprimer si la carte n'est pas horizontale
3v3 <- 5v
3v3 -> 5v
connect 2s lipo batterie ( 6.6-8.4V)
use internal pullup of atxmega to read beacon id
SW_BATT is a switch used to drive the mos that cut power
led used to show idx activity
3,3V 1A
connector to IR sensor : S15-PA-2-A00-PK or S15-PA-2-A00-NK
MASTER XBEE
MASTER NRF24L01
MASTER XBEE / NRF24L01
WARNING : B160 diode has inverted footprint !
master : R1 NC, R2 NC, R4 NC slave 1: R1 0, R2 NC, R4 0 slave 2: R1 NC, R2 NC, R4 0
NC if S15-PA-2-A00-NK

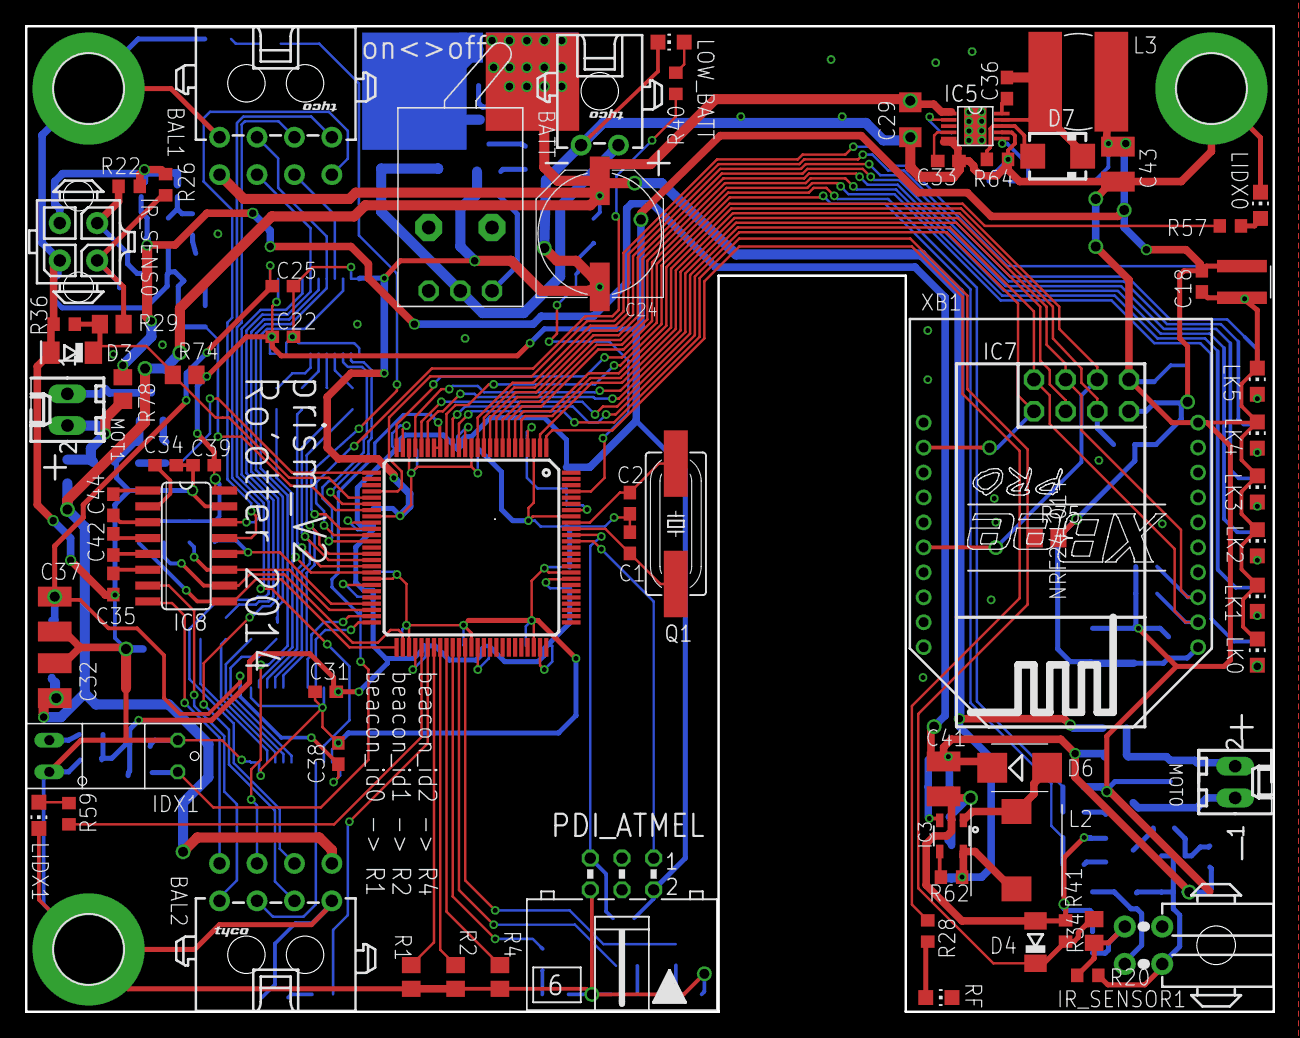
[picture p91: board prism.brd from above]

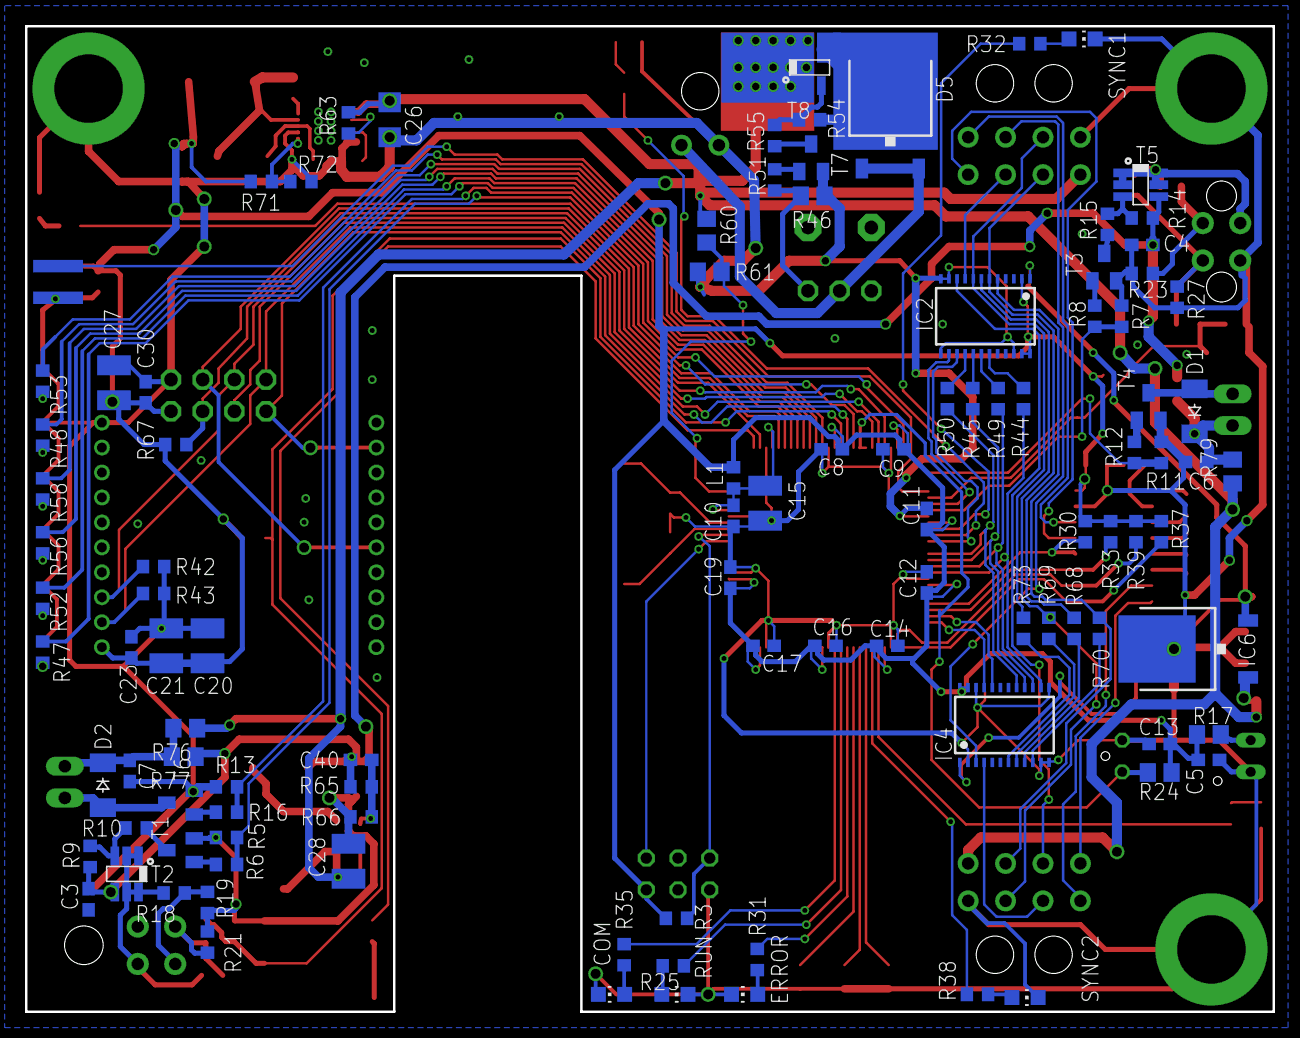
[picture p92: board prism.brd from below]

Board: 2 copper layers, 100.0 x 79.0 mm, 180 parts (104 on the bottom side), 130 nets.
