robotter/robotter/hardware/meca_2014_VaccumSystemExtension/meca_2014_VaccumSystemExtension.brd

## EAGLE design hardware/meca_2014_VaccumSystemExtension/meca_2014_VaccumSystemExtension.brd (2014-04-25)

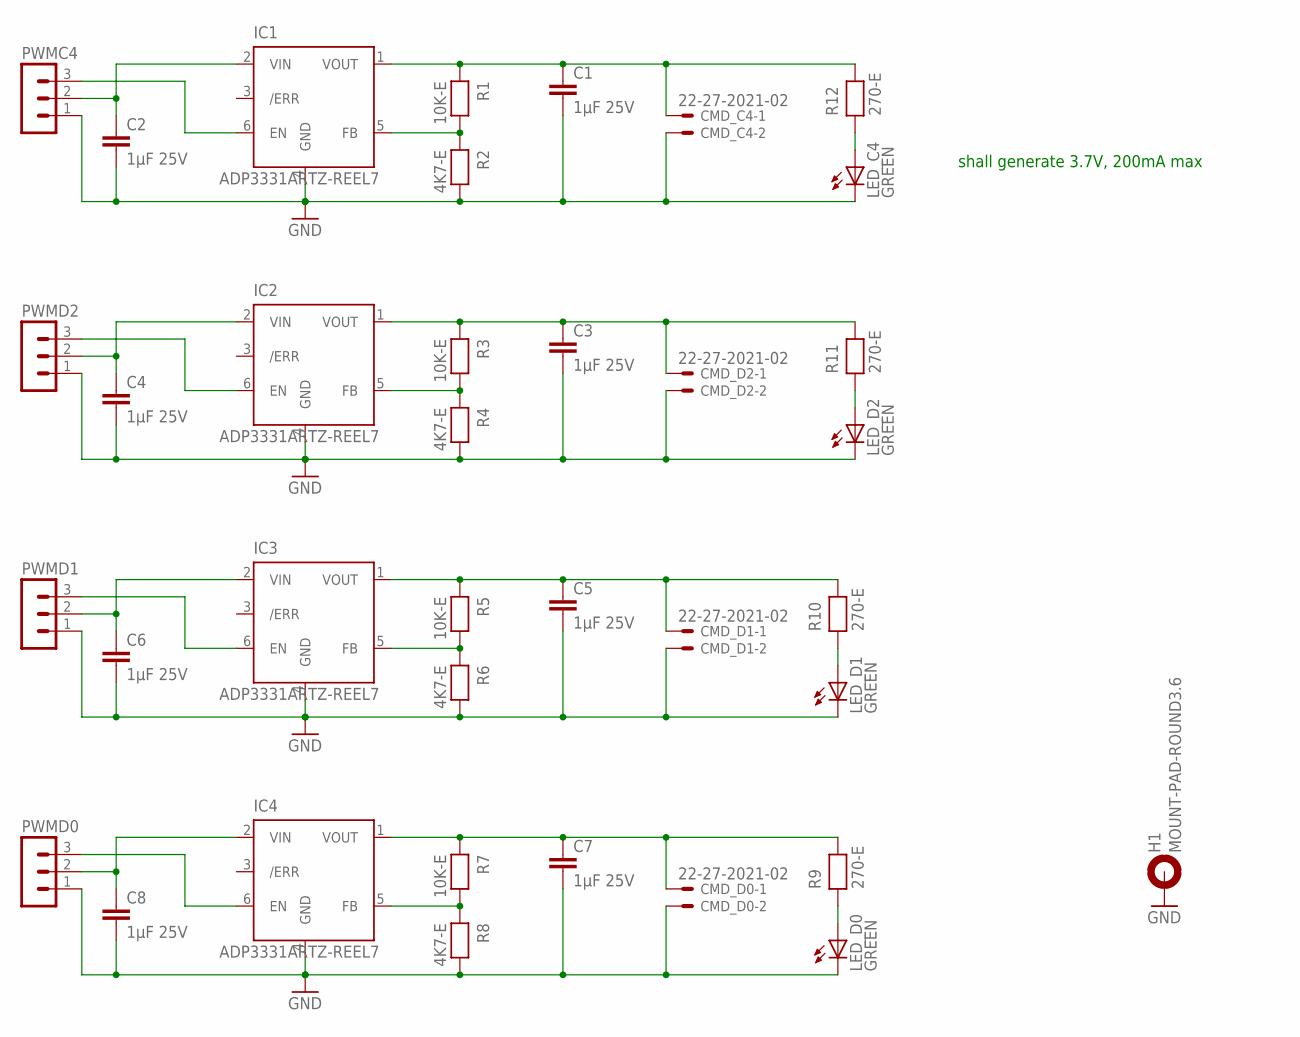
[picture p93: schematic meca_2014_VaccumSystemExtension.sch]

Parts:
C1, C2, C3, C4, C5, C6, C7, C8: 1µF 25V; C1206
CMD_C4: 22-27-2021-02; 6410-02
CMD_D0, CMD_D1, CMD_D2: 22-27-2021-02; 6410-02
H1: MOUNT-PAD-ROUND3.6; 3,6-PAD
IC1, IC2, IC3, IC4: ADP3331ARTZ-REEL7; SOT23-6
LED_C4: GREEN; CHIP-LED0805
LED_D0, LED_D1, LED_D2: GREEN; CHIP-LED0805
PWMC4: MA03-1
PWMD0, PWMD1, PWMD2: MA03-1
R1, R3, R5, R7: 10K-E; R0805
R2, R4, R6, R8: 4K7-E; R0805
R9, R10, R11, R12: 270-E; R0805

Connections:
5V_C4: C2.1, IC1.2 (VIN), PWMC4.2
5V_D0: C8.1, IC4.2 (VIN), PWMD0.2
5V_D1: C6.1, IC3.2 (VIN), PWMD1.2
5V_D2: C4.1, IC2.2 (VIN), PWMD2.2
GND: C1.2, C2.2, C3.2, C4.2, C5.2, C6.2, C7.2, C8.2, CMD_C4.2, CMD_D0.2, CMD_D1.2, CMD_D2.2, H1.B3,6, IC1.4 (GND), IC2.4 (GND), IC3.4 (GND), IC4.4 (GND), LED_C4.C, LED_D0.C, LED_D1.C, LED_D2.C, PWMC4.1, PWMD0.1, PWMD1.1, PWMD2.1, R2.2, R4.2, R6.2, R8.2
unnamed: IC1.5 (FB), R1.2, R2.1
unnamed: IC2.5 (FB), R3.2, R4.1
unnamed: C1.1, CMD_C4.1, IC1.1 (VOUT), R1.1, R12.2
unnamed: LED_D0.A, R9.1
unnamed: LED_D1.A, R10.1
unnamed: C3.1, CMD_D2.1, IC2.1 (VOUT), R3.1, R11.2
unnamed: LED_C4.A, R12.1
unnamed: LED_D2.A, R11.1
unnamed: IC3.5 (FB), R5.2, R6.1
unnamed: C5.1, CMD_D1.1, IC3.1 (VOUT), R5.1, R10.2
unnamed: IC4.5 (FB), R7.2, R8.1
unnamed: C7.1, CMD_D0.1, IC4.1 (VOUT), R7.1, R9.2
PWM_C4_5V: IC1.6 (EN), PWMC4.3
PWM_D0_5V: IC4.6 (EN), PWMD0.3
PWM_D1_5V: IC3.6 (EN), PWMD1.3
PWM_D2_5V: IC2.6 (EN), PWMD2.3

Notes on the sheet:
shall generate 3.7V, 200mA max

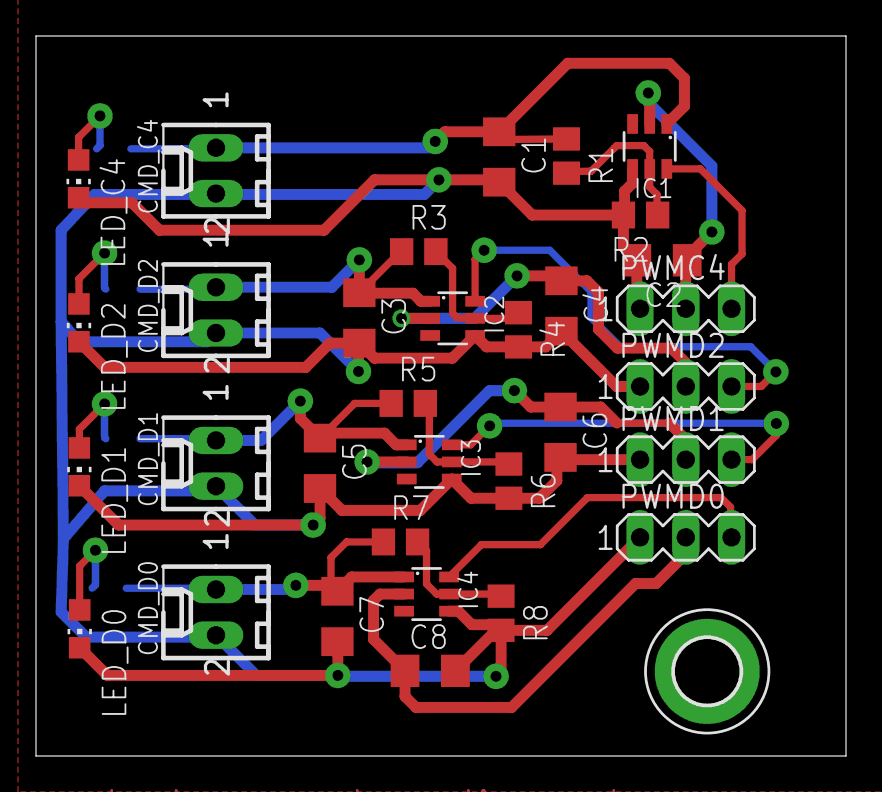
[picture p94: board meca_2014_VaccumSystemExtension.brd from above]

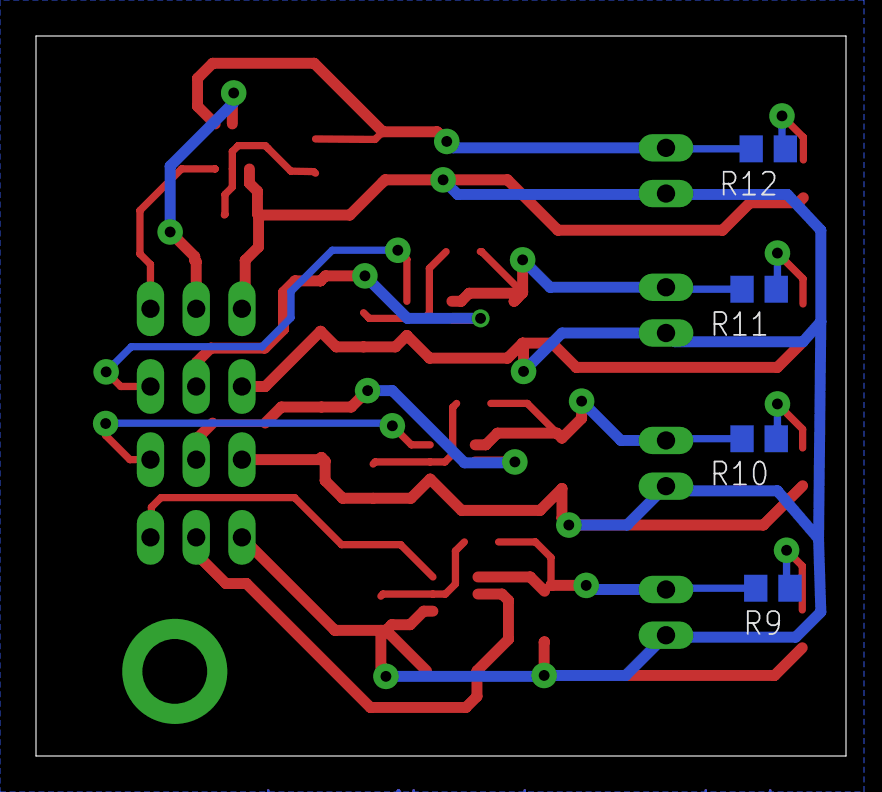
[picture p95: board meca_2014_VaccumSystemExtension.brd from below]

Board: 2 copper layers, 45.0 x 40.0 mm, 37 parts (4 on the bottom side), 21 nets.
