robotter/robotter/hardware/prism_idx_support/prism_idx_support.brd

## EAGLE design hardware/prism_idx_support/prism_idx_support.brd (2014-03-29)

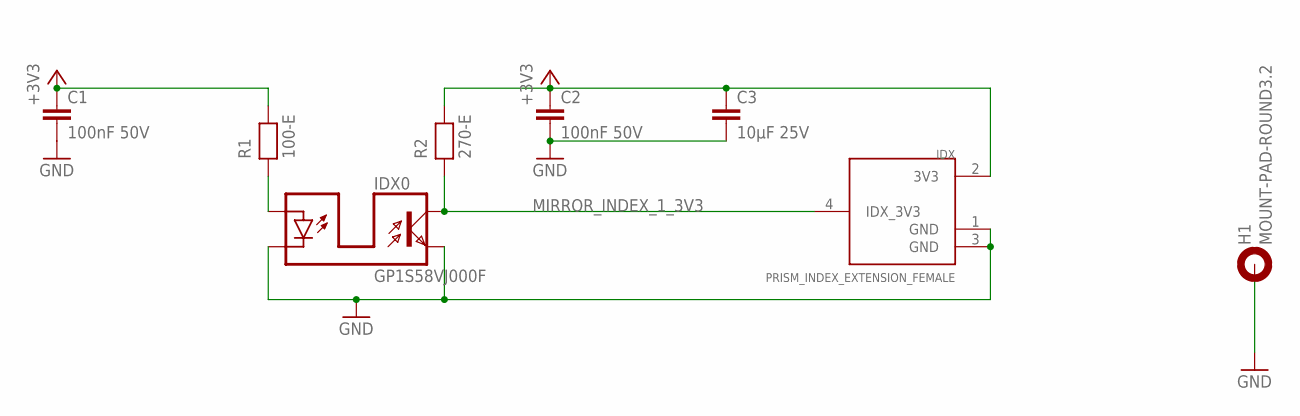
[picture p96: schematic prism_idx_support.sch]

Parts:
C1, C2: 100nF 50V; C0603
C3: 10µF 25V; C1210
H1: MOUNT-PAD-ROUND3.2; 3,2-PAD
IDX: PRISM_INDEX_EXTENSION_FEMALE
IDX0: GP1S58VJ000F
R1: 100-E; R0805
R2: 270-E; R0805

Connections:
+3V3: C1.1, C2.1, C3.1, IDX.2 (3V3), R1.2, R2.2
GND: C1.2, C2.2, C3.2, H1.B3,2, IDX.1 (GND), IDX.3 (GND), IDX0.LED_C, IDX0.TRANSISTOR_E
MIRROR_INDEX_1_3V3: IDX.4 (IDX_3V3), IDX0.TRANSISTOR_C, R2.1
unnamed: IDX0.LED_A, R1.1

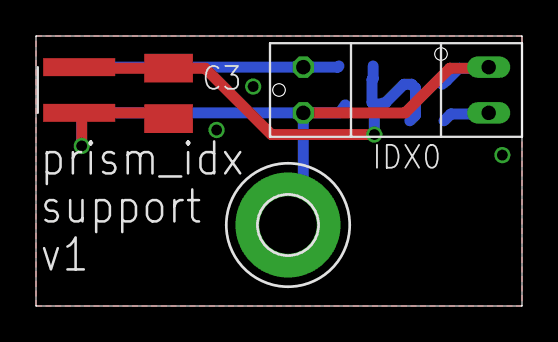
[picture p97: board prism_idx_support.brd from above]

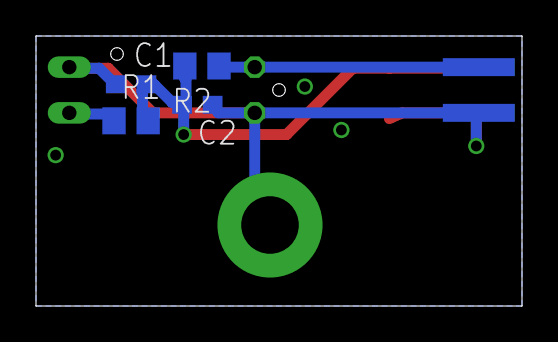
[picture p98: board prism_idx_support.brd from below]

Board: 2 copper layers, 27.0 x 15.0 mm, 8 parts (4 on the bottom side), 4 nets.
