robotter/robotter/hardware/SuperUnioc_AnalogServosExtension/SUperUnioc_analog_ServosExtension.brd

## EAGLE design hardware/SuperUnioc_AnalogServosExtension/SUperUnioc_analog_ServosExtension.brd (2014-03-29)

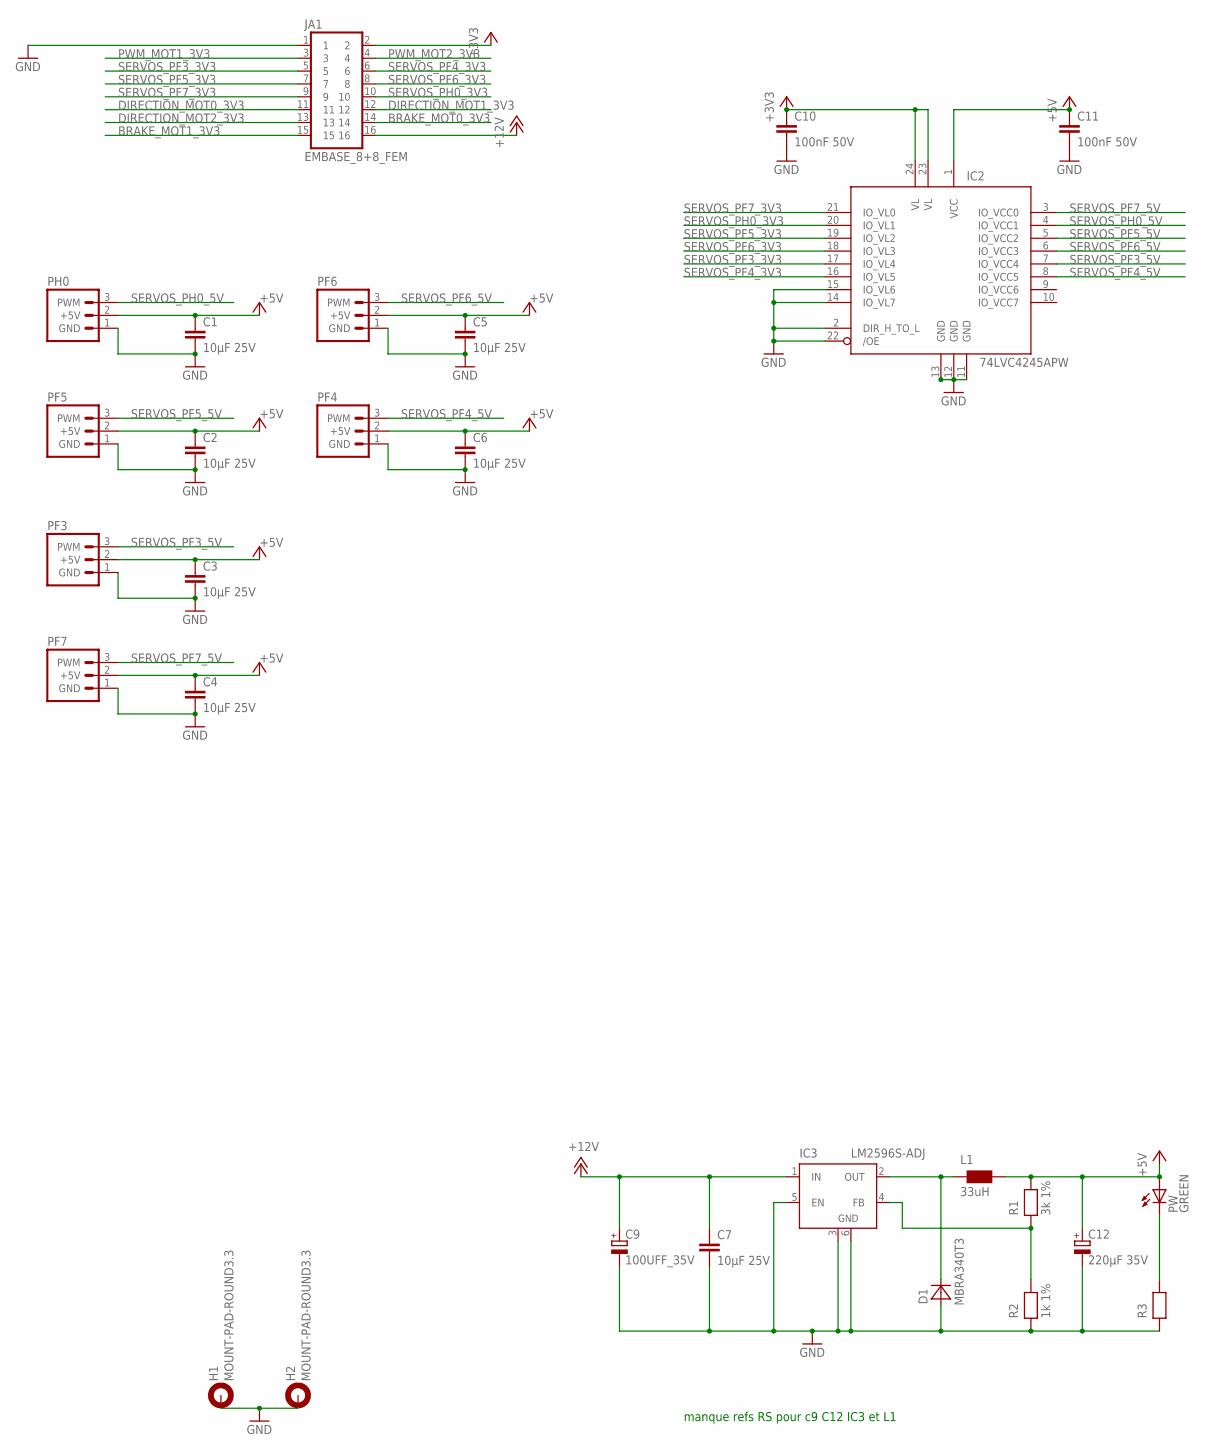
[picture p99: schematic SUperUnioc_analog_ServosExtension.sch]

Parts:
C1, C2, C3, C4, C5, C6, C7: 10µF 25V; C1210
C9: 100UFF_35V; PANASONIC_F
C10, C11: 100nF 50V; C0603
C12: 220µF 35V; PANASONIC_F
D1: MBRA340T3; SMA
H1, H2: MOUNT-PAD-ROUND3.3; 3,3-PAD
IC2: 74LVC4245APW; TSSOP24
IC3: LM2596S-ADJ; TO263-5
JA1: EMBASE_8+8_FEM
L1: 33uH; SRR1280
PF3, PF4, PF5, PF6, PF7: ANALOG_SERVO; ANALOG_SERVOS
PH0: ANALOG_SERVO; ANALOG_SERVOS
PW: GREEN; CHIP-LED0805
R1: 3k 1%; R0603
R2: 1k 1%; R0603
R3: 470-F; R0603

Connections:
+3V3: C10.1, IC2.23 (VL), IC2.24 (VL), JA1.2
+5V: C1.1, C2.1, C3.1, C4.1, C5.1, C6.1, C11.1, C12.+, IC2.1 (VCC), L1.2, PF3.2 (+5V), PF4.2 (+5V), PF5.2 (+5V), PF6.2 (+5V), PF7.2 (+5V), PH0.2 (+5V), PW.A, R1.2
+12V: C7.1, C9.+, IC3.1 (IN), JA1.16
BRAKE_MOT0_3V3: JA1.14
BRAKE_MOT1_3V3: JA1.15
DIRECTION_MOT0_3V3: JA1.11
DIRECTION_MOT1_3V3: JA1.12
DIRECTION_MOT2_3V3: JA1.13
GND: C1.2, C2.2, C3.2, C4.2, C5.2, C6.2, C7.2, C9.-, C10.2, C11.2, C12.-, D1.A, H1.B3,3, H2.B3,3, IC2.2 (DIR_H_TO_L), IC2.11 (GND), IC2.12 (GND), IC2.13 (GND), IC2.14 (IO_VL7), IC2.15 (IO_VL6), IC2.22 (/OE), IC3.3 (GND), IC3.5 (EN), IC3.6 (GND), JA1.1, PF3.1 (GND), PF4.1 (GND), PF5.1 (GND), PF6.1 (GND), PF7.1 (GND), PH0.1 (GND), R2.1, R3.1
unnamed: PW.C, R3.2
unnamed: IC3.4 (FB), R1.1, R2.2
unnamed: D1.C, IC3.2 (OUT), L1.1
PWM_MOT1_3V3: JA1.3
PWM_MOT2_3V3: JA1.4
SERVOS_PF3_3V3: IC2.17 (IO_VL4), JA1.5
SERVOS_PF3_5V: IC2.7 (IO_VCC4), PF3.3 (PWM)
SERVOS_PF4_3V3: IC2.16 (IO_VL5), JA1.6
SERVOS_PF4_5V: IC2.8 (IO_VCC5), PF4.3 (PWM)
SERVOS_PF5_3V3: IC2.19 (IO_VL2), JA1.7
SERVOS_PF5_5V: IC2.5 (IO_VCC2), PF5.3 (PWM)
SERVOS_PF6_3V3: IC2.18 (IO_VL3), JA1.8
SERVOS_PF6_5V: IC2.6 (IO_VCC3), PF6.3 (PWM)
SERVOS_PF7_3V3: IC2.21 (IO_VL0), JA1.9
SERVOS_PF7_5V: IC2.3 (IO_VCC0), PF7.3 (PWM)
SERVOS_PH0_3V3: IC2.20 (IO_VL1), JA1.10
SERVOS_PH0_5V: IC2.4 (IO_VCC1), PH0.3 (PWM)

Notes on the sheet:
manque refs RS pour c9 C12 IC3 et L1

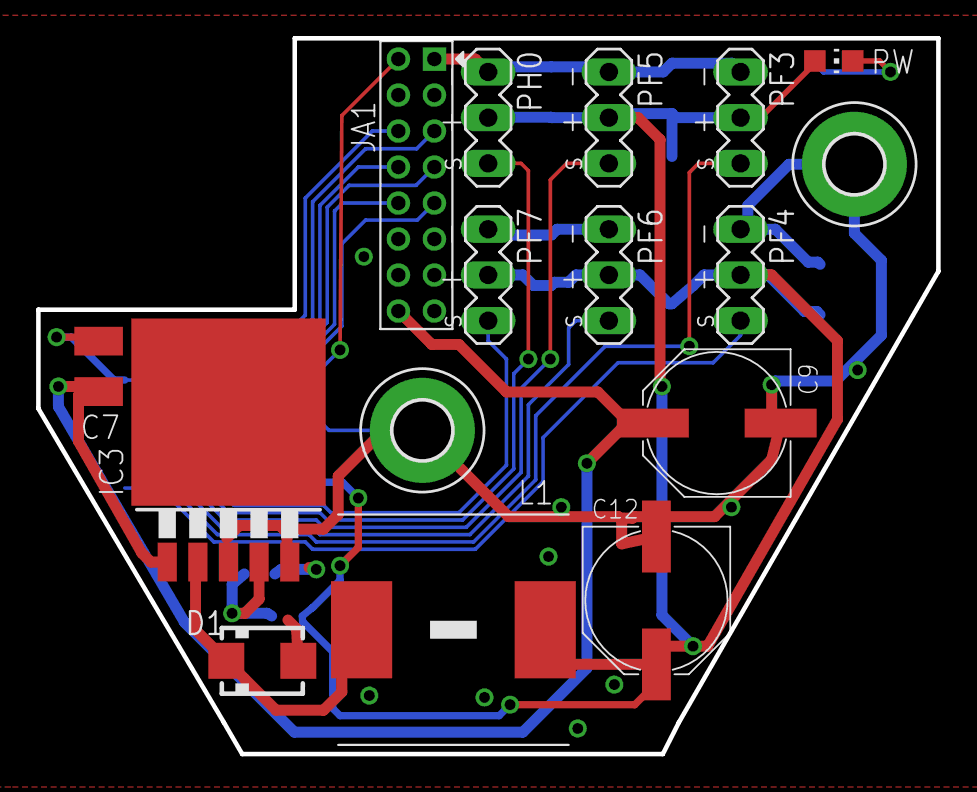
[picture p100: board SUperUnioc_analog_ServosExtension.brd from above]

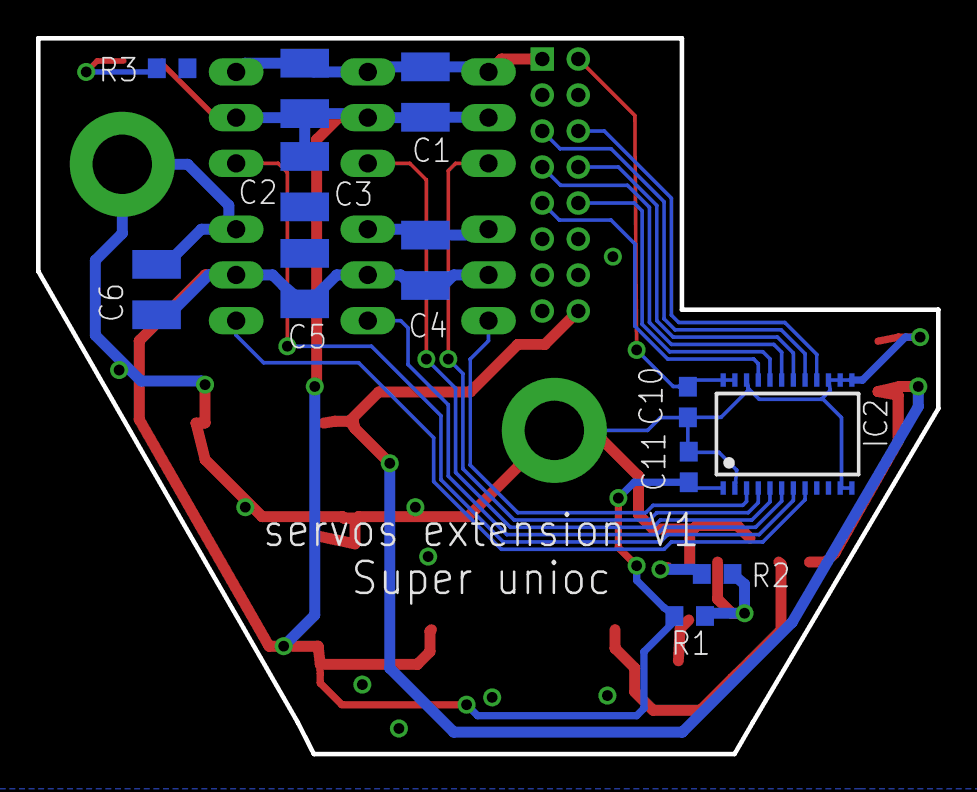
[picture p101: board SUperUnioc_analog_ServosExtension.brd from below]

Board: 2 copper layers, 50.0 x 39.8 mm, 28 parts (12 on the bottom side), 19 nets.
