robotter/robotter/hardware/pmi_extension_2k13/pmi_extension_2k13.brd

## EAGLE design hardware/pmi_extension_2k13/pmi_extension_2k13.brd (2013-05-19)

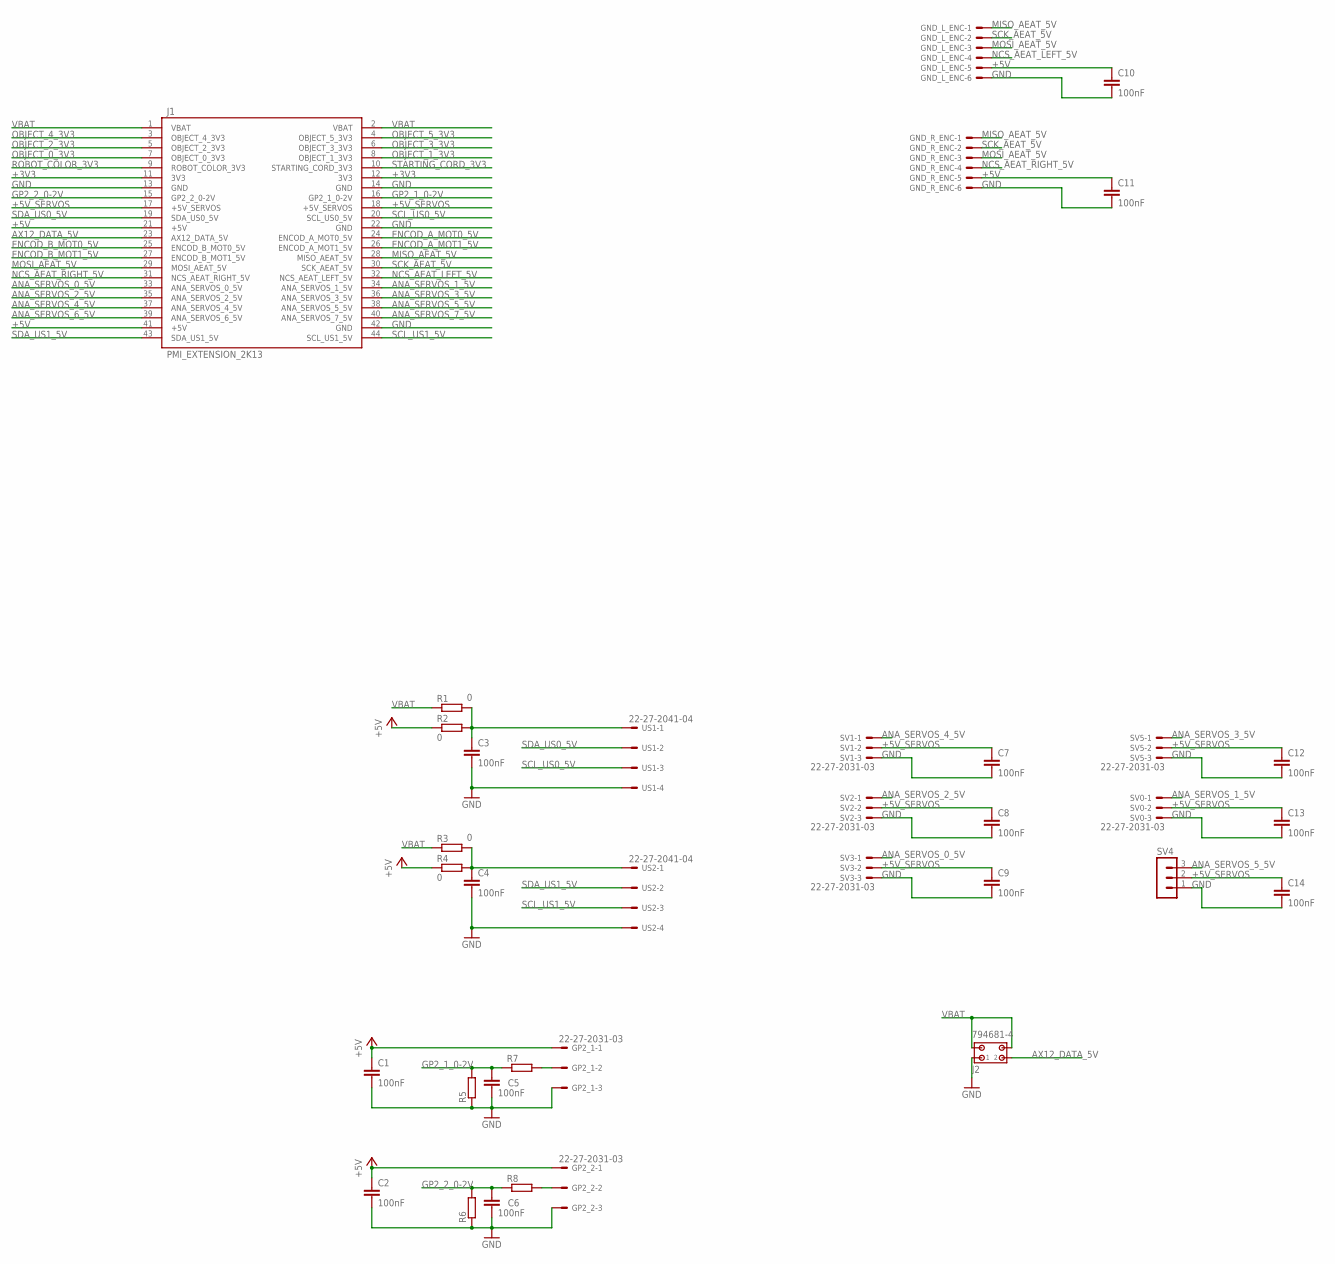
[picture p102: schematic pmi_extension_2k13.sch, part in row 1, column 1]

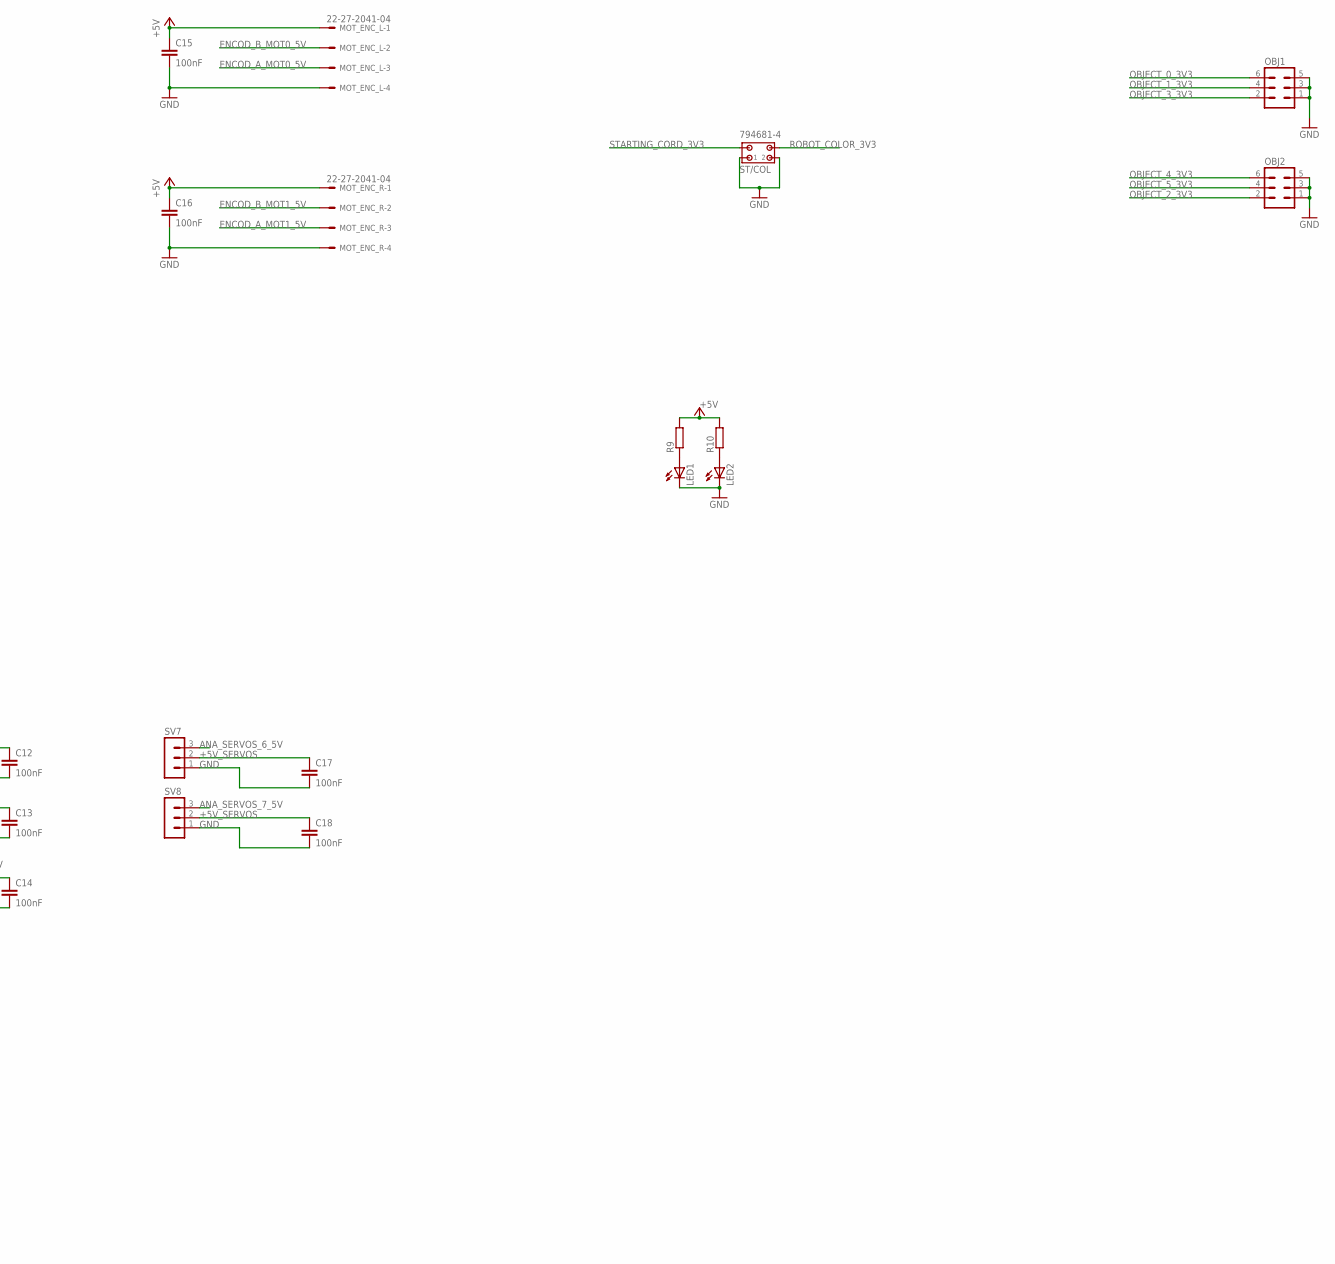
[picture p103: schematic pmi_extension_2k13.sch, part in row 1, column 2]

Parts:
C1, C2, C3, C4, C5, C6, C10, C11, C14, C15, C16, C17, C18: 100nF; C0603
C7, C8, C9, C12, C13: 100nF; C0805
GND_L_ENC: 22-23-2061
GND_R_ENC: 22-23-2061
GP2_1, GP2_2: 22-27-2031-03; 6410-03
J1: PMI_EXTENSION_2K13; HEADER_2X22
J2: 794681-4
LED1, LED2: LED3MM
MOT_ENC_L: 22-27-2041-04; 6410-04
MOT_ENC_R: 22-27-2041-04; 6410-04
OBJ1, OBJ2: MA03-2
R1, R2, R3, R4: 0; R0603
R5, R6, R7, R8, R9, R10: R-EU_R0603; R0603
ST/COL: 794681-4
SV0, SV1, SV2, SV3, SV5: 22-27-2031-03; 6410-03
SV4, SV7, SV8: MA03-1
US1, US2: 22-27-2041-04; 6410-04

Connections:
+3V3: J1.11 (3V3), J1.12 (3V3)
+5V: C1.1, C2.1, C10.1, C11.1, C15.1, C16.1, GND_L_ENC.5, GND_R_ENC.5, GP2_1.1, GP2_2.1, J1.21 (+5V), J1.41 (+5V), MOT_ENC_L.1, MOT_ENC_R.1, R2.1, R4.1, R9.2, R10.2
+5V_SERVOS: C7.1, C8.1, C9.1, C12.1, C13.1, C14.1, C17.1, C18.1, J1.17 (+5V_SERVOS), J1.18 (+5V_SERVOS), SV0.2, SV1.2, SV2.2, SV3.2, SV4.2, SV5.2, SV7.2, SV8.2
ANA_SERVOS_0_5V: J1.33 (ANA_SERVOS_0_5V), SV3.1
ANA_SERVOS_1_5V: J1.34 (ANA_SERVOS_1_5V), SV0.1
ANA_SERVOS_2_5V: J1.35 (ANA_SERVOS_2_5V), SV2.1
ANA_SERVOS_3_5V: J1.36 (ANA_SERVOS_3_5V), SV5.1
ANA_SERVOS_4_5V: J1.37 (ANA_SERVOS_4_5V), SV1.1
ANA_SERVOS_5_5V: J1.38 (ANA_SERVOS_5_5V), SV4.3
ANA_SERVOS_6_5V: J1.39 (ANA_SERVOS_6_5V), SV7.3
ANA_SERVOS_7_5V: J1.40 (ANA_SERVOS_7_5V), SV8.3
AX12_DATA_5V: J1.23 (AX12_DATA_5V), J2.2
ENCOD_A_MOT0_5V: J1.24 (ENCOD_A_MOT0_5V), MOT_ENC_L.3
ENCOD_A_MOT1_5V: J1.26 (ENCOD_A_MOT1_5V), MOT_ENC_R.3
ENCOD_B_MOT0_5V: J1.25 (ENCOD_B_MOT0_5V), MOT_ENC_L.2
ENCOD_B_MOT1_5V: J1.27 (ENCOD_B_MOT1_5V), MOT_ENC_R.2
GND: C1.2, C2.2, C3.2, C4.2, C5.2, C6.2, C7.2, C8.2, C9.2, C10.2, C11.2, C12.2, C13.2, C14.2, C15.2, C16.2, C17.2, C18.2, GND_L_ENC.6, GND_R_ENC.6, GP2_1.3, GP2_2.3, J1.13 (GND), J1.14 (GND), J1.22 (GND), J1.42 (GND), J2.1, LED1.K (C), LED2.K (C), MOT_ENC_L.4, MOT_ENC_R.4, OBJ1.1, OBJ1.3, OBJ1.5, OBJ2.1, OBJ2.3, OBJ2.5, R5.1, R6.1, ST/COL.1, ST/COL.2, SV0.3, SV1.3, SV2.3, SV3.3, SV4.1, SV5.3, SV7.1, SV8.1, US1.4, US2.4
GP2_1_0-2V: C5.1, J1.16 (GP2_1_0-2V), R5.2, R7.1
GP2_2_0-2V: C6.1, J1.15 (GP2_2_0-2V), R6.2, R8.1
MISO_AEAT_5V: GND_L_ENC.1, GND_R_ENC.1, J1.28 (MISO_AEAT_5V)
MOSI_AEAT_5V: GND_L_ENC.3, GND_R_ENC.3, J1.29 (MOSI_AEAT_5V)
unnamed: GP2_1.2, R7.2
unnamed: GP2_2.2, R8.2
unnamed: C4.1, R3.2, R4.2, US2.1
unnamed: LED1.A, R9.1
unnamed: C3.1, R1.2, R2.2, US1.1
unnamed: LED2.A, R10.1
NCS_AEAT_LEFT_5V: GND_L_ENC.4, J1.32 (NCS_AEAT_LEFT_5V)
NCS_AEAT_RIGHT_5V: GND_R_ENC.4, J1.31 (NCS_AEAT_RIGHT_5V)
OBJECT_0_3V3: J1.7 (OBJECT_0_3V3), OBJ1.6
OBJECT_1_3V3: J1.8 (OBJECT_1_3V3), OBJ1.4
OBJECT_2_3V3: J1.5 (OBJECT_2_3V3), OBJ2.2
OBJECT_3_3V3: J1.6 (OBJECT_3_3V3), OBJ1.2
OBJECT_4_3V3: J1.3 (OBJECT_4_3V3), OBJ2.6
OBJECT_5_3V3: J1.4 (OBJECT_5_3V3), OBJ2.4
ROBOT_COLOR_3V3: J1.9 (ROBOT_COLOR_3V3), ST/COL.4
SCK_AEAT_5V: GND_L_ENC.2, GND_R_ENC.2, J1.30 (SCK_AEAT_5V)
SCL_US0_5V: J1.20 (SCL_US0_5V), US1.3
SCL_US1_5V: J1.44 (SCL_US1_5V), US2.3
SDA_US0_5V: J1.19 (SDA_US0_5V), US1.2
SDA_US1_5V: J1.43 (SDA_US1_5V), US2.2
STARTING_CORD_3V3: J1.10 (STARTING_CORD_3V3), ST/COL.3
VBAT: J1.1 (VBAT), J1.2 (VBAT), J2.3, J2.4, R1.1, R3.1

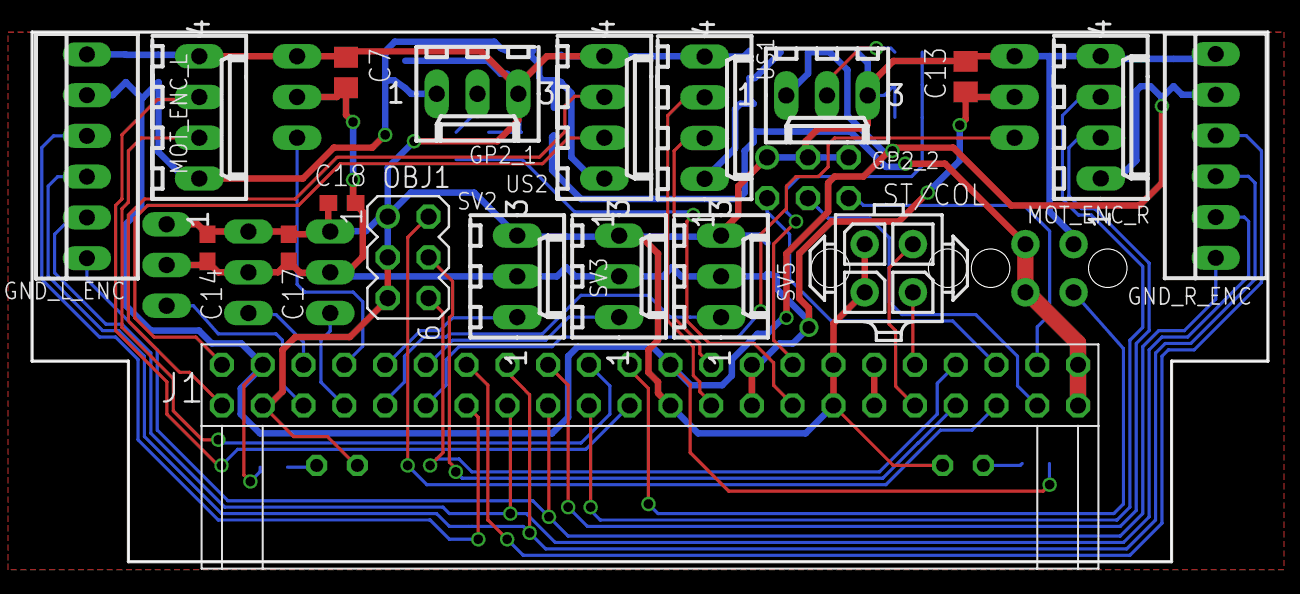
[picture p104: board pmi_extension_2k13.brd from above]

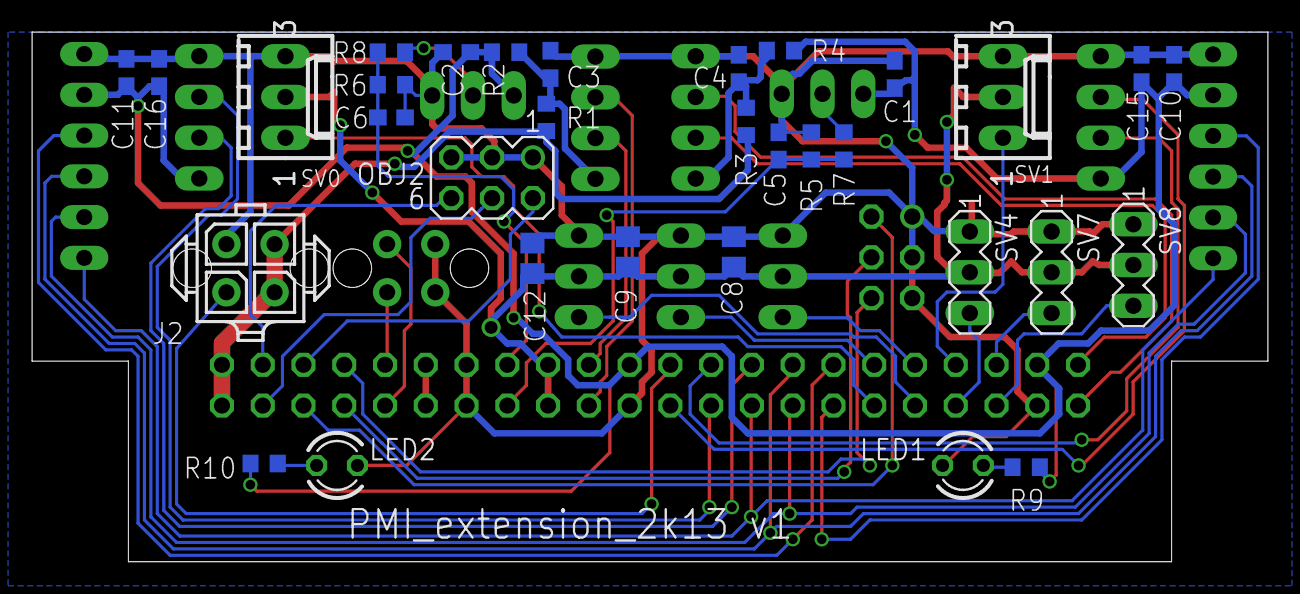
[picture p105: board pmi_extension_2k13.brd from below]

Board: 2 copper layers, 77.0 x 33.0 mm, 51 parts (32 on the bottom side), 43 nets.
