robotter/robotter/hardware/carte_moteur/Carte_moteur.brd

## EAGLE design hardware/carte_moteur/Carte_moteur.brd (2013-05-19)

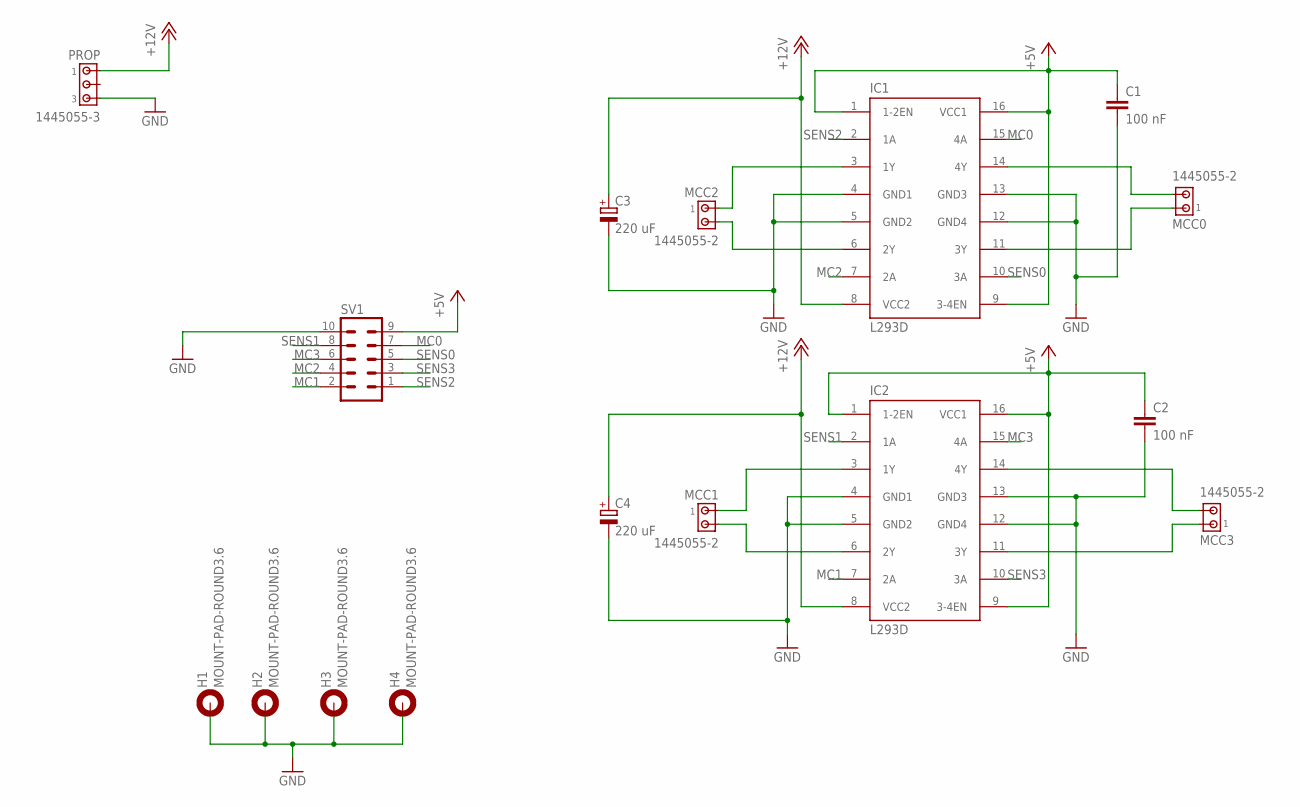
[picture p106: schematic Carte_moteur.sch]

Parts:
C1, C2: 100 nF; C0805
C3, C4: 220 uF; PANASONIC_G
H1, H2, H3, H4: MOUNT-PAD-ROUND3.6; 3,6-PAD
IC1, IC2: L293D; DIL16
MCC0, MCC1, MCC2, MCC3: 1445055-2
PROP: 1445055-3
SV1: ML10

Connections:
+5V: C1.1, C2.1, IC1.1 (1-2EN), IC1.9 (3-4EN), IC1.16 (VCC1), IC2.1 (1-2EN), IC2.9 (3-4EN), IC2.16 (VCC1), SV1.9
+12V: C3.+, C4.+, IC1.8 (VCC2), IC2.8 (VCC2), PROP.1
GND: C1.2, C2.2, C3.-, C4.-, H1.B3,6, H2.B3,6, H3.B3,6, H4.B3,6, IC1.4 (GND1), IC1.5 (GND2), IC1.12 (GND4), IC1.13 (GND3), IC2.4 (GND1), IC2.5 (GND2), IC2.12 (GND4), IC2.13 (GND3), PROP.3, SV1.10
MC0: IC1.15 (4A), SV1.7
MC1: IC2.7 (2A), SV1.2
MC2: IC1.7 (2A), SV1.4
MC3: IC2.15 (4A), SV1.6
unnamed: IC1.3 (1Y), MCC2.1
unnamed: IC1.6 (2Y), MCC2.2
unnamed: IC1.14 (4Y), MCC0.2
unnamed: IC1.11 (3Y), MCC0.1
unnamed: IC2.3 (1Y), MCC1.1
unnamed: IC2.6 (2Y), MCC1.2
unnamed: IC2.11 (3Y), MCC3.1
unnamed: IC2.14 (4Y), MCC3.2
SENS0: IC1.10 (3A), SV1.5
SENS1: IC2.2 (1A), SV1.8
SENS2: IC1.2 (1A), SV1.1
SENS3: IC2.10 (3A), SV1.3

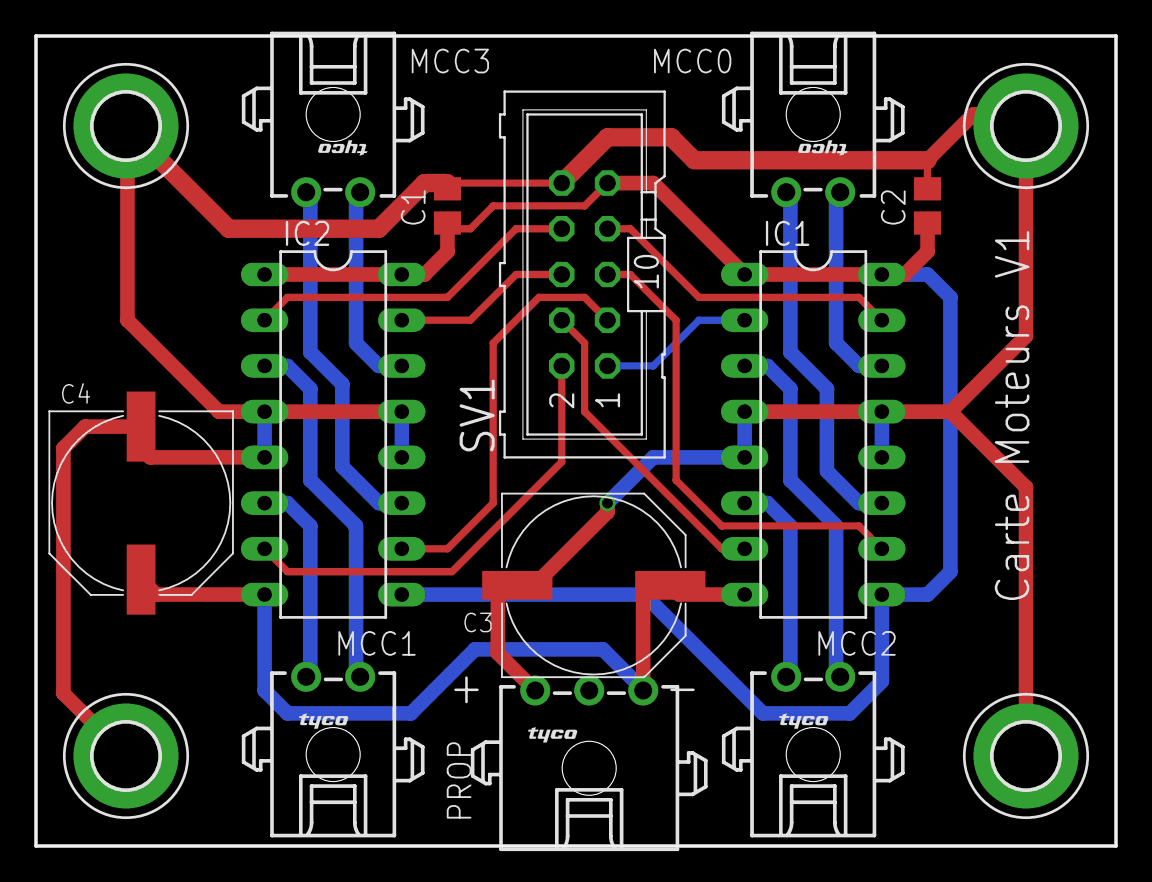
[picture p107: board Carte_moteur.brd from above]

Board: 2 copper layers, 60.0 x 45.0 mm, 16 parts (0 on the bottom side), 19 nets.
