robotter/robotter/fpgas/camera/src/multi_pixel_mean.vhd

-----------------------------------------------------------------------------
-- Title      : Pixel averager
-- Project    : Carte camera 2009
-----------------------------------------------------------------------------
-- File       : averager.vhdl
-- Author     : BLANCHARD Remy <remyb718 at gmail dot com>
-- Company    : Rob'Otter
-- Last update: 14/12/2008
-- Platform   : Spartan 3
-----------------------------------------------------------------------------
-- Description: the aim of this bloc is to average the incoming H and Y with
-- 9 elements (the center pixel in 8-connexity).
-- 
-- This bloc sum the 9 elements and divide them by 8 (instead of 9), this
-- have to be consider in the next bloc.
-- 
-- This bloc uses a dual access RAM per signal to store the last pixels in
-- order to make a multiline average. This bloc is divided in 2 parts, the
-- first one only records the incoming pixels, the second one average the
-- recorded pixels.
-----------------------------------------------------------------------------
-- This program is free software; you can redistribute it and/or modify
-- it under the terms of the GNU General Public License as published by
-- the Free Software Foundation; either version 2, or (at your option)
-- any later version.
-- 
-- This program is distributed in the hope that it will be useful,
-- but WITHOUT ANY WARRANTY; without even the implied warranty of
-- MERCHANTABILITY or FITNESS FOR A PARTICULAR PURPOSE.  See the
-- GNU General Public License for more details.
-- 
-- You should have received a copy of the GNU General Public License
-- along with this program; if not, write to the Free Software
-----------------------------------------------------------------------------
-- HISTORY :
-- +------------------------------------------------------------------------+
-- | Ver. | Date     | Aut. | Commentaire                                   |
-- +------------------------------------------------------------------------+
-- | 1.00 | 14/12/08 | RBL  | Creation                                      |
-- +------------------------------------------------------------------------+
-- |      |          |      |                                               |
-- +------------------------------------------------------------------------+
-- |      |          |      |                                               |
-- +------------------------------------------------------------------------+
-- |      |          |      |                                               |
-- +------------------------------------------------------------------------+

library ieee;
use ieee.std_logic_1164.all;
use ieee.numeric_std.all;
library UNISIM;
use UNISIM.VComponents.all;
library XilinxCoreLib;
use XilinxCoreLib.all;


-----------------------------------------------------------------------
entity multi_pixel_mean is
-----------------------------------------------------------------------
    port (
        clk_i          : in  std_ulogic;
        reset_i        : in  std_ulogic;
		  
		  -- input signals
		  Y_i            : in std_logic_vector(7 downto 0);
		  H_i            : in std_logic_vector(7 downto 0);
		  
        -- camera input (with delay)
        camera_clk_i   : in  std_ulogic; -- new pixel signal
        camera_rst_i   : in  std_ulogic; -- new image signal
		  
        -- average outputs
        mean_Y_o   : out  unsigned(8 downto 0);
        mean_H_o   : out  unsigned(8 downto 0)
        
    );
end multi_pixel_mean;

-----------------------------------------------------------------------
architecture multi_pixel_mean_1 of multi_pixel_mean is
-----------------------------------------------------------------------

	 -- signal for the first part

	 --signal for detecting rising edges of clk_camera_i
	 signal last_clk_camera_s: std_ulogic;
	 
	 -- the position of the element in the RAM
    signal write_element_pos_s: unsigned (10 downto 0);
	 signal write_element_pos_bit_vec_s: std_logic_vector(10 downto 0);
	 
	 -- the signal to say that the pixel must be written un RAM
	 signal valid_ram_pos_s: std_ulogic;
	 
	 
	 -- signals for the second part

    -- constants for the state machine to locate stored pixels (pixel...)
    CONSTANT ELEM_POS_TL: unsigned := "10100110010"; -- top left (n-1330)
    CONSTANT ELEM_POS_TC: unsigned := "10100110001"; -- top center (n-1329)
    CONSTANT ELEM_POS_TR: unsigned := "10100110000"; -- top right (n-1328)
    CONSTANT ELEM_POS_CL: unsigned := "01010011010"; -- center left (n-666)
    CONSTANT ELEM_POS_CC: unsigned := "01010011001"; -- center center (n-665)
    CONSTANT ELEM_POS_CR: unsigned := "01010011000"; -- center right (n-664)
    CONSTANT ELEM_POS_BL: unsigned := "00000000010"; -- bottom left (n-2)
    CONSTANT ELEM_POS_BC: unsigned := "00000000001"; -- bottom center (n-1)
    CONSTANT ELEM_POS_BR: unsigned := "00000000000"; -- bottom right (n-0)

	 -- relative position of the pixel to sum
    signal offset_value_s: unsigned(10 downto 0);

	 -- signal to determine if the state machine is in an active state
	 signal st_mach_actif_s: std_ulogic;
	 
	 -- adress to read in RAMs
	 signal in_ram_pos_s: std_logic_vector(10 downto 0);

	 -- definition of the state machine elements
    type sweep_pix is (init, pix_tl, pix_tc, pix_tr, pix_cl, pix_cc, pix_cr, 
      pix_bl, pix_bc, pix_br, w_state);
    signal current_pixel_s, next_pixel_s: sweep_pix;
	 
	 -- RAM output
	 signal Y_element_s: std_logic_vector(7 downto 0);
	 signal H_element_s: std_logic_vector(7 downto 0); 
	 
	 -- outputs for the sum
	 signal Y_accumulator_s: unsigned(11 downto 0);
	 signal H_accumulator_s: unsigned(11 downto 0);
	
begin
	 ---------------------------------------------------------
	 -- first part: writting the incoming elements in both RAM
	 ---------------------------------------------------------
	 
	 -- position to write in the RAM
    incomming_RAM_position_p: process
    begin
		wait until rising_edge(clk_i);
		if reset_i='1' or camera_rst_i='1' then
         write_element_pos_s<="00000000000";
		elsif last_clk_camera_s='0' and camera_clk_i='1' then
         write_element_pos_s<=write_element_pos_s+1;
			valid_ram_pos_s<='1';
		else
			valid_ram_pos_s<='0';
      end if;
		last_clk_camera_s<=camera_clk_i;
    end process incomming_RAM_position_p;
	 write_element_pos_bit_vec_s<=std_logic_vector(write_element_pos_s);
	 
	 ---------------------------------------------------------
	 -- second part: reading and averaging the stored data
	 ---------------------------------------------------------
	 
    -- switch to next state or reset handle
    next_state_process_p: process
    begin
    wait until rising_edge(clk_i);
	 if reset_i='1' or camera_rst_i='1' then
        current_pixel_s<=init;
    else
        current_pixel_s<=next_pixel_s;
    end if;
    end process next_state_process_p;
	 
	 
    -- sweep all the stored pixel (output: the offset for the
	 -- analysed pixel)
    sweep_pixel_p: process
	 begin
		wait until rising_edge(clk_i);
		case current_pixel_s is
			  when init   => offset_value_s<="11111111111";
								  st_mach_actif_s<='0';
								  if camera_clk_i='1' then
										next_pixel_s<=pix_tl;
								  end if;

			  when pix_tl => offset_value_s<=ELEM_POS_TL;
								  st_mach_actif_s<='1';
								  next_pixel_s<=pix_tc;

			  when pix_tc => offset_value_s<=ELEM_POS_TC;
								  st_mach_actif_s<='1';
								  next_pixel_s<=pix_tr;

			  when pix_tr => offset_value_s<=ELEM_POS_TR;
								  st_mach_actif_s<='1';
								  next_pixel_s<=pix_cl;

			  when pix_cl => offset_value_s<=ELEM_POS_CL;
								  st_mach_actif_s<='1';
								  next_pixel_s<=pix_cc;

			  when pix_cc => offset_value_s<=ELEM_POS_CC;
								  st_mach_actif_s<='1';
								  next_pixel_s<=pix_cr;

			  when pix_cr => offset_value_s<=ELEM_POS_CR;
								  st_mach_actif_s<='1';
								  next_pixel_s<=pix_bl;

			  when pix_bl => offset_value_s<=ELEM_POS_BL;
								  st_mach_actif_s<='1';
								  next_pixel_s<=pix_bc;

			  when pix_bc => offset_value_s<=ELEM_POS_BC;
								  st_mach_actif_s<='1';
								  next_pixel_s<=pix_br;

			  when pix_br => offset_value_s<=ELEM_POS_BR;
								  st_mach_actif_s<='1';
								  next_pixel_s<=w_state;

			  when w_state=> offset_value_s<="11111111111";
								  st_mach_actif_s<='0';
								  if camera_clk_i='0' then
										next_pixel_s<=init;
								  end if;
		 end case;
	 end process sweep_pixel_p;
	 	 
	 -- read position
	 in_ram_pos_s<=std_logic_vector(write_element_pos_s-offset_value_s);
	 
	 -- sum for Y
	 y_sum_process_p: process
    begin
		wait until rising_edge(clk_i);
		if st_mach_actif_s='0' then
			Y_accumulator_s<="000000000000";
		else
			Y_accumulator_s<=Y_accumulator_s+unsigned(Y_element_s);
		end if;
	 end process y_sum_process_p;
	 
	 -- latch it in the right time in the output (Y)
	 Y_output_latch_p: process
    begin
		wait until rising_edge(clk_i);
		if current_pixel_s=w_state then
			mean_Y_o<=Y_accumulator_s(11 downto 3);
		end if;
	end process Y_output_latch_p;
	
	
	 -- sum for H
	 h_sum_process_p: process
    begin
		wait until rising_edge(clk_i);
		if st_mach_actif_s='0' then
			H_accumulator_s<="000000000000";
		else
			H_accumulator_s<=H_accumulator_s+unsigned(H_element_s);
		end if;
	 end process h_sum_process_p;
	 
	 -- latch it in the right time in the output (H)
	 H_output_latch_p: process
    begin
		wait until rising_edge(clk_i);
		if current_pixel_s=w_state then
			mean_H_o<=H_accumulator_s(11 downto 3);
		end if;
	end process H_output_latch_p;
	
	 -- 2 RAM dual access
	 
    -- RAMB16_S9_S9: Spartan-3 2k x 8 + 1 unused Parity bits Dual-Port RAM
    RAMB16_Y_inst : RAMB16_S9_S9
	 generic map (
      INIT_A => "000000000", --  Value of output RAM registers at startup
      INIT_B => "000000000", --  Value of output RAM registers at startup
		SRVAL_A => "000000000", --  Ouput value upon SSR assertion
      SRVAL_B => "000000000", --  Ouput value upon SSR assertion
		WRITE_MODE_A => "WRITE_FIRST", --  WRITE_FIRST, READ_FIRST or NO_CHANGE
		WRITE_MODE_B => "WRITE_FIRST", --  WRITE_FIRST, READ_FIRST or NO_CHANGE
      SIM_COLLISION_CHECK => "NONE", -- "NONE", "WARNING", "GENERATE_X_ONLY", "ALL" 
      INIT_00 => X"0000000000000000000000000000000000000000000000000000000000000000",
      INIT_01 => X"0000000000000000000000000000000000000000000000000000000000000000",
      INIT_02 => X"0000000000000000000000000000000000000000000000000000000000000000",
      INIT_03 => X"0000000000000000000000000000000000000000000000000000000000000000",
      INIT_04 => X"0000000000000000000000000000000000000000000000000000000000000000",
      INIT_05 => X"0000000000000000000000000000000000000000000000000000000000000000",
      INIT_06 => X"0000000000000000000000000000000000000000000000000000000000000000",
      INIT_07 => X"0000000000000000000000000000000000000000000000000000000000000000",
      INIT_08 => X"0000000000000000000000000000000000000000000000000000000000000000",
      INIT_09 => X"0000000000000000000000000000000000000000000000000000000000000000",
      INIT_0A => X"0000000000000000000000000000000000000000000000000000000000000000",
      INIT_0B => X"0000000000000000000000000000000000000000000000000000000000000000",
      INIT_0C => X"0000000000000000000000000000000000000000000000000000000000000000",
      INIT_0D => X"0000000000000000000000000000000000000000000000000000000000000000",
      INIT_0E => X"0000000000000000000000000000000000000000000000000000000000000000",
      INIT_0F => X"0000000000000000000000000000000000000000000000000000000000000000",
      INIT_10 => X"0000000000000000000000000000000000000000000000000000000000000000",
      INIT_11 => X"0000000000000000000000000000000000000000000000000000000000000000",
      INIT_12 => X"0000000000000000000000000000000000000000000000000000000000000000",
      INIT_13 => X"0000000000000000000000000000000000000000000000000000000000000000",
      INIT_14 => X"0000000000000000000000000000000000000000000000000000000000000000",
      INIT_15 => X"0000000000000000000000000000000000000000000000000000000000000000",
      INIT_16 => X"0000000000000000000000000000000000000000000000000000000000000000",
      INIT_17 => X"0000000000000000000000000000000000000000000000000000000000000000",
      INIT_18 => X"0000000000000000000000000000000000000000000000000000000000000000",
      INIT_19 => X"0000000000000000000000000000000000000000000000000000000000000000",
      INIT_1A => X"0000000000000000000000000000000000000000000000000000000000000000",
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
      ENB   => '1',                            -- RAM Enable Input
      SSRB  => '0',                            -- Synchronous Set/Reset Input
      WEB   => '1'                             -- Write Enable Input
    ); 
	 
end multi_pixel_mean_1; 
