robotter/robotter/tools/midi2pwm/config.h

// Variables to configure the project

// Author: RB



#ifndef __CONFIG_H__
#define __CONFIG_H__

#define NB_TRANSDUCTOR 3


/*
  A variable to convert a MIDI note value to a frequency
*/
float note2freq[128]={0,
0,
0,
0,
0,
0,
0,
0,
0,
0,
0,
0,
0,
0,
0,
0,
0,
0,
0,
0,
0,
27.50,
29.13,
30.86,
32.70,
34.64,
36.70,
38.89,
41.20,
43.65,
46.24,
48.99,
51.91,
55.00,
58.27,
61.73,
65.40,
69.29,
73.41,
77.78,
82.40,
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


/*
  convert x into PWM width
  where x can be the second harmonic depending on the instrument or the output power depending on the velocity
  here is the power function
*/
float x2pwm_width[128]={
0.00000,
0.00251,
0.00501,
0.00752,
0.01003,
0.01254,
0.01504,
0.01755,
0.02006,
0.02258,
0.02509,
0.02760,
0.03012,
0.03264,
0.03516,
0.03768,
0.04021,
0.04274,
0.04527,
0.04780,
0.05034,
0.05288,
0.05542,
0.05797,
0.06052,
0.06307,
0.06563,
0.06819,
0.07076,
0.07333,
0.07591,
0.07849,
0.08108,
0.08367,
0.08627,
0.08887,
0.09148,
0.09410,
0.09672,
0.09935,
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


#endif /* __CONFIG_H__ */
