robotter/robotter/(commit log)

2009-01-04 [doc] schéma de la carte à cheveux
2009-01-18 SPI sniff for ADNS reverse
    [main.c]
2009-01-18 Modification of the data bus width for the H signal: 8 instead of 9. Problem of memory size for the averager. The size of the signals in the threshold bloc may change to 9.
    [rgb2hy.vhdl, t_rgb2hy.vhdl, t_threshold.vhdl]
2009-01-18 Ajout des fichiers nécessaires au dump des trames de la souris optique laser comportant un adns6010
2009-01-18 projet de dump de firmware de souris optique
2009-01-29 5v on cachev
2009-01-30 Added ADNS SPI module.
    New handy and pretty Makefile.
2009-01-30 [elec]Mise à jour des schéma
2009-01-31 ajout de l'entité adns_6010_wishbone_interface modification des latchs (taille du squal différente de celle des données)
2009-01-31 Added compass module. Fixed syntax errors in recently added adns6010 files.
    Use a common included Makefile for all fpgas/ subdirs.
    Makefile now supports ISE synthesis.
    Defines $XILINX to release the power of these new (ugly) make rules.
2009-02-01 Début de schéma pour Cachev
    [cachev.sch, nomenclature.ods]
2009-02-01 Added compass top testbench. Fixed compass module.
    Makefile:
    added variable for extra .vhd files
    invoking ISE rules when $XILINX is not set now displays a message
    [t_compass_top.vhd]
2009-02-02 ajout des fichiers synthétisables mais non simulés
2009-02-04 Commited tb point out a bug in the spi component :
    In specifics conditions sck_o first fall to rise delay is not half spi period resulting :
    => Ugly SCK signal
    => Signal data_out fail, next frame bit 7 is missed.
2009-02-04 [unioc_ng][spi]Just a little modification for ack
2009-02-05 Revert de la mise en mise en minuscules Ã l'arrache de Martoni (mais en conservant les modifications "utiles").
2009-02-05 SPI test bench now really do tests.
2009-02-07 ajout du fichier de configuration des pins du fpga
2009-02-08 Grand nettoyage : - suppression des tabulations ; - fin de lignes CRLF passÃ©es en LF ; - nommages / prÃ©fixes ; - dÃ©tails divers par-ci par-lÃ (commentaires, indentation, ...).
2009-02-08 Les bits de configuration de la résolution étaient inversés.
2009-02-09 Bug corrected on SPI communication
2009-02-09 [Camera] First draft of the interface camera/FPGA, there is a problem with the instanciation of the {R,G,B}_i signals, I don't know why ... searching in progress
2009-02-10 The synthesis of the camera interface seems to be ok, I separated all the variables (then I saw a test: if rst_i<='1' ....rrrrhhhhhaaaaa)... testbench in progress
2009-02-11 ADNS6010 system commit.
    System tested OK in every mode with ONE ADNS6010 sensor.
2009-02-11 Delay between clearing and reading Observation increase to match a FULL frame.
    Code tested OK on a SINGLE ADNS6010 with SPI @ 2Mhz.
2009-02-16 [Camera]Inteface between the camera and the FPGA seems ok (according to the behavioral simulation)
2009-02-18 [Camera] renomage des fichier pour coller un peu plus au dictat des specs...le flemme de faire ce message en anglais... je préfaire le francais avec les fautes.
2009-02-18 [Camera] First definition of the wishbone adaptator bloc (only signals)
2009-02-23 version trash des commandes de moteurs ok
    [cachev.sch, nomenclature.ods]
2009-02-23 ajout de la bibliothèque spéciale cachev
    [nomenclature.ods]
2009-02-28 i2c module: - refactored read functions; - added proper comments.
    Fixed VHDL Makefile for Windows support.
    [i2c_robotter_config.h]
2009-03-01 beta1 du schéma terminé
    [cachev.sch]
2009-03-01 [hardware][cachev] Little mistake in component footprint
    [cachev.sch]
2009-03-02 [cachev] max4173 wiring
    [cachev.sch, nomenclature.ods]
2009-03-08 [Camera]The interface between Wishbone and camera design. first draft
2009-03-08 [camera] more compatibility with the specs
2009-03-09 [CÀCHEV] placement des composants
    [cachev.brd, cachev.sch]
2009-03-14 [CÀCHEV] premier jet de routage
    [cachev.brd, cachev.sch]
2009-03-15 [Camera] End of the first draft
2009-03-15 carte support des capteurs de souris lasers
    [adns6010_board.Sch, adns6010_board.pcb, nomenclature_adns6010_v1.xls]
2009-03-15 unioc2007 : version 5V utilisee a eirbot
    [nomenclature_UNIOC2007.xls, nomenclature_UNIOC2007_V1.1.XLS]
2009-03-16 JD RP
    [cachev.brd, cachev.sch]
2009-03-16 v2 de la carte adns6010_card. modifications : empreinte du pnp drivant la led laser modification du buffer drivant les leds de debug. plan de masse plus complet
2009-03-17 Bug in ADNS6010 module corrected, test project updated
    [main.c]
2009-03-17 Modification for artisanal burning
    [cachev.brd, cachev.sch]
2009-03-18 [HARDWARE][CACHEV] tirage de la carte
    [cachev.brd]
2009-03-22 Prototype corrected
2009-03-23 encoder_inc: use Linux EOL. compass, encoder_inc: fixes for ISE compliancy.
2009-03-29 Préfixage des valeurs de l'enum I2CS_STATE pour éviter les collisions présentes (trajectory_state::READY) et futures.
    [main.c]
2009-04-05 RJ11 to HE10/10 JTAG programmer
    [adapt.brd, adapt.sch]
2009-04-05 [càchev] code de test pour la càchev
2009-04-13 [Camera] Developement of the algorithm for all the solutions C-based
2009-04-13 [camera] je vais reprendre demain
2009-04-14 [Camera] Avancées du soir: fini le moyennage... va passer aux seuils
2009-04-15 [Camera] Draft du code C pour la segmentation
2009-04-16 [Camera] Correction des erreurs dans la segmentation et mise en place de l'érosion => il ne reste plus que la détection de zones (je vais passer à des images reelles)
    [main.c]
2009-04-26 [Camera] first draft of the VHDL for solution B
2009-05-03 add alim_2009 board, first draft
    [alim_2009.brd, alim_2009.sch]
2009-05-03 add TYPONS for alim_2009_board
    [alim_2009.brd]
2009-05-03 [camera] Commit pour pouvoir avancer au boulot - intercontrat
2009-05-04 [Camera] Pour pouvoir continuer au boulot
2009-05-06 [Camera] Fuck the comment - nobody reads it
2009-05-06 Fist full version of galipR control systems. Compiled OK, not uploaded, not tested, not iso-otter compliant.
    Prototypes changed in :
    * hposition_manager
    * hrobot_manager
    * adns6010
    In /modules/hposition_manager :
    * simple linear method to transfrom ADNS coords to robot coords implemented
    CS full version in /projects/unioc_asserv/ :
    * motor-level PID control system
    * robot-level (x y a) PID control system
2009-05-08 add files for prop2009_v1 board
2009-05-10 [Camera] for Ryder
2009-05-10 Optimisation du code (et un peu de proprification).
2009-05-10 inductor's footprint modified. assembly files added.
    [alim_2009.brd, alim_2009.sch]
2009-05-10 +12V on the supply connector J5
    [alim_2009.brd, alim_2009.sch]
2009-05-10 ajout de l'adaptateur rj11 vers port série(fonctionne sur adaptateur usb-serie d'ou le db9 femelle)
    [adapt_uart_serie.brd, adapt_uart_serie.sch]
2009-05-11 [POD][UNIOCNG] Le nom du composant doit être identique au nom de l'architecture top (règle pourrie qui sera changée prochainement). Le script de l'uniocng n'est pas terminé il faut ajouter les connec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
2009-05-11 unioc-ng schematic added
2009-05-18 * POD project released to near final version. * adns6010_spi CS select corrected * working on unioc_asserv
    [adapt_uart_serie.brd]
2009-05-18 [Camera] Ajout des commandes I2C pour l'OV et l'ARMadeus - Sauvegarde temporaire pour tout mettre sur le portable
2009-05-20 add the ax12_board modification of the alim board
    [adapt.brd, alim_2009.brd, alim_2009.sch, ax12board.brd, ax12board.sch]
2009-05-25 A few changes: * dependencies problem corrected in generate_robotter_config * scilab file to calibrate ADNS6010 sensors * cosmetic changes in main.c
    [main.c]
2009-06-01 * module ADNS6010, unioc_asserv : error management switched to error module
    [main.c]
2009-06-01 [Camera] A partir de maintenant le projet de carte camera sera une branche de http://code.google.com/p/cameramea/
2009-06-05 first commit for bootloader dev board
    [boot_board.sch]
2009-06-07 * DEBUG/ERROR handling added in ADNS6010 module * DEBUG/ERROR handling added in unioc_asserv * bug correct in angle control systems in unioc_asserv * plot script added in unioc_asserv/plot * unioc_ad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
    [main.c]
2009-06-08 schemas de la board utilisée à la coupe
2009-06-11 Modifications d'ordre esthétiques. Prise en compte de diverses remarques de lamygalle. Renommage.
    Il reste à relier l'UART.
    [bookie_board.sch, boot_board.sch]
2009-06-12 * hposition_manager : error/debug handling modified according to coding rules * adns6010 : FPGA initialization sequence removed * unioc_asserv : FPGA init. handling added * unioc_asserv : typo with E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
    [main.c]
2009-06-12 Added alim and UART.
    [bookie_board.sch]
2009-06-13 Routage de Bookie, premier jet. Quelques modifications sur la schématique, notamment la suppresion des lignes d'interruption (pour faciliter le routage).
    [bookie_board.brd, bookie_board.sch]
2009-06-14 first draft for R2D2 (Rob'Otter robot detection device) emission board. more an idea than a real board
    [R2D2_emission.sch]
2009-06-14 Mise à jour du routage de Bookie : - réarrangement de certaines pistes ; - HE10 passés en coudés ; - routage d'une ligne d'interruption de l'ATmega88 ; - ajout de textes et déco de la carte.
    [bookie_board.brd, bookie_board.sch]
2009-06-14 minor changes
    [bookie_board.brd]
2009-06-19 brd modified : DB9s moved to correct position / wires moved to match clearance
    [bookie_board.brd, bookie_board.sch]
2009-06-20 R2D2 gen archi 1st draft
    [R2D2_emission.sch]
2009-06-21 Various changes in unioc_asserv, hposition_manager. * unioc_asserv Error corrected in manual_mode CSs period increased to 25 (approx. 8ms) LED feedback added in cs_update Optimisations on cos/sin in 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
    [hrobot_manager.c, main.c]
2009-06-21 Optimisations (permutation de boucles, copie par structure). Retrait de tests de pointeurs "non pertinents".
2009-06-21 added critical feature : RSSI LEDs
2009-06-21 filter added. warning, file must be translated to english
2009-06-22 Modifications esthétiques et mise en conformité avec les coding rules. Corrections liées à la fréquence : - facteur 100kHz et non 200kHz dans le code de la boussole - ajout (et utilisation) d'un gene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
2009-06-24 * hposition_manager & hrobot_manager modules removed, moved to unioc_asserv instead. * compass/ADNS filtering and management added to in the CS loop, compiled & tested OK.
2009-06-28 Ajout d'informations sur la structure du système de balise de la carte caméra
2009-07-05 Code de la campagne de mesures + des tas de trucs
2009-07-05 Modification du boîtier du composant I2C.
    [bookie_board.brd, bookie_board.sch]
2009-07-14 ajout du script générant les typons sous eagle et au format .ps
2009-07-18 ajout de la lib eagle modification de la r2D2 emission : schemas en voie finale
    [R2D2_emission.sch]
2009-07-19 ajout du board de R2D2 emission modifications mineures du schémas (valeurs, noms des composants, ajour d'une empreinte de batterie)
    [R2D2_emission.brd, R2D2_emission.sch]
2009-07-19 quelques petites modifications : ajout de texte de centrage sur la carte bookie, modification de l'affectation de la pwm controlant le courant circulant dans les leds sur le m88 ajout de texte sur la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
    [R2D2_emission.brd, R2D2_emission.sch, bookie_board.brd]
2009-07-26 [Entertainment-Midi2pwm] pause de 13h27
2009-07-27 [pwm2midi]2-3 autres trucs, toujours bloqué avec loituma
2009-08-02 [midi2pwm]first stable version for ringtone2.mid/added output power<->pulse width in config.h
2009-08-05 ajout du monitoring des batteries. (que du visuel (3 leds), pas de mesure de tension, simplement 3 états detectés : ok, bientot ko, ko)
    [alim_2009.sch]
2009-08-06 ajout d'un CAN sur I²C pour monitorer les tensions d'alim des batteries. ajout d'un connecteur I²C pour le monitoring. maj du schemas pdf
    [alim_2009.sch]
2009-08-10 NON-functionnal i2c componnent for strategic command. lamygalle : feel free to use it
2009-09-01 Some tabulations corrected... Damn this code looks good !
    [main.c]
2009-09-14 Lua "lib" script for Convergence. cvg.lua defines convenient methods to send/receive I2C messages. See cvg_example.lua for a sample use.
2009-09-14 Fixed EOL: dos -> unix
    [cvg_example.lua]
2009-10-15 add BOM of R2D2_emission
    [R2D2_emission_nomenclature.ods]
2009-10-25 Fix device compatibility issue.
2009-11-13 New module to trigger an action when receiving a given string through UART. In particular, it allows to order a software reset via UART.
2009-12-15 add i2c control unit part of the strat comm
2009-12-18 1st draft of the R3D2 board, not finished (need connectors...)
    [R3D2_main.sch]
2009-12-20 add connectors, change max3008 that cann't be bought at farnell or RS, need verification and DS of sensor to complete desing
    [R3D2_main.sch]
2009-12-22 few changes to provide +5V/3A and +3V3/3A ... need modification for connector to every board on the robot, not only one split into many ...
    [alim_2009.sch]
2009-12-26 add ground detector. need mechanical informations to route the board...
    [ground_detector.sch]
2009-12-26 add power shutdown on IR sensor add selection light/dark switching
    [R3D2_main.sch]
2009-12-27 premier jet du routage de la carte R3D2. ajout de composants dans la lib robotter
    [R3D2_main.brd, R3D2_main.sch]
2009-12-27 version 2k10 routed, ready for review
    [alim_2009.brd, alim_2009.sch]
2009-12-29 add hub_i2C add first draft of meca_2k10 schematic
    [hub_i2c.brd, hub_i2c.sch, meca_2k10.sch]
2010-01-02 gestion complète des capteurs couleur ajoutée. reste a ajouter les connecteurs de GP2 et le transceiver 3V3<->5V pour les ax12
    la carte pourra gérer :
    - 2 servos analogiques,
    - quelques ax12 (jusqu'a 3 tournant en meme temps),
    - 4 GP2 analogiques,
    - 2 capteurs de couleur OPB780,
    [meca_2k10.sch]
2010-01-03 ax12 driver added, need gp2 connector
    [meca_2k10.sch]
2010-01-04 add GP2D*** connector on meca_2k10 board and on robotter library.
    [meca_2k10.sch]
2010-01-09 board modified after nounours review : quartz moved, atmega ref corrected
    [R3D2_main.brd, R3D2_main.sch]
2010-01-09 modification du nom du connecteur I2C
    [alim_2009.brd, alim_2009.sch]
2010-01-09 commit with modified reset method, stable version before major trajectory manager update
    [main.c]
2010-01-16 atmega wrapper without DIR pin
2010-01-31 working/tested version of i2c slave module
2010-02-14 icl7665 modifié suite à relecture
    [alim_2009.sch]
2010-02-14 still icl7665 modifications
    [alim_2009.sch]
2010-02-14 icl7665 : schemas validé par JDam, routage modifié R3D2 : la pwm du moteur passe du timer 0 (utilisé par le scheduler) au timer 2, routage modifié
    [R3D2_main.brd, R3D2_main.sch, alim_2009.brd, alim_2009.sch]
2010-02-14 augmentation des clearance pour avoir des plans de masse plus éloignés des pistes ...
    [R3D2_main.brd, R3D2_main.sch, alim_2009.brd]
2010-02-14 quelques détails communs avec la relecture de la carte R3D2 corrigés
    [meca_2k10.sch]
2010-02-18 midi2pwm, Python version. Except well-formed midis (eg. those generated by Lilypond). Note: the 'main' is not generic (for now!) and designed for a Bookie's "buzzer player".
    [midi2pwm.py]
2010-02-21 ajout de la nomenclature de la carte alim
    [alim_2009_bom.ods]
2010-02-22 condensateur déplacé.
    [R3D2_main.brd]
2010-02-25 Avoid a bug (in usbserial/pl2303?) making it impossible to reopen the serial port unless removing the kernel module and repluging the device (which is pretty annoying).
2010-02-27 ajout de la nomenclature de la carte.
    [R3D2_main_bom.ods]
2010-02-27 ajout de la carte prop MMX
    [compas_heds_mouse.SCHDOC, ground_detector.SchDoc, pontH.SCHDOC, prop2009.SCHLIB, prop_2009.PcbLib, prop_MMX.PCBDOC, prop_MMX.PRJPCB, prop_MMX_bom.ods]
2010-02-27 stratcomm control unit, wishbone if. and i2c slave added. Wired, compiled, not fully tested on hardware
2010-03-07 modifications de la nomenclature de carte alim
    [alim_2009_bom.ods]
2010-03-07 Parts values added to ground_detector schematic. ground_detector_BOM.ods bill of materials added, inductors references needed.
    [ground_detector.sch, ground_detector_BOM.ods]
2010-03-14 Qté brute ajoutée (non UDV) pour calcul commande globale.
    [ground_detector_BOM.ods]
2010-03-14 Nomenclature Prop_MMX, beaucoup de réfs connecteurs TBD.
    [prop_MMX_bom.ods, prop_MMX_rawbom.xls]
2010-03-16 ajout de la carte routée. attention il faut verifier et surement modifier les empreintes des condensateurs des alims a decoupage
    [meca_2k10.brd, meca_2k10.sch]
2010-03-19 modification des empreintes des condensateurs des alimentations a decoupage
    [meca_2k10.brd, meca_2k10.sch]
2010-03-20 Freshly generated BOM from eagle.
2010-03-20 meca 2k10 BOM
    [meca_2k10.bom.ods]
2010-03-22 quelques modifications du pcb et du projet
    [prop_MMX.PCBDOC, prop_MMX.PRJPCB]
2010-03-22 ajout des sources de la carte unioc
    [FPGA_UNIOC-NG.Sch, Micro_UNIOC-NG.Sch, UNIOC-NG.PCB, unioc-ng_v1_1.PrjPCB]
2010-03-26 few modifications for industrial fabrication
    [R2D2_emission.brd, UNIOC-NG.PCB, prop_2009.PcbLib, prop_MMX.PCBDOC, prop_MMX_bom.ods]
2010-04-04 ajout des références manquantes pour la carte propulsion
    [prop_MMX.PCBDOC, prop_MMX.PRJPCB, prop_MMX_bom.ods]
2010-04-04 ajout des références manquantes dans la nomenclature
    [meca_2k10.bom.ods, meca_2k10.brd, meca_2k10.sch]
2010-04-05 carte ground detector routée dans du 20*30mm !
    [ground_detector.brd, ground_detector.sch]
2010-04-05 ground detector : modification des trous de fixation
    [ground_detector.brd, ground_detector.sch]
2010-04-08 fiew modifications : top layer, add comments
    [prop_MMX.PCBDOC, prop_MMX.PRJPCB]
2010-04-08 decrease board dimensions to panelize
    [alim_2009.brd, alim_2009.sch]
2010-04-08 decrease dimensions to panelize
    [ground_detector.brd]
2010-04-08 add comments on top layer
    [Micro_UNIOC-NG.Sch, UNIOC-NG.PCB, unioc-ng_v1_1.PrjPCB]
2010-04-08 clearance modified
    [meca_2k10.brd, meca_2k10.sch]
2010-04-10 Mauvais endianness sur l'int32_t des encoders, on souffle la (seule) bougie du bug qui fete ses 1 ans :)
2010-04-10 MAJ code de calibration scilab des ADNS6010, compatible avec le code de calibration auto
2010-04-15 Major I2C rewrite: - error checks (master), improved I2C states (slave); - modified recv()/send() prototypes; - "ready / not ready" stuff is not used anymore. Further changes will be made to handle a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
    [i2c_robotter_config.h]
2010-04-15 Master: reversed order of data/n args in i2cm_recv()/i2cm_send(). Slave: use two buffers (receive/send)), added data size control, removed states (not needed anymore).
    [i2c_robotter_config.h]
2010-04-15 Reflected I2C protocol changes and new orders.
2010-04-16 New option: 'switch_way_eol'. Don't ignore 'echo' option in hexa mode.
2010-04-20 ROID checking feature, see 'check_roid' option. 'clear' command (clear device infos and last programmed data). 'infos' command: display some infos on program size/changes 'infos' command does not use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
2010-05-01 i2c functions updated
2010-05-01 Update last_hex on check success. This allows to set last_hex to the current HEX file on startup by adding the 'check' command to a sourced file.
2010-05-02 a lot of stuff, unioc, meca and uarts
2010-05-04 UNIOC-NG project w/ IRQ_fpga for FPGA reset
    [atmega_nodir_wb8_wrapper.vhd]
2010-05-04 Fixed and completed I2C orders and associated actuators methods. Some AX12 tweakings.
2010-05-04 Fixed parsing of returned boolean values. Minor improvments Added meca board orders.
    [orders.lua]
2010-05-04 Added checks for chosen track/channel. By default, use an available channel for the chosen track.
2010-05-05 Quartus warning, not top level 'Z' wire : can't be good.
2010-05-09 fpga frequency :50 MHz reset pin set as input
2010-05-09 new position management technics (motor encoders, 2 sensors, etc), various modifications on unioc_asserv, new methods for calibration
2010-05-09 Switch stdin back to normal termio mode before programming in terminal mode. This will allow to send an ^C keyboard interrupt. Catch keyboard interrupts in several (potentially) blocking methods, thu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
2010-05-10 First commit of a sensor identification script. This script, witch aim to compute the matrix used for positionning system, take the file named './mesures.csv' and generate a C like structure on the s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
    [mesures.csv]
2010-05-10 Now, the 'use_mesure.py' calibration script compute 4 matrix : 1) use 3 sensor 2) use the sensor 1 and 2 3) use the sensor 1 and 3 4) use the sensor 2 and 3
2010-05-10 robot measures
    [coupejm2.csv]
2010-05-19 Fixes (and improvements) for devices with less than 64k of Flash memory.
2010-05-20 first draft of new adns6010 board
    [adns600_board_2k11.sch]
2010-05-20 new revision of unioc V1.2: added pulldown resistor on n_CE, corrected some footprints (increase drill hole)
    [FPGA_UNIOC-NG.Sch, Micro_UNIOC-NG.Sch, UNIOC-NG.PCB, unioc-ng_v1_1.PrjPCB]
2010-05-20 added pullup resisotr to 5V on AX12 com
    [meca_2k10.bom.ods, meca_2k10.brd, meca_2k10.sch]
2010-05-23 Improved make scripts for easier custom configuration support. The whole configuration is now defined in a make script.
    Added configuration options to produce smaller binary files.
    It is now possible to compile a minimalistic bootloader smaller than 512 words
    (1024 bytes), which can be used on small devices (e.g. atmega88).
    (Not tested yet.)
    The 'p' command (program page) may not provide CRC check. Client will silently
    ignore given CRC to match (if any).
2010-05-24 Fixed minor issues related to when sending/expecting NACK. Cosmetic changes and cleaning (removed useless code).
    [i2c_robotter_config.h]
2010-05-27 New configuration value: BOOT_CODE to execute random code before booting the application. Allow communication using I2C (not only UART), still WIP. Some optimizations, move all code in the .c.
2010-06-04 first draft of adns600_board_2k11 board, add robotter_fuses library with farnell references
    [adns600_board_2k11.brd, adns600_board_2k11.sch]
2010-06-05 quelques modifications de routage
    [adns600_board_2k11.brd, adns600_board_2k11.sch]
2010-06-05 - I2C-programming: Working but still a bit flaky, not supported by blosh yet. - Extend "supported commands" to "supported features". - Check BOOTLOADER_ADDR to prevent use of values expressed in word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
2010-07-14 add the adns9500 board and sch. ready for review
    [adns_9500_board.brd, adns_9500_board.sch]
2010-07-15 board has been resized to 49*53mm. board is ready for review
    [adns_9500_board.brd, adns_9500_board.sch]
2010-07-18 text en vector sur la carte adns9500. modification de la carte alim pour n'utiliser que des composants CMS (carte moins sensible aux vibrations et hauteur passe de 30mm à 15mm environ...)
    [adns_9500_board.brd, alim_2009.brd, alim_2009.sch]
2010-10-23 modification de l'architecture du repertoire fpga
2010-10-24 adns9500 code updated, problem detected with VHDL
    [main.c]
2010-10-28 added cosmetic modifications on board ands9500_v1
    [adns_9500_board.brd, adns_9500_board.sch]
2010-10-28 adns9500 board V2 : rerouted to fit under the engine bloc, now dimensions are 45*39mm
    [adns_9500_board.brd]
2010-10-29 some helpfull text added
    [adns_9500_board.brd]
2010-10-29 Reverted roblos_config.mk changes of r498. roblos_config.mk is a sample script with "appropriated" default values and should not be modified.
2010-11-01 New bootloader protocol.
    The main change is the use of a binary protocol, faster than the previous ASCII
    protocol.
    The I2C part has not been tested yet. Other features are planned and will be
    added later.
    The handling of several "contexts" has been partially added to blosh; it will be used to address several devices (using I2C) from a single blosh instance. Not tested. (This was implemented a long time ago and planned for the previous bootloader, but never committed.)
    Only minor interface changes for blosh/robloc users:
    - features don't include supported commands anymore, they are now stored in a
    distinct value;
    - blosh option 'prog_check' (and associated robloc flag) has been removed: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
2010-11-03 Windows support for robloc and (partial) for blosh. Here are the main points: - use pySerial's Serial instead of BasicSerial; - refactoring of print instructions; - color support requires pyreadline 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
    Support is planned to be improved.
    Some typo or dummy errors may have slip in changes, tests/checks needed. ;)
2010-11-06 Refactored terminal_mode() for a cleaner "plumbing stuff". (Not tested yet.) Fixes to printing changes made in r523. Minor fixes (which may be backported to bootloader-ascii).
2010-11-11 ppp WIP, first draft for master I2C, tests scheduled
2010-11-12 Terminal mode now works on Windows. However feed/filter does not work yet.
2010-11-14 Major refactoring of terminal mode main loop. Proper Windows support for stdin and serial connection. Feed/filter still not supported (yet).
2010-11-15 Filter/feed support on Windows.
2010-11-16 remove some silkscreen from pads
    [adns_9500_board.brd, adns_9500_board.sch]
2010-11-17 filter/feed fixes
2010-11-18 add some via to indicate lens location
    [adns_9500_board.brd, adns_9500_board.sch]
2010-11-25 Changed commands I2C master commands: no more sessions, simply use two methods (recv/send). Successfully tested. Next step: wrap to transparently send command to an slave's bootloader.
2010-11-26 Significant space (not speed) optimizations (~15%), mainly achieved by replacing macros with functions (I2C routines), refactoring recv/send methods and using a static buffer containing the whole res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
    Further optimizations are still possible but usually require "ugly" code (bad
    casts, workarounds to gcc's bad optimization choices, ...).
    Also some cosmetic changes and minor fixes.
2010-11-26 Fixed roblocop.S for devices with pagesize != 256.
2010-11-26 First version of I2C client wrapper in robloc. Working proof of concept when slowing down the UART writes from robloc: the bootloader does not bufferize UART input which is a big issue for I2C comman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
2010-11-27 Fixes and attempts to fix I2C issues.
2010-12-27 I2C generation tested OK, UART messages TBD
2010-12-29 I2C msgs gen OK, UART msgs + viewer WIP
2011-01-04 add adns_wrapper_9500 board, lite edition
    [R3D2_main.brd, R3D2_main_bom.ods, adns_9500_wrapper.brd, adns_9500_wrapper.sch, alim_2009.brd, alim_2009_bom.ods]
2011-02-10 add pwm for prop_mmx board
2011-02-19 Removed unneeded volatile qualifier: the interruption handler does not modify the send buffer (it does modify i2cs_send_size though). Moreover, this commit fixes a warning in stratcomm.
2011-02-20 Renamed I2CS_SEND_NONE_BYTE to I2C_SEND_NONE_BYTE and now define it for both master and slave. Backward compatibility is ensured (I2CS_SEND_NONE_BYTE is used if I2C_SEND_NONE_BYTE is not defined).
2011-02-21 First step of commands/telemetries unification, mostly in namings for now (use 'message' instead of 'command'). Make a clear distinction of I2C-related functions in namings. Additionally, some fixes.
2011-02-21 matrix multipliers moved to posman/position manager; encoder wb if removed, encoders now return speed
2011-02-22 changed my mind, synchro signal is much better for encoder_inc calculus
2011-02-25 Merged generated code to only a a single .c/.h couple. Intermediate commit.
2011-02-26 Add ppp config file. Finalized and fixed generation of messages depending on the device ROID and capabilities.
2011-02-26 Replaced stratcomm stuff by ppp.
    [main.c]
2011-02-26 Fixed type issue with uart_recv*() returned value.
    [main.c]
2011-02-27 Woops, uart numbers start at 0.
2011-02-27 Use blocking UART send operations: a custom buffer above uart module buffer only make things more complicated, no advantage. The UART TX FIFO has to be properly sized.
2011-03-02 suppression case numéro d'équipe
2011-03-06 Modifications apportées suite au mail de la coupe.
2011-04-05 Fix UART compilation issue with atmega88.
    Discussion and patch found here:
    http://www.mail-archive.com/avr-list@droids-corp.org/msg00485.html
2011-04-06 PPP frame handling (packing, unpacking).
2011-04-06 Improvements and fixes made to the AVR generated code. Messages and telemetries tested and functionnal with UART and I2C.
2011-04-06 Check message IDs. Start message IDs at 1 (0 is now unused/reserved, just in case).
2011-04-12 No need to enable interrupts.
2011-04-12 Explicitely disable watchdog. Required for some devices after a watchdog reset.
2011-04-14 PWM/VHDL: top added, does not compile, TBD
2011-04-17 New I2C module with multi-master support: i2cx.
2011-04-17 PPP version with undirected messages. Messages are now shared between devices and set directly on the Robot. Use the new i2cx module instead of i2cm/i2cs. Replaced packing/unpacking by simple cast to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
2011-04-19 synthetisable top, add enable on pwm watchdog
2011-04-28 meca_2k10 project updated, some values + calibration script added
2011-04-29 Factorized UART definitions which depend on UART number.
2011-04-30 First version of RobOtter UART module.
2011-04-30 Add new RobOtter UART module to 'make menuconfig'.
2011-05-07 add color sensor : not routed yet
    [color_sensor.brd, color_sensor.sch, ground_detector_BOM.ods]
2011-05-07 matchuart: use Rob'Otter UART module.
2011-05-07 UART: compatibility with some devices (e.g. atmetgax8).
2011-05-08 change connector to match 12 ways and prop connector
    [color_sensor.brd, color_sensor.sch]
2011-05-14 updated color_sensor
    [color_sensor.sch]
2011-05-15 add ground detector module (tested)
2011-05-15 calibration script + kalman filtering
2011-05-16 ground_detector.c not in Makefile; some typos / useless code out
2011-05-16 meca_2k10: ground_detectors properly integrated
2011-05-19 new stuff in kalman filtering
2011-05-22 add color sensor module, synthesis ok, simulation ok
2011-05-22 add color sensor on top
2011-05-22 Updated feed() method to process raw and frame data in order. Added a on_rawdata() on this purpose.
2011-05-22 PPP: use Rob'Otter UART module.
2011-05-26 PPP: methods to append devices/messages to a robot A robot does not have to be fully defined at instantiation. Constructor now takes a list of "things to add" as parameter.
2011-05-29 Reverted volatile removal which ARE needed, except for i2cs_send_buf. This reverts commits 3980c852d24af6551cf558a2eb25711a2148aa70 and dfb3284acafbfd0b83b85eeb00fa1b7653e3742d.
2011-05-29 PPP: define ROIDs for known devices and first actual orders
2011-05-29 PPP: defined and use message subclasses
    These classes does not provide any feature (for now at least). They are
    intended to attach a semantic to messages, making it clearer what a
    message is intended for.
2011-05-30 PPP: fix bouncing of broadcasted message when compiled without UART
2011-05-30 PPP: improved routing
    New definitions for special ROIDs and macros for UART/device ROIDs conversions.
    Support broadcast to all UART interfaces.
    Note: PPP_UART_ROID meaning has changed.
2011-05-30 PPP: introduced internal commands
    Internal PPP commands use the mid 0.
    - UART_DISCOVER is intended to be used by PCs connected to devices
    through UART, to retrieve their ROID
    - SUBSCRIBE set a "default" destination for messages such as events, it
    is used through the ROID_SUBCRIBER ROID value
2011-05-30 PPP: shell based on IPython to communicate through UART using PPP
2011-05-30 PPP: fixed UART broadcasting
2011-05-31 uart: atmega16 compatibility
2011-05-31 R3D2: use RobOtter's UART module
2011-05-31 MECA: arm release function added
2011-05-31 ASSERV: Carrot reset added to position set
    [main.c]
2011-05-31 MECA: leds mgmt added, NOUART mode added
2011-06-01 PPP: 'start' event to be sent when a device is up and running
2011-06-01 PPP: added 'arm' field to scanner_* messages
2011-06-01 uart: fixed atmega16 compatibility
2011-06-02 PPP: random waiting delay for I2C retry
2011-06-02 MECA/ASSERV: I2C frequency changed
2011-06-18 STRAT: arm overtorque handling
2011-06-18 STRAT: fixed tirette init
2011-06-18 STRAT: more glue
2011-06-18 STRAT: tirette read fixed
2011-06-18 STRAT: angle fixes, some glue
    [main.c]
2011-06-18 STRAT: tries to enable timer
2011-06-18 STRAT: faster I2C bus
2011-06-18 STRAT: call ppp_update() while waiting for arm release
2011-06-18 STRAT: more offset fixed, really lower an arm sooner
2011-06-18 STRAT: fixed asserv stop
    [main.c]
2011-09-01 some few changes on color sensor
2011-09-01 some few changes on meca board sch
    [meca_2k10.sch]
2011-09-02 Add Hreidmarr board
    [Hreidmar.brd, Hreidmar.sch]
2012-03-02 i2c: typo in comments
2012-04-14 calibration du robot, c'est beaucoup mieux, mais il faut encore regarder ça de près
2012-04-28 bootloader: remove I2C features, always assume UART
2012-04-29 UNIOC_ASSERV: IMU support added, not used w/ cs
2012-05-05 ppp: remove I2C handling and I2C-related code
    UART will be used for communication by all boards.
    I2C is not needed anymore for PPP.
2012-05-05 ppp: remove some routing handling
    Without I2C, routing is not needed anymore.
    All boards will communicate directly with a central "capable" host.
2012-05-05 ppp: add "transaction ID" field, to link request and responses
    This field is added to all frames and sent before the message ID.
2012-05-08 update Hreidmarr : board sent to manufacturer, eagle lib used for coke and super unioc
    [Hreidmar.brd, Hreidmar.sch]
2012-05-14 uart: add "wait" parameter to uart_disable_tx()
2012-05-14 uart: fix "integer overflow" warning in baudrate configuration
2012-05-14 ppp: do not call uart_init() in ppp_init()
2012-05-14 ppp: ensure compatibility with Aversive UART module
2012-05-14 prop: PPP update, use RobOtter UART module
2012-05-14 prop: board is now silent, ready for ppp.
2012-05-14 prop: merge UART_UI_ENABLED and NO_UART settings
2012-05-14 prop: don't update PPP in UART UI mode (would eat UART input)
2012-05-14 uart: fix disable TX (not working though), and compile error
2012-05-14 r3d2: update PPP config, disable I2C
2012-05-14 r3d2: avoid use of advance printf (save space)
2012-05-14 r3d2: backport from the old ages (eurobot 2011), not calibrated
2012-05-15 meca: update config, use RobOtter UART
2012-05-15 meca: remove/updated deprecated stuff from 2011
    Remove code for scanners and ground detectors.
    Update arm handling.
2012-05-15 meca: rewrite arm handling
    Use a generic approach for possible angles.
    Store angle values and IDs in an array of structures.
    Some renaming.
2012-05-15 meca: add setting to disable UART UI
2012-05-15 meca: don't update PPP in UART UI mode, send PPP start
2012-05-15 meca: add brush handling (not complete yet)
    The CPU usage computation has been removed.
    Timer3 is now used for the brush.
2012-05-15 meca: cosmetic UART UI changes
2012-05-15 meca: reenable Aversive UART module
2012-05-15 meca: set calibrated values for arm positions
2012-05-16 unioc_asserv: Unwanted NOTICE from imu rx removed
2012-05-16 r3d2: fix coef for PPP messages
    [main.c]
2012-05-16 r3d2: fix filter coefficients for detection distance
2012-05-16 ppp: Orders are now Commands, to have a hack
    Receiving a ACK even for orders is important to avoid flooding atmega's
    UARTs.
2012-05-17 meca: arm speed parameter added to PPP messages
2012-05-17 meca : arm 'DROP' position lowered
2012-05-18 prop: fix set steering/cruise speed PPP messages
2012-12-02 Wireshark dissector for Perlimpin
2013-01-22 Advice added in file header about wireshark lua activation.
2013-04-06 add R3D2_v2 board, atmega 16 becomes Atxmega128A1
    [R3D2_v2.brd, R3D2_v2.sch]
2013-04-06 add Super unioc v1
    [SuperUnioc_v1.brd, SuperUnioc_v1.sch]
2013-04-06 add meca 2k13 v1 board
    [meca_2013.2.brd, meca_2013.2.sch]
2013-04-06 add coke v1 board
    [coke.brd, coke.sch]
2013-04-06 add motor control board for principal robot
    [motor_ctrl_pw_v1.brd, motor_ctrl_pw_v1.sch]
2013-04-06 add motor control board for holonomic pmi robot
    [motor_ctrl_pw_v2.brd, motor_ctrl_pw_v2.sch]
2013-04-13 ppp: running perlimpinpin.io now starts a simple PPP hub
    "python -mperlimpinpin.io ADDR SOURCE" starts a PPP "client" hub which
    will print received frames.
    With -i, an interactive IPython shell is started.
    Frames can be sent using the 'hub' variable. Some payload names are preimported.
    For instance, to broadcast a system ping:
    hub.send(Frame(hub.address, 0xFF, PayloadSystemPing(1, 42)))
2013-04-27 ppp: fix disconnection detection
    Disconnection may lead to an infinite loop, a EPOLLIN being triggered
    indefinitely for the disconnected client.
    Also allow to call stop() from the polling thread.
2013-05-01 ppp: don't return from Hub.start() until the thread is up and running
2013-05-05 ppp: don't abort Hub on Frame formatting error
2013-05-06 ppp: don't always use a thread to process I/O
    Hub.start() does not start a thread anymore.
    Hub.run_one() process a batch of I/O events and Hub.run() run
    indefinitely. Hub.run() can be run as a thread target to behave as
    before.
    These changes will allow a better event-driven model and implementation
    of time-based events, especially to handle message timeouts.
2013-05-07 ppp: fix case when several frames are received in one read() and fix c91c8f1
2013-05-07 ppp: add a flag to enable/disable frame printing in HubClient
2013-05-19 Hardware:add power board that drive arm cc motors
    [Carte_moteur.brd, Carte_moteur.sch]
2013-05-19 hardware : add pmi board v1
    [pmi_2k13.pcb, pmi_2k13_avoidance_sensor_interface.sch, pmi_2k13_color_sensors.sch, pmi_2k13_communication.sch, pmi_2k13_glasses_detection.sch, pmi_2k13_global_connector.sch, pmi_2k13_ground_encoder.sch, pmi_2k13_microcontroler.sch]
2013-05-19 hardware: add pmi extension board v1
    [pmi_extension_2k13.brd, pmi_extension_2k13.sch]
2013-05-19 hardware: remove old boards not used in robots
    [FPGA_UNIOC-NG.Sch, Micro_UNIOC-NG.Sch, R2D2_emission.brd, R2D2_emission.sch, R2D2_emission_nomenclature.ods, R3D2_main.brd, R3D2_main.sch, R3D2_main_bom.ods]
2013-05-19 hardware: R3D2: rename R3D2_V2 in R3D2
    [R3D2.brd, R3D2.sch]
2013-05-25 hardware: SAB'Otter : add board block diagram
2013-09-29 add sabotter board \n add micro mat'n lok connector horizontal 2*2v
    [sabotter.brd, sabotter.sch]
2013-10-03 add audio amplifier
    [sabotter.brd, sabotter.sch]
2013-10-13 board ready for eirbot assembly
    [sabotter.brd, sabotter.sch]
2013-10-13 board ready for eirbot assembly, sabotter V1
    [sabotter.brd, sabotter.sch]
2013-10-16 leds connected to µC, board ready for industrial assembly, sabotter V2
    [sabotter.brd, sabotter.sch]
2013-10-20 SuperUnioc v2 : add gyroscope ADXRS453 to board, removed FPGA
    [SuperUnioc_v1.brd, SuperUnioc_v1.sch]
2013-10-23 led inverted, now in ascending order
    [sabotter.brd, sabotter.sch]
2013-11-13 super unioc: add GP2 connector
    [SuperUnioc_v1.brd, SuperUnioc_v1.sch]
2013-11-13 sabotter: uart modified after Jdam peer review
    [sabotter.brd, sabotter.sch]
2013-11-13 add some resistor
2013-12-02 add beacon board
    [consommation.ods, prism.brd, prism.sch]
2013-12-09 radiospares part number added
    [SuperUnioc_v1.brd, SuperUnioc_v1.sch]
2013-12-10 add 3,3v and 5v regulator
    [prism.sch]
2013-12-10 few changes
    [prism.sch]
2013-12-12 photointerrupter added to board, interfaces added, regulator added
    [prism.brd, prism.sch]
2013-12-12 add color_proximity_sensor board
    [color_proximity_sensor.sch]
2013-12-27 ferrit bead on avcc added
    [SuperUnioc_v1.brd, SuperUnioc_v1.sch]
2013-12-27 microcontroler added
    [color_proximity_sensor.sch]
2013-12-27 prism/prism.brd
    correction after Damien review
    [prism.sch]
2013-12-27 sabotter/sabotter.sch
    footprint correction
    [sabotter.brd]
2013-12-27 correction after Damien review
    [prism.brd]
2013-12-27 added super unioc extension for analog servo
    [SUperUnioc_analog_ServosExtension.brd, SUperUnioc_analog_ServosExtension.sch]
2013-12-27 removed dimension rectangle
    [SUperUnioc_analog_ServosExtension.brd]
2013-12-27 milling deleted on some connectors
    [sabotter.brd, sabotter.sch]
2013-12-27 silkscreen modification
    [SuperUnioc_v1.brd]
2013-12-27 milling deleted on usb and audio connector
2014-01-03 add board, routing in process
    [color_proximity_sensor.brd, color_proximity_sensor.sch]
2014-01-03 pdi connector added
2014-01-03 M2 hole added
2014-01-03 board routed
    [color_proximity_sensor.brd, color_proximity_sensor.sch]
2014-01-03 silkscreen done
    [color_proximity_sensor.brd, color_proximity_sensor.sch]
2014-01-03 traces modified
    [color_proximity_sensor.brd]
2014-02-02 rome: add callback for sent frames
    This will allows subclasses to log not only received frames but sent frames as
    well.
2014-02-02 rome: better logging for default client
    Log sent frames.
    Fix logging of received frames.
    Log frame time (HH:MM:SS.sss).
2014-02-08 prism schematic modified, frist routing test
    [prism.brd, prism.sch]
2014-02-08 add meca_2014 board
    [meca_2014.brd, meca_2014.sch]
2014-02-22 meca 2014 : routing done
    [meca_2014.brd, meca_2014.sch]
2014-02-26 MECA 2014 : fixes to brd
    [meca_2014.brd]
2014-02-27 added bluetooth board, begining of routing
    [prism.brd, prism.sch]
2014-03-04 bord routed, ready to review
    [prism.brd, prism.sch]
2014-03-04 modified switch dpdt
2014-03-05 add support board for second index of prism board
    [prism_idx_support.brd, prism_idx_support.sch]
2014-03-05 power supply rerouted, board ready to be sent to manufacturer
    [meca_2014.brd, meca_2014.sch]
2014-03-05 pressure sensor footprint pads enlarged
2014-03-08 add 100 ohms resistos
2014-03-08 resistor value modification after Damien review
    [prism_idx_support.brd, prism_idx_support.sch]
2014-03-08 ir index polarization resistor value changed after Damien review of prism_idx_suport board
    [prism.brd, prism.sch]
2014-03-08 update after IR index polarization change
    [consommation.ods]
2014-03-08 board update after Damien review
    [prism.brd, prism.sch]
2014-03-17 few changes on board
    [color_proximity_sensor.brd, color_proximity_sensor.sch]
2014-03-17 few changes before fabrication
    [meca_2014.brd, meca_2014.sch]
2014-03-17 add gerber pannel tools
    [meca2014__prismIdxSupport_pannel.cfg]
2014-03-17 add ftdi<->board uart adapter
    [uart_debug_master_2014.brd, uart_debug_master_2014.sch, uart_debug_slave_2014.brd, uart_debug_slave_2014.sch]
2014-03-17 add pannel script for color_proximity_sensor board
    [color_proximity_sensor_pannel.cfg]
2014-03-17 add eagle tool to add rules to board and generate gerbers
2014-03-29 mouser component ref added
    [SuperUnioc_v1.brd, SuperUnioc_v1.sch]
2014-04-08 add board that transceive RS422 to 5V signals
    [pmi_encoder_rs422_decoder.brd, pmi_encoder_rs422_decoder.sch]
2014-04-08 added SN75ALS193 and HEDL554x encoder connector
2014-04-19 add board to drive vaccum pump and solenoid valve
    [meca_2014_VaccumSystemExtension.brd, meca_2014_VaccumSystemExtension.sch]
2014-04-19 add adp3331 regulator
2014-04-24 added assembly variant to board
    [prism.brd, prism.sch]
2014-04-25 diameter of via increased
    [meca_2014_VaccumSystemExtension.brd]
2014-05-28 corrected diode B160 and TCS37725 pinout
2014-05-28 prism v2 : modifications after beacon integration : mirror motor supplied by vbat or +15V, diode B160 pinout corrected
    [prism.brd, prism.sch]
2014-05-28 some text added, silkscreen placed
    [pmi_encoder_rs422_decoder.brd, pmi_encoder_rs422_decoder.sch]
2014-05-28 text added
    [prism_idx_support.sch]
2014-05-28 corrected tcs37725 and b160, need rerouting tcs37725
    [color_proximity_sensor.brd, color_proximity_sensor.sch]
2014-05-28 SuperUnioc/SuperUnioc_v1.brd
    mouser ref added
    [SuperUnioc_v1.sch]
2014-05-29 rome: add an option to client to filter printed messages
2014-06-11 corrected adxrs footprint
2014-06-11 corrected adxrs453 footrpint and gp2 connector footprint
    [SuperUnioc_v1.brd, SuperUnioc_v1.sch]
2014-10-06 rome: support order messages, with ack field
    Orders are defined as a Message subclass.
    On Frame, the ack field is separated from regular parameters and made
    accessible through the 'ack' attribute.
    Frame.set_ack_range() must be called to set the range of available ACK values
    before sending orders.
2014-10-27 rome: always use a timeout for the Serial
    This allows to make the connection non-blocking, and thus to use
    timeouts (with guili for instance).
    EOF is now only detected if the file object provides an eof() method.
    Otherwise, Frame.read() will block and never return None.
2014-12-19 rome: handle case of variable-length messages
2015-01-25 component refs updated
    [R3D2.brd, R3D2.sch]
2015-02-08 rome: add a way to send raw UART data using the client
2015-02-08 rome: rework how send() ACK and result is handled
    Keep 'cb_result' as it is but replace 'cb_ack' by a 'handler' parameter.
    See the new ClientResultHandler class.
    It allows to easily check and handle result in the usual case of a
    client started in background.
2015-08-02 v2 rerouted and ic5 (atxmega) value modified
    [color_proximity_sensor.brd, color_proximity_sensor.sch]
2015-08-02 R3D2_long_range added : sch finished, brd on work !
    [R3D2_long_range.brd, R3D2_long_range.sch]
2015-08-08 new components added, resistor 150k, +bat symbol and photosensor
2015-08-08 routing board and remarks taken into account in sch
    [R3D2_long_range.brd, R3D2_long_range.sch]
2015-08-08 board V1 routed
    [R3D2_long_range.brd, R3D2_long_range.sch]
2015-08-08 some via added to the ground plane
    [R3D2_long_range.brd]
2015-08-09 com led moved to be viewable with others debug leds
    [R3D2_long_range.brd, R3D2_long_range.sch]
2015-10-04 motor_ctrl_pw_v3 board added. board routed and ready for review
    [motor_ctrl_pw_v3.brd, motor_ctrl_pw_v3.sch]
2016-01-12 eaglelibs: robot wiring wip
2016-01-30 galiper wiring added, WIP
    [robot_wiring.sch]
2016-01-31 galiper wirring : some connectors added, WIP
    [robot_wiring.sch]
2016-01-31 galiper wirring : all connectors added to super unioc, sabotter and R3D2 boards, WIP for meca board
    [robot_wiring.sch]
2016-01-31 galiper wirring : meca board added, need to update board version and final meca wirring
    [robot_wiring.sch]
2016-02-01 hardware : add BOM of RS order, some libs need to be updated
    [RS_Dec2015.ods]
2016-02-06 robot schematic components updated
    [robot_wiring.sch]
2016-02-06 robotter BOM generation that integrates external parts in component list
2016-05-03 rome: add a FourCC type (for device IDs)
2016-05-03 rome: add 'device' parameter to bootloader order
2016-05-03 rome: change stuff for full-ROME bootloader
    - Add 'buffer' bootloader command
    - Remove 'device' in bootloader commands (not ready yet)
    - Add 'unexpected_cmd' reply status
2018-04-17 Migrate to Python3
    - Fix remaining Python3 incompatibilites (especially bytes/str issues)
    - Remove Python2 compatibility
    - Move client.main() call to __main__.py to fix double-import warning
    - Fix Frame.next_ack() (broken by Python3 compat commit)
2018-04-19 rome: add Frame.params_data()
2018-04-28 R3D2_long_range : some comments added
    [R3D2_long_range.brd, R3D2_long_range.sch]
2018-04-28 R3D2 : cosmetic changes
    [R3D2.sch]
2018-04-28 sabotter : cosmetic changes
    [sabotter.brd]
2018-04-28 color_proximity_sensor : VL53L0X sensor integrated
    [color_proximity_sensor.brd, color_proximity_sensor.sch]
2018-05-06 Boomotter added
    [BoomOtter.brd, BoomOtter.sch]
2018-05-13 rome: properly check message and parameter names
    - Prevent of names prefixed by '_'.
    - Avoid errors when instanciating frames with parameters named 'msg' or
    'self' (the first one was used for logs).
2019-01-26 meca 2018 project added
    [meca_2018.brd, meca_2018.sch]
2019-05-25 Fix Frame.extract()
