robotter/robotter/(notices)

Notices in the files:
avrs/modules/devices/hrobot_manager/hrobot_manager.c:
the Free Software Foundation; either version 2 of the License, or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
parts and their libraries:
wurth_electronics_midcom_inc_v1-0: Copyright: Wurth Electronics Midcom, Inc.
